wumu-dot/SoundDog/docs/hardware/RS485-回环接线图.jpg

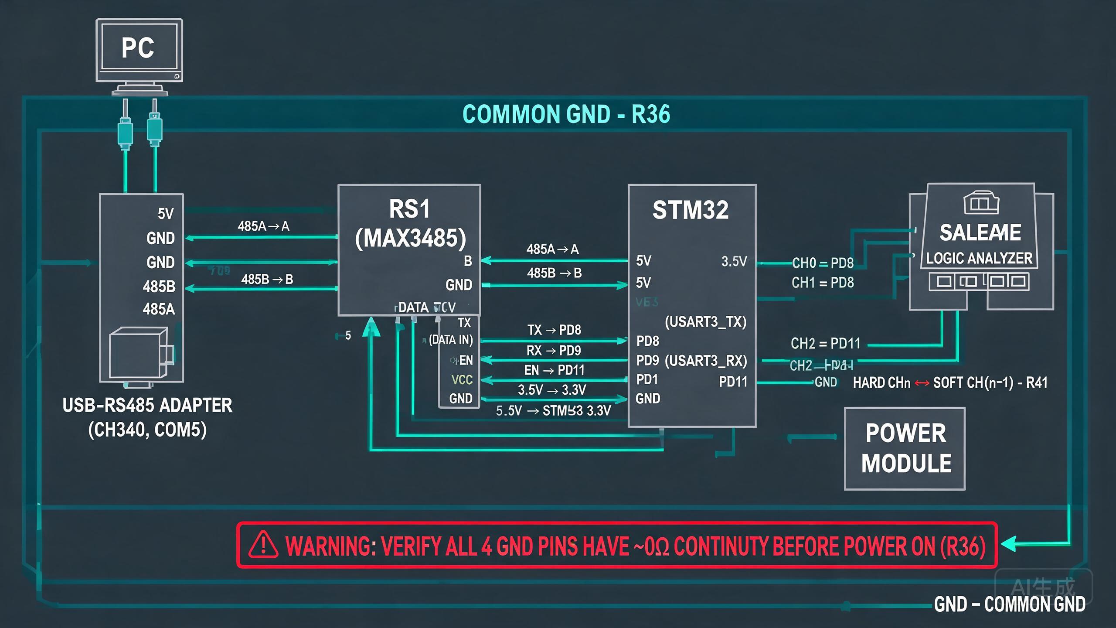
docs/hardware/RS485-回环接线图.jpg
