wumu-dot/SoundDog/SoundDog-RS485链路排查测试-2026-09-17.md

# SoundDog RS485 链路排查测试报告（2026-09-17）

> 主线任务：A5 RS485 物理链路排查（PC↔STM32 回环，Modbus RTU）
> 前置：批次1固件修复完成（R39），ESP32 主站损坏待更换，本次以 PC+USB转RS485 适配器作为主站

---

## 1. 测试目标

验证 PC（USB转RS485 适配器）→ RS1(MAX3485) → STM32(USART3/PD9) 收方向链路是否打通，定位"STM32 收不到字节"的物理断点。

## 2. 硬件接线基准（R40）

| 连接 | 说明 |
|---|---|
| 适配器 485A → RS1.A | 差分 A |
| 适配器 485B → RS1.B | 差分 B |
| 适配器 GND → RS1.GND → STM32.GND → 电源模块GND | 共地链（R36 通断验证） |
| RS1 VCC | 3.3V（STM32 板载，非5V） |
| RS1.TX → STM32 PD8(USART3_TX) | 数据入 |
| RS1.RX → STM32 PD9(USART3_RX) | 数据出（RO） |
| RS1.EN → STM32 PD11 | 高发低收 |

## 3. 测试过程与实测证据

### 3.1 软件回环测试（适配器发 0x55，STM32 应 echo 回）
- 115200 下多次发包（3/30/40/50/60 个 0x55），**适配器读回始终为空**。
- COM4(USART1 调试口) 抓取 1792 字节，**无任何 `RX[x]: 55` 探针输出**。
- 结论：**PD9 被 RO 拉死恒低，USART3 无空闲边界（IDLE 永不成立），RX 探针线程从未被唤醒**（复核更正①，2026-09-17：探针无输出与 RO 恒低是同一因果链，非"硬件层未收到字节"两层独立推断）。

### 3.2 逻辑分析仪抓取
| 抓取点 | 结果 | 判读 |
|---|---|---|
| 适配器 485A | **有波形** | 适配器在发射 ✅ |
| STM32 PD9(USART3_RX) | 无波形（触发等待、采样率降2MS/s后仍无） | 收方向断 ❌ |
| RS1.B | 仅毛刺/静态 | 可疑 ⚠️ |
| RS1.RO | 无波形 | 无输出 ❌ |

### 3.3 万用表静态/动态测量
| 测量项 | 结果 | 判读 |
|---|---|---|
| RS1 VCC | 3.3V | 供电正常 ✅ |
| 适配器裸端 A−B（110波特率，说明书方法） | **1.8~2.3V** | 适配器 TX 差分正常 ✅ |
| RS1.A−B（110波特率发包） | **0 → −6.35V → 0 大幅摆动** | 差分信号强达 RS1 ✅ |
| RS1.丝印TX（接PD8）对地 | 3.23V | STM32 PD8 空闲高，正常 ✅ |
| RS1.丝印RX（RO）对地 | **0.15V（恒低）** | RO 未输出有效高 ❌ |
| EN 端子对地 | 低 | 接收态正常 ✅ |
| PD11 对地 | 低 | STM32 方向控制正常 ✅ |
| RO↔PD9 通断 | 响（<2Ω） | 线通 ✅ |
| 芯片1脚(RO)对地 | **恒 0.15V（发包时也不动）** | 芯片 RO 输出级异常 ❌ |

## 4. 结论（基于 R25 验证条件）

**断点已收窄到 RS1 模块内部（端子→芯片→RO），尚未在 RO 输出级与模块走线之间二选一**（复核更正②，2026-09-17，R25：不得越级到"RO 输出侧"）。
- 差分测量：**−6.35V 更像未端接线路振铃/共模问题，不能作为差分健康证据**（复核更正③）；须同一参考地量 A对地/B对地/A−B 复测

**待确认的最后分叉**：芯片 6/7 脚(A/B) 差分是否到达芯片本体（未测完）：
- 若 6/7 脚有差分 → 芯片 RO 输出级坏（换芯片/查焊盘）
- 若 6/7 脚无差分 → 模块 A/B 走线断（端子有波但芯片收不到）

> ⚠️ 注意：换过一块 MAX3485 芯片仍复现，RO 输出级损坏或模块走线断的概率高；
> 也可能是新换芯片虚焊。建议整块更换 RS1 模块复测。

## 5. 已排除项清单

| 项 | 排除依据 |
|---|---|
| 适配器坏 | 裸端差分 1.8~2.3V 正常 |
| A/B 极性反 | 对调过仍无收 |
| A/B 线断 | 通断挡响（<2Ω） |
| EN/PD11 卡发送态 | EN 恒低=接收态 |
| RS1 供电 | 3.3V 正常 |
| RO→PD9 线断 | 通断挡响 |
| STM32 固件/探针层 | COM4 后台日志正常刷 BANDS/SPEC，探针在但无 RX 输入 |

## 6. 经验教训（新增）

- **万用表量差分必须用 110 波特率**（说明书方法）：115200 下位宽仅 ~8.7µs，万用表跟不上，读数恒 ≈0，会造成"适配器不发射"的误判。
- **"下降沿/上升沿无触发" ≠ "电平为低/高"**：触发等待只能证明"无跳变"，不能证明电平状态；必须用万用表量静态电压确认。
- **逻辑分析仪采样率过高会溢出**（设备跟不上），115200 抓取应设 2MS/s 并降采样率。
- **适配器 USB 会掉线/重枚举**：测试中途 COM 口会变或消失，发包前需先 `list_ports` 确认。

## 7. 下一步建议

1. **量芯片 6/7 脚(A/B) 差分**（110波特率发包）：区分"芯片没收到差分" vs "芯片RO坏"。
2. **整块更换 RS1(MAX3485) 模块**复测回环（最省事，排除模块走线/虚焊）。
3. 链路打通后：拆探针（`-DMB_PROBE_ENABLE=0`，R38）、换 ESP32 主站、A/B 全链路 Modbus 联调。

---
*测试人员：用户 + TRAE 协助 ｜ 日期：2026-09-17*
