wumu-dot/SoundDog/外部资源索引.md

# SoundDog 外部资源索引

> 外部依赖目录：`C:\Users\wumu2\OneDrive\桌面\stm32F407ZGT6\`
> 
> 本文件维护外部资料到 SoundDog 开发阶段的映射。当你需要查数据手册、参考例程、工具软件时，从这里定位。

---

## 资源全貌

```
桌面\stm32F407ZGT6\
├── INMP441全向麦克风资料\           ← 音频采集核心
├── ST7789_ref\                      ← LCD/OLED 显示参考（额外）
└── 芯片stm32F407\                    ← 主开发套件
    ├── 【1】参考例程\                ← 最重要！外设驱动参考
    │   ├── HAL库\  (10个项目)
    │   └── 标准库\ (12个项目)
    ├── 【2】工具软件\                ← 调试/辅助工具
    ├── 【3】STM32相关手册\           ← 芯片规格/参考
    ├── 【5】下载器驱动\              ← 烧录/调试驱动
    ├── 【6】烧录程序教程\            ← 烧录操作指南
    └── 1778826025286617\            ← 核心板资料（原理图+封装）
```

---

## 〇、硬件配置台账 + RS485 链路外部资源（2026-09-16）

> **[硬件配置台账（单一权威，改接线先看它）](docs/hardware/硬件配置-2026-09-16.md)** → `docs/hardware/硬件配置-2026-09-16.md`
> 含：供电共地(R40)、USART3↔RS1 接法、**MAX3485 丝印**、USB 转 RS485 适配器端子、逻辑分析仪通道映射(R41)。
>
> 🔴 **丝印语义权威已上收（2026-09-28）**：见外部依赖 `MAX3485-RS485模块资料/README.md`（厂商资料）。
> 　**结论：模块 `TXD`(=`RO`) → 主控 `UART_RX`；模块 `RXD`(=`DI`) → 主控 `UART_TX`（必须交叉）。**
> 　⚠️ 本台账 §3 原写的「`TX`=数据输入(≈DI) / `RX`=接收输出(≈RO)」是**旧拼写（无 D 后缀）+ 按主控视角命名**，**与厂商资料相反、已判错**（详见该 README §四，含 09-21 实测打假）。

| 资源 | 外部依赖地址（实测确认） | 用途 |
|---|---|---|
| **USB 转 RS485 适配器手册** ⭐ | `usb转rs485/LES26-USB-RS485-RS232-RS422-TLL V1.03.pdf` | 适配器端子/指示灯/自检（⚠️ 自检法禁用见 R36/R37） |
| CH341 驱动 | `usb转rs485/USB转换模块驱动-Window/CH341SER_Window/` | USB 转 RS485 设备驱动 |
| **逻辑分析仪软件（Saleae）** ⭐ | `逻辑分析仪/saleae逻辑分析仪软件客户资料20190718/Logic Setup 1.2.17.exe`（或 1.1.16） | 抓 RS485 TTL 侧波形（Software 版） |
| 逻辑分析仪使用说明 | `逻辑分析仪/…/usb Saleae 8逻辑分析仪使用说明书.pdf` | 通道映射即位，配合台账 §5 |
| 逻辑分析仪应用手册 | `逻辑分析仪/…/Saleae逻辑分析仪应用手册--着迷.pdf` | 高级抓取/解码参考 |
| **MAX3485 模块资料** ⭐ | `MAX3485-RS485模块资料/README.md`（原图 `商品详情页-2026-09-28.jpg`） | **丝印/接线语义的单一权威源**（`TXD`←UART_TX、`RXD`→UART_RX、`EN`=方向、板载 120 Ω、无偏置）。2026-09-28 补录 |

> 逻辑分析仪通道映射（R41）：硬CH1~CH8 + CLK + GND ↔ 软化 CH0~CH7，**硬CHn↔软CH(n-1)**，详见台账 §5。

---

## 一、STM32F407 芯片手册

| 文件 | 路径 | SoundDog 用途 |
|---|---|---|
| **参考手册-中文版** ⭐ | `【3】/stm32f407参考手册-中文版.pdf` | 所有外设寄存器/功能说明，最常用 |
| **参考手册-英文原版** | `【3】/stm32f407参考手册.pdf` | 与中文版对照，勘误排查时用 |
| **数据手册** | `【3】/stm32f407数据手册.pdf` | 电气特性、引脚定义、封装尺寸 |
| 勘误表 | `【3】/stm32f407勘误.pdf` | 芯片已知bug，遇到诡异问题再查 |
| IO复用说明 | `【3】/IO复用说明.jpg` | 引脚AF功能速查，一张图 |

### SoundDog 各章节查阅指引

| 开发阶段 | 参考手册重点章节 |
|---|---|
| I2S3 时钟配置 | §7 RCC — PLLI2S 寄存器 |
| I2S3 外设驱动 | §28 SPI/I2S — I2S 模式寄存器 |
| DMA 双缓冲 | §10 DMA — Stream 配置 |
| I2C1 (OLED+SHT30) | §27 I2C — 主机模式 |
| USART3 (RS485) | §30 USART — 异步收发 |
| TIM3 PWM (LED) | §14 TIM — OC 输出比较 |

---

## 二、HAL 库参考例程（最常用）

路径前缀：`芯片stm32F407/【1】参考例程/HAL库/`

| # | 项目 | 路径 | SoundDog 对应模块 |
|----|---|---|---|
| 0 | **CubeMX 配置参考** ⭐ | `0.CubeMX配置参考/` → `F407ZG.ioc` | 创建项目时可直接导入参考引脚/时钟 |
| 1 | LED闪烁 | `1.LED闪烁/` | A6: LED_ALARM + LED_STATUS |
| 2 | 按键测试 | `2.按键测试/` | GPIO 输入参考（如有按键需求） |
| 3 | **串口打印测试** ⭐ | `3.串口打印测试/` | USART1 调试串口 printf 重定向 |
| 4 | RTC读取时间 | `4.RTC-读取时间/` | 可选：时间戳打日志 |
| 5 | SDIO-SD卡基本读写 | `5.SDIO-SD卡基本数据读写/` | 可选：数据记录到SD卡 |
| 6 | SD卡移植FatFs | `6.SDIO-SD卡移植FatFs/` | 同上，文件系统版 |
| 7 | **USB虚拟串口** | `7.USB-虚拟串口/` | 可选：USB调试替代UART |
| 8 | LCD-0.96寸 | `彩色液晶屏驱动-基于0.96寸160x80分辨率/` | 显示参考（用ST7789驱动） |
| 9 | LCD-1.14寸 | `彩色液晶屏驱动-基于1.14寸240x135分辨率/` | 显示参考 |
| 10 | LCD-1.30寸 | `彩色液晶屏驱动-基于1.30寸240x240分辨率/` | 显示参考 |
| 11 | LCD-1.54寸 | `彩色液晶屏驱动-基于1.54寸240x240分辨率/` | 显示参考 |
| 12 | LCD-1.69寸 | `彩色液晶屏驱动-基于1.69寸240x280分辨率/` | 显示参考 |
| 13 | LCD-2.00寸 | `彩色液晶屏驱动-基于2.00寸240x320分辨率/` | 显示参考 |

> ⭐ = SoundDog 开发中直接参考

### 关于 OLED (SSD1306) 的说明

官方 HAL 例程中 **没有 SSD1306 I2C OLED 的例程**，只有 ST7789/ST7735 SPI LCD 的例程。但可以参考：
- **I2C 驱动层**：参考 `3.串口打印测试` 的 I2C HAL 初始化方式
- **OLED 驱动**：SSD1306 是开源驱动，网上资料充足
- **ST7789_ref** 目录提供了 uGUI 移植参考，如果后续想换彩屏可以看

---

## 三、标准库参考例程

路径前缀：`芯片stm32F407/【1】参考例程/标准库/`

> ⚠️ 我们项目用 HAL 库，标准库仅作逻辑/算法参考。标准库的 API 与 HAL 完全不同，不要直接复制。

| # | 项目 | SoundDog 参考价值 |
|----|---|---|
| 1 | LED闪烁 | 低 |
| 2 | 按键测试 | 低 |
| 3 | 串口打印测试 | 中（串口接收中断逻辑可参考） |
| 4 | RTC读取时间 | 低 |
| 5 | SD卡FatFS移植 | 中（保存日志参考） |
| 6 | SD卡数据读写测试 | 中 |
| 7-12 | 各种LCD驱动 | 低（我们用I2C OLED不是SPI LCD） |

---

## 四、核心板资料

路径：`芯片stm32F407/1778826025286617/`（数字ID是淘宝商品编号）

| 文件 | 用途 |
|---|---|
| **核心板原理图** ⭐ `STM32F407ZG-P1核心板原理图.pdf` | 查引脚引出、电源电路、BOOT配置 |
| 核心板机械尺寸 `LXBF407ZG-P1核心板机械尺寸.pdf` | 画外壳/底座时用 |
| 正面.jpg + 背面丝印.png | 查引脚位置，面包板接线参考 |
| 封装库.epro | 立创EDA封装，画PCB时导入 |

---

## 五、INMP441 麦克风资料

路径：`INMP441全向麦克风资料/`

| 文件 | 用途 | 状态 |
|---|---|---|
| **INMP441.pdf** ⭐ | 官方数据手册 | ✅ 已读取，关键参数已提取到 CubeMX 配置详解 |
| 测试说明.doc | 测试说明 | 未读 |
| **esp32-i2s-mems-master/** ⭐ | ESP32 开源驱动（3个示例） | ✅ 已读取，已验证参数已记录 |

### ESP32 示例对照（已全部读取分析）

| 示例 | 文件 | 关键发现 |
|---|---|---|
| InputSerialPlotter | `.ino` | 32-bit 模式 + 单采样打印 |
| NoiseLevel | `.ino` | 32-bit 模式 + 噪声电平均值 |
| VUMeterDemo | `.ino` | 32-bit 模式 + `>>14` 提取 |

---

## 六、工具软件

路径：`芯片stm32F407/【2】工具软件/`

| 工具 | 路径 | SoundDog 用途 |
|---|---|---|
| **SSCOM 串口助手** ⭐ | `SSCOM_v5.13.1/sscom5.13.1.exe` | 调试串口查看 printf/频谱数据 |
| PCtoLCD2018 | `PCtoLCD2018/PCtoLCD2018.exe` | OLED 取字模（后续显示用） |
| ATK-XISP | `ATK-XISP软件/ATK-XISP.exe` | 正点原子烧录工具（备选） |
| 取字模教程 | `取字模教程.docx` | 配合 PCtoLCD 使用 |

---

## 七、下载器驱动

路径：`芯片stm32F407/【5】下载器驱动/`

| 驱动 | 路径 | 用途 |
|---|---|---|
| **ST-LINK Utility** | `STLINK Utility/.../setup.exe` | 烧录固件、查看Flash/RAM |
| CH340 USB转串口 | `USB转串口CH340驱动/CH341SER.EXE` | 调试串口驱动（核心板串口芯片） |
| DAP 串口驱动 | `DAP串口驱动/` | DAP-Link 调试器驱动 |

---

## 八、烧录教程

路径：`芯片stm32F407/【6】烧录程序教程/`

| 文件 | 内容 |
|---|---|
| `F407ZGT6黑色沉金核心板程序下载.docx` | 核心板烧录方法图文教程 |
| `官方下载工具使用教程.txt` | ST-LINK Utility 使用说明 |

---

## 九、ST7789 显示参考（额外资源）

路径：`ST7789_ref/`

这个是社区 ST7789 LCD 驱动项目（使用 uGUI 图形库），与我们的 SSD1306 OLED 不同。但如果后续想换彩色 LCD，这是很好参考：
- DMA 加速填充（13x faster）
- 60FPS @ 32MHz SPI
- 支持多种分辨率

---

## 十、按 SoundDog 开发阶段的资源速查

### Phase A1: I2S 音频采集 ← 当前阶段

| 需要的资源 | 位置 |
|---|---|
| CubeMX 配置参考 IOC | `HAL库/0.CubeMX配置参考/F407ZG.ioc` |
| 核心板原理图（查I2S3引脚引出） | `1778826025286617/核心板原理图.pdf` |
| INMP441 数据手册 | `INMP441全向麦克风资料/INMP441.pdf` |
| INMP441 ESP32 驱动参考 | `INMP441全向麦克风资料/测试资料/esp32-i2s-mems-master/` |
| F4 参考手册 I2S 章节 | `【3】/stm32f407参考手册-中文版.pdf` §28 |
| F4 数据手册 I2S 电气特性 | `【3】/stm32f407数据手册.pdf` |
| 串口打印例程（printf重定向） | `HAL库/3.串口打印测试/` |
| SSCOM 串口助手 | `【2】工具软件/SSCOM_v5.13.1/` |

### Phase A2: FFT + 频谱

| 需要的资源 | 位置 |
|---|---|
| CMSIS-DSP 文档 | STM32CubeIDE 内置 / ARM 官网 |
| OLED 驱动（SSD1306） | 网上下载，无官方例程 |
| PCtoLCD 取字模 | `【2】工具软件/PCtoLCD2018/` |

### Phase A5: RS485 通信

| 需要的资源 | 位置 |
|---|---|
| USART 参考例程 | `HAL库/3.串口打印测试/` |
| F4 参考手册 USART 章节 | `【3】/stm32f407参考手册-中文版.pdf` §30 |

### Phase A6: 报警输出 (LED/蜂鸣器)

| 需要的资源 | 位置 |
|---|---|
| LED 闪烁例程 | `HAL库/1.LED闪烁/` |
| F4 参考手册 TIM 章节 | `【3】/stm32f407参考手册-中文版.pdf` §14 |

---

> 这份索引在你做 CubeMX 配置、写驱动、调试时随时可查。后续发现新的外部资料也可以补充进来。
