wumu-dot/SoundDog/SoundDog-目前进度-2026-09-16.md

# SoundDog 目前进度报告（2026-09-16）

> 交付给审查官的当前工程状态与结论快照。
> 报告依据本次会话（2026-09-15 ~ 09-16）实际排查与源码核对写成，关键结论均标注证据等级：🟢 实测 / 🟡 源码或规范 / 🔴 推断。

## 0. 一句话结论

**当前主线是 RS485（Modbus RTU 从站 ↔ 上位机）物理链路排查；固件代码侧已排干净，故障被锁定在物理层（接线/共地/适配器）。排查过程中发生了 ESP32 板被 5V 倒灌击穿的事故（教训已固化为 R36/R37）。**

---

## 1. 工程背景（给审查官定位）

- **项目**：SoundDog —— STM32F407 固件，语音采样（I2S3+INMP441）→MFCC 特征 → 距离比对 → 报警判决 → 参数经 **Modbus RTU over RS485** 向下/上位机开放。
- **RS485 从站**：FreeModbus（quanghona/Freemodbus-CMSIS-RTOS2-STM32 移植），从站地址 0x01，USART3，115200-8N1；MAX3485 模块（RS1）。
- **RS485 主站候选**：PC 的 USB-RS485 适配器（COM5）/ ESP32 网关（`esp32-modbus-gateway`，COM3）。
- 引脚权威定义见 `firmware/soundDog/Inc/pin_config.h`：USART3_TX=PD8、USART3_RX=PD9、RS485_DE=PD11。

---

## 2. 代码侧：已排干净，无功能性错误

### 2.1 主站/从站协议对齐（🟡 源码级核对）

| 项 | 主站（ESP32 网关） | 从站（SoundDog） | 结论 |
|---|---|---|---|
| 模式/波特率/校验 | RTU 115200 8N1 | RTU 115200 8N1 | ✓ 一致 |
| 从站地址 | 0x01 | `eMBInit(MB_RTU, 0x01, 3, 115200, MB_PAR_NONE)` | ✓ |
| 保持寄存器地址 | 0 基址（`mb_reg_start=0x0000` 原样下发） | FreeModbus 内部 `usRegAddress++`，回调用 `usAddress-1` 抵消 | ✓ 对齐（R34） |
| CRC 字节序 | CRC Low 在前 | FreeModbus 标准 | ✓ |

主站实际报错为 **`0x107 ESP_ERR_TIMEOUT`**（从站没回应答），而非 `0x106`（地址/数据越界）——按 Espressif 官方排障表，0x107 指向「从站无响应/物理连接」，**非码控问题**。

### 2.2 回环抓包：原始字节都过不去（🟢 实测，独立于协议）

在固件插入**软件回环探针**（R35 判定法）后实测：

```
[adapter] 发送=55 读回=(空)    回环=FAIL
[COM4 调试口] RX[2]: 00 00
```

即：适配器发单字节 `0x55`，STM32 根本收不到（只收到总线空闲 `00 00`），适配器也读不回自身字节。**原始字节都无法送达**，任何主/从站代码逻辑都解释不了，直接证明问题在 RS485 物理链路。

### 2.3 排除项（本轮系统排净）

- 任务优先级饥饿（mbSlave/specTask/displayTask 均 osPriorityNormal + RR 时间片）：不成立
- FreeModbus `eMBPoll` 阻塞事件标志：不成立
- 寄存器地址 0 基址错位：不成立（见 2.1）

---

## 3. 物理层排查过程（当前卡点）

第 2 节已证明「字节到不了 STM32」，剩余全部是物理变量。排查节奏：

1. **A/B 电压测量**：A≈B≈1.67V（🟢 实测）。起初被误读为「A≈B=无差分=短路」。
2. **适配器数据手册（USB转RS485，阻抗适配器自身 1.5~2V 偏置）确认**：1.67V 其实是该适配器**正常中间电平**，我上一轮「坐实短路」的判断据此（按手册 §5.1.1）**收回**。
3. **适配器自检法**（手册 §5.1.2：A接GND、B碰5V看接收灯）：RXD 灯亮 → 适配器接收侧活着。
4. **⚠️ 事故**：在「未确认全链路共地」的前提下执行 B 碰 5V 自检，5V 经总线倒灌 → **ESP32 板 3.3V 轨对 GND 仅 7.8Ω（已短路击穿）**，测得焦味/闪响。(🟢 实测确诊)

### 3.1 事故根因（已固化 R36/R37）

- 多板各自供电、只共了「一条 GND 的虚点」，在共地不良下引入 5V → 倒灌击穿 3.3V 逻辑芯片。
- **教训 1（R36）**：任何 RS485 测试前，适配器 GND↔STM32 GND↔ESP32 GND 必须通断档验证全部导通；RS1/MAX3485 VCC 只用 3.3V。
- **教训 2（R37）**：适配器「B 碰 5V」自检法**禁止在多板系统使用**，只适用于适配器孤立供电场景。

### 3.2 当前待办（主线，未完成）

**换新 ESP32 板 → 验全链路共地 → 重跑回环 → 确诊物理链路 → 拆探针。**

已明确方向：适配器与 RS1 之间 A/B 链路上「差分建立/极性/共地」是最大嫌疑；若换已知好适配器仍全空，则坐实适配器驱动或总线状态问题。

---

## 4. 审计 P0 三条：最终定性（🟡 源码核对 + 🟢 验证）

本轮审计报告见 `桌面\报告\审计报告\SoundDog-代码审计报告-2026-09-16.md`（31.7KB，含 §4.2 补齐 P0 条目 + §6 处置排期）。与用户判断一致，**本轮不动固件 P0**：

| 项 | 定性 | 处置 |
|---|---|---|
| **P0-1** 三处探针（RX回环 echo / `RX[%d]` printf / TX翻状态灯） | 调试残留，受 `MB_PROBE_ENABLE` 编译开关控制（默认 1，`-DMB_PROBE_ENABLE=0` 整体移除无需改源码） | **暂留**（链路确诊前是唯一端到端判定手段），确诊后按 R36 一次清干净 |
| **P0-2** `huart3`+`PD11` 双任务无锁并发 | **修正误判**：`RS485_Send` 全工程仅 2 处调用，main.c:253 在 `#if 0` 死代码内，唯一活调用点就是 P0-1 探针（portserial.c:237）。关掉 `MB_PROBE_ENABLE` 即回归单写者 | **无需修任何并发代码** |
| **P0-3** 全局 `lock` 不支持嵌套（portcritical.c:19，嵌套 → vTaskSuspendAll 多调一次 → 调度器永久挂起） | 潜伏，当前 5 处调用点无嵌套未触发 | **不手工改，但设红线**：在 portcritical.c 外新增任何 Modbus 临界区调用前必须先修 |

## 5. 审查缺陷修复：批次1 完成（🟢 构建验证）

审查官 §8 复核确认核验质量后，开发方已按其定稿方案**实施批次1（#1~#13）并构建验证通过**，详见 `桌面\报告\目前进度\SoundDog-审查核验与修复计划-2026-09-16.md` ⚡批次1 执行状态。

**批次1 落地清单（全部已验证）：**

| 项 | 文件 | 修复 |
|---|---|---|
| P1-1 丢帧恢复 | [freertos.c](firmware/soundDog/App/freertos.c) | 失配第二帧挂起为下窗首帧，丢帧 2→1 |
| P1-2 栈/堆钩子 | `rtos_hooks.c`（新建）+ `FreeRTOSConfig.h` | `configCHECK_FOR_STACK_OVERFLOW 2`、`configUSE_MALLOC_FAILED_HOOK 1`；钩子用轮询 SR/DR 规避 PendSV 下 tick 冻结 |
| P1-3 NVIC 分组 | `main.c` | `HAL_Init()` 后 `SetPriorityGrouping(Group_4)` |
| P2-1 USART1 单写者 | `main.c` `_write` | 整段临界区互斥（printf 唯一收口） |
| P2-2 ISR yield | `main.c` | `xQueueSendFromISR` 传 `&hpw` + `portYIELD_FROM_ISR` |
| P2-4/9/收栈 | `Makefile` | 删 `__FPU_PRESENT` 重复定义、加 `-DHSE_VALUE=8000000U`、`App/rtos_hooks.c` 入库 |
| P2-7 PVD | `stm32f4xx_hal_msp.c` | 注释 `EnableIRQ(PVD_IRQn)`、优先级→15（杜绝最高抢占 0） |
| P2-10 portevent 多flag | `portevent.c` | 按 bit 权重分发 + `osFlagsNoClear`，未处理位保留不丢 |
| P2-13 rx_buff 边界 | `portserial.c` | `put_index < sizeof` 超长帧不越界写 `.bss`（关探针仍成立） |
| 收帧栈+取证打印 | `portserial.c` + `freertos.c` | 收帧任务栈 512→1024B；开机打印 heap + 四任务栈水位 |
| P2-5 文档 | `README.md` + `CLAUDE.md` | 任务清单 4、目录结构（`App/` `BSP/` `Middlewares/FreeModbus/`）、`Src/i2s_drv.c`→`BSP/`、boot 输出示例 |

**P2-6 工作区清理（同步完成）**：`compile_commands.json` 入 `.gitignore`（已验证忽略 exit=0）、`build.bat` 去 `pause`；`build_and_flash.bat` 保留 pause（交互烧录有意设计）。

**构建验证证据（R21）**：全量 `mingw32-make -B -j8 all` **0 error / 0 warning**（30 条 `__FPU_PRESENT redefined` 警告清除）；`size`：`text 177668 / data 256 / bss 97968`。

## 5bis. 批次2 & 捆绑项（未做，需真机 / 待链路确诊）

- **批次2**：P2-11 OLED 熔断降级、T3.5 定时器延迟实测 → 需真机板。
- **捆绑项**：`MB_PROBE_ENABLE` 探针拆除（RX回环/printf/翻灯，含 P2-8 LED_STATUS 语义恢复）+ 随 R36 一次清理 → 待 RS485 链路确诊（回环自测通过 + 主站读到 CRC 正确应答）。

## 6. 已知盲区 / 剩余

- **`scripts/*.py`（14 个 / 1298 行 PC 侧脚本）至今未逐行审查**。
- **硬件主线未变**：换新 ESP32 板 → 验全链路共地（R36）→ 重跑回环 → 确诊物理链路。批次1 代码处置与该硬件线无耦合，可并行；批次1 真机验收（boot/Modbus 应答/100 帧/s/heap+栈水位读数）同样待板上线。
- 批次1 变更尚未 git 提交（8 改 + 5 未跟踪），提交与 CI 配置待用户决策。
