wumu-dot/SoundDog/docs/SoundDog-复核处置章程-2026-09-17.md

# SoundDog 复核处置章程（2026-09-17）

| 项目 | 内容 |
|---|---|
| 依据 | `SoundDog-复核报告-2026-09-17.md`（审查官，单一事实源） |
| 章程起草 | 执行方（用户 + TRAE） |
| 起草日期 | 2026-09-17 |
| 生效前提 | **本章程须经用户逐条确认后方可执行**；本章程不修改任何源码、不改动审计/复核报告文件 |

> 章程性质：把复核报告的发现转译为**可执行、带验证判据（R25）、带决策门**的处置计划。
> 纪律：任何条目开工前必须查三源（R27）；任何条目收工必须附证据（R21）。

---

## 0. 复核结论速览（审查官）

- ✅ 批次1 全部属实（`git diff` 实证：11 files / +212 / −49，size 逐字节一致）
- 🔴 **新缺陷 1 处**：P2-1 修法（`taskENTER_CRITICAL` 包阻塞式 `HAL_UART_Transmit`）引入长时中断屏蔽
- 🔴 **测试报告需更正 2 处措辞 + 2 处技术判断**（探针无输出与 RO 恒低是同一因果链；−6.35V 是振铃非健康差分）
- 🟠 结论措辞越级 1 处、证据缺口 3 条、跨文档冲突 1 条、规则号悬空 1 条
- ⚠️ 审查官撤销自身 P1-3 误报（NVIC 分组一直由 `HAL_Init()` 显式配置）

---

## 1. 处置优先级总览

| 优先级 | 条目 | 门类 | 依赖 |
|---|---|---|---|
| P0 | 章程第 2 节：P2-1 修法重做（`osMutex` / 单点发送） | 固件代码 | 无（但须用户批准改代码） |
| P0 | 章程第 3 节：RS485 链路补测（芯片 8/5/2/3/1 脚 + 6/7 脚差分 + PD9 对地） | 硬件实测 | 芯片引脚定位 |
| P1 | 章程第 4 节：测试报告两处更正（5.1.1 因果链、5.1.2 断点措辞） | 文档 | 补测结果 |
| P1 | 章程第 5 节：补 3 条证据缺口（R36 共地实测 / COM 口 / 逻辑分析仪通道） | 文档+实测 | 下一次测试时随做 |
| P2 | 章程第 6 节：裁决 1.67V 冲突并同步两份文档 | 文档 | 第 3 节的三个量 |
| P2 | 章程第 7 节：登记探针台账（freertos.c 新增 GPIOB PIN_0 临时诊断 3 处） | 文档 | 无 |
| P2 | 章程第 8 节：补 R33~R41 规则登记表（`.claude/rules.md`） | 文档 | 无 |
| P3 | 章程第 9 节：main.c:184 幂等冗余行注释改写（P1-3 更正连带） | 代码注释 | 第 2 节一并做 |

---

## 2. 【P0】P2-1 修法重做（审查报告第三节，🔴）

### 2.1 现状
`App/main.c:104-117`：`_write` 内 `taskENTER_CRITICAL()` 包住 `HAL_UART_Transmit(&huart1,...,100)`。

### 2.2 问题（量化已由审查官给出）
- 屏蔽范围：优先级数值 ≥5 的全部中断（SysTick=15、PendSV=15、USART3=5、SPI3=5、I2S DMA1_Stream2=5）
- 量级：RX 探针单行 ~778B → **67ms 屏蔽**；BANDS 单行 ~224B → **19ms 屏蔽**
- 后果 ①：tick 冻结（SysTick 被屏蔽）
- 后果 ②：I2S DMA 半缓冲 16ms < BANDS 单行 19ms → 音频溢出丢帧风险（🔴推断，需实测）
- 后果 ③：`_write` 死循环（临界区内 `HAL_GetTick` 冻结 → 100ms 超时永不成立 → 永久自旋）

### 2.3 处置方案（审查官建议，执行方选型）
**首选**：`taskENTER_CRITICAL` → `osMutex`（互斥信号量，只做任务级串行化、不屏蔽中断）
**次选**：USART1 输出队列化到 specTask 单点发送（贴合 BUG-20260829-003「单写者」本意）

### 2.4 验证判据（R25）
- [ ] 构建 0 error / 0 warning；size 与声明一致
- [ ] COM4 日志：MBSlavePollTask 启动期 printf 与 specTask 统计输出**无交错、无乱序**
- [ ] 音频链路实测（如可测）：A3-02 100 帧/s 规整网格无丢帧
- [ ] 无新探针/无新诊断残留（探针台账核对）

### 2.5 决策门
- 方案选型（osMutex vs 单点发送）**由用户裁决**
- 是否随本次一并处理第 9 节注释改写，由用户裁决

---

## 3. 【P0】RS485 链路补测（审查报告 §5.1.4 + §5.1.1 预测）

### 3.1 目的
在「换模块 / 换芯片」决策前，把断点从「RS1 模块内部」进一步收窄，并验证审查官的**可证伪预测**。

### 3.2 补测清单（一次量完，110 波特率发包）
| 序 | 测量 | 判据 | 指向 |
|---|---|---|---|
| 1 | 芯片 8 脚 VCC 对地 | ≈3.3V | 模块供电走线/焊盘断 |
| 2 | 芯片 5 脚 GND 对地 | ≈0V | 模块地走线断 |
| 3 | 芯片 2/3 脚 RE/DE 对地 | 低=接收态 | 使能走线断/EN 未到芯片 |
| 4 | 芯片 1 脚 RO 对地电阻 | 无短路 | RO 被短到地（0.15V 恒低来源） |
| 5 | 芯片 6/7 脚 A/B 差分（发包） | 摆动 | 芯片收到 vs 模块 A/B 走线断 |
| 6 | **PD9 对地电压** | 恒低≈0.1~0.2V | 验证 RXNE 持续触发/put_index 饱和预测 |

### 3.3 审查官预测（§5.1.1）——测完对照
- 预测①：PD9 恒低 → RXNE 持续触发 → `put_index` 约 22ms 饱和到 256
- 预测②：⚠️ **换好模块后必须先复位 STM32 再测**，否则首次 IDLE 会打印 `RX[256]:` + 256 个 `00` 并回灌总线 → 污染结果

### 3.4 决策门
- 补测结果出来后，**换芯片 vs 整块换模块**由用户拍板
- 换件后必须执行「先复位再测」协议

---

## 4. 【P1】测试报告两处更正（审查报告 §5.1.1 / §5.1.2）

### 4.1 更正①（5.1.1）：探针无输出与 RO 恒低是同一因果链
- 原文「STM32 的 USART3 硬件层面未收到字节」→ 改为「**PD9 被 RO 拉死恒低，USART3 无空闲边界（IDLE 永不成立），探针线程从未被唤醒**」
- 依据：IDLE 成立条件 = 收到字节且线路回空闲高；RO 恒低 → 永无 IDLE

### 4.2 更正②（5.1.2）：断点措辞降级
- 原文「断点定位：MAX3485 芯片 RO 输出侧」→ 改为「**断点已收窄到 RS1 模块内部（端子→芯片→RO），尚未在 RO 输出级与模块走线之间二选一**」（R25）

### 4.3 更正③（5.1.3）：−6.35V 不作健康差分证据
- 原文「差分信号强达 RS1 ✅」→ 改为「**−6.35V 更像未端接线路振铃/共模问题，不能作为差分健康证据**；须同一参考地量 A对地/B对地/A−B 复测」

### 4.4 验证判据
- [ ] 更正后报告不再自相矛盾、不越级（对照 R25）
- [ ] 两份受影响文档（测试报告）同步修正

---

## 5. 【P1】补 3 条证据缺口（审查报告 §5.2）

| # | 缺口 | 补法 | 时机 |
|---|---|---|---|
| 1 | R36 共地实测缺失 | 四端 GND 两两通断读数，逐段给 ≈0Ω | 下次测试前必做 |
| 2 | 适配器 COM 口未记录 | 每次测试记录实际 COM 号 | 下次测试随记 |
| 3 | 逻辑分析仪硬/软通道未记录 | 按 R41 固定错位映射（硬CHn↔软CH(n-1)），抓取时记软通道 | 下次抓取随记 |

---

## 6. 【P2】裁决 1.67V 跨文档冲突（审查报告第六节）

- 冲突：`硬件配置-2026-09-16.md:70`（漂浮电平=共地缺失）vs `目前进度-2026-09-16.md:57-58`（适配器正常中间电平）
- 裁决方法：**先验共地 → 同一参考地下量 A对地 / B对地 / A−B**（与第 3 节补测共用）
- 裁决后：两份文档同步更正，消除"同一读数两种判据"

---

## 7. 【P2】登记探针台账（审查报告第九节末行）

- 发现：`freertos.c` 新增临时诊断 `HAL_GPIO_WritePin(GPIOB, PIN_0)` 作 ALARM 亮灭判 init 成败（3 处），未登记
- 动作：登记入审计报告 §5 探针台账；链路确诊后与 `MB_PROBE_ENABLE` 一并拆除（R38）

---

## 8. 【P2】补 R33~R41 规则登记表（审查报告第七节）

- 现状：`.claude/rules.md` 最大编号 R32；R33~R40 散落多文档；**R38/R39 全仓无定义**
- 动作：在 `.claude/rules.md` 补 R33~R41 单一登记表（含规则号/标题/定义位置索引）
- 验证判据：`grep R38 rules.md` 有命中；R33~R41 均可在单一登记表找到

---

## 9. 【P3】main.c:184 幂等冗余注释改写（审查报告第四节连带）

- 事实：`HAL_Init()` 内部已设 `NVIC_PRIORITYGROUP_4`（`stm32f4xx_hal.c:173`），main.c:184 是幂等重申，无害可留
- 动作：注释从「此前全工程无一处邀请」改为「**显式重申，与 `HAL_Init()` 一致，防后续改动漂移**」
- 时机：随第 2 节 P2-1 修法一并提交

---

## 10. 执行纪律

1. **任何代码改动落盘前**：先按 R27 查三源（本项目内部行为 / Issue 区 / 坑清单）
2. **任何"完成"声称**：附构建日志 + size 证据（R21）
3. **任何验证结论**：写明验证条件与判据（R25），不越级下结论
4. **探针/临时诊断**：一律进台账，确诊后随 `MB_PROBE_ENABLE` 一起拆（R38）
5. **grep 纪律**（审查官教训）：核查"某符号全仓是否存在"时**禁止 `head`/`tail` 截断**，先 `grep -c` 再全量看
6. **换件协议**：RS1 模块更换后**先复位 STM32 再测**（§5.1.1 预测②）
7. **不在任务上下文用临界区包阻塞式发送**（P2-1 教训，纳入规则待议）

---

## 11. 待用户确认的决策门（汇总）

| # | 决策 | 选项 |
|---|---|---|
| 1 | P2-1 修法方案 | ① osMutex（首选）② 单点发送队列化 |
| 2 | 是否现在批准动代码（第 2、9 节） | 是 / 否（先做硬件补测） |
| 3 | RS1 换件策略（补测后） | 换芯片 / 整块换模块 |
| 4 | 1.67V 裁决是否并入本轮 | 是 / 否 |
| 5 | 本章程是否作为本轮执行基线 | 确认 / 修改 |

---
*本章程由复核报告转译，条目可追溯至 `SoundDog-复核报告-2026-09-17.md` 对应小节。*
*执行方 ｜ 2026-09-17*
