wumu-dot/SoundDog/docs/features/FEAT-A7-01-SHT30温湿度采集.md

# FEAT-A7-01-SHT30温湿度采集

> **AI 执行规则**：必须按阶段顺序执行，每个阶段开头声明角色。严禁跳跃、越界、自审自判。
> 阶段间停等：每完成一个阶段，停下来，输出结果，等人说"继续"。
> 阶段5通过后：回填父FEAT项目表该行 + 更新 `docs/features/INDEX.md` + `docs/features/维护地图.md`。
> 历史记录只更新状态字段，严禁删除/篡改已完成记录。
> 事实来源：`.sop-agent规格.md` §3（禁止自造数值，没有的一律写"待定（需人确认）"）。

## 0. 元数据
- **父FEAT**：FEAT-A7-辅助功能
- **优先级**：P3
- **预估总耗时**：2h
- **当前状态**：🟡代码已落地，待实测归档（`BSP/sht30.c` + `freertos.c` 的 `sht30_task` 已启用；启用后暴露堆缺口，见 BUG-20261029-001 已扩堆修复）

## 1. 总体目标与硬边界

### 1.1 核心目标（一句话）
> 让 SHT30 温湿度传感器经 **I2C1** 上报温度/湿度，串口数值合理、行为可复现（哈气湿度升、手捂温度升），为系统提供环境数据。

### 1.2 地基触碰前置自检
- [x] 否 → 继续（经 HAL I2C 标准接口调用，不触碰 `firmware/Drivers/` 底层库文件）

### 1.3 任务边界
| 类型 | 具体内容 |
|---|---|
| 范围内（可改） | 新增 App 层 `sht30_drv.c/.h`、`soundDog.ioc` 使能 I2C1、串口打印温湿度 |
| 超出范围（禁止碰） | `firmware/Drivers/` HAL 底层库文件、OLED 驱动实现 |
| 外部依赖 | SHT30 模块、杜邦线、万用表、SSCOM、非快充 5V 电源 |

### 1.4 关键参数（事实包 §3，禁止自造）
- 总线：**I2C1**（PB6=SCL / PB7=SDA，事实包 §3.2）。
- ⚠️ 共总线：OLED 同挂 I2C1（地址 0x3C/0x3D，事实包 §3.2）——SHT30 地址必须与 OLED 不同。**SHT30 I2C 地址：0x44**（`SHT30_I2C_ADDR`，pin_config.h 第 70 行已定义；注释明确 OLED(0x3C) 与 SHT30(0x44) 可共用 I2C1，不冲突）。
- SHT30 测量命令字：**待定（需人确认，查 SHT30 数据手册）**。
- I2C1 速率 / 上拉电阻：**待定（需人确认：板载是否已有上拉；速率以 CubeMX 默认配置为准）**。
- SHT30 供电：**待定（需人确认：VDD 接 3.3V 还是 5V，以模块手册为准）**。
- 数值合理判定：温度与当前室温接近、湿度在室内正常范围（**具体上下限待定需人确认**）；用"哈气→湿度升、手捂→温度升"做行为验证，数值有记录空位。
- 串口格式（沿用事实包 §3.4）：先出现 boot 三行，再出现温湿度打印行（**打印行格式待定需人确认**）。

## 2. 执行路线图（5 阶段）

### 🟢 阶段 1：准备（角色：Dev Agent）
- **读什么**：`firmware/soundDog/Inc/pin_config.h`（引脚权威）+ `HANDOFF.md` §4.2 + `firmware/soundDog/soundDog.ioc`（I2C1 是否已使能、OLED 是否已占用）。
- [ ] 步骤1：确认 I2C1 现状：是否已使能、OLED 是否已占用总线、板载上拉情况
- [ ] 步骤2：确认 SHT30 模块手册（地址 0x44 已定；**命令/供电**待定需人确认），输出影响范围
- **判定标准**：影响范围写清"I2C1 共总线 + SHT30 地址/命令待确认"两项风险
- **⏸️ 停等：人确认后进入阶段 2**

### 🔵 阶段 2：设计（角色：Dev Agent）
- **阶段目标**：产出傻瓜式操作单（§3）+ 模块划分（`sht30_drv`）
- [ ] 步骤1：参数表定稿（地址 **0x44** 已定；命令/速率/供电标"待定需人确认"）
- [ ] 步骤2：设计 `sht30_drv` 接口与串口打印格式（格式待定需人确认）
- [ ] 步骤3：编写 §3 操作单（物品清单/接线/测量/串口/行为验证/故障表）
- **判定标准**：§3 每步含期望值与记录空位，接线表含共总线红线警告
- **⏸️ 停等：人确认操作单后进入阶段 3**

### 🟠 阶段 3：实现（角色：Dev Agent）
- **阶段目标**：写代码，每改完一个文件对照 AC 自检
- [ ] 步骤1：`soundDog.ioc` 使能 I2C1（参数以阶段2定稿为准）
- [ ] 步骤2：新建 `sht30_drv.c/.h`（初始化 + 读取 + 转换，转换公式待定需人确认）
- [ ] 步骤3：串口打印温湿度（格式按阶段2），`firmware\build.bat` 编译无错误、无新增警告
- **判定标准**：编译通过（build.bat 无错误退出、无新增警告）
- **⏸️ 停等：人确认后进入阶段 4**

===== 切换至 Test Agent =====

### 🟣 阶段 4：测试（角色：Test Agent）
- **阶段目标**：独立测试——只看 §3 操作单与 §4 验收标准，不看 Dev 实现细节
- [ ] 步骤1：按 §3.3 串口观察温湿度打印，数值合理（AC-01）
- [ ] 步骤2：按 §3.4 行为验证（哈气/手捂），记录前后数值（AC-01）
- [ ] 步骤3：确认 OLED 未被破坏（共总线兼容，AC-02）；运行 `./scripts/ci_local.sh`
- [ ] 若失败 → 查 §3.5 故障表，退回阶段 3
- **判定标准**：AC-01/02 证据齐全（记录实测数值与变化）
- **⏸️ 停等：人确认后进入阶段 5**

===== 切换至 Review Agent =====

### 🔴 阶段 5：审查（角色：Review Agent）
- **阶段目标**：独立审查——安全红线、代码质量、规范合规、AC 逐条打勾
- 全部通过 → ✅ 回填「维护与调试」+ 父FEAT项目表 + INDEX + 维护地图
- 未通过 → 退回对应阶段并附意见
- **判定标准**：§4 十二条 AC 全部通过或 N/A 有说明

## 3. 傻瓜式操作单（照做即可）

### 3.0 物品清单（动手前先打勾，缺一不可）
- [ ] 核心板（已通电正常，boot 三行可见）
- [ ] SHT30 模块 ×1
- [ ] 杜邦线（母对母）×4
- [ ] 万用表（直流电压档）
- [ ] 5V 电源：电脑 USB 口 **或** 非快充 5V 适配器（⚠️ **严禁手机快充头**，沿用 A1-01 §3.2 供电红线）
- [ ] USB-TTL（CH340）+ SSCOM 串口助手（115200）

### 3.1 接线（全程断电！先拔掉所有电源线再动线）
> ⚠️ 红线：SHT30 与 OLED 共用 I2C1 总线，**地址不得冲突**（SHT30=**0x44** 已由 pin_config.h 定义，与 OLED 0x3C 不冲突）；接线前确认模块额定电压。

| 顺序 | 从（SHT30） | 到（核心板） | 核对要点 | 完成 |
|---|---|---|---|---|
| 1 | VDD | **待定**（需人确认：常见 3.3V，以模块手册为准） | ⚠️ 先查额定电压再接，别超压 | ☐ |
| 2 | GND | GND | — | ☐ |
| 3 | SCL | PB6 | ⚠️ 共总线：SHT30 地址 **0x44** 与 OLED(0x3C) 不冲突（pin_config.h 已定义） | ☐ |
| 4 | SDA | PB7 | 同上 | ☐ |

### 3.2 上电前测量（红线：**先量再插电**）
1. 万用表拨到**直流电压 20V 档**，红笔接被测脚、黑笔接 GND。
2. 量核心板 **5V** 引脚 → 期望 **4.8 ~ 5.2V**（记录数值：______）
3. 量核心板 **3.3V** 引脚 → 期望 **3.2 ~ 3.4V**（记录数值：______）
4. ⚠️ 任一不在范围 → **断电，换电源，禁止继续**（沿用 A1-01 §3.2）。

### 3.3 上电 + 串口观察（阶段 4 执行）
1. USB-TTL 接核心板：TX↔RX **交叉**、GND 共地。
2. SSCOM 打开**设备管理器里看到的 COM 口**（不一定是 COM4），波特率 **115200**。
3. 按复位键，期望依次出现三行：`SoundDog boot OK` → `I2S_DRV_Init ret=0` → `I2S DMA started`。
4. 随后期望出现温湿度打印行（**格式待定需人确认**，如 `SHT30: temp=xx.x C humi=xx.x %RH`）。
   - 记录温度：___ °C　记录湿度：___ %RH
5. 数值应稳定（抖动容差待定需人确认）；恒定不变 → 查 §3.5。

### 3.4 行为验证（阶段 4 执行）
1. 对传感器**哈气 3 秒** → 湿度应明显上升（记录：___ %RH → ___ %RH）。
2. **手捂模块 10 秒** → 温度应明显上升（记录：___ °C → ___ °C）。
3. 两项变化成立 + §3.3 数值合理 = 采集链路通过；不成立 → 查 §3.5。

### 3.5 故障速查表
| 现象 | 可能原因 | 处理 |
|---|---|---|
| 串口无温湿度行 | 接线错 / 命令错 | 查 §3.1 接线；确认 SHT30 地址 0x44（pin_config.h 已定）与测量命令（待定需人确认） |
| 打印恒 0 或乱码 | I2C 速率 / 上拉缺失 / 共总线冲突 | 确认地址与 OLED 不同；查板载上拉（待定）；速率按 CubeMX 默认（待定） |
| 温度恒定不变 | 未真正读取 / 传感器损坏 | 手捂验证；仍不变 → 换模块 |
| 湿度恒 100% 或 0 | 转换公式错误 / 接线虚 | 核对转换公式（待定需人确认）；重插线 |
| 接上 SHT30 后 OLED 显示异常 | 地址冲突 / SCL/SDA 接反 / 总线被拉死 | 断电检查 SCL↔PB6、SDA↔PB7；确认两器件地址不同 |

## 4. 验收标准（12 条）

### 功能验收
- [ ] AC-01 串口打印 SHT30 温湿度且数值合理：记录实测温度/湿度，哈气湿度上升、手捂温度上升（变化前后数值已记录）
- [ ] AC-02 向后兼容：I2C1 共总线，接入 SHT30 后 OLED 显示不异常（如有 OLED）

### 代码质量
- [ ] AC-03 编译通过（`firmware\build.bat` 无错误退出）
- [ ] AC-04 无新增编译警告
- [ ] AC-05 文档已更新（本 FEAT + 父 FEAT-A7 项目表回填）

### 安全红线
- [ ] AC-06 无硬编码密钥 → **N/A**（嵌入式固件无密钥场景，说明）
- [ ] AC-07 错误处理完善：I2C 读失败不静默（重试或打印错误码，方案待定需人确认）
- [ ] AC-08 用户输入校验 → **N/A**（无用户输入，说明）

### 测试与边界
- [ ] AC-09 新增测试自动运行 → **N/A**（人工串口验证，无自动化测试基建，说明）
- [ ] AC-10 全部回归测试通过：boot 三行 + 既有音频采集功能不回归
- [ ] AC-11 测试覆盖率 ≥ 80% → **N/A**（无单元测试基建，说明）
- [ ] AC-12 按 FEAT 模板执行（结构符合 `.sop-agent规格.md` §2）

## 5. 维护与调试（阶段5通过后回填）

### 5.1 影响文件
| 文件 | 改动类型 | 说明 |
|---|---|---|
| `firmware/soundDog/Src/sht30_drv.c` | 新增 | SHT30 初始化/读取/转换 |
| `firmware/soundDog/Inc/sht30_drv.h` | 新增 | 对外接口 |
| `firmware/soundDog/soundDog.ioc` | 修改 | 使能 I2C1（阶段3确认） |
| 串口打印所在文件 | 修改 | 温湿度打印（阶段1 定位后回填） |

> **实施结果（2026-11-01 回填）**：实际落地为 `BSP/sht30.c` + `BSP/sht30.h`（自建 **I2C3 PA8/PC9**，未复用 I2C1、未改 `.ioc`），由 `freertos.c` 的 `sht30_task` 2 s 刷新 `g_temp_x10`/`g_humi_x10`，并经 Modbus 寄存器 5/6 供主站读取。上表 `Src/sht30_drv.c` / `Inc/sht30_drv.h` 为阶段1 计划命名，未采用。启用该任务后暴露堆缺口 → BUG-20261029-001（已扩堆修复）。

### 5.2 调试要点
- 逻辑分析仪（24M/8ch，事实包 A1-04 工具）抓 PB6/PB7 看 I2C 时序与 ACK
- 无输出先查 SHT30 地址/命令（待定需人确认），再查共总线冲突

### 5.3 测试入口
- SSCOM 115200 观察温湿度行（对应 AC-01）；接线与电压测量（AC-02 前提）

## 6. 执行日志

| 时间 | 阶段 | 角色 | 摘要 | 遇阻 |
|---|---|---|---|---|
| | | | | |
