wumu-dot/SoundDog/docs/features/FEAT-A7-04-MPU6050振动监测.md

# FEAT-A7-04 MPU6050 振动监测（计划书）

- **文档状态**：📋 **计划（未实施）** —— 本文只定方案与验收，实施后转为执行记录
- **出具**：审查官 ｜ **日期**：2026-11-01
- **上游规格**：`esp32-modbus-gateway/docs/spec/SoundDog-传感器扩展规格-MPU6050-2026-10-20.md`（下称「旧规格」）
- **关联**：FEAT-A7-01（SHT30）｜Modbus 9 寄存器

> 🔄 **方案变更（2026-11-01）**：本文 v1 按「串口版模块（JY61 类）+ USART2」编写。
> 用户核对实物为 **8 脚 GY-521（纯 I2C）** ⇒ **串口方案作废**，改回 I2C。
>
> 🔄 **再变更（2026-11-01 13:50）**：用户确认 **PF0/PF1 已引到排针**，且 `GPIO_AF4_I2C2` 可用（`stm32f4xx_hal_gpio_ex.h:84`）
> ⇒ **改用 I2C2 独立总线（PF1=SCL / PF0=SDA）**，不与 OLED 共用 I2C1。
> 好处：**不需要互斥锁、不需要改 `oled_drv.c`**，总线竞争从"要测的验收项"变成"结构上不存在"。

---

## 0. 三源核对（R27）

| 源 | 具体来源 | 用途 |
|---|---|---|
| **① 厂商资料** | `桌面\stm32F407ZGT6\MPU6050模块资料\MPU6050资料V5\MPU6050资料V5\`：`Datasheet/MPU6050.PDF`、`Datasheet/MPU-6050寄存器映射.pdf`、`示例程序/核心代码/`、`上位机/` | **主证据**（I2C 直读芯片寄存器） |
| **② 项目内** | 旧规格；`modbus_app.{c,h}`、`pin_config.h`、`oled_drv.c`、`BSP/` | 现状与接口 |
| **③ 交叉验证** | 芯路城资料页 `xinlucity.com/?s=resourcedetail/index/id/222.html` 的附件名（「**串口**6轴…zip」） | ⚠️ 该资料包对应**串口版**，与本实物（GY-521）**不是同一款**，**本轮不得引用其协议** |

> ⚠️ **教训记录**：v1 把「资料包名带串口」当成了实物证据。资料包名只能证明**厂商卖过这款**，不能证明**用户手里是哪款**。实物判定必须看引脚数/丝印，不能看资料名。

---

## 1. 与旧规格的差异（逐条裁决）

| # | 旧规格写的 | 实际 | 裁决 |
|---|---|---|---|
| **D-1** | §4.3：振动放 `0x0005/0x0006`，寄存器数 5→7 | 从站**已 9 个**：5/6=SHT30 温湿度，**7/8=VIB_RMS/VIB_PEAK**（`modbus_app.c:110-111`，当前恒 0） | ✅ **按 7/8**；**协议层零改动** |
| **D-2** | §2.1 主接法：与 OLED 共用 **I2C1（PB6/PB7）** | 实物 GY-521 走 I2C 没错，但**不必共用** —— `PF0/PF1` 已引到排针 | ⚠️ **改用 I2C2 独立（PF1=SCL / PF0=SDA）**，见 §5.3 |
| **D-3** | §4.1 步 3：`0x1C=0x00`（**±2 g**） | ±2 g 量程仅约 19.6 m/s²，**敲桌面极易削顶**，削顶会直接污染 RMS/峰值 | ⚠️ **改为 ±8 g**（`0x1C=0x10`），理由见 §5.4 |
| **D-4** | §4.1 步 5：`0x1A=0x04`（DLPF 21 Hz） | 21 Hz 会把敲击的尖峰滤掉，**峰值低估** | ⚠️ **改为 `0x1A=0x03`（44 Hz）**，见 §5.4 |
| **D-5** | 未提总线竞争 | 若与 OLED 共用 I2C1，`oled_update_screen()` 每 200 ms 占约 24 ms，且 `hi2c1` 非可重入 | ✅ **改用独立 I2C2，竞争从结构上不存在**（§5.3） |
| **D-6** | §4.2 重力处理「二选一」 | — | ✅ 采用「上电静止取均值当零点」 |

---

## 2. 目标与范围

### 2.1 要做的

1. 通过 **I2C2**（PF1/PF0，独占总线）读 MPU6050（地址 `0x68`）加速度寄存器 `0x3B` 起 6 字节；
2. 计算**振动趋势量**：三轴合成去重力后的 **RMS** 与**窗口峰值**；
3. 写入 Modbus 保持寄存器 `0x0007`/`0x0008`（mg 定点，`0~5000`）；
4. 网关按既有 9 寄存器整块读上传（`vib_rms`/`vib_peak` 两个云端属性已建好，**无需改云端**）。

### 2.2 明确不做的

| 不做 | 原因 |
|---|---|
| 串口方案（USART2/PD5/PD6） | 实物无 RX/TX 引脚 |
| 陀螺仪数据 / 姿态角 | 寄存器只有 7/8 两位；振动量用不到 |
| 温度 | 已有 SHT30；芯片温度精度低 |
| 内部 FIFO / INT 中断 | 100 Hz 按需读已够；增加复杂度收益不大 |
| 频谱分析 | 奈奎斯特 50 Hz，做不出有意义的频谱（旧规格 M7） |

---

## 3. 硬件前提

### 3.1 接线（GY-521，8 脚）

| GY-521 引脚 | 接到 | 板上丝印 | 说明 |
|---|---|---|---|
| `VCC` | **`3V3`** | `3V3` | ⭐ **统一 3.3 V**：模块上拉电阻连到 VCC，接 5 V 则 SCL/SDA 被拉到 5 V，可能打坏 MCU 引脚。接 3.3 V 两种模块都不会烧（旧规格 §3.2） |
| `GND` | `GND` | `GND` | 共地 |
| `SCL` | **`PF1`** | `F1` | **I2C2_SCL**（AF4），独占总线 |
| `SDA` | **`PF0`** | `F0` | **I2C2_SDA**（AF4），独占总线 |
| **`AD0`** | **`GND`** | — | ⇒ 地址 **`0x68`**。🔴 **不可悬空**（悬空时地址不定，可能 0x69） |
| `INT` | 悬空 | — | 本设计轮询，不用中断 |
| `XDA` / `XCL` | 悬空 | — | 辅助 I2C 主口（接磁力计组九轴），不用 |

**总线地址**：I2C2 上只有 MPU6050 一个从设备 `0x68`。OLED `0x3C` 在 I2C1、SHT30 `0x44` 在 I2C3 ⇒ **三条总线、三个地址，互不相干**。

### 3.2 上拉与电气

- GY-521 板载 **4.7 kΩ** 上拉（SDA/SCL 各一）⇒ **I2C2 上是单设备总线，4.7 k 完全合规**，400 kHz 无压力；
- ⛔ **不要再外加**上拉（并联会降到 1 kΩ 以下反而更差）；
- 杜邦线 ≤ 20 cm；若偶发 `HAL_I2C_ERROR_AF`，把 I2C2 的 `ClockSpeed` 由 400 k 降到 100 k 复测（降速即愈 ⇒ 电容；仍坏 ⇒ 接线/器件）。

### 3.3 引脚占用核对（已实测）

| 外设 | 引脚 | 出处 |
|---|---|---|
| I2C1（OLED） | PB6 / PB7 | `i2c.c:44-49` |
| **I2C2（本次 MPU6050）** | **PF1 / PF0** | ✅ `gpio.c:96` 里 PF0/PF1 原为 **ANALOG**（未被占用）；FMC 业务代码未使用；`pin_config.h:61-62` 早已记明这对脚可用于 I2C2 |
| I2C3（SHT30） | PA8 / PC9 | `sht30.c:66-76` |
| I2S3 / USART3 | PA4/PB3/PB5 ｜ PD8/PD9 | `i2s_drv.c` / `pin_config.h` |
| USART1（调试打印） | PA9 / PA10 | `usart.c` |

---

## 4. 与现有系统的接口（本轮最大的简化）

| 层 | 现状 | 要改吗 |
|---|---|---|
| 从站寄存器数 | `MODBUS_REG_HOLDING_NUM = 9u`（`modbus_app.h:29`） | ❌ |
| 寄存器 7/8 写入点 | 已在（`modbus_app.c:110-111`） | ❌ 只填数据 |
| 网关读取范围 | `MASTER_PARAM_CNT = 9` | ❌ |
| 云端 `vib_rms/vib_peak` | 已建属性且已有值（0） | ❌ |

⇒ 本 FEAT 的全部工作是**让 `g_vib_rms`/`g_vib_peak` 不再是 0**。

---

## 5. 软件设计

### 5.1 新增 / 修改文件

| 文件 | 改动 |
|---|---|
| **新增** `BSP/mpu6050.c/.h` | **自建 I2C2 初始化**（照 `sht30.c:58-96` 自建 I2C3 的样板）+ 初始化序列 + 读 14 字节 + 换算 + 零点 + RMS/峰值 + `vib_task` |
| `App/modbus_app.c` | 删除本地 `g_vib_rms/g_vib_peak` 定义 → 由 `mpu6050.c` 提供、头文件给 extern；**修正 `:20-25` 里"I2C2 尚未接入"的过期注释** |
| `App/freertos.c` | 新增 `vib_task`（100 Hz），栈 **1024 B**，优先级 `BelowNormal` |
| `Inc/pin_config.h` | 增加 `MPU_I2C` / `MPU_I2C_SCL_PIN(PF1)` / `MPU_I2C_SDA_PIN(PF0)` / `MPU_I2C_ADDR(0x68)` 宏 |
| `sources.mk` | 加 `BSP/mpu6050.c` |

> ✅ **`BSP/oled_drv.c` 一行不改**，也不需要互斥锁 —— 见 §5.3。

### 5.2 初始化序列（据 MPU6050 寄存器手册）

| 步 | 寄存器 | 写值 | 含义 | 校验 |
|---|---|---|---|---|
| 1 | 读 `0x75` | — | `WHO_AM_I` | **应回 `0x68`**；否则接线/地址/供电有问题 ⇒ 报错并停 |
| 2 | `0x6B` | `0x00` | 退出睡眠（`SLEEP=0`），时钟源 = 内部 8 MHz | ⚠️ **必须先做**，睡眠时写其他寄存器无效 |
| 3 | `0x1C` | **`0x10`** | 加速度 **±8 g**（4096 LSB/g） | 见 §5.4 |
| 4 | `0x1B` | `0x00` | 陀螺 ±250 °/s（不用，保持默认） | — |
| 5 | `0x1A` | **`0x03`** | DLPF 带宽 **44 Hz** | 见 §5.4 |
| 6 | `0x19` | **`0x09`** | 采样率 = 1000/(1+9) = **100 Hz**（与轮询同频） | — |
| 7 | 循环读 `0x3B`，14 字节 | — | 取前 6 字节 AX/AY/AZ | 每帧 14 B @400 kHz ≈ 0.35 ms |

### 5.3 ⭐ 为什么用 I2C2 独立总线（而非与 OLED 共用 I2C1）

**先说清楚争用发生在哪一层**（这是最容易搞混的一点）：

| 层面 | 会不会争 | 原因 |
|---|---|---|
| **从设备之间**（OLED vs MPU） | ❌ **不会** | I2C 是主从总线，同一时刻只有一个主。从设备没有主控权，不会主动发起传输 |
| **地址冲突** | ❌ 不会 | OLED `0x3C` / MPU `0x68` / SHT30 `0x44`（且在第三条总线） |
| **两个任务抢同一个 `hi2c` 外设** | ✅ **会，这才是真正的冲突** | `HAL_I2C_Mem_Write()` 用 `hi2c->State` 做状态机，**非可重入**。任务 A 检查 `State==READY` 后被 SysTick 抢占，任务 B 也看到 READY ⇒ 两帧在总线上交错 ⇒ OLED 花屏 / MPU 数据跳变 |

**若共用 I2C1 的代价**：必须给 `hi2c1` 加互斥锁，且要改 `oled_drv.c`（触碰一个当前工作正常的模块）。

**改用 I2C2 后**：

| 项 | 结果 |
|---|---|
| 互斥锁 | ❌ **不需要**（`hi2c2` 只有一个使用者：`vib_task`） |
| 改 `oled_drv.c` | ❌ **不需要** |
| OLED 刷新对采样的影响 | ❌ **不存在**（不同外设，硬件并行） |
| 采样率上限 | 可自由提高（100 Hz 只是初值；40 kHz 时钟下 14 B 读 ≈ 0.35 ms）|
| 代码量 | 多约 50 行自建 I2C2 初始化，**有现成样板**（`sht30.c` 的 I2C3 就是同样做法） |

**可行性依据**（三条都已核）：

1. `PF0/PF1` **已引到排针**（用户确认）；
2. `gpio.c:96` 显示这两脚原为 **ANALOG**（未占用）；业务代码零引用；FMC 未使用；
3. `GPIO_AF4_I2C2` 存在（`stm32f4xx_hal_gpio_ex.h:84`），即 PF0/PF1 可复用为 I2C2。

⚠️ **唯一待实测**：PF0/PF1 到 GY-521 的物理接线（S1 会用 `WHO_AM_I` 直接验证）。

**回退预案**：若 PF0/PF1 实测不可用（接线后读不到、或波形异常），退回「I2C1 共用 + 互斥锁 + 按页加锁」方案（已论证可行：`oled_update_screen()` 每页独立传输，MPU 最坏等 3 ms 而非 24 ms）。

### 5.4 ⭐ 量程与带宽（对旧规格的两处修正）

| 参数 | 旧规格 | 本方案 | 理由 |
|---|---|---|---|
| 量程 | ±2 g（16384 LSB/g，0.061 mg/LSB） | **±8 g**（4096 LSB/g，**0.244 mg/LSB**） | ±2 g 仅 ~19.6 m/s²，**敲桌面极易超过**；削顶后 RMS/峰值全错且"看起来像测到了"。±8 g 分辨率 0.244 mg 仍远优于寄存器 1 mg 粒度 |
| DLPF | 21 Hz | **44 Hz** | 21 Hz 会把敲击瞬态削平 ⇒ **峰值低估**；44 Hz 兼顾噪声与尖峰 |

⚠️ 两者都是可调参数，S3 按实测曲线再定：噪声大回退 21 Hz，削顶则升到 ±16 g。

### 5.5 振动量算法

| 步 | 做法 |
|---|---|
| 1 | 初始化失败（`WHO_AM_I ≠ 0x68`）⇒ 不启动任务，寄存器 7/8 保持 0，**不影响既有功能** |
| 2 | **上电静止 2 s**（约 200 帧）取三轴均值 `gx,gy,gz` 作零点（静止时合成 ≈1 g，不减掉 RMS 恒 ≈1 g） |
| 3 | 每帧去零点：`dx=ax-gx`… |
| 4 | 累加 `sum += dx²+dy²+dz²`；`peak = max(peak, sqrt(dx²+dy²+dz²))` |
| 5 | **每 100 帧（1 s）**结算：`rms_mg = sqrt(sum/N)*1000`、`peak_mg = peak*1000` |
| 6 | 限幅 `0~5000` 后写 `g_vib_rms`/`g_vib_peak`；**削顶时置标志并串口告警**（便于发现量程不足） |

### 5.6 资源开销

| 项 | 值 |
|---|---|
| `vib_task` 栈 | 1024 B |
| + TCB + 块头 | 约 1,116 B |
| 加完后堆余量 | 16,808 − 1,116 ≈ **15,692 B**（目标 ≥14,000） |
| I2C2 总线占用 | MPU 100 Hz × 0.35 ms = **3.5%**（独占总线，无争用） |

---

## 6. 实施阶段（每阶段有闸门）

| 阶段 | 内容 | 闸门（实测通过才进下一阶段） |
|---|---|---|
| **S1** | 只做 I2C 读 `WHO_AM_I`(0x75)，串口打印一次 | 读到 **`0x68`**。读不到 ⇒ 查 AD0 是否接地、SCL/SDA 是否反、VCC 是否 3.3 V |
| **S2** | 初始化序列 + 读 14 字节，100 Hz 打印三轴原始值与 g 值 | 静止时合成 **≈1.00 g ± 0.05**；翻转模块三轴方向正确 |
| **S3** | 零点标定 + RMS/峰值，1 Hz 打印 | 静止 30 s：`rms < 20 mg`；轻敲桌面：起跳后 1~2 s 回落；**无削顶告警** |
| **S4** | 接入寄存器 7/8 + 云台上行 | 云端 `vib_rms` 非 0；轻敲时曲线起跳 |
| **S5** | 清理 + 与 SHT30/OLED/Modbus 联跑 | 见 §7 |

---

## 7. 验收判据（AC）

| # | 判据 | 方法 | 通过线 |
|---|---|---|---|
| **AC-1** | 器件识别 | 读 `0x75` | = `0x68` |
| **AC-2** | 量测正确性 | 翻转模块六面 | 各面 `\|a\|` 均在 1 g 附近；重力方向随姿态改变 |
| **AC-3** | **R25 功能验证（必须）** | 静止→敲桌面→静止 | `rms` 从 <20 mg 起跳，峰值后 1~2 s 回落 |
| **AC-4** | 线性度 | 三档力度轻敲 | `rms` 随力度单调递增 |
| **AC-5** | **不破坏既有功能** | 与 OLED/SHT30/Modbus 同时跑 | OLED 不卡顿无乱码；温湿度照常；Modbus 9 寄存器零错误 |
| **AC-6** | 总线健康 | 连续 10 min 统计 `err_count` | `err_count` 不增长 |
| **AC-7** | 云端可见 | ThingsCloud 属性历史 | `vib_rms`/`vib_peak` 非零且与串口日志一致 |
| **AC-8** | 堆余量 | SWD 读 `xFreeBytesRemaining` | ≥ **14,000 B** |
| **AC-9** | 无测试遗留 | 全仓扫描 | 无临时打印/调试宏；一次性脚本不入库 |

---

## 8. 风险与坑

| # | 风险 | 表现 | 对策 |
|---|---|---|---|
| **M1** | AD0 悬空 | 地址变 0x69，`WHO_AM_I` 读不到 | AD0 必须接 GND |
| **M2** | **VCC 接 5 V** | SCL/SDA 被上拉到 5 V，可能打坏 PF0/PF1 | **统一 3.3 V**（旧规格 §3.2） |
| **M3** | **PF0/PF1 复用配置错误**（AF 选错 / 时钟没使能 / 引脚没配开漏） | `WHO_AM_I` 读不到或读数恒 0xFF | 照 `sht30.c:58-76` 样板：先 `__HAL_RCC_GPIOF_CLK_ENABLE` + `__HAL_RCC_I2C2_CLK_ENABLE`，再 `GPIO_MODE_AF_OD` + `GPIO_AF4_I2C2` |
| **M4** | 量程选小 → 削顶 | 敲击时 `rms` 不再上升（饱和） | ±8 g；代码检测 `\|a\|` 接近满量程时告警 |
| **M5** | 上电未静止就标零点 | 静止时 `rms` 偏大且漂 | 标定期间检测方差，过大则重标并告警 |
| **M6** | 加任务后堆不够 | `[FATAL] FreeRTOS heap allocation FAILED` → IWDG 复位循环、OLED 反复播开机动画 | 见 `BUG-20261029-001`；加完必读 `xFreeBytesRemaining` |
| **M7** | 杜邦线过长/接触不良 | 偶发 AF、`err_count` 增长 | 线 ≤20 cm；优先降速 100 kHz 复测 |
| **M8** | 把「资料包是串口版」当实物证据 | **本轮已犯**：v1 整篇基于串口方案 | 实物判定只看引脚数/丝印；资料包只能证明厂商卖过 |

---

## 9. 回滚与清理

| 项 | 方案 |
|---|---|
| 代码回滚 | 删除 `BSP/mpu6050.*` 即可；`oled_drv.c` 的锁是增量，去掉后行为不变 |
| 行为回滚 | 初始化失败 ⇒ 任务不启动，寄存器 7/8 保持 0，**与现状一致** |
| 测试遗留 | S2 的逐帧打印属临时诊断，**S5 必须物理删除**（不是宏置 0）；日志归档到 `桌面\报告\审计报告\esp\检测记录\` |
| 固件回退 | 烧录前记录 hex 哈希并保留 bin |

---

## 10. 待实测 / 待确认

| # | 项 | 说明 |
|---|---|---|
| **T-1** | ✅ 实物为 GY-521 8 脚 | 用户已确认；**AD0 是否已引到排针需目视** |
| **T-2** | 量程/DLPF 最终取值 | ±8 g / 44 Hz 为初值，S3 按曲线定 |
| **T-3** | 1 s 窗口是否合适 | 取决于现场振动特征 |
| **T-4** | I2C2 在 400 kHz 下的稳定性 | PF0/PF1 走杜邦线到模块，若 `err_count` 增长则降到 100 kHz |
| **T-5** | 芯片温漂对零点的影响 | 长时间运行零点会漂，是否周期重标（暂定不做） |

---

## 11. 建议顺序

**先做 S1（只读 `WHO_AM_I`）**：约 30 行代码，烧一次即可确认「接线 + 地址 + 供电」三件事。S1 不过，后面全白搭；S1 过了，剩下都是纯软件。

---

*出具：审查官 ｜ 2026-11-01 ｜ 本文为计划，未实施*
