wumu-dot/SoundDog/docs/features/FEAT-A5-01-USART3-RS485模块驱动.md

# FEAT-A5-01-USART3-RS485模块驱动

> **AI 执行规则**：必须按阶段顺序执行，每个阶段开头声明角色。严禁跳跃、越界、自审自判。
> 阶段间停等：每完成一个阶段，停下来，输出结果，等人说"继续"。
> 阶段5通过后：回填父FEAT项目表该行 + 更新 `docs/features/INDEX.md` + `docs/features/维护地图.md`。
> 历史记录只更新状态字段，严禁删除/篡改已完成记录。
> 事实来源：`.sop-agent规格.md` §3 + `firmware/soundDog/Inc/pin_config.h`（禁止自造数值；未覆盖项写"待定（需人确认）"）。

## 0. 元数据
- **父FEAT**：FEAT-A5-RS485通信
- **优先级**：P1
- **预估总耗时**：2h（父FEAT 预算 8h 内拆分）
- **当前状态**：🟡阶段4 排查中（回环时序坑已修复、单 EN 自发自收不可行已确认；待独立 USB-TTL 到货做双模块对端完整验证；详见 BUG-20260902-001）

### 0.1 来源（R32：所有引用必须附可点击 URL）
- **器件 Datasheet（SP3485/MAX3485，3.3V 半双工 RS-485 收发器，DE/`RE` 方向控制）**: [MAX3483/MAX3485.../MAX3491 — True RS-485/RS-422 Transceivers (Analog Devices 官方 PDF)](https://www.analog.com/media/en/technical-documentation/data-sheets/max3483-max3491.pdf)（`/RE` 低有效：`/RE` 为高时 RO 置高阻、接收禁用；半双工 75176 引脚兼容）
- **2-wire RS-485 半双工自发自收不成立（回环须双模块对端）**: [Sealevel — loopback test with 2-wire RS-485](https://www.sealevel.com/how-do-i-perform-a-loopback-test-with-my-serial-adapter-configured-for-2-wire-rs-485/)（"When the serial port is transmitting, the receiver is disabled"... 需 support 'Echo'）
- **回环放 osKernelStart 前死锁（HAL_UART_Receive 超时失效）**: [ST Community — Peripheral use before FreeRTOS Kernel Init makes the MCU to infinite loop](https://community.st.com/t5/stm32-mcu-products/peripheral-use-before-freertos-kernel-init-makes-the-mcu-to/m-p/572825)、[FreeRTOS Troubleshooting FAQ](https://research.freertos.org/Why-FreeRTOS/FAQs/Troubleshooting/)（调度器前调内核 API 永久关中断）
- **ST HAL 驱动超时实现（`UART_WaitOnFlagUntilTimeout` 依赖 `HAL_GetTick`）**: [ST Community — FreeRTOS and HAL driver timeout issue](https://community.st.com/t5/stm32-mcu-products/freertos-and-hal-driver-timeout-issue/td-p/472338)

## 1. 总体目标与硬边界

### 1.1 核心目标（一句话）
> 打通 USART3（PD8/PD9）+ TTL-RS485 模块(3.3V/SP3485，EN 方向控制) 的硬件链路与 HAL 驱动，**回环可收发**验证通过，为 A5-02 协议帧提供可靠收发通道。

### 1.2 地基触碰前置自检
- [x] 否 → 继续（UART 走 HAL 标准库 + App 层驱动，不碰 `firmware/Drivers/`）

### 1.3 任务边界
| 类型 | 具体内容 |
|---|---|
| 范围内（可改） | `soundDog.ioc`（USART3 外设 + PD11 GPIO 输出）、`usart.c`/`usart.h`（huart3，参照 huart1 模式）、新增 rs485 驱动文件（收发 + 方向控制，文件名待定（需人确认））、`Makefile`（C_SOURCES 补源文件）、`pin_config.h`（RS485 宏已定义，如需调整只改此文件） |
| 超出范围（禁止碰） | `firmware/Drivers/` HAL 底层库；I2S3/USART1 现有链路（A1 已验证） |
| 外部依赖 | TTL-RS485 模块(3.3V/SP3485) ×1（已到货）、杜邦线、ST-Link、SSCOM（可选） |

### 1.4 关键参数与接口（事实包 §3 + pin_config.h，禁止自造）
- **USART3 引脚**：TX=**PD8**、RX=**PD9**（`RS485_TX_PIN` / `RS485_RX_PIN`）；波特率 **115200**（`RS485_UART_BAUD`）。
- **EN 方向控制脚**：**PD11**（`RS485_DE_PIN`，pin_config.h 注释"DE/RE 方向控制"）。
- **模块引脚（用户已确认丝印）**：**EN / VCC / A / B / GND×2 / RXD / TXD**（SP3485，3.3V，半双工）。
  - 模块 **RXD** ← MCU **PD8（USART3_TX）**（TTL 交叉：MCU 发 → 模块收）
  - 模块 **TXD** → MCU **PD9（USART3_RX）**（模块发 → MCU 收）
  - 模块 **EN** ← MCU **PD11**：**高=发送 / 低=接收**（方向控制）
  - 模块 **A / B** ← RS485 差分总线（本 FEAT 回环测试可 A-B 对接；A5-03 两模块对接）
- **回环验收**：**回环可收发**（事实包 A5-01）。
- **现状事实**：pin_config.h 标注 USART3 "预留，待 CubeMX 配置"；`soundDog.ioc` 当前外设列表（DMA/FREERTOS/I2S3/NVIC/RCC/SYS/USART1）**不含 USART3** → 阶段 1 必须核实。
- **待定（需人确认）**：rs485 驱动文件名；回环验证方式若与 §3 不符按现场记录差异。

## 2. 执行路线图（5 阶段）

### 🟢 阶段 1：准备（角色：Dev Agent）
- **读什么**：`pin_config.h`（引脚权威）、`soundDog.ioc`、`usart.c`/`usart.h`（huart1 模式参照）、`CLAUDE.md`（硬边界）、`HANDOFF.md` §4.2（接线规范，若涉及）
- [ ] 步骤1：核对模块丝印引脚（EN/VCC/A/B/GND×2/RXD/TXD）与 §1.4 一致，记录到 §3.2
- [ ] 步骤2：核实 `soundDog.ioc` 是否已配置 USART3（当前预期：**未配置**）
- [ ] 步骤3：输出影响范围（ioc / usart.c/h / 新增驱动 / Makefile / 接线）
- **判定标准**：模块引脚已核对、USART3 配置现状已核实、影响范围清单已输出
- **⏸️ 停等：人确认后进入阶段 2**

### 🔵 阶段 2：设计（角色：Dev Agent）
- **阶段目标**：确定初始化方式与 EN 方向控制时序，产出傻瓜式操作单（§3）
- [ ] 步骤1：确定 USART3 初始化方式：① CubeMX 图形化添加（参照 `docs/CubeMX实操步骤.md`）② 手写 HAL（参照 `usart.c` 中 `MX_USART1_UART_Init` 模式）——**选择需人确认**
- [ ] 步骤2：设计 EN 方向控制时序（半双工：发送前 EN=1，发送完成 TC 标志后 EN=0；空闲恒 0）
- [ ] 步骤3：设计 rs485 驱动接口（Init / Send / Receive / 方向切换，签名待定（需人确认））
- **判定标准**：初始化方式已确认、方向控制时序已产出、接口签名已产出
- **⏸️ 停等：人确认后进入阶段 3**

### 🟠 阶段 3：实现（角色：Dev Agent）
- **阶段目标**：写代码 + 接线，每改完一个文件对照 §4 自检
- [ ] 步骤1：按 §3.1 **断电**接线并逐根打勾
- [ ] 步骤2：配置 USART3 + PD11（CubeMX 或手写），生成/补充代码
- [ ] 步骤3：实现 rs485 驱动收发 + EN 方向控制；**`Makefile` C_SOURCES 补源文件**（BUG-002 教训：漏加导致链接失败）
- [ ] 步骤4：`firmware\build.bat` 编译，期望无错误退出、无新增警告
- **判定标准**：编译通过（build.bat 无错误退出）
- **⏸️ 停等：人确认后进入阶段 4**

===== 切换至 Test Agent =====

### 🟣 阶段 4：测试（角色：Test Agent）
- **阶段目标**：独立验证——只按 §3 操作单与 §4 验收标准复核，不看 Dev 的实现细节
- [ ] 步骤1：烧录（`firmware\build_and_flash.bat`，期望 `wrote ...` / `Verified OK`）
- [ ] 步骤2：按 §3.2 回环测试，记录收发字节与错误计数（AC-01）
- [ ] 步骤3：按 §3.3 半双工方向验证（EN 型：确认发送窗口方向切换）
- [ ] 若失败 → 查 §3.4 故障速查表，退回阶段 3
- **⏸️ 停等：人确认后进入阶段 5**

===== 切换至 Review Agent =====

### 🔴 阶段 5：审查（角色：Review Agent）
- **阶段目标**：独立审查——安全红线、代码质量、AC 逐条打勾
- [ ] 步骤1：核对 §4 全部 AC 勾选与记录值（回环 100 次、错误计数）
- [ ] 步骤2：核对 EN 方向控制时序（高=发送/低=接收）与半双工红线合规
- **判定标准**：AC 全部通过且记录值完整
- 全部通过 → ✅ 回填「维护与调试」+ 父FEAT项目表 + INDEX + 维护地图
- 未通过 → 退回对应阶段并附意见
- **⏸️ 停等：人确认 Review 通过后归档**

## 3. 傻瓜式操作单（照做即可）

### 3.0 物品清单（动手前先打勾，缺一不可）
- [ ] TTL-RS485 模块(3.3V/SP3485) ×1（已到货）
- [ ] 核心板（STM32F407ZGT6，A1 链路已验证）
- [ ] 杜邦线（母对母）×7（VCC/GND×2/RXD/TXD/EN + 备用）
- [ ] ST-Link（SWD：SWDIO/SWCLK/GND/3.3V 四线）
- [ ] 5V 电源（非快充）
- [ ] 万用表（直流电压档，上电前检查）
- [ ] SSCOM（可选：USART1 调试口观察）

### 3.1 接线（全程断电！先拔掉所有电源线再动线）
**红线**：模块 VCC **只准接 3.3V**（SP3485 为 3.3V 器件，接 5V 可能烧模块）；A/B 差分端子不得与电源/GND 短路；EN 空闲必须为 0（接收态）。按顺序接线，**每接完一根在 ☐ 打勾**：

| 顺序 | 从（RS485 模块） | 到（核心板） | 核对要点 | 完成 |
|---|---|---|---|---|
| 1 | VCC | 3.3V | ⚠️ 严禁 5V！ | ☐ |
| 2 | GND（任一个） | GND | 必须共地 | ☐ |
| 3 | RXD | PD8（USART3_TX） | ⚠️ 交叉：MCU 发 → 模块收 | ☐ |
| 4 | TXD | PD9（USART3_RX） | ⚠️ 交叉：模块发 → MCU 收 | ☐ |
| 5 | EN | PD11 | GPIO 方向控制：高=发送 / 低=接收 | ☐ |
| 6 | A | A（对接第二块 MAX3485 的 A） | 单 EN 模块自发自收不可行，须双模块对端（见 §3.2） | ☐ |
| 7 | B | B（对接第二块 MAX3485 的 B） | 两端 GND 共地 | ☐ |

> ⚠️ 回环方式更正（BUG-20260902-001）：**单 EN 模块（DE+`/RE` 同控一根）无法 A-B 短接自发自收**——发送时 DE=1 同时 `/RE=1`（禁收），RO 无输出；发完切接收态时数据已结束。故回环必须用**双模块对端**（板上模块 A/B ↔ 对端模块 A/B），详见 §3.2。

### 3.2 回环验证（阶段 4 执行；**双模块对端**，非自发自收）
> 单 EN 模块无法自发自收（BUG-20260902-001），回环改用**双模块对端**。
1. 核对模块丝印：**EN / VCC / A / B / GND×2 / RXD / TXD**（记录：一致 / 差异说明：___）
2. 接线（板上模块 → 对端模块，A-A/B-B/GND-GND 对接；对端模块 TTL 侧接独立 USB-TTL→PC）：
   - 板上模块：RXD←PD8、TXD→PD9、EN←PD11、VCC→3.3V、GND→GND
   - 对端模块：RXD←USB-TTL.TX、TXD→USB-TTL.RX、EN→对端控制（或恒收态 GND）、VCC→3.3V、GND→共地
   - 两端 A↔A、B↔B、GND↔GND 对接
3. 烧录固件：运行 `firmware\build_and_flash.bat` → 期望 `wrote ... bytes` / `Verified OK`。
4. 触发板端发送测试串（如 ASCII "RS485_LOOP"）：期望 USB-TTL 对端串口收到**相同内容**。
   记录：发送内容：______；对端收到内容：______
5. 对端（USB-TTL）向板端发送：期望板上 USART3 收到，经 `RS485LoopTask` 回环打印识别。
6. EN 型：发送前 EN(PD11)=1，发送完成（TC 标志）后 EN=0，期望方向切换正常。
   记录：方向切换是否正常：是 / 否
7. ⚠️ 半双工红线：同一时刻只允许一端发送；EN 只在发送窗口拉高，空闲/接收恒为 0。

> 时序坑提示：回环若放在 `main.c` `osKernelStart()` 前会死锁（BUG-20260902-001 根因①）。当前回环已移入 RTOS 任务 `RS485LoopTask`（一次性、跑完自删、结果由 SpecTask 打印），可复用。

### 3.3 半双工方向验证（EN 型补充）
1. 空闲态量 PD11 电压：期望 ≈0V（接收态）。记录数值：______
2. 发送瞬间量 PD11：期望 ≈3.3V（发送态）。记录数值：______

### 3.4 故障速查表（出问题先查这里）
| 现象 | 可能原因 | 处理 |
|---|---|---|
| 完全无回环数据 | RXD/TXD 接反 / EN 未接或接反 / 波特率不对 | 核对 §3.1 表；波特率 115200；确认 PD11 已接 EN |
| 收到乱码 | 波特率不符 / 杜邦线接触不良 / 未共地 | 改 115200；重插线；确认 GND 共地 |
| 回环无数据且 A/B 悬空 | 差分侧无回环路径 | 改用双模块对端（A-A/B-B/GND-GND 对接，非 A-B 短接） |
| 单模块 A-B 短接自发自收 st=3 | 单 EN 模块发送态禁收（BUG-20260902-001） | 物理不可行，勿再试；改用双模块对端 |
| 发送后收不到回环 | 发送完成未切回接收态（EN 恒高） | 确认 TC 标志后 EN=0 |
| 编译失败/链接失败 | Makefile 漏加源文件（BUG-002 教训） | `Makefile` C_SOURCES 补 rs485 源文件后重编 |
| 烧录连不上 | ST-Link 四线/驱动 | 查 A1-02 §3.1 兜底：`firmware\flash_isp.bat`（BOOT0+USART1） |
| 回环方式与上述不符 | 模块手册有特定回环接法 | 以模块手册为准，记录差异到执行日志（待定项） |

## 4. 验收标准（12 条）

### 功能验收
- [ ] AC-01 回环可收发：发送 100 次全部收到相同字节（§3.2 记录发送/接收内容，错误计数=0）
- [ ] AC-02 向后兼容：A1 音频链路不受影响（USART1 boot 三行 + `max` 随声音变化仍正常）

### 代码质量
- [ ] AC-03 编译通过：`firmware\build.bat` 无错误退出
- [ ] AC-04 无新增警告
- [ ] AC-05 文档已更新：本 FEAT 维护章节 + 父FEAT项目表文件列回填

### 安全红线
- [ ] AC-06 N/A：无密钥；帧常量属协议数据（A5-02 范畴）
- [ ] AC-07 错误处理：回环超时/收发错误有明确上报（记录到执行日志）
- [ ] AC-08 N/A：驱动层，帧内容校验在 A5-02

### 测试与边界
- [ ] AC-09 N/A：无自动测试框架；回环为手动验证（自动化脚本待定（需人确认））
- [ ] AC-10 回归：`./scripts/ci_local.sh` 通过（若适用）
- [ ] AC-11 N/A：嵌入式手动验证，覆盖率不适用
- [ ] AC-12 按 FEAT 模板执行（本文件即模板产物）

## 5. 维护与调试（阶段5通过后回填）

### 5.1 影响文件
| 文件 | 改动类型 | 说明 |
|---|---|---|
| `firmware/soundDog/soundDog.ioc` | 修改 | 添加 USART3 + PD11 GPIO（如选 CubeMX 方式） |
| `firmware/soundDog/Src/usart.c` / `Inc/usart.h` | 修改 | huart3 初始化（参照 huart1 模式） |
| `firmware/soundDog/Src/rs485_drv.c` / `Inc/rs485_drv.h` | 新增 | 收发 + EN 方向控制（文件名待定（需人确认）） |
| `firmware/soundDog/Inc/pin_config.h` | 修改（如需） | RS485 宏已定义，改引脚只改此文件 |
| `firmware/soundDog/Makefile` | 修改 | C_SOURCES 补 rs485 源文件（BUG-002 教训） |

### 5.2 调试要点
- 调试打印走 USART1（115200）；RS485 数据走 USART3（115200），两路不混
- EN 方向波形可用逻辑分析仪/示波器观测（可选）

### 5.3 测试入口
- §3.2 回环测试（对应 AC-01）

## 6. 执行日志

| 时间 | 阶段 | 角色 | 摘要 | 遇阻 |
|---|---|---|---|---|
| 2026-08-16 | 阶段1 准备 | Dev Agent | 模块丝印已核对（EN/VCC/A/B/GND×2/RXD/TXD）；`soundDog.ioc` 确认无 USART3（外设=DMA/FREERTOS/I2S3/NVIC/RCC/SYS/USART1）；影响范围：ioc/usart.c/h/新增rs485_drv/Makefile/接线，EN(PD11) 初始必须为低 | 无（RS485 模块已到货，可进阶段2设计；接线测试待模块到手） |
| 2026-08-16 | 阶段2 设计 | Dev Agent | 定案手写 HAL（不动 ioc）：huart3 照 huart1 模式，PD8/PD9=AF7、`__HAL_RCC_USART3/GPIO_D` 时钟；EN(PD11) 推挽初始低；时序=发送前 EN=1→等TC→EN=0，空闲恒0；接口 RS485_Init/SetDirTx/SetDirRx/Send/Receive | 无 |
| 2026-08-16 | 阶段3 实现 | Dev Agent | 已写：usart.c（huart3+MX_USART3_UART_Init+MspInit/MspDeInit USART3 分支）、usart.h、rs485_drv.c/.h、Makefile C_SOURCES、main.c（MX_USART3_UART_Init+RS485_Init+回环自测打印）；`build.bat` 通过（[ OK ] Build OK，零警告） | 无（首次编译漏 include usart.h，已修复） |
| 2026-09-02 | 阶段4 排查 | Dev Agent | 回环实测：RS485_Send st=0 / RS485_Receive st=3（HAL_TIMEOUT）。定位双根因（BUG-20260902-001）：①回环放 osKernelStart 前，BASEPRI=0x50 屏蔽 SysTick → HAL_UART_Receive 超时永不触发 → 死锁（与 BUG-006 同根）；已把回环移入 RTOS 任务 RS485LoopTask 修复。②单 EN 模块（DE+/RE 同控）无法 A-B 短接自发自收，物理不可行；st=3 属预期。回环方案改为双模块对端（§3.2 更新）。 | 根因②需独立 USB-TTL（CH340G 在途）做双模块对端完整验证 |
