wumu-dot/SoundDog/docs/features/FEAT-A1-02-音频链路验证.md

# FEAT-A1-02-音频链路验证

> **AI 执行规则**：必须按阶段顺序执行，每个阶段开头声明角色。严禁跳跃、越界、自审自判。
> 阶段间停等：每完成一个阶段，停下来，输出结果，等人说"继续"。
> 阶段5通过后：回填父FEAT项目表该行 + 更新 `docs/features/INDEX.md` + `docs/features/维护地图.md`。
> 历史记录只更新状态字段，严禁删除/篡改已完成记录。

## 0. 元数据
- **父FEAT**：FEAT-A1-音频采集链路
- **优先级**：P0
- **预估总耗时**：1h
- **当前状态**：🟢已完成（2026-08-28 阶段5审查通过，AC-01/02 ✅、AC-03~12 N/A）

## 1. 总体目标与硬边界

### 1.1 核心目标（一句话）
> 烧录固件 → 串口看到 boot 三行 + `[n] max=xxxx` 随声音变化 = **A1 音频链路打通**。

### 1.2 地基触碰前置自检
- [x] 否 → 继续（验证已有固件，不改代码/底层库）

### 1.3 任务边界
| 类型 | 具体内容 |
|---|---|
| 范围内（可改） | 烧录操作、串口观察 |
| 超出范围（禁止碰） | `firmware/Drivers/` HAL 底层库、改代码 |
| 外部依赖 | 核心板（已按 A1-01 接好）、ST-Link（SWD）或 USB-TTL、SSCOM |

### 1.4 前置条件
- **A1-01 必须已通过**（供电 5V/3.3V 正常、INMP441 接线正确）——硬件不安全则本步骤无意义。
- 固件已就绪（提交 `309dc06`，I2S3+DMA 采集），无需改代码。

## 2. 执行路线图（5 阶段）

### 🟢 阶段 1：准备（角色：Dev Agent）
- **阶段目标**：确认烧录/串口工具与预期输出
- [ ] 步骤1：确认 `firmware\build_and_flash.bat`（SWD 烧录）与 `firmware\flash_isp.bat`（BOOT0+USART1 兜底，见 HANDOFF §4.3）存在
- [ ] 步骤2：确认 ST-Link 四线（SWDIO/SWCLK/GND/3.3V）已接好
- [ ] 步骤3：确认 SSCOM 可用、预期输出格式（README「快速开始」）
- **⏸️ 停等：人确认后进入阶段 2**

### 🔵 阶段 2：设计（角色：Dev Agent）
- **阶段目标**：产出傻瓜式烧录/验证操作单（§3）
- [ ] 步骤1：烧录步骤与失败兜底（§3.1）
- [ ] 步骤2：串口观察步骤与期望输出（§3.2）
- [ ] 步骤3：故障速查表（§3.3）
- **⏸️ 停等：人确认后进入阶段 3**

### 🟠 阶段 3：实现（角色：Dev Agent）
- **阶段目标**：执行 §3.1 烧录，记录输出
- [ ] 步骤1：运行 `build_and_flash.bat`，等待编译 + OpenOCD 烧录
- [ ] 步骤2：失败 → 按 §3.1 步骤2 兜底流程
- **⏸️ 停等：人确认后进入阶段 4**

### 🟣 阶段 4：测试（角色：Test Agent）
- **阶段目标**：独立验证——按 §3.2 操作单观察串口，逐条核对 §4 验收标准
- [ ] 步骤1：SSCOM 观察 boot 三行（AC-01）
- [ ] 步骤2：吹气/敲击验证 max 变化（AC-01）
- [ ] 若失败 → 查 §3.3 故障表，退回阶段 3
- **⏸️ 停等：人确认后进入阶段 5**

### 🔴 阶段 5：审查（角色：Review Agent）
- **阶段目标**：独立审查——AC 逐条打勾
- 全部通过 → ✅ 回填「维护与调试」+ 父FEAT项目表 + INDEX + 维护地图
- 未通过 → 退回对应阶段并附意见

## 3. 傻瓜式操作单（照做即可）

### 3.0 物品/工具清单
- [ ] 核心板（已按 A1-01 接好 INMP441）
- [ ] ST-Link（SWD：SWDIO/SWCLK/GND/3.3V 四线）
- [ ] USB-TTL（CH340）+ SSCOM（115200）
- [ ] 5V 电源（非快充）

### 3.1 烧录（阶段 3 执行）
1. 打开 `firmware` 目录，**双击 `build_and_flash.bat`**。
2. 等待：先编译（gcc 输出），再 OpenOCD 烧录，最后应看到烧录成功提示（`wrote ... bytes` / `Verified OK`）。
3. **失败兜底**：
   - OpenOCD 报连不上 → 检查 ST-Link 四线（SWDIO/SWCLK/GND/3.3V）是否接对、驱动是否装好，重试。
   - 仍不行 → 用 **`firmware\flash_isp.bat`**（BOOT0 拉高 + USART1 串口烧录，操作见 HANDOFF §4.3）。
4. 烧录成功 → 拔掉 BOOT0（若用过 ISP），断电重上电。

### 3.2 串口观察（阶段 4 执行）
1. USB-TTL 接核心板：TX↔RX **交叉**、GND 共地。
2. SSCOM 打开**设备管理器里看到的 COM 口**（不一定是 COM4），波特率 **115200**。
3. 按复位键，期望**依次**出现三行（2026-08-28 固件：BUG-002 v10 修复 + 诊断代码已清理；RS485 回环已 `#if 0` 关闭，无 RS485 打印）：
   ```
   SoundDog boot OK, SYSCLK=168000000
   I2S_DRV_Init ret=0 (0=HAL_OK)
   I2S DMA started! waiting data...
   ```
4. 对麦克风**吹气/轻敲**：`[n] max=xxxx` 数值应**明显变化**，节奏跟随声音。
   **v10 基准**（2026-08-28 17:58 复测实测，BUG-002 详解文档有完整数据）：
   - 安静：max ≈ **98 ~ 2352**（底噪 + 环境声）
   - 吹气：max ≈ **4577 ~ 32767**（多次打满 int16 满量程）
   - 判据：安静/吹气对比 ≥ 5 倍，且响应跟随动作节奏

### 3.3 故障速查表
| 现象 | 可能原因 | 处理 |
|---|---|---|
| 编译报错 | 工具链/路径问题 | 截图报错，查 `firmware\build.sh` 或 CI |
| OpenOCD 连不上 | ST-Link 接线/驱动 | 查 SWDIO/SWCLK/GND/3.3V；换 `flash_isp.bat` |
| 串口完全无输出 | TX/RX 没交叉 / COM 口错 / GND 未共地 | 交叉接、看设备管理器、共地 |
| 只有 boot 前几行就停 | 供电不稳 | 量 5V/3.3V（A1-01 §3.2），换电源 |
| 输出全 0xFF/0x00 | L/R 悬空 / 模块 SD 无输出 | 确认 L/R→GND（A1-01 §3.1）；查 BUG-002 详解文档 §3 的 4 字周期模式比对 |
| `max` 恒为小值（~几十）且吹气不变 | 麦克风 SD 无输出 | 轻敲/吹气确认；无反应 → 换模块（A1-01 §3.5） |
| `max` 恒 ~32000 且吹气不变 | v9 伪迹特征（提取了悬空字） | 确认固件是 v10 之后版本（i2s_drv.c 顶部注释标 v10） |
| 数值恒定不变 | 麦克风损坏 | 轻敲/吹气；无反应 → 换模块（A1-01 §3.5） |

## 4. 验收标准（12 条）

### 功能验收
- [x] AC-01 串口依次出现 `SoundDog boot OK`、`I2S_DRV_Init ret=0`、`I2S DMA started`，且 `max` 数值随吹气/敲击明显变化
  **✅ 通过（2026-08-28 18:40，清理版固件 text=23392）**：boot 三行完整无杂项；安静段 [30]~[495] max=160~1606（v10 基准 98~2352 内）；吹气段 [526]~[1022] max=2307~32767 多次打满（基准 4577~32767 内）；对比 ~47 倍 ≥ 5 倍判据；帧序号连续无丢帧
- [x] AC-02 向后兼容：无代码改动，无接口变化
  **✅ 通过**：本 FEAT 仅烧录 + 观察；固件变更（BUG-002 v10 修复 + 诊断清理）已在 BUG-002 文档独立闭环，`audio_frame_t` 接口含 `samples` 字段为超集变更，回调签名未变

### 代码质量 / 安全红线 / 测试边界
- [x] AC-03 ~ AC-12：验证步骤，不适用项标注 **N/A**
  **N/A**（无代码改动 → 无编译/警告/新增测试；烧录前供电红线沿用 A1-01 §3.2，当日实测通过）

## 5. 维护与调试（阶段5通过后回填）

### 5.1 影响文件
| 文件 | 改动类型 | 说明 |
|---|---|---|
| （无代码改动） | — | 烧录 + 串口验证（固件为 BUG-002 v10 修复 + 诊断清理版，text=23392） |

### 5.2 调试要点
- 无输出 → 查 `docs/troubleshooting/bug_shturl`（SWD 锁死/接线/供电）
- 全 0xFF/0x00 → L/R 悬空、模块 SD 无输出（BUG-002 已修复，详见 `docs/summary/BUG-002-I2S数据提取问题详解.md`）
- `max=-32768` 负峰打印：int16 绝对值溢出（吹气超满量程时 `abs(INT16_MIN)` 溢出），非链路故障；A2 前建议统计改 int32 累加（备忘）

### 5.3 测试入口
- `firmware\build_and_flash.bat` + SSCOM 115200（对应 AC-01）

## 6. 执行日志

| 时间 | 阶段 | 角色 | 摘要 | 遇阻 |
|---|---|---|---|---|
| 2026-08-28 | 阶段1 准备 | Dev Agent | 工具核对：build_and_flash.bat / flash_isp.bat 均存在；SSCOM 当日已用于 BUG-002 复测；ST-Link 需人工确认四线 | 无 |
| 2026-08-28 | 阶段2 设计 | Dev Agent | 操作单更新至当前固件：§3.2 期望输出改为 boot 三行（无 RS485/RAW 打印）+ v10 实测基准（安静 98~2352 / 吹气 4577~32767，判据≥5倍）；§3.3 故障表更新（BUG-002 已修复，新增 v9 伪迹特征行） | 无 |
| 2026-08-28 | 阶段3 实现 | Dev Agent | 烧录清理版固件（build_and_flash.bat，text=23392）成功 | 无 |
| 2026-08-28 | 阶段4 测试 | Test Agent | 18:40 串口日志：boot 三行✓；安静段 [30]~[495] max=160~1606；吹气段 [526]~[1022] max=2307~32767 多次打满；对比~47倍；帧号连续无丢帧。附注：[867] max=-32768 为 int16 负峰溢出打印瑕疵，非链路故障 | 无 |
| 2026-08-28 | 阶段5 审查 | Review Agent | AC-01 ✅（附基准对照证据）、AC-02 ✅、AC-03~12 N/A。通过；备忘 1 条：A2 前将 max 统计改 int32 累加（负峰溢出） | 无 |
