wumu-dot/SoundDog/docs/features/FEAT-A1-03-LR通道确认.md

# FEAT-A1-03-LR通道确认

> **AI 执行规则**：必须按阶段顺序执行，每个阶段开头声明角色。严禁跳跃、越界、自审自判。
> 阶段间停等：每完成一个阶段，停下来，输出结果，等人说"继续"。
> 阶段5通过后：回填父FEAT项目表该行 + 更新 `docs/features/INDEX.md` + `docs/features/维护地图.md`。
> 历史记录只更新状态字段，严禁删除/篡改已完成记录。
> 事实来源：`.sop-agent规格.md` §3（禁止自造数值）。

## 0. 元数据
- **父FEAT**：FEAT-A1-音频采集链路
- **优先级**：P1
- **预估总耗时**：0.5h
- **当前状态**：🟢已完成（2026-08-28 阶段5审查通过：左声道有效，三组实验互证，无代码改动）

## 1. 总体目标与硬边界

### 1.1 核心目标（一句话）
> 确认有效 PCM 数据落在左声道还是右声道，固化取数掩码，为 A2 FFT 提供干净数据源。

### 1.2 地基触碰前置自检
- [x] 否 → 继续（不改底层库，仅确认取数逻辑）

### 1.3 任务边界
| 类型 | 具体内容 |
|---|---|
| 范围内（可改） | `i2s_drv.c` 取数逻辑/打印（如需改声道索引） |
| 超出范围（禁止碰） | `firmware/Drivers/` HAL 底层库 |
| 外部依赖 | 已跑通的音频链路（A1-02）、SSCOM |

### 1.4 关键参数（事实包 §3，2026-08-28 更新至 v10 语义）
- L/R→GND = **左声道**（INMP441 手册约定）；L/R→3.3V = 右声道。
- v10 数据结构（BUG-002 RAW dump 确诊）：4 字周期 `[音频字][xx7F][FFFF][FFFF]`，INMP441 **只在自己的槽内驱动 SD**，其余时段高阻（被上拉成 0xFFFF）。
- 当前固件 `extract_frame` 步进 4 取 `word[4k]` 低 16 位（左声道模式实测标定）。
- **推论（本 FEAT 要验证的核心）**：L/R 切到 3.3V 后 INMP441 改在右槽驱动 → 音频字移位 → step-4 窗口取到悬空字 → max 掉回底噪。档位 B "无响应" 本身就是"左声道有效"的证据。
- 串口打印 `[n] max=xxxx`，max 随吹气变化 = 该声道有数据。

## 2. 执行路线图（5 阶段）

### 🟢 阶段 1：准备（角色：Dev Agent）
- **阶段目标**：确认 A1-02 已通过，记录当前取数实现
- [ ] 步骤1：确认 A1-02 已通过（串口 boot 三行 + max 随声音变化）
- [ ] 步骤2：读 `i2s_drv.c` / `i2s_drv.h` 当前取数实现（掩码现状）
- **⏸️ 停等：人确认后进入阶段 2**

### 🔵 阶段 2：设计（角色：Dev Agent）
- **阶段目标**：确定声道判定实验步骤（§3 操作单）
- [ ] 步骤1：设计 L/R→GND 与 L/R→3.3V 两档对比实验
- [ ] 步骤2：确定结论记录格式（声道 + 掩码 + 是否需要改代码）
- **⏸️ 停等：人确认后进入阶段 3**

### 🟠 阶段 3：实现（角色：Dev Agent）
- **阶段目标**：按 §3 执行两档实验，记录数据
- [ ] 步骤1：档位A（L/R→GND，当前接线）：SSCOM 观察吹气 max 变化
- [ ] 步骤2：档位B（断电改 L/R→3.3V）：上电再观察
- [ ] 步骤3：如需改取数逻辑 → 改 `i2s_drv.c` 后 `build_and_flash.bat` 重烧
- **⏸️ 停等：人确认后进入阶段 4**

### 🟣 阶段 4：测试（角色：Test Agent）
- **阶段目标**：独立验证——按 §3 复跑，核对 §4 验收标准
- [ ] 步骤1：复跑有效档位，max 稳定非全 0（AC-01）
- [ ] 步骤2：结论写入本 FEAT 维护章节（AC-01 记录）
- [ ] 若失败 → 退回阶段 3
- **⏸️ 停等：人确认后进入阶段 5**

### 🔴 阶段 5：审查（角色：Review Agent）
- **阶段目标**：独立审查——AC 逐条打勾
- 全部通过 → ✅ 回填「维护与调试」+ 父FEAT项目表 + INDEX + 维护地图
- 未通过 → 退回对应阶段并附意见

## 3. 傻瓜式操作单（照做即可）

### 3.0 物品/工具清单
- [ ] 核心板（已按 A1-01 接线、A1-02 验证通过）
- [ ] SSCOM（115200，COM 以设备管理器为准）
- [ ] 杜邦线 ×1（临时改 L/R 接线用）

### 3.1 档位A：L/R→GND（左声道，当前接线）
1. 上电，SSCOM 打开，确认串口出现 boot 三行 + `[n] max=xxxx`。
2. 对麦克风吹气 3 秒，观察 max：**记录数值范围：___ ~ ___**
3. 若 max 随吹气明显变化 → 左声道有数据；若恒 0 或恒定 → 查 §3.4。
4. **基准参照（A1-02 18:40 实测）**：安静 160~1606，吹气 2307~32767 多次打满。

### 3.2 档位B：L/R→3.3V（右声道）
1. **断电**，把 L/R 从 GND 改接到 3.3V（杜邦线）。
2. 上电，SSCOM 观察，吹气 3 秒：**记录数值范围：___ ~ ___**
3. **v10 判读标准**：
   - 预期 max 掉到底噪水平（几十~几百）且吹气**无响应** → 音频字已移位出 step-4 窗口 → **左声道唯一有效，结论固化，档位 A 恢复接线**
   - 若 max 仍随吹气大变化 → 按 §3.4 行 2 排查（接线未真正切换）
4. 对比两档：哪档 max 随声音变化 = 有效声道。

### 3.3 结论固化（记录到本 FEAT 维护章节）
- 有效声道：**左**（预期，待实验证实）/ 右
- 取数：v10 语义 = `extract_frame` 步进 4 取 `word[4k]` + `(int16_t)(raw & 0xFFFF)`（左声道模式实测标定，BUG-002 v10）
- 是否需要改代码：**否**（预期；两档都无数据或都有效 → 按 §3.4 排查后回阶段 3）

### 3.4 故障速查表
| 现象 | 可能原因 | 处理 |
|---|---|---|
| 两档 max 都恒 0 | 取数掩码错误 / SD 无输出 | 查 BUG-002；确认 SD 上拉；确认 A1-02 实际通过 |
| 两档 max 都随声音变 | 未真正切换 L/R（接线没换成功） | 断电重接，确认杜邦线接触 |
| 档位B 完全无数据 | 右声道本来无有效信号（正常现象） | 以档位A 为准，结论=左声道 |
| 吹气无反应 | 麦克风损坏 | 换模块（A1-01 §3.5） |

## 4. 验收标准（12 条）

### 功能验收
- [x] AC-01 明确记录有效声道 + 取数掩码，串口打印该声道数据稳定且非全 0
  **✅ 通过（2026-08-28 18:47~18:56 三组实验）**：
  - 档位 A（L/R→GND）：安静 max=292~2611，吹气 3441~32767 多次打满 → **左声道有效**
  - 档位 B（L/R→3.3V）：**max 恒 1**——与悬空字签名一致（0xFFFF→(int16_t)-1→abs=1），音频字移位出 step-4 窗口，佐证提取窗口为左声道标定
  - 悬空对照（L/R 拔线）：固件正常（max=72~1460），排除固件/串口/供电嫌疑
  - 收尾：L/R 已恢复 GND，吹气响应正常
- [x] AC-02 向后兼容（不破坏 A1-02 已通过链路）
  **✅ 通过**：全程无代码改动；恢复接线后链路复验正常

### 代码质量 / 安全红线 / 测试边界
- [x] AC-03 若改代码：编译通过（`build.bat` 无错误）→ **N/A（未改代码）**
- [x] AC-04 若改代码：无新增警告 → **N/A（未改代码）**
- [x] AC-05 结论已写入本 FEAT「维护与调试」章节 → **✅ 已写入 §5**
- [x] AC-06 ~ AC-12：不适用项标 **N/A**（纯验证步骤：无密钥/输入/新测试/覆盖率）

## 5. 维护与调试（阶段5通过后回填）

### 5.1 影响文件
| 文件 | 改动类型 | 说明 |
|---|---|---|
| （无代码改动） | — | 纯接线实验；取数逻辑维持 v10（步进 4 取 word[4k]） |

### 5.2 结论固化（生产配置）
- **有效声道：左（L/R→GND）**——档位 A/B/悬空三组实验互证
- **取数：`extract_frame` 步进 4 取 word[4k] + `(int16_t)(raw & 0xFFFF)`**（v10，为左声道标定，勿改）
- **档位 B 特征（备忘）**：L/R→3.3V 时 max 恒 1（悬空字签名），**非故障**，是右槽驱动的正常表现；若未来要用右声道，需重标提取窗口
- 接线务必插实：本次档位 B 首测零输出为杜邦线未插实，复插后正常（3.3V 排针无恙）

### 5.3 测试入口
- SSCOM 观察两档 max 对比（对应 AC-01）；判据：GND 档随声变 / 3.3V 档恒 1

## 6. 执行日志

| 时间 | 阶段 | 角色 | 摘要 | 遇阻 |
|---|---|---|---|---|
| 2026-08-28 | 阶段1 准备 | Dev Agent | A1-02 已通过（18:40）；当前实现 v10：extract_frame 步进 4 取 word[4k] 低 16 位，L/R→GND 左声道模式 | 无 |
| 2026-08-28 | 阶段2 设计 | Dev Agent | 操作单升级至 v10 语义：§1.4 事实包（4 字周期 + 档位 B 移位推论）；§3.2 判读标准（档位 B 无响应 = 左声道有效的证据）；§3.3 预期结论（左声道，不改代码） | 无 |
| 2026-08-28 | 阶段3 实现 | Dev Agent | 三组实验：档位 A（GND）安静 292~2611/吹气 3441~32767；档位 B（3.3V）首测零输出→复插后 max 恒 1；悬空对照固件正常 72~1460 | 杜邦线未插实致档位 B 首测零输出，复插解决 |
| 2026-08-28 | 阶段4 测试 | Test Agent | max 恒 1 = 悬空字签名（0xFFFF→-1→abs=1），音频移出 step-4 窗口，与 v10 预测一致；L/R 恢复 GND 复验正常 | 无 |
| 2026-08-28 | 阶段5 审查 | Review Agent | AC-01/02/05 ✅、AC-03/04/06~12 N/A。结论：左声道（L/R→GND）唯一有效，取数维持 v10 勿改，无代码改动 | 无 |
