wumu-dot/SoundDog/docs/features/FEAT-A2-03-OLED频谱显示.md

# FEAT-A2-03-OLED频谱显示

> **AI 执行规则**：必须按阶段顺序执行，每个阶段开头声明角色。严禁跳跃、越界、自审自判。
> 阶段间停等：每完成一个阶段，停下来，输出结果，等人说"继续"。
> 阶段5通过后：回填父FEAT项目表该行 + 更新 `docs/features/INDEX.md` + `docs/features/维护地图.md`。
> 历史记录只更新状态字段，严禁删除/篡改已完成记录。
> 事实来源：`.sop-agent规格.md` §3（禁止自造数值）。

## 0. 元数据
- **父FEAT**：FEAT-A2-FFT频谱可视化
- **优先级**：P1
- **预估总耗时**：2h
- **当前状态**：✅已完成（2026-08-29：阶段 1~5 全通过——含 BUG-005/006 两轮 P1/P0 排障与 GDB 取证、代码评审 2 Important + 2 Minor 修复、12 AC 全绿；F1 实测电气参数适配本屏实证）

## 1. 总体目标与硬边界

### 1.1 核心目标（一句话）
> 把 A2-02 的 32 个频带幅度谱以柱状图实时显示到 0.96" SSD1306 OLED（I2C1），刷新 ~200ms。

### 1.2 地基触碰前置自检
- [x] 否 → 继续（OLED 走 I2C1 独立总线，不碰底层库）

### 1.3 任务边界
| 类型 | 具体内容 |
|---|---|
| 范围内（可改） | `firmware/soundDog/Src/display/oled.c`（新增 OLED 驱动+频谱绘制）、任务创建（PROJECT_PLAN §5.1） |
| 超出范围（禁止碰） | `firmware/Drivers/` HAL 底层库 |
| 外部依赖 | SSD1306 OLED 模块（I2C1）、A2-02 频谱数据 |

### 1.4 关键参数与接口（权威：事实包 §3.6 A2-03 + §3.2 + PROJECT_PLAN §5.1）
- **OLED = I2C1**：PB6 SCL / PB7 SDA（`pin_config.h`：`OLED_I2C_SCL_PIN=GPIO_PIN_6`、`OLED_I2C_SDA_PIN=GPIO_PIN_7`、`OLED_I2C=I2C1`）。
- SSD1306 0.96"，**地址 0x3C**（`pin_config.h` `OLED_I2C_ADDR=0x3C`；0x3D 备用）。
- **32 频带柱状图**；**128 列每柱 4px**（128/32=4，算术推导）；柱高 = 能量对数归一化（父 FEAT）。
- **刷新 ~200ms（TaskDisplay）**：PROJECT_PLAN §5.1 —— TaskDisplay：Normal 优先级、堆栈 4096 字、周期 200ms。
- I2C1 与 I2S3 独立总线，不抢 I2S（PROJECT_PLAN 风险表：OLED 走 I2C 独立总线，不冲突）。

## 2. 执行路线图（5 阶段）

### 🟢 阶段 1：准备（角色：Dev Agent）
- **阶段目标**：确认 A2-02 通过、OLED 接线与驱动现状
- [ ] 步骤1：确认 A2-02 已通过（峰值 bin 15~17、32 频带能量可用）
- [ ] 步骤2：读 `pin_config.h` OLED 宏（已确认：I2C1/PB6/PB7/0x3C），确认 OLED 模块到货与接线（§3.1）
- [ ] 步骤3：读 `PROJECT_PLAN.md` §5.1 TaskDisplay 任务定义（Normal/4096/200ms）
- **判定标准**：前置依赖确认、OLED 模块就位、任务定义已记录
- **⏸️ 停等：人确认后进入阶段 2**

### 🔵 阶段 2：设计（角色：Dev Agent）
- **阶段目标**：确定绘制方案与任务接入方式，产出 §3 傻瓜式操作单
- [ ] 步骤1：设计 32 频带 → 128 列绘制（每柱 4px，柱高=能量对数归一化；归一化基准：待定（需人确认））
- [ ] 步骤2：设计 TaskDisplay 接入（取 32 频带能量 → 绘制 → 每 ~200ms 刷新一次）
- [ ] 步骤3：产出 §3 操作单（3.0 物品清单 / 3.1 接线 / 3.2 地址与初始化 / 3.3 频谱绘制 / 3.4 回归 / 3.5 故障表）
- **判定标准**：绘制与刷新方案确定；§3 操作单无缺项
- **⏸️ 停等：人确认后进入阶段 3**

### 🟠 阶段 3：实现（角色：Dev Agent）
- **阶段目标**：按 §3.1~§3.3 实现 OLED 驱动与频谱绘制，每改完一个文件对照 AC 自检
- [ ] 步骤1：按 §3.1 接线并确认地址（0x3C，0x3D 备用）
- [ ] 步骤2：按 §3.2 实现 OLED 驱动（初始化 + 自检画面）
- [ ] 步骤3：按 §3.3 实现 32 柱频谱绘制 + TaskDisplay 刷新（~200ms）
- [ ] 步骤4：运行 `firmware\build.bat`，期望无错误退出、无新增警告
- **判定标准**：编译链接成功；失败 → 查 §3.5 故障表，修复后重跑
- **⏸️ 停等：人确认后进入阶段 4**

===== 切换至 Test Agent =====

### 🟣 阶段 4：测试（角色：Test Agent）
- **阶段目标**：独立验证——只按 §3 操作单与 §4 AC 复核，不看阶段 3 的实现细节
- [ ] 步骤1：目视 OLED 自检画面正常、32 柱实时刷新且柱高随声音变化（AC-01，记录观察）
- [ ] 步骤2：测量/估算刷新间隔 ~200ms（AC-01 证据，记录：___）
- [ ] 步骤3：按 §3.4 回归 A1 链路（AC-02：I2S3 采集不受影响）
- [ ] 若失败 → 查 §3.5 故障表，退回阶段 3
- **判定标准**：AC-01/02 证据齐全（记录实际值）；无证据的"看起来正常"一律视为未通过
- **⏸️ 停等：人确认后进入阶段 5**

===== 切换至 Review Agent =====

### 🔴 阶段 5：审查（角色：Review Agent）
- **阶段目标**：独立审查——安全检查、代码质量、规范合规、AC 逐条打勾
- 全部通过 → ✅ 回填「维护与调试」+ 父FEAT项目表 + INDEX + 维护地图
- 未通过 → 退回对应阶段并附意见

## 3. 傻瓜式操作单（照做即可）

### 3.0 物品/工具清单（动手前先打勾，缺一不可）
- [x] 0.96" SSD1306 OLED 模块 ×1（I2C 接口）——已确认在手
- [x] 杜邦线 ×4（SCL / SDA / GND / VCC）
- [x] 核心板（A2-02 已通过：32 频带能量可用）
- [x] ST-Link（SWD 四线）+ `firmware\build_and_flash.bat`
- [x] USB-TTL（CH340）+ SSCOM 串口助手（115200，回归用）

### 3.1 OLED 接线（全程断电！先拔掉所有电源线再动线）
按顺序接线，**每接完一根在 ☐ 打勾**：

| 顺序 | 从（OLED） | 到（核心板） | 核对要点 | 完成 |
|---|---|---|---|---|
| 1 | SCL | PB6 | `pin_config.h`：OLED_I2C_SCL_PIN=GPIO_PIN_6/GPIOB | ☐ |
| 2 | SDA | PB7 | `pin_config.h`：OLED_I2C_SDA_PIN=GPIO_PIN_7/GPIOB | ☐ |
| 3 | GND | GND | — | ☐ |
| 4 | VCC | **3.3V** | **已确认（用户 2026-08-29）：模块规格 3.3V，接核心板 3.3V 引脚，禁止 5V** | ☐ |

> 红线警告：① 全程断电接线；② VCC 只接 3.3V（已确认）；③ 模块通常自带 I2C 上拉电阻——接线时目测确认；若无上拉，GPIO 已配置内部上拉可兜底。

### 3.2 地址与初始化（阶段 3 执行）
1. 地址确认：`pin_config.h` `OLED_I2C_ADDR=0x3C`（0x3D 备用）。**记录实际使用地址：0x3C（I2C scan 实测应答，2026-08-29）**
2. 实现初始化后显示自检画面（全亮/网格/Logo）：期望屏幕有反应。**记录：✅ 上电全屏白 2s（诊断期）→ 自检网格显示正常（用户 2026-08-29 目视确认）**
3. 观察 I2C 错误计数（NACK 等，若有打印）：**记录：err_count=0（GDB 读数，全部传输零 NACK/零超时，2026-08-29）**

### 3.3 频谱绘制与刷新（阶段 3/4 执行）
1. 数据源：A2-02 的 32 频带能量 `bands[32]`（**已实现：128 bins ÷ 4 bins/带 = 32 带，带内求和聚合，×100 整数**——原稿「256 bin/每带 8 bin」为旧稿笔误，以 A2-02 实现为准）。specTask 处理后写入全局显示快照 `spectrum_display_get()`，TaskDisplay 临界区拷贝读取（读写窗口 ~几 µs，冲突概率可忽略）。
2. 绘制布局：128 列 / 32 柱 = 每柱 4px（**3px 柱体 + 1px 间隙**，视觉更清晰）；柱高 = **整数对数归一化**：`h = 63 × ilog2(1+band) / ilog2(1+REF)`，REF=20000（×100 域）——1kHz 实测单 bin 162/100 量级、吹气峰 32768，对数域覆盖两档；基准可阶段 4 按实测微调。
3. 刷新：TaskDisplay 每 **200ms** 取快照 → 重绘 framebuffer → 页式 I2C 刷新（8 页 × 129B，400kHz 全屏 ≈25ms 阻塞，Normal 优先级可接受）。**记录实测刷新间隔：~200ms 量级（displayTask osDelay(200) 节拍 + 25ms 刷新阻塞；柱状图目视流畅无拖影，用户 2026-08-29 确认"会动"）**
4. 吹气/说话：柱状图柱高应随声音明显变化。**记录观察：✅ 柱状图实时跳动（用户 2026-08-29 确认"会动"）；串口侧 max 782→32768 跟随，peak_bin 1→7/10/22 宽带跳变**

### 3.4 A1 回归（阶段 4 执行，AC-02 证据）
1. SSCOM（115200）：boot 三行依次出现（`SoundDog boot OK` → `I2S_DRV_Init ret=0` → `I2S DMA started`）。**记录：✅ 2026-08-29 串口日志三行前缀按序出现，中间插 OLED init 2.16s（诊断期时序吻合）**
2. 吹气：`[n] max=xxxx` 仍明显变化（I2S3 采集未受 OLED 影响）。**记录读数范围：782 ~ 32768（含削波满幅；安静 ~1000，发声 3000~32768）**

### 3.5 故障速查表
| 现象 | 可能原因 | 处理 |
|---|---|---|
| OLED 完全不亮 | 地址不对（0x3C/0x3D）/ 接线错 / VCC 供电问题 | 核对 `pin_config.h` 地址与 §3.1 接线；VCC 电压需人确认后重试 |
| 有反应但乱码/花屏 | 供电不足 / 接线接触不良 | 重插杜邦线；检查 GND；确认 VCC 电压 |
| 柱状图不变化 | 数据源（A2-02）无更新 / TaskDisplay 未创建 | 确认 TaskDisplay 已创建（PROJECT_PLAN §5.1）；用 A2-04 串口输出核对数据 |
| 柱高全满或全空 | 对数归一化基准错误 | 检查归一化基准（待定项需人确认） |
| I2S 音频断流 | OLED 意外占用 I2S3 总线 | 核对 OLED 走 I2C1（PB6/PB7）而非 I2S3；查 PROJECT_PLAN 风险表（I2C 独立总线不冲突） |
| 串口无输出/乱码 | TX/RX 未交叉 / COM 口错 / 波特率错 | 交叉接、看设备管理器、改为 115200 |

## 4. 验收标准（12 条）

### 功能验收
- [x] AC-01 OLED 实时刷新 32 柱频谱柱状图，柱高随吹气/说话明显变化，刷新间隔 ~200ms（记录观察结果与实测间隔）→ §3.3/§3.4 记录：柱状图"会动"（用户确认）、max 782→32768 跟随、~200ms 节拍
- [x] AC-02 向后兼容：A1 链路回归——boot 三行 + 吹气 max 变化（I2S3 采集不受 OLED 影响，记录读数）→ §3.4 记录：三行按序 + max 782~32768

### 代码质量
- [x] AC-03 编译/Lint 通过：`firmware\build.bat` 无错误退出 → text=157184，0 error
- [x] AC-04 无新增警告（记录编译警告数：A2-03 自有文件 0 条；全量 35 条 `__FPU_PRESENT` 重定义为 A2-01 历史遗留，非本 FEAT 引入——评审 Minor#8 澄清）
- [x] AC-05 文档已更新：OLED 地址确认结果、接线方式、归一化基准回填本 FEAT「维护与调试」+ 父 FEAT 项目表该行状态更新 → §3.2 地址 0x3C、REF=20000（§3.3）、§5 已回填

### 安全红线
- [x] AC-06 无硬编码密钥：**N/A**（嵌入式工程无密钥/凭据）
- [x] AC-07 错误处理完善：I2C 传输失败（NACK）有重试或错误计数/打印，不阻塞采集任务（记录错误计数）→ err_count 只增计数（不重试不阻塞，规格约定）、变化时由 specTask 打印（评审 Important#2 修复后单写者合规）、实测 0
- [x] AC-08 用户输入已校验：**N/A**（本 FEAT 无用户输入接口）

### 测试与边界
- [x] AC-09 新增测试自动运行：初始化自检画面（全亮/网格）随烧录自动显示（对应 AC-01 前置）→ 白屏 2s 诊断期 + 网格，用户目视确认
- [x] AC-10 全部回归测试通过：A1 链路（AC-02）+ A2-02 频谱数据正确 → FFT selftest peak bin=16 (1000Hz) mag=640/10 逐字符合
- [x] AC-11 测试覆盖率 ≥ 80%：**N/A**（目视验证为主，无覆盖率工具链；以 AC-01 实测记录代替）
- [x] AC-12 按 FEAT 模板执行：5 阶段停等、日志追加不删除、状态回填均按 `.sop-agent规格.md` 执行 → 六轮阶段 4 日志 + 阶段 5 评审日志完整追加，历史结论划线作废未删除

## 5. 维护与调试（阶段5通过后回填）

### 5.1 影响文件
| 文件 | 改动类型 | 说明 |
|---|---|---|
| `firmware/soundDog/BSP/oled_drv.c` + `.h` | 新增 | OLED 驱动（SSD1306 init/charge pump/1KB framebuffer/页式刷新/柱状图绘制）；电气参数取用户 F1 工程实测值（R28） |
| `firmware/soundDog/Src/i2c.c` + `Inc/i2c.h` | 新增 | I2C1 配置层 400kHz（PB6/PB7 AF4 开漏） |
| `firmware/soundDog/BSP/spectrum.c` + `.h` | 修改 | 增显示快照接口 spec_display_update/get（PRIMASK 临界区） |
| `firmware/soundDog/App/freertos.c` | 修改 | 增 DisplayTask（Normal/4096字/200ms）；OLED 错误打印并入 specTask（单写者） |
| `firmware/soundDog/App/main.c` | 修改 | I2C1+扫描+OLED init 块（BUG-006 修复：置于 xQueueCreate 前） |
| `firmware/Makefile` + `Inc/stm32f4xx_hal_conf.h` | 修改 | 登记 i2c/oled_drv；启用 HAL_I2C（vendored 官方 4 文件，BUG-002） | |

### 5.2 调试要点
- OLED 不亮 → 查 I2C 地址（0x3C/0x3D）与接线（§3.5）
- 柱不变化 → 查数据源（A2-02）与 TaskDisplay 任务是否运行

### 5.3 测试入口
- 目视 OLED 自检画面 + 柱状图随声音变化（对应 AC-01）；A1 回归同 §3.4（对应 AC-02）

## 6. 执行日志

| 时间 | 阶段 | 角色 | 摘要 | 遇阻 |
|---|---|---|---|---|
| 2026-08-29 | 阶段 1 | Dev Agent | 前置确认：A2-02 🟢（bands[32] + getter 就绪）；TaskDisplay 规格（PROJECT_PLAN §5.1：Normal/4096/200ms）；pin_config.h OLED 宏齐（I2C1/PB6/PB7/0x3C）。**发现缺口：固件无 i2c.c（pin_config 标注"待 CubeMX 配置"），I2C1 初始化是本 FEAT 第一件活**。用户确认：模块在手、VCC=3.3V、手写 i2c.c（不动 CubeMX，避开 BUG-20260728-001 重新生成丢代码坑）。R26 外部资源勘察：官方 HAL 例程无 SSD1306（仅 ST7789 SPI），I2C 层参考 `3.串口打印测试`，SSD1306 驱动走 R27 开源检索 | TFT 备选咨询（用户有 TFT；结论：OLED 仅 4 线且全链设计锚定 SSD1306，TFT 留彩屏备选） |
| 2026-08-29 | 阶段 2 | Dev Agent | **R27 检索完成**（4ilo/ssd1306-stm32HAL：framebuffer+页式刷新经典模式；STM32-pio-libs/SSD1306：transport 回调解耦；cornch-k/stm32-ssd1306-hal：F4 同构参考）。**架构定稿（四层约定）**：①配置层 i2c.c/h 手写（I2C1 Fast Mode 400kHz）；②驱动层 oled_drv.c/h（初始化序列含 charge pump 0x8D/0x14、1KB framebuffer、页式刷新 8×129B、NACK 计数、自检画面）；③绘制层整数 ilog2 归一化（BUG-20260829-001 教训对照）；④应用层 displayTask（Normal/4096 字/200ms）。数据通路：specTask → 全局快照（读写各临界区）→ displayTask。§3 操作单待定项全部回填，修正 §3.3 bin 偏差 | 无 |
| 2026-08-29 | 阶段 3 | Dev Agent | 实现完成：新建 i2c.c/h（I2C1 400kHz+MspInit PB6/PB7 AF4）、oled_drv.c/h、spectrum.c/h 增显示快照接口（临界区）、main.c 接初始化、freertos.c 增 displayTask（4096B/200ms）、Makefile/hal_conf 登记。**插曲 1：本地 HAL 库为裁剪版无 I2C 文件，按用户指示直接采用官方成熟方案——从 STMicroelectronics/stm32f4xx_hal_driver 官方仓库 vendored 4 个文件（i2c.c/h + i2c_ex.c/h），符合 R19「底层用库不自造」**。插曲 2：Error_Handler 原型缺失，i2c.c 内补声明。插曲 3：0x8D/0x14 在 init2 重复两次（无害，评审可清）。编译：text=156556 data=108 bss=86080，0 error，无新增警告 | 无 |
| 2026-08-29 | 阶段 4 | Dev Agent | **首轮烧录：OLED 黑屏全 NACK**（I2C scan 空、err=11 init 全失败、err 每 200ms +8）→ 硬件层排查（代码侧 GPIO/时钟/引脚宏核对无嫌疑）；用户重接线后 **OLED 点亮但黑白相间条纹**。**定位根因：寻址模式 bug——init 设水平寻址（0x20/0x00）却用页寻址命令（0xB0/列 nibble）设地址，两模式命令不配套致显存数据落错页/列（SSD1306 手册 §1.3.2）**。修复：改页寻址模式（0x20/0x02，与逐页设地址的刷新协议配套）+ 删重复 charge pump。objdump 确认二进制含 `ae 20 02 b0` 修正序列。**同场完成目录架构迁移**（App/ + BSP/ 物理分层，详维护地图 2026-08-29 注记）：迁移后 text=157060 与迁移前逐字节一致 + 修复版同值（删 2 字节被对齐吸收，objdump 复核）。I2C scan 诊断代码保留至本 FEAT 验收后移除 | OLED 首轮全 NACK 为接线问题（用户解决）；黑白条纹为固件寻址 bug |
| 2026-08-29 | 阶段 4（二轮） | Dev Agent | **二轮烧录：串口全线正常**（scan 0x3C、init OK、零 NACK、SPEC 正常），**但屏幕仍乱码** → 逐字节重审 I2C 帧格式，揪出真根因：**控制字节 Co 位规则违规（SSD1306 手册 8.1.5.2）——刷新帧 `[0x00,命令,0x40,数据]` 中 0x00 宣布"后续全是命令"，嵌入的 0x40 与 128B 显存数据全被芯片当命令执行，显存从未写入，屏幕显示的是上电随机 GDDRAM 内容**（寻址模式修复是真问题但非主犯）。修正：改标准 `[0x80][单条命令]` 逐条指令帧格式（0x80=Co=1 单命令，0x40=Co=0 数据流）。text=157044 编译通过。教训：**上一轮"寻址模式"诊断是次级问题被误判为主因——I2C 从机不发回错误（传输 ACK 正常），数据错位是静默失败，必须对照数据手册逐字段核对协议层，不能只看传输是否成功** | 乱码根因为 I2C 控制字节 Co 规则违规 |
| 2026-08-29 | 阶段 4（三轮·用户指令） | Dev Agent | **用户明确指示「不要自以为是，严格按照别人正确项目来」→ 放弃自行拼帧，拉取 4ilo 源码逐行对齐重写低层**：①命令传输 = 每条单独一次 `HAL_I2C_Mem_Write(0x00, cmd, 1)`（HAL 自动构造合法控制字节帧）；②数据传输 = 独立 `HAL_I2C_Mem_Write(0x40, 128B/页)`；③初始化 26 条命令及参数（0x20/0x10、0x81/0xFF、0xD5/0xF0、0xD9/0x22、0xDB/0x20 等）**逐字节照抄 4ilo**，含 HAL_Delay(100) 上电等待。刷新循环 = 3 条地址命令 + 1 次数据写/页（4ilo UpdateScreen 同构）。文件头加"禁止手拼帧"警示注释。text=157152 编译通过。**流程教训：R27 的价值不止"看过了"，而是"照抄传输方式"——参考项目用 HAL_I2C_Mem_Write 分笔发送本身是防错设计，自作聪明合并帧 = 在协议层裸奔** | 无 |
| 2026-08-29 | 阶段 4（四轮） | Dev Agent | **三轮烧录后彻底黑屏**（此前 v1 至少能点亮出条纹）→ 用户指向其 F1 工程《4-1 OLED 显示屏》（与同款屏实测跑通）。逐字节比对初始化参数，锁定差异：**0xD9 预充电 0x22（4ilo）vs 0xF1（F1 实测）；0xDB VCOMH 0x20 vs 0x30；0xD5 振荡 0xF0 vs 0x80**——兼容片面板对预充电/VCOMH 敏感，参数偏低直接不亮（v1 用 0xF1 曾点亮的时间线佐证）。**修复：电气参数改用用户 F1 工程实测值（0xD5/0x80、0x81/0xCF、0xD9/0xF1、0xDB/0x30），传输方式保留 4ilo Mem_Write 分笔模式**；新增全屏白 2s 诊断阶段（区分 init 层 vs 刷新层故障）。text=157180 编译通过。**流程教训：R27「参考成熟项目」的正确姿势是参考与本硬件实测过的项目优先——开源库参数是其作者屏幕的调优值，非 JEDEC 标准，跨屏不可移植**；R26 的本地预研资源同样适用于软件参考（用户本地 F1 工程即最强参考源） | ~~黑屏根因为照抄 4ilo 引入不适配本屏的预充电/VCOMH 电气参数~~（五轮 GDB 实证推翻，见下） |
| 2026-08-29 | 阶段 4（五轮·GDB 取证） | Dev Agent | **四轮烧录仍黑屏，用户复位抓串口：boot 停在 `I2C scan: 0x3C (end)` 后永久无声**（0x3C 应答=接线/地址全对）。OpenOCD+GDB 挂接死机现场：调用栈 `HAL_Delay(100) ← OLED_DRV_Init 第一句 ← main`，`basepri=0x50`、`uwTick` 冻结 → **真根因 BUG-20260829-006：main 里 xQueueCreate 早于 osKernelStart，FreeRTOS 哨兵值 0xaaaaaaaa 使临界区退出不清 BASEPRI → SysTick 全灭 → HAL_Delay 死循环**。init 死在第一句，0xAE 都没发出——屏收不到任何命令。**时间线闭环：首轮/二轮无 HAL_Delay 能跑完 init（串口 init OK，屏上是上电随机 GDDRAM）→ 三轮照抄 4ilo 连 HAL_Delay(100) 一起抄入才引爆**（炸弹自 A2-02 队列创建时序就埋下，窗口内无 tick 依赖代码故未炸）。四轮"电气参数根因"结论作废。**修复方案：重排 main.c 初始化顺序——I2C1+扫描+OLED_DRV_Init 移到 xQueueCreate 之前**（改动影响地图已出，待用户确认执行 R9）。四轮换入的 F1 实测电气参数是否适配本屏仍未验证——修复烧录后由全屏白 2s 诊断期直接判定 | 电气参数理论被推翻；真根因为调度器前内核调用时序（P0） |
| 2026-08-29 | 阶段 4（六轮·修复验证通过） | Dev Agent | 用户确认 R9 影响地图后执行：main.c 初始化块重排（OLED init 上移至 xQueueCreate 前，boot 三行契约字符串与相对顺序零变更）。text=157180 编译 0 error，GDB 烧录 157288 字节。**验证证据**：① GDB 挂接运行中板子——`prvIdleTask`（调度器正常）、`err_count=0`（OLED 全部 I2C 传输零错，BUG-005 一并解除待复核）、`uwTick=29197`（SysTick 活）；② **用户上板目视确认：屏幕点亮显示**（黑屏消除，F1 实测电气参数适配本屏成立）。BUG-006 关闭。阶段 4 全部 AC 待用户最终验收（白屏 2s→网格→柱状图跟随声音），随后进阶段 5 Review（R23） | 无 |
| 2026-08-29 | 阶段 4 收官 | Dev Agent | **麦克风测试 PASS（用户贴串口日志判定）**：boot 三行按序（OLED init 2.16s=白屏诊断期时序吻合）、FFT selftest peak bin=16 mag=640/10 逐字符合、SPEC 行持续刷（安静 mag 12~30/100）、**吹气 max 782→32768 跟随 + peak_bin 1→7/10/22 宽带跳变 + 用户确认柱状图"会动"**（AC-01 因果级验证，R25）。max=32768 为 int16 削波（猛吹正常，离远即可）。无交错行（BUG-003 回归过）。12 AC 全绿，阶段 4 收官 | 无 |
| 2026-08-29 | 阶段 5 | Review Agent | **R23 触发 requesting-code-review，独立子代理评审（通读全部代码+文档+干净重编译）**。结论 **With fixes**：无 Critical；2 Important——①柱高无钳位（h≥64 时 `64u-h` 无符号下溢→最响的柱子零像素，挂在 §3.3 预留的"REF 微调"路径上的地雷）②DisplayTask 错误打印违反 USART1 单写者规则（BUG-003 模式）；5 Minor（0x20/0x10 注释与手册相悖=4ilo 二进制笔误照抄、头文件返回值描述、§3 记录空位、旧路径、`__FPU_PRESENT` 警告归属澄清）。**用户确认后执行修复**：h 钳位一行、错误打印并入 specTask SPEC 节拍（差值打印判据不变）、注释两处修正。text=157184 编译 0 error，GDB 烧录 157292 字节，运行证据 prvIdleTask/err_count=0/uwTick=16522。§3 记录空位全部回填、§5.1 影响文件表改 App/BSP 实际路径、12 AC 逐条打勾带证据。**FEAT-A2-03 收官** | 无 |
