wumu-dot/SoundDog/docs/features/FEAT-A5-03-PC端收发验证.md

# FEAT-A5-03-PC端收发验证

> **AI 执行规则**：必须按阶段顺序执行，每个阶段开头声明角色。严禁跳跃、越界、自审自判。
> 阶段间停等：每完成一个阶段，停下来，输出结果，等人说"继续"。
> 阶段5通过后：回填父FEAT项目表该行 + 更新 `docs/features/INDEX.md` + `docs/features/维护地图.md`。
> 历史记录只更新状态字段，严禁删除/篡改已完成记录。
> 事实来源：`.sop-agent规格.md` §3（禁止自造数值；未覆盖项写"待定（需人确认）"）。

## 0. 元数据
- **父FEAT**：FEAT-A5-RS485通信
- **优先级**：P1
- **预估总耗时**：2h（父FEAT 预算 8h 内拆分）
- **当前状态**：🔴未开始（傻瓜式操作单已备好，依赖 A5-02 通过后开跑）

## 1. 总体目标与硬边界

### 1.1 核心目标（一句话）
> 用第二块 TTL-RS485 模块(3.3V/SP3485) 接 PC 端 USB-TTL(CH340)，与板端模块 **A↔A、B↔B 对接**，实现 PC ↔ 板**双向收发无误码**，验证 A5-02 协议帧在真实 RS485 总线上的可用性。

### 1.2 地基触碰前置自检
- [x] 否 → 继续（验证链路 + 可能的板端小改动，不碰 `firmware/Drivers/`）

### 1.3 任务边界
| 类型 | 具体内容 |
|---|---|
| 范围内（可改） | 板端验证代码/打印（如需）、PC 端串口工具操作 |
| 超出范围（禁止碰） | `firmware/Drivers/` HAL 底层库；模块内部电路 |
| 外部依赖 | 第二块 TTL-RS485 模块(3.3V/SP3485)、USB-TTL(CH340)、SSCOM/串口助手、PC |

### 1.4 关键参数与接口（事实包 §3，禁止自造）
- **硬件拓扑**（用户确认）：两块 TTL-RS485 模块(3.3V/SP3485，引脚 **EN/VCC/A/B/GND×2/RXD/TXD**)——板端模块接板子 **USART3**（PD8/PD9，A5-01 已接）；PC 端模块接 **USB-TTL(CH340)**；两模块之间 **A↔A、B↔B** 对接。
- **模块接线**：PC 端模块 **RXD ← USB-TTL TX**、**TXD → USB-TTL RX**、**EN ← 方向控制**（高=发送/低=接收，方式待定（需人确认））；VCC 只准 3.3V。
- **半双工**：双向收发，**同一时刻只允许一端发送**（事实包 A5-01）。
- **波特率**：RS485 总线 **115200**（`RS485_UART_BAUD`）；板端调试口 USART1 也是 115200，注意区分两个 COM。
- **验收**：**双向收发无误码**（事实包 A5-03）。
- **待定（需人确认）**：
  - PC 端模块供电方案：模块 VCC 需 3.3V（SP3485 为 3.3V 器件）；若 USB-TTL 无 3.3V 输出或输出能力不足 → 供电方案待定（需人确认）。
  - PC 端 EN 控制方式：USB-TTL 的 RTS/DTR 接 EN，或软件控制，或手动跳线（EN 恒高=发送）——方式待定（需人确认）。
  - 若 USB-TTL 输出为 5V TTL 电平 → 是否需电平适配（待定，需人确认）。
  - 自动测试脚本路径（待定（需人确认））。

## 2. 执行路线图（5 阶段）

### 🟢 阶段 1：准备（角色：Dev Agent）
- **读什么**：A5-01 文档（板端接线/驱动）、`pin_config.h`（RS485 宏）、`CLAUDE.md`（硬边界）、`HANDOFF.md` §4.2（接线规范）
- [ ] 步骤1：确认 A5-02 已通过（协议帧可用）
- [ ] 步骤2：看 PC 端模块丝印（EN/VCC/A/B/GND×2/RXD/TXD）并记录；确认 USB-TTL 输出电平与 3.3V 能力
- [ ] 步骤3：输出影响范围（接线 / 板端验证代码 / PC 端工具）
- **判定标准**：A5-02 状态已核实、PC 端模块类型与供电方案已明确（未明确项列入待定）
- **⏸️ 停等：人确认后进入阶段 2**

### 🔵 阶段 2：设计（角色：Dev Agent）
- **阶段目标**：产出接线与双向收发验证操作单（§3）
- [ ] 步骤1：设计 PC 端模块接线（含 EN 控制方案，待定项需人确认）
- [ ] 步骤2：设计双向收发与误码统计步骤（PC→板 / 板→PC 各 1000 字节）
- [ ] 步骤3：设计半双工错开发送规则
- **判定标准**：接线表已产出、验证步骤已产出、待定项已列全
- **⏸️ 停等：人确认后进入阶段 3**

### 🟠 阶段 3：实现（角色：Dev Agent）
- **阶段目标**：按 §3.1 接线 + 准备板端验证代码（如需）
- [ ] 步骤1：按 §3.1 **断电**接线并逐根打勾
- [ ] 步骤2：板端如需收发/统计代码 → 实现后 `firmware\build.bat` 编译通过、`build_and_flash.bat` 烧录
- **判定标准**：接线完成、编译烧录通过
- **⏸️ 停等：人确认后进入阶段 4**

===== 切换至 Test Agent =====

### 🟣 阶段 4：测试（角色：Test Agent）
- **阶段目标**：独立验证——按 §3 操作单跑双向收发，核对 §4 验收标准
- [ ] 步骤1：按 §3.2 PC→板 1000 字节误码统计（AC-01）
- [ ] 步骤2：按 §3.3 板→PC 1000 字节误码统计（AC-01）
- [ ] 步骤3：核对两个 COM 不串台（CH340 RS485 口 vs USART1 调试口）
- [ ] 若失败 → 查 §3.4 故障速查表，退回阶段 3
- **⏸️ 停等：人确认后进入阶段 5**

===== 切换至 Review Agent =====

### 🔴 阶段 5：审查（角色：Review Agent）
- **阶段目标**：独立审查——AC 逐条打勾、双向拓扑与 A5-01/02 一致
- [ ] 步骤1：核对 §4 全部 AC 勾选与记录值（双向 1000 字节误码）
- [ ] 步骤2：核对 A↔A/B↔B 对接、EN 方向控制（高=发送/低=接收）与半双工规则合规
- **判定标准**：AC 全部通过且记录值完整
- 全部通过 → ✅ 回填「维护与调试」+ 父FEAT项目表 + INDEX + 维护地图
- 未通过 → 退回对应阶段并附意见
- **⏸️ 停等：人确认 Review 通过后归档**

## 3. 傻瓜式操作单（照做即可）

### 3.0 物品/工具清单
- [ ] 核心板（A5-01 已接好板端 RS485 模块；A5-02 已通过）
- [ ] 第二块 TTL-RS485 模块(3.3V/SP3485) ×1（PC 端）
- [ ] USB-TTL（CH340）×1
- [ ] 杜邦线 ×8 以上
- [ ] SSCOM 或任意串口助手（操作 CH340 的 COM 口，115200）
- [ ] 5V 电源（非快充）

### 3.1 接线（全程断电！先拔掉所有电源线再动线）
**红线**：模块 VCC **只准 3.3V**（SP3485 为 3.3V 器件）；两模块 A/B 对接 **A↔A、B↔B**，接反则收发失败；若 A5-01 回环测试时曾短接 A/B，先拆除短接线。

**第 1 步：PC 端模块 ← USB-TTL(CH340)**

| 顺序 | 从（PC 端 RS485 模块） | 到（USB-TTL） | 核对要点 | 完成 |
|---|---|---|---|---|
| 1 | VCC | 3.3V（USB-TTL 的 3.3V 输出；若无或不足 → 供电方案待定（需人确认）） | ⚠️ 严禁 5V！ | ☐ |
| 2 | GND | GND | 必须共地 | ☐ |
| 3 | RXD | TX | ⚠️ 交叉：PC 发 → 模块收 | ☐ |
| 4 | TXD | RX | ⚠️ 交叉：模块发 → PC 收 | ☐ |
| 5 | EN | 方向控制（方式待定（需人确认）：RTS/DTR 或软件控制或手动跳线） | 高=发送 / 低=接收 | ☐ |

**第 2 步：两块模块对接**

| 顺序 | 从 | 到 | 核对要点 | 完成 |
|---|----|----|---|---|
| 1 | 板端模块 A | PC 端模块 A | ⚠️ A↔A，勿接反 | ☐ |
| 2 | 板端模块 B | PC 端模块 B | ⚠️ B↔B，勿接反 | ☐ |

**第 3 步：COM 口确认**
- 设备管理器确认 PC 上出现 **两个** 与板相关的 COM：CH340（RS485 数据口）与 USART1 调试口。**本 FEAT 所有收发操作都在 CH340 的 COM 上**，调试观察在 USART1 的 COM 上。记录：CH340 COM 口：COM__；调试口 COM：COM__

### 3.2 验证 PC → 板（阶段 4 执行；半双工，一次只一端发）
1. SSCOM 打开 **CH340 的 COM**，波特率 **115200**。
2. 发送测试串（如 ASCII "PC2BOARD-1234567890"）→ 期望板端 USART1 调试口打印收到**相同内容**。
   记录：发送：______；板端收到：______
3. 误码统计：连续发送 100 字节 × 10 轮（共 1000 字节）→ 期望板端收到的 1000 字节与发送**逐字节一致，0 误码**。
   记录：PC→板 误码：___/1000
4. ⚠️ 每轮发送之间等板端确认收到后再发下一轮（半双工错开），避免总线冲突。

### 3.3 验证 板 → PC（阶段 4 执行）
1. 板端触发发送测试串（如 ASCII "BOARD2PC-1234567890"）→ 期望 SSCOM(CH340) 收到**相同内容**。
   记录：板端发送：______；PC 收到：______
2. 误码统计：板端连续发送 100 字节 × 10 轮（共 1000 字节）→ 期望 PC 收到 1000 字节**逐字节一致，0 误码**。
   记录：板→PC 误码：___/1000
3. ⚠️ 板端每轮发送后等 PC 确认再发下一轮。

### 3.4 故障速查表
| 现象 | 可能原因 | 处理 |
|---|---|---|
| 完全收不到 | A/B 接反 / RXD/TXD 接反 / COM 选错（用了调试口而非 CH340）/ 未共地 | 查 §3.1 三张表；确认操作 CH340 的 COM |
| 收到乱码 | 波特率不是 115200 / 接触不良 | 两端都改 115200；重插杜邦线 |
| 半双工冲突乱码 | 两端同时发送 | 改为一次只一端发，错开发送（§3.2 步骤4 / §3.3 步骤3） |
| 板端发不出 | 板端 DE/RE 未切换（A5-01 问题残留） | 查 A5-01 §3.4 |
| PC 端 EN 型发不出 | PC 端方向控制未实现 | 回报人确认方案（RTS/DTR 或软件控制或手动跳线），实现后重测 |
| 自动收发型模块偶尔丢字节 | 供电不足 / 总线无终端电阻 | 确认 VCC 3.3V 稳定；终端电阻需求待定（需人确认） |

## 4. 验收标准（12 条）

### 功能验收
- [ ] AC-01 双向收发无误码：PC→板 与 板→PC 各 1000 字节，误码均为 0（§3.2/§3.3 记录）
- [ ] AC-02 向后兼容：A5-02 协议帧在真实总线上可用，A5-01 回环不受影响

### 代码质量
- [ ] AC-03 若改板端代码：`firmware\build.bat` 编译通过
- [ ] AC-04 若改板端代码：无新增警告
- [ ] AC-05 文档已更新：接线拓扑与 COM 区分要点写入本 FEAT 维护章节

### 安全红线
- [ ] AC-06 N/A：无密钥
- [ ] AC-07 错误处理：误码/超时有统计记录（§3.2/§3.3 记录值）
- [ ] AC-08 N/A：验证链路，无用户输入处理（协议校验见 A5-02）

### 测试与边界
- [ ] AC-09 N/A：无自动测试框架；双向收发为手动验证（自动化脚本待定（需人确认））
- [ ] AC-10 回归：`./scripts/ci_local.sh` 通过（若适用）
- [ ] AC-11 N/A：嵌入式手动验证，覆盖率不适用
- [ ] AC-12 按 FEAT 模板执行（本文件即模板产物）

## 5. 维护与调试（阶段5通过后回填）

### 5.1 影响文件
| 文件 | 改动类型 | 说明 |
|---|---|---|
| 板端收发/统计代码（A5-01/A5-02 产物内） | 修改（如需） | 触发发送 + 接收回显 + 误码统计 |
| 接线（物理） | 修改 | 板端模块 A/B ↔ PC 端模块 A/B 对接（A↔A、B↔B） |

### 5.2 调试要点
- 记住两个 COM：CH340 = RS485 数据口，USART1 = 调试口，操作时选对
- 半双工：一次只一端发，发完等确认再发下一轮
- PC 端模块 EN（高=发送/低=接收）控制方式以人确认为准

### 5.3 测试入口
- §3.2 / §3.3 双向误码统计（对应 AC-01）

## 6. 执行日志

| 时间 | 阶段 | 角色 | 摘要 | 遇阻 |
|---|---|---|---|---|
| | | | | |
