wumu-dot/SoundDog/docs/features/FEAT-A6-02-绿灯状态.md

# FEAT-A6-02-绿灯状态

> **AI 执行规则**：必须按阶段顺序执行，每个阶段开头声明角色。严禁跳跃、越界、自审自判。
> 阶段间停等：每完成一个阶段，停下来，输出结果，等人说"继续"。
> 阶段5通过后：回填父FEAT项目表该行 + 更新 `docs/features/INDEX.md` + `docs/features/维护地图.md`。
> 历史记录只更新状态字段，严禁删除/篡改已完成记录。
> 事实来源：`.sop-agent规格.md` §3 + `firmware/soundDog/Inc/pin_config.h`（禁止自造数值；缺失一律写"待定（需人确认）"）。

## 0. 元数据
- **父FEAT**：FEAT-A6-报警输出
- **优先级**：P2
- **预估总耗时**：0.5h
- **当前状态**：🔴未开始（傻瓜式操作单已备好；依赖 A6-01 通过后开跑）

## 1. 总体目标与硬边界

### 1.1 核心目标（一句话）
> 用 TIM3_CH4（PB1）驱动绿灯：系统正常运行时**常亮**、故障时**灭**，与红灯报警（A6-01）互补，直观区分"工作中/出故障"。

### 1.2 地基触碰前置自检
- [x] 否 → 继续（TIM3/GPIO 配置与 App 层实现，不碰 `firmware/Drivers/` 底层库）

### 1.3 任务边界
| 类型 | 具体内容 |
|---|---|
| 范围内（可改） | TIM3_CH4 配置（CubeMX `soundDog.ioc` 或 USER CODE）、常亮/灭逻辑、`pin_config.h` 已有宏的使用 |
| 超出范围（禁止碰） | `firmware/Drivers/` HAL 底层库；引脚定义（改引脚只改 `pin_config.h`，本 FEAT 无需改） |
| 外部依赖 | A6-01 已通过（父FEAT 项目表：依赖 01）；系统故障标志（接口待定（需人确认））；绿灯 + 220Ω 限流电阻接线 |

### 1.4 关键参数与接口（事实包 §3 + pin_config.h，禁止自造）
- 引脚：**PB1 = TIM3_CH4**（宏 `LED_STATUS_PIN`/`LED_STATUS_PORT`=GPIOB、`LED_STATUS_CHANNEL`=TIM_CHANNEL_4，来源 pin_config.h）；**必须串 220Ω 限流电阻**（事实包 §3.2）。
- 两种状态：**正常常亮 / 故障灭**（事实包 §3.6 A6-02）。
- 实现方式（GPIO 高低电平 / PWM 占空 100%/0%）：**待定（需人确认）**（pin_config.h 注释：LED 当前按 GPIO 输出预留，TIM3 PWM 预留待 CubeMX 配置）。
- PWM 基频（若走 PWM）：`LED_PWM_FREQ=1000`（1kHz，pin_config.h）。
- 驱动源：系统状态/故障标志；接口形式：**待定（需人确认）**。
- 烧录期望：`firmware\build_and_flash.bat` 输出 `wrote ...` / `Verified OK`（事实包 §3.3）。

## 2. 执行路线图（5 阶段）

### 🟢 阶段 1：准备（角色：Dev Agent）
- **阶段目标**：确认前置条件与引脚/接口现状，输出影响范围
- [ ] 步骤1：确认 **A6-01 已通过**（红灯三模式验证记录在案，父FEAT 项目表状态 🟢）
- [ ] 步骤2：读 `CLAUDE.md`（硬边界）+ `firmware/soundDog/Inc/pin_config.h` + 本 FEAT §1.4
- [ ] 步骤3：确认故障标志来源（与 A6-01 共用 A4 判决信号？接口形式待定（需人确认））
- [ ] 步骤4：输出影响范围（新增/修改文件、接口变化、风险）
- **判定标准**：A6-01 已通过（否则本 FEAT 暂停）；影响范围清单已输出
- **⏸️ 停等：人确认后进入阶段 2**

### 🔵 阶段 2：设计（角色：Dev Agent）
- **阶段目标**：确定 正常→常亮 / 故障→灭 的映射与实现方式，产出 §3 操作单
- [ ] 步骤1：确定状态映射（系统正常=常亮、故障标志=灭；"故障"定义以 A4/系统状态为准：待定（需人确认））
- [ ] 步骤2：确定实现方式（GPIO 高低 / PWM 100%/0%）：待定（需人确认）
- [ ] 步骤3：产出 §3 傻瓜式操作单
- **判定标准**：映射表 + 实现方式确定；未定项显式标注"待定（需人确认）"
- **⏸️ 停等：人确认后进入阶段 3**

### 🟠 阶段 3：实现（角色：Dev Agent）
- **阶段目标**：接线（§3.1 上电前检查）→ 配置/编码 → 编译通过
- [ ] 步骤1：按 §3.1 完成绿灯接线与上电前检查（220Ω 串联、极性、无短路），逐行打勾
- [ ] 步骤2：配置 TIM3_CH4 或 GPIO 输出，编码 常亮/灭 逻辑
- [ ] 步骤3：运行 `firmware\build.bat`，无错误退出、无新增警告
- **判定标准**：build.bat 退出码 0 且无新增警告（事实包 §3.3）
- **⏸️ 停等：人确认后进入阶段 4**

### 🟣 阶段 4：测试（角色：Test Agent）
- **阶段目标**：独立验证——只看 §3 操作单与 §4 验收标准
- [ ] 步骤1：烧录 `firmware\build_and_flash.bat`，期望 `wrote ...` / `Verified OK`（事实包 §3.3）
- [ ] 步骤2：按 §3.2 上电观察绿灯（正常态常亮）
- [ ] 步骤3：按 §3.3 触发故障标志，观察绿灯灭
- [ ] 步骤4：逐条核对 §4 验收标准；若失败 → 查 §3.4 故障速查表，退回阶段 3
- **判定标准**：常亮/灭两态实测符合预期且有记录（记录实际观察，禁止"看起来正常"代替证据）
- **⏸️ 停等：人确认后进入阶段 5**

### 🔴 阶段 5：审查（角色：Review Agent）
- **阶段目标**：独立审查——安全红线（220Ω 限流/供电）、AC 逐条打勾
- [ ] 步骤1：核对 §4 全部 AC 勾选与记录值
- [ ] 步骤2：核对绿灯状态与 A4 异常标志接口一致（常亮/灭 语义映射）
- **判定标准**：AC 全部通过且记录值完整
- 全部通过 → ✅ 回填「维护与调试」+ 父FEAT项目表 + INDEX + 维护地图
- 未通过 → 退回对应阶段并附意见
- **⏸️ 停等：人确认 Review 通过后归档**

## 3. 傻瓜式操作单（照做即可）

### 3.0 物品/工具清单（动手前先打勾，缺一不可）
- [ ] 核心板（A6-01 已通过）
- [ ] 绿灯 LED ×1 + **220Ω 限流电阻 ×1**
- [ ] 杜邦线 ×2、万用表（直流电压/电阻档）
- [ ] 5V 电源：电脑 USB 口 **或** 非快充 5V 适配器（**严禁手机快充头**）
- [ ] ST-Link（SWD 四线：SWDIO/SWCLK/GND/3.3V）+ `firmware\build_and_flash.bat`
- [ ] USB-TTL（CH340）+ SSCOM（115200，如需串口确认）

### 3.1 上电前检查（红线：全程断电，先拔电源再动线）
1. 绿灯接线：**PB1 → 220Ω 电阻 → LED 阳极（长脚）**；LED 阴极（短脚）→ GND。**禁止 LED 直接接 PB1 不串电阻**。
2. 万用表**电阻档**量 220Ω 电阻两端 → 期望 **≈220Ω**（记录数值：___ Ω）。
3. 断电状态下量 PB1 对 GND 电阻 → 应 **>100Ω**；接近 0Ω = 短路，回查接线。
4. 供电红线：只准电脑 USB / 非快充 5V 适配器；**严禁手机快充头**（烧板事故根因，见 A1-01）。
5. 万用表直流电压档：量 5V 引脚 → 期望 **4.8 ~ 5.2V**；量 3.3V 引脚 → 期望 **3.2 ~ 3.4V**（记录数值：___V / ___V）；不在范围 → 断电换电源，禁止继续。

### 3.2 上电基线观察（正常态）
1. 插电，观察绿灯：**正常应"常亮"**。
2. 若上电后绿灯灭 → 查 §3.4（故障标志误触发 / 实现方式/极性错）。

### 3.3 故障态验证（阶段 4 执行）
1. 记录故障标志触发方式：___（接口待定（需人确认），按阶段 1 确认结果填写）。
2. 触发**故障标志** → 绿灯**灭**（记录：灭 是/否）。
3. 恢复正常（清除标志）→ 绿灯重新**常亮**（记录：常亮 是/否）。
4. 结论记录：两态实测是否符合预期（是/否），未通过项写进执行日志。

### 3.4 故障速查表
| 现象 | 可能原因 | 处理 |
|---|---|---|
| 绿灯完全不亮 | 220Ω 断路 / LED 极性反 / 输出未使能 | 断电查电阻与极性；查 TIM3_CH4/GPIO 配置 |
| 绿灯常亮不灭 | 故障标志未触发 / 灭逻辑未生效 | 查标志接口与映射；确认标志确实在变 |
| 上电即灭 | 故障标志误触发 / 默认态写错 | 查标志电平；确认默认=常亮 |
| 绿灯微亮 | 占空比过高 / 未串 220Ω | 确认串 220Ω；查占空比（参数待定（需人确认）） |
| 烧录失败 | ST-Link 四线/驱动 | 查 SWDIO/SWCLK/GND/3.3V；兜底 `firmware\flash_isp.bat`（HANDOFF §4.3） |
| 编译报错 | 工具链/路径问题 | 截图报错，查 `firmware\build.sh` 或 CI |

## 4. 验收标准（12 条）

### 功能验收
- [ ] AC-01 绿灯两态实测符合预期：正常常亮、故障灭、恢复正常后重新常亮（记录标志状态与观察结果）
- [ ] AC-02 向后兼容：不破坏 A6-01 红灯报警与 A1 音频采集链路（A1-02 复测通过）

### 代码质量
- [ ] AC-03 编译通过：`firmware\build.bat` 无错误退出
- [ ] AC-04 无新增警告
- [ ] AC-05 文档已更新：本 FEAT「维护与调试」回填 + 父FEAT 项目表回填

### 安全红线
- [ ] AC-06 无硬编码密钥 → **N/A**（嵌入式状态输出，无密钥概念）
- [ ] AC-07 错误处理完善：初始化失败/故障标志异常时绿灯默认行为明确（默认策略：待定（需人确认））
- [ ] AC-08 用户输入已校验 → **N/A**（本 FEAT 无外部用户输入；若参数经 RS485 下发，属 A4-04 范围）

### 测试与边界
- [ ] AC-09 新增测试自动运行 → **N/A**（嵌入式硬件验证，测试 = 阶段 4 人工按 §3.2/§3.3 操作单执行并记录）
- [ ] AC-10 回归测试通过：`./scripts/ci_local.sh` 运行无失败
- [ ] AC-11 测试覆盖率 ≥80% → **N/A**（硬件目视/万用表验证，无覆盖率统计）
- [ ] AC-12 按 FEAT 模板执行：本 FEAT 遵循 `.sop-agent规格.md` §2 结构 + `.template-child.md` 5 阶段

## 5. 维护与调试（阶段5通过后回填）

### 5.1 影响文件
| 文件 | 改动类型 | 说明 |
|---|---|---|
| `firmware/soundDog/soundDog.ioc` | 修改（如需） | TIM3_CH4 或 GPIO 配置（CubeMX） |
| `firmware/soundDog/Inc/pin_config.h` | 只读引用 | 宏 `LED_STATUS_*`、`LED_PWM_TIM`、`LED_PWM_FREQ`（本 FEAT 不改引脚） |
| 状态驱动源文件 | 新增（路径待定（需人确认）） | 常亮/灭实现 |

### 5.2 调试要点
- 观察绿灯两态（§3.2/§3.3）；万用表量 220Ω 与 5V/3.3V（§3.1 记录值）
- 状态不切换 → 查故障标志接口与映射

### 5.3 测试入口
- 人工目视 + 万用表 + `firmware\build_and_flash.bat` 烧录（对应 AC-01/03/04）

## 6. 执行日志

| 时间 | 阶段 | 角色 | 摘要 | 遇阻 |
|---|---|---|---|---|
| | | | | |
