wumu-dot/SoundDog/docs/features/FEAT-A6-03-蜂鸣器报警.md

# FEAT-A6-03-蜂鸣器报警

> **AI 执行规则**：必须按阶段顺序执行，每个阶段开头声明角色。严禁跳跃、越界、自审自判。
> 阶段间停等：每完成一个阶段，停下来，输出结果，等人说"继续"。
> 阶段5通过后：回填父FEAT项目表该行 + 更新 `docs/features/INDEX.md` + `docs/features/维护地图.md`。
> 历史记录只更新状态字段，严禁删除/篡改已完成记录。
> 事实来源：`.sop-agent规格.md` §3 + `firmware/soundDog/Inc/pin_config.h`（禁止自造数值；缺失一律写"待定（需人确认）"）。

## 0. 元数据
- **父FEAT**：FEAT-A6-报警输出
- **优先级**：P2
- **预估总耗时**：0.5h
- **当前状态**：🔴未开始（傻瓜式操作单已备好；依赖 A6-01 通过后开跑）

## 1. 总体目标与硬边界

### 1.1 核心目标（一句话）
> 用 PE6 经**三极管**驱动蜂鸣器，异常时输出**断续报警**（声音提示），与红灯报警（A6-01）联动，让异常在视觉+听觉双通道可感知。

### 1.2 地基触碰前置自检
- [x] 否 → 继续（GPIO/PWM 驱动与 App 层实现，不碰 `firmware/Drivers/` 底层库）

### 1.3 任务边界
| 类型 | 具体内容 |
|---|---|
| 范围内（可改） | PE6 驱动配置（CubeMX `soundDog.ioc` 或 USER CODE）、断续报警逻辑、`pin_config.h` 已有宏的使用 |
| 超出范围（禁止碰） | `firmware/Drivers/` HAL 底层库；引脚定义（改引脚只改 `pin_config.h`，本 FEAT 无需改） |
| 外部依赖 | A6-01 已通过（父FEAT 项目表：依赖 01）；A4 异常标志（接口待定（需人确认））；蜂鸣器 + 三极管驱动电路（极性待确认） |

### 1.4 关键参数与接口（事实包 §3 + pin_config.h，禁止自造）
- 引脚：**PE6**（宏 `BUZZER_PIN`/`BUZZER_PORT`=GPIOE，来源 pin_config.h）；**三极管驱动**（事实包 §3.2/§3.6）。
- 报警方式：**异常断续报警**（事实包 §3.6 A6-03）。
- 三极管型号/极性（NPN/PNP）、驱动有效电平（高/低）、蜂鸣器类型（有源/无源）：**待定（需人确认）**。
- 断续节奏（响/停时长）：**待定（需人确认）**。
- 驱动源：A4 异常标志（与 A6-01 共用）；接口形式：**待定（需人确认）**。
- 烧录期望：`firmware\build_and_flash.bat` 输出 `wrote ...` / `Verified OK`（事实包 §3.3）。

## 2. 执行路线图（5 阶段）

### 🟢 阶段 1：准备（角色：Dev Agent）
- **阶段目标**：确认前置条件与驱动电路现状，输出影响范围
- [ ] 步骤1：确认 **A6-01 已通过**（红灯三模式验证记录在案，父FEAT 项目表状态 🟢）
- [ ] 步骤2：读 `CLAUDE.md`（硬边界）+ `firmware/soundDog/Inc/pin_config.h` + 本 FEAT §1.4
- [ ] 步骤3：确认蜂鸣器驱动电路：三极管型号/极性、有源/无源蜂鸣器、有效电平（全部待定（需人确认），查原理图/实物丝印）
- [ ] 步骤4：确认 A4 异常标志接口（与 A6-01 相同）
- [ ] 步骤5：输出影响范围（新增/修改文件、接口变化、风险）
- **判定标准**：A6-01 已通过（否则本 FEAT 暂停）；驱动电路信息已确认或显式标注"待定（需人确认）"；影响范围清单已输出
- **⏸️ 停等：人确认后进入阶段 2**

### 🔵 阶段 2：设计（角色：Dev Agent）
- **阶段目标**：确定 异常 → 断续报警 的逻辑与节奏，产出 §3 操作单
- [ ] 步骤1：确定报警映射（异常标志 → 断续报警；正常 → 静音）
- [ ] 步骤2：确定断续节奏（响/停时长）：待定（需人确认）；驱动方式（GPIO 翻转 / PWM，取决于有源/无源）：待定（需人确认）
- [ ] 步骤3：产出 §3 傻瓜式操作单
- **判定标准**：映射 + 节奏参数清单完成；未定项显式标注"待定（需人确认）"
- **⏸️ 停等：人确认后进入阶段 3**

### 🟠 阶段 3：实现（角色：Dev Agent）
- **阶段目标**：接线（§3.1 上电前检查，重点三极管极性）→ 配置/编码 → 编译通过
- [ ] 步骤1：按 §3.1 完成蜂鸣器驱动电路检查（三极管极性、无短路），逐行打勾
- [ ] 步骤2：配置 PE6 输出（GPIO/PWM，按阶段 1/2 确认结果），编码断续报警逻辑
- [ ] 步骤3：运行 `firmware\build.bat`，无错误退出、无新增警告
- **判定标准**：build.bat 退出码 0 且无新增警告（事实包 §3.3）
- **⏸️ 停等：人确认后进入阶段 4**

### 🟣 阶段 4：测试（角色：Test Agent）
- **阶段目标**：独立验证——只看 §3 操作单与 §4 验收标准
- [ ] 步骤1：烧录 `firmware\build_and_flash.bat`，期望 `wrote ...` / `Verified OK`（事实包 §3.3）
- [ ] 步骤2：按 §3.2 上电观察（正常态静音）
- [ ] 步骤3：按 §3.3 触发异常标志，观察断续报警并记录节奏
- [ ] 步骤4：逐条核对 §4 验收标准；若失败 → 查 §3.4 故障速查表，退回阶段 3
- **判定标准**：静音/断续报警实测符合预期且有记录（记录响/停时长，禁止"听起来正常"代替证据）
- **⏸️ 停等：人确认后进入阶段 5**

### 🔴 阶段 5：审查（角色：Review Agent）
- **阶段目标**：独立审查——安全红线（三极管极性/供电）、AC 逐条打勾
- 全部通过 → ✅ 回填「维护与调试」+ 父FEAT项目表 + INDEX + 维护地图
- 未通过 → 退回对应阶段并附意见

## 3. 傻瓜式操作单（照做即可）

### 3.0 物品/工具清单（动手前先打勾，缺一不可）
- [ ] 核心板（A6-01 已通过）
- [ ] 蜂鸣器 ×1（有源/无源：待定（需人确认），以阶段 1 确认为准）
- [ ] 三极管驱动电路（型号/极性：待定（需人确认）；基极限流电阻按电路设计）
- [ ] 杜邦线、万用表（直流电压/电阻档）
- [ ] 5V 电源：电脑 USB 口 **或** 非快充 5V 适配器（**严禁手机快充头**）
- [ ] ST-Link（SWD 四线：SWDIO/SWCLK/GND/3.3V）+ `firmware\build_and_flash.bat`
- [ ] USB-TTL（CH340）+ SSCOM（115200，如需串口确认）

### 3.1 上电前检查（红线：全程断电，先拔电源再动线；重点核对三极管极性）
1. **三极管极性核对（接线前必做）**：确认三极管型号与引脚排布（丝印/数据手册），NPN 与 PNP 接法相反，**接反不响且可能损坏驱动管**。具体接法按电路设计（待定（需人确认）），务必与原理图逐脚核对：基极 B（经限流电阻）→ PE6、发射极 E / 集电极 C 与蜂鸣器供电方向一致。
2. 蜂鸣器接线：供电端与地按三极管开关电路接好；**先不插电**。
3. 万用表**电阻档**量 PE6 对 GND → 应 **>100Ω**；接近 0Ω = 短路，回查接线。
4. 供电红线：只准电脑 USB / 非快充 5V 适配器；**严禁手机快充头**（烧板事故根因，见 A1-01）。
5. 万用表直流电压档：量 5V 引脚 → 期望 **4.8 ~ 5.2V**；量 3.3V 引脚 → 期望 **3.2 ~ 3.4V**（记录数值：___V / ___V）；不在范围 → 断电换电源，禁止继续。

### 3.2 上电基线观察（正常态）
1. 插电，正常态（无异常标志）：蜂鸣器应**静音**。
2. 若一上电就响 → 查 §3.4（有效电平反 / 标志误触发 / 三极管常通）。

### 3.3 异常断续报警验证（阶段 4 执行）
1. 记录异常标志触发方式：___（接口待定（需人确认），按阶段 1 确认结果填写）。
2. 触发**异常标志** → 蜂鸣器**断续报警**：记录"响 ___ 秒 / 停 ___ 秒"（期望节奏：待定（需人确认））。
3. 恢复正常（清除标志）→ 蜂鸣器**静音**（记录：静音 是/否）。
4. 结论记录：静音/断续报警实测是否符合预期（是/否），未通过项写进执行日志。

### 3.4 故障速查表
| 现象 | 可能原因 | 处理 |
|---|---|---|
| 蜂鸣器完全不响 | 三极管极性接反 / 有效电平错 / 未触发标志 | 断电核对三极管极性（§3.1）；查驱动电平；确认标志在触发 |
| 一上电就响 | 有效电平反 / 标志误触发 / 三极管常通 | 查默认电平与标志；查三极管是否击穿/接错 |
| 一直响不停 | 断续逻辑未生效 / 标志未清除 | 查断续计时逻辑；确认标志被清除 |
| 断续节奏不对 | 响/停参数未按设计 | 按阶段 2 确认的节奏重配（参数待定（需人确认）） |
| 声音很小/发闷 | 有源/无源判断错 / 供电不足 | 确认蜂鸣器类型与驱动方式（待定（需人确认）） |
| 烧录失败 | ST-Link 四线/驱动 | 查 SWDIO/SWCLK/GND/3.3V；兜底 `firmware\flash_isp.bat`（HANDOFF §4.3） |
| 编译报错 | 工具链/路径问题 | 截图报错，查 `firmware\build.sh` 或 CI |

## 4. 验收标准（12 条）

### 功能验收
- [ ] AC-01 蜂鸣器实测符合预期：正常态静音、异常时断续报警（记录响/停时长与标志状态）、恢复正常后静音
- [ ] AC-02 向后兼容：不破坏 A6-01 红灯报警与 A1 音频采集链路（A1-02 复测通过）

### 代码质量
- [ ] AC-03 编译通过：`firmware\build.bat` 无错误退出
- [ ] AC-04 无新增警告
- [ ] AC-05 文档已更新：本 FEAT「维护与调试」回填 + 父FEAT 项目表回填

### 安全红线
- [ ] AC-06 无硬编码密钥 → **N/A**（嵌入式蜂鸣器驱动，无密钥概念）
- [ ] AC-07 错误处理完善：初始化失败/标志异常时蜂鸣器默认行为明确（默认策略：待定（需人确认））
- [ ] AC-08 用户输入已校验 → **N/A**（本 FEAT 无外部用户输入；若参数经 RS485 下发，属 A4-04 范围）

### 测试与边界
- [ ] AC-09 新增测试自动运行 → **N/A**（嵌入式硬件验证，测试 = 阶段 4 人工按 §3.2/§3.3 操作单执行并记录）
- [ ] AC-10 回归测试通过：`./scripts/ci_local.sh` 运行无失败
- [ ] AC-11 测试覆盖率 ≥80% → **N/A**（硬件听感/万用表验证，无覆盖率统计）
- [ ] AC-12 按 FEAT 模板执行：本 FEAT 遵循 `.sop-agent规格.md` §2 结构 + `.template-child.md` 5 阶段

## 5. 维护与调试（阶段5通过后回填）

### 5.1 影响文件
| 文件 | 改动类型 | 说明 |
|---|---|---|
| `firmware/soundDog/soundDog.ioc` | 修改（如需） | PE6 输出配置（CubeMX） |
| `firmware/soundDog/Inc/pin_config.h` | 只读引用 | 宏 `BUZZER_PIN`/`BUZZER_PORT`（本 FEAT 不改引脚） |
| 蜂鸣器驱动源文件 | 新增（路径待定（需人确认）） | 断续报警实现 |

### 5.2 调试要点
- 听/量蜂鸣器两态（§3.2/§3.3）；万用表量 PE6 对 GND 与 5V/3.3V（§3.1 记录值）
- 不响/长响 → 优先核对三极管极性与有效电平（§3.4 前两行）

### 5.3 测试入口
- 人工听感 + 万用表 + `firmware\build_and_flash.bat` 烧录（对应 AC-01/03/04）

## 6. 执行日志

| 时间 | 阶段 | 角色 | 摘要 | 遇阻 |
|---|---|---|---|---|
| | | | | |
