wumu-dot/SoundDog/docs/features/FEAT-A6-报警输出.md

# FEAT-A6-报警输出（父FEAT · 统筹规划）

> **AI 执行规则**：父FEAT 只做统筹规划，禁止编写实现代码；实现一律拆成子FEAT。
> 创建/修改项目表后必须停等，输出结果等人类确认方向后才允许创建子FEAT。
> 禁止自审自判完成：父FEAT 置 🟢 仅当项目表全部子FEAT 🟢 且每个都经过 Review。
> 历史记录只更新状态字段，严禁删除/篡改已完成记录。

## 0. 元数据
- **角色**：Planner（统筹规划）
- **优先级**：P2
- **预估总耗时**：2h
- **当前状态**：🔴规划中

## 1. 总体目标与方向

### 1.1 核心目标（一句话）
> 用 LED 与蜂鸣器输出报警/状态信号，异常时红灯闪 + 蜂鸣器响。

### 1.2 大方向策略
> 先 LED PWM 报警模式，再绿灯状态，最后蜂鸣器断续报警。

### 1.3 硬边界（继承 CLAUDE.md）
- [x] 是否涉及底层库 / 第三方库？→ 否
- [x] 否 → 继续

## 2. 项目表（子FEAT清单）

> 每个子FEAT 按子模板（`.template-child.md`）创建。子FEAT 傻瓜式操作单已细化建档（见文件列），等待 A4 异常标志就绪后开跑。

| 子FEAT编号 | 功能 | 验收要点 | 优先级 | 依赖 | 状态 | 文件 |
|---|---|---|---|---|---|---|
| FEAT-A6-01 | 红灯 PWM 报警 | 异常快闪/警告慢闪/正常灭（TIM3 CH3） | P2 | A4 异常标志（阻塞项） | 🔴未开始 | `FEAT-A6-01-红灯PWM报警.md` |
| FEAT-A6-02 | 绿灯状态 | 正常常亮/故障灭（TIM3 CH4） | P2 | 依赖 01 | 🔴未开始 | `FEAT-A6-02-绿灯状态.md` |
| FEAT-A6-03 | 蜂鸣器 | 异常断续报警（PE6） | P2 | 依赖 01 | 🔴未开始 | `FEAT-A6-03-蜂鸣器报警.md` |

> 子FEAT 完成后回填本行状态与文件链接。

## 3. 依赖与执行顺序

1. 01 红灯 → 02 绿灯 / 03 蜂鸣器（可并行）

## 4. 阻塞与下一步

- **阻塞**：依赖 A4 判决信号（异常标志）
- **下一步**：A4 有异常标志后开 A6-01

## 5. 完成定义（DoD）

- [ ] 项目表全部子FEAT 🟢 且每个经 Review
- [ ] 本表状态与 `docs/features/INDEX.md` 一致
- [ ] 经验教训已提炼（如有）

## 6. 执行日志

| 时间 | 动作 | 角色 | 摘要 | 遇阻 |
|---|---|---|---|---|
| 2026-08-16 | 建档 | Planner | 创建 A6-01~03 子FEAT 傻瓜式操作单（含上电前检查：LED 串 220Ω / 蜂鸣器三极管极性）并回填项目表文件列 | 阻塞不变：A4 判决信号（异常标志）未就绪 |
