wumu-dot/SoundDog/SoundDog-审查核验与修复计划-2026-09-16.md

# SoundDog 审查缺陷核验与修复计划（2026-09-16·按审查官 §8 复核修正稿）

> 我是开发方（写项目）。本份是对审查官《代码审计报告·2026-09-16》§8 复核意见的定稿后版本。
> 修订说明：审查官 §8 已确认开发方核验质量（13 条一致、12/13 行号精确、P0-2 更正正确）。本版已按 §8.3 四点定稿 + §8.4 十条覆盖缺口补齐。

> ## ⚡ 批次1 执行状态（2026-09-16 更新）
> **✅ 批次1（#1~#13）已全部实施 + 构建验证通过（0 error / 0 warning，`size`：text 177668 / data 256 / bss 97968）。**
> - 覆盖项：#1 P1-3 NVIC 分组、#2～#4 Makefile、#5 P2-10 portevent 多flag、#6 P2-7 PVD、#7 P2-2 ISR yield、#8 P1-2 钩子（rtos_hooks.c 新建 + FreeRTOSConfig.h 两宏）、#9 P2-13 rx_buff 边界、#10 收帧栈 512→1024 + 开机取证打印、#11 P1-1 丢帧恢复、#12 P2-1 USART1 单写者、#13 P2-5 文档（README + CLAUDE.md）。
> - P2-6 工作区清理**也已完成**（`compile_commands.json` 入 .gitignore、`build.bat` 去 pause）。
> - **未做**：批次2（P2-11 OLED 熔断、T3.5 定时器实测，需真机）与捆绑项（`MB_PROBE_ENABLE` 探针拆除，待 RS485 链路确诊）。
> - 构建证据与逐项清单见桌面「目前进度」报告 §批次1；真机验收（boot/Modbus/100帧s/heap+栈水位读数）仍待硬件线。

## 一、核验结论总表（已全部对照源码核实，修订两处）

| 项 | 核验结论 | 处置 |
|---|---|---|
| P1-1 丢帧恢复实丢2帧 | 🟡 **成立**（`freertos.c:415`，行号比审查官 §1 的 410-416 更精确） | 修（取舍已定稿，见 §8.3-B） |
| P1-2 栈/堆钩子未使能 | 🟡 **成立**（两宏在 `FreeRTOSConfig.h` 根本不存在，由 `FreeRTOS.h:397-398/:737-738` 兜底为 0） | 修 |
| P1-3 NVIC 优先级分组未配置 | 🟡 **成立**（全应用零命中 `SetPriorityGrouping`） | 修 |
| P2-收帧任务栈 512B | 🟡 **成立**（`portserial.c:87` `attr=NULL` → `cmsis_os2.c:454` 取 `128` 字=512B，任务内跑 printf） | 修（含堆预算，见 §8.3-D） |
| P2-Makefile mkdir 缺-p | 🟢 **成立**（`Makefile:278`，全量重编常态性失败，已实测复现） | 修 |
| P2-system_stm32f4xx.c 25MHz vs 8MHz | 🟡 **结论成立，严重度被高估**（见 §8.3-A：不改变运行时行为，属拆潜伏地雷） | 修 → **归批次1** |
| P2-portevent 多flag静默丢弃 | 🟡 **成立**（`portevent.c:59-81`，`osFlagsWaitAny` 未置 `osFlagsNoClear`，多 bit → default 被弃） | 修 |
| P2-PVD 优先级0未配置 | 🟡 **成立**（`stm32f4xx_hal_msp.c:87-88`，全工程无 `ConfigPVD`，纯死中断） | 修 |
| P2-OLED 掉线卡死 | 🟡 **成立**（无熔断，8 页 I2C 超时≈1s vs 200ms 周期；`oled_drv.c:111` 还有 `HAL_Delay(2000)`） | 修（需真机验证） |
| P2-README 过期 | 🟢 **成立**（另漏 `CLAUDE.md` `DOC-STATE TASKS=3`，实际 4 个任务） | 修（文档） |
| T3.5 定时器低优先级 | ⏳ **需实测**（`configTIMER_TASK_PRIORITY=2` < 业务任务 24，延迟可达十几 ms；**不影响收字节**，只延迟帧判定/应答） | **先实测，不盲改** |
| P0-1 探针（RX回环/printf/翻灯） | 🟡 成立，已受 `MB_PROBE_ENABLE` 开关控制（`portserial.c:12-17`） | 与拆探针捆绑（链路确诊后 R36） |
| （核为误判）P0-2 huart3 双任务并发 | 🔴 **误判**（`RS485_Send` 唯一活调用点=探针 `portserial.c:237`，`main.c:253` 在 `#if 0` 内；关 `MB_PROBE_ENABLE` 即消解） | **不修** |

图例：🟢 实测 / 🟡 源码或规范 / ⏳ 需实测 / 🔴 误判排除

## 二、修复方案（已按审查官 §8.3 定稿）

### 批次1：纯正确化 + 无真机依赖（可一次提交、一次编译验证）

**1. P1-3 NVIC 分组** — `App/main.c` 在 `HAL_Init();` 后加 `HAL_NVIC_SetPriorityGrouping(NVIC_PRIORITYGROUP_4);`
（放 main 手写权威区，不上 HAL_MspInit，避免被 CubeMX 重生成覆盖。）

**2. P2-Makefile mkdir** — `Makefile:278` `mkdir $@` → `mkdir -p $@`（同解 Windows/Linux 差异）。

**3. P2-4 删 `-D__FPU_PRESENT=1`** — `Makefile:182` 删除（设备头 `stm32f407xx.h:51` 已定义；清除每次全编刷 30 条 redefined 警告，暴露真实警告）。

**4. P2-9 HSE=8000000** — `Makefile` C_DEFS 加 `-DHSE_VALUE=8000000U`。
> 【§8.3-A 定稿】此项**不改变任何运行时行为**，是「拆掉一颗潜伏地雷」，**不是**修正时基/波特率（现状 168MHz 正确）：
> - `SystemCoreClockUpdate()` 全工程**零调用**；
> - `SystemCoreClock` 启动后由 `HAL_RCC_ClockConfig()` 重写（`hal_rcc.c:718-719`），用 hal_conf 的 8MHz → 正确；
> - `-DHSE_VALUE` 只落在 `system_stm32f4xx.c` 一个 TU。
> **归批次1**，不做真机确认（本就不改变行为）。

**5. P2-10 portevent 多flag** — `portevent.c:59-81` 单 bit switch 改按位权重分发，未处理的剩余 bit 重新 `osEventFlagsSet`。

**6. P2-7 PVD** — `stm32f4xx_hal_msp.c:87-88` 注释掉 `HAL_NVIC_EnableIRQ(PVD_IRQn);`（无 ConfigPVD 纯死中断，杜绝"最高抢占 0"隐患）；`SetPriority` 一并改为 15。

**7. P2-2 ISR yield** — `main.c:78` `xQueueSendFromISR(audio_q,&msg,NULL)` → 加 `BaseType_t hpw=pdFALSE;` 并传 `&hpw` + `portYIELD_FROM_ISR(hpw);`（减少最坏唤醒延迟）。

**8. P1-2 钩子 + 新建 rtos_hooks.c** —
- `FreeRTOSConfig.h`：`configCHECK_FOR_STACK_OVERFLOW 2`、`configUSE_MALLOC_FAILED_HOOK 1`
- 新建 `App/rtos_hooks.c`：`vApplicationStackOverflowHook` / `vApplicationMallocFailedHook`，`__disable_irq()` 后 `HAL_UART_Transmit(&huart1,...)` 阻塞打印 + `for(;;)`（cmsis_os2 有 `__WEAK` 空实现，强符号覆盖可行）
- `Makefile` C_SOURCES 追加 `App/rtos_hooks.c`
> 【§8.3-C 备注】钩子运行于 PendSV 上下文；PendSV 与 SysTick 同优先级 15（`FreeRTOSConfig.h:139/149`、`port.c:68-69/:362-363`），SysTick **不推进** → `HAL_UART_Transmit` 的 Timeout **失效**。正常情形 TXE/TC 轮询不依赖 tick 仍能发；USART 未就绪时会永久停在 HAL（而非落到 `for(;;)`）。两种结局均卡死，安全目标达成，**不阻断**。

**9. P2-13 rx_buff 边界检查** — `portserial.c:186` `rx_buff[put_index++] = data;` 加范围判断：`if (put_index < (uint8_t)sizeof(rx_buff)) rx_buff[put_index++] = data;`
> 【不随探针，生产路径】MODBUS ADU 上限恰为 256 字节、零余量；任何超长字节流（噪声/误接线/异常长帧）都会越界写相邻 `.bss`。**关探针后仍成立**，必须修。

**10. P2-收帧栈 512→1024 + 开机取证打印** —
- `portserial.c:87` `handleReceivedDataTask` 显式 `osThreadAttr_t`，`.stack_size = 256*4`（1024B，单位字节；`stack_size` 单位=字节，见 `cmsis_os2.c:475`）
- 启动稳定后打印一次 `xPortGetFreeHeapSize()` 与四任务 `uxTaskGetStackHighWaterMark()`（把余量变**可观测值**，目前全仓零调用）
> 【§8.3-D 堆预算】FreeRTOS 堆 `ucHeap`=15360B，§4.5 实测已用 13084B、余 **2276B**；+512B 后余约 **1764B**（未计 heap_4 每块约 8B 头）。钩子本身不占堆 ✓。低于约 1KB 时须将某大栈任务改静态分配。

**11. P1-1 丢帧恢复**（取舍已定稿，真机回归重点）—
- **取舍定稿（§8.3-B）**：采用「本窗废弃，失配第二帧挂起作下一窗首帧」。**停摆 1 窗**（被废弃窗不走 `spec_process`/`mfcc_feed`），但**丢帧数 2→1**。`freertos.c:413-414` 原注释要避免的**相位跳变**（硬拼）不予采用——二者不可兼得，选"保相位、降丢帧"。
- `frame_max_stat` 两半帧照常统计。
- **验收判据（可测）**：连续丢帧工况下 MFCC **平均帧率仍为 100 帧/s**（允许单窗缺口），且 `n_frames` 统计不跳号。

**12. P2-1 USART1 单写者** — `App/freertos.c` `MBSlavePollTask` 的 3 处 `printf`（:322/:327/:332）违反"运行期只允许 specTask 写 USART1"铁律。实施时取其中一种：
- 移交 specTask 经事件标志统一打印；或
- 加 USART1 写互斥（`_write` 内包一层）。
实施时以**改动最小且不触碰 Middlewares** 为准。

**13. P2-5 文档** — `README.md`「当前状态」表 + 任务清单（4 个）+ 目录结构（含 `App/` `BSP/` `Middlewares/FreeModbus/`、USART3/RS485/*.py）；`CLAUDE.md` `DOC-STATE TASKS=3` → `4`；`i2s_drv.c` 路径 `Src/` → `BSP/`。

### 批次2：需真机安全确认（单条单独验证）

**14. P2-11 OLED 熔断降级** — `BSP/oled_drv.c`：连续失败 ≥ `OLED_FUSE_THRESHOLD=4` 置 `oled_fused=true` 跳过刷新；`DisplayTask` 每 200ms `HAL_I2C_IsDeviceReady` 轻量探测，恢复自动清除。真机验证：拔线不卡死、重插恢复。

**15. T3.5 定时器** — **不盲改优先级**。真机量"收到末字节→应答"延迟，确认是否逼近主站超时；确认被压制才考虑调高 `configTIMER_TASK_PRIORITY`。

### 捆绑项（拆分，不在本轮）

`MB_PROBE_ENABLE` 探针拆除（RX回环/printf/翻灯，含 P2-8 LED_STATUS 语义恢复）+ 随后按 R36 一次清理 → 待 RS485 链路确诊后（§5.4 触发条件：回环自测通过 + 主站读到 CRC 正确应答，或准备提交/发布）。

## 三、覆盖缺口去留清单（审查官 §8.4 十项，显式标注）

| 条目 | 去留 | 说明 / 触发条件 |
|---|---|---|
| **P0-3** `osKernelLock` 嵌套→调度器永久挂起 | **延后（设红线）** | `portcritical.c:19` 单全局 `lock`，当前 5 处调用点无嵌套未触发。**红线：在 `portcritical.c` 之外新增任何 Modbus 临界区调用之前必须先修**（改调用方局部栈变量或 `taskENTER_CRITICAL`） |
| **P2-1** USART1 单写者 | **本轮修** | 批次1 #12；`portserial.c` 侧随探针拆除缓解，`freertos.c:332` 启动 printf 仍存在需处理 |
| **P2-2** FromISR 未处理 hpw | **本轮修** | 批次1 #7 |
| **P2-4** `-D__FPU_PRESENT` 重复定义 | **本轮修** | 批次1 #3，就在要改的 `C_DEFS` 段顺手清 |
| **P2-5** 文档漂移 | **本轮修** | 批次1 #13，含 `CLAUDE.md` `TASKS=4` |
| **P2-6** 工作区未清理 / 无 CI | **已处理结构部分**（2026-09-16 完成） | `compile_commands.json` 加 `.gitignore`（已忽略验证 exit=0）、`build.bat` 去 `pause`；`build_and_flash.bat` 保留 pause（交互烧录有意设计）。Git 提交与 CI 配置仍待用户决策 |
| **P2-8** 探针翻灯 = LED_STATUS | **延后（随探针捆绑）** | 隐含随 P0-1 拆除（R36）解决 |
| **P2-12** 引脚双真值源无 `_Static_assert` | **延后（低优先）** | 当前两源取值一致无实际冲突；TIM3/PB0-PB1 推挽 vs PWM 为将来项。开 PWM 或改 pin 时再加 `_Static_assert` |
| **P2-13** `rx_buff[256]` 零余量 | **本轮修** | 批次1 #9，**非探针派生，关探针仍存在** |
| **P2-14** `xMBPortSerialPutByte` 栈地址做 IT | **延后（潜伏）** | `SLAVE_SEND_ALL_BYTES_IN_ONE_CALL=1` 走整帧 `PutBytes`，逐字节路径未编译；**触发条件=该宏改 0 或改走逐字节发送** |

## 四、关键文件

`App/main.c`、`App/freertos.c`、`App/rtos_hooks.c`（新增）、`Inc/FreeRTOSConfig.h`、`Makefile`、`Middlewares/.../portserial.c`、`Middlewares/.../portevent.c`、`Src/stm32f4xx_hal_msp.c`、`BSP/oled_drv.c`、`README.md`、`CLAUDE.md`

## 五、验证

- 构建：`mingw32-make -B -j8 all` 全量 **0 error、0 自有代码警告**；`size` 查 text/data/bss 与 RAM/堆余量
- 静态复验：改后重核缺陷点是否消除、无非预期改动
- 真机（批次1）：boot 正常、Modbus 应答、100 帧/s 节奏、`xPortGetFreeHeapSize()`/栈水位打印读数
- 真机（批次2）：拔插 OLED 熔断恢复、T3.5 应答延迟分布

## 六、已明确排除 / 待实测

- **T3.5**：本轮不盲改，等真机延迟实测
- **MB 探针 / P0-1**：不在此轮动，与拆探针捆绑（链路确诊后 R36）
- **P0-2 并发**：核为误判，不修（关 `MB_PROBE_ENABLE` 即消解）
- **主线仍是硬件线**：换 ESP32 新板 → 验共地 → 重跑回环 → 链路确诊；代码处置在批次内与该线无耦合，可并行
