wumu-dot/SoundDog/SoundDog-批次1交付汇总-2026-09-16.md

# SoundDog 审查缺陷修复 · 批次1 交付汇总（2026-09-16）

> 开发方交付给审查官的速览稿。完整背景见：
> - `SoundDog-审查核验与修复计划-2026-09-16.md`（⚡批次1 执行状态 + 定稿方案）
> - `SoundDog-目前进度-2026-09-16.md`（工程全貌快照）

## 一句话结论

**审查官 §8 定稿的批次1（#1~#13）已全部实施，全量构建 0 error / 0 warning，`size` = text 177668 / data 256 / bss 97968。批次1 与硬件主线（换 ESP32→验共地→回环）无耦合，可并行；批次2 与探针拆除待真机/链路确诊。**

## 批次1 交付清单（全部已验证）

| 项 | 文件 | 修复 | 验证 |
|---|---|---|---|
| P1-1 丢帧恢复 2→1 | `App/freertos.c` | 失配第二帧挂起为下窗首帧，本窗废弃 | 编译 ✓（真机回归需板上线） |
| P1-2 栈/堆钩子 | `App/rtos_hooks.c`（新建）+ `Inc/FreeRTOSConfig.h` | `configCHECK_FOR_STACK_OVERFLOW 2`、`configUSE_MALLOC_FAILED_HOOK 1`；钩子轮询 SR/DR，规避 PendSV 下 tick 冻结 | 编译 ✓ |
| P1-3 NVIC 分组 | `App/main.c` | `HAL_Init()` 后 `SetPriorityGrouping(Group_4)` | 编译 ✓ |
| P2-1 USART1 单写者 | `App/main.c` `_write` | 整段临界区互斥（printf 唯一收口） | 编译 ✓ |
| P2-2 ISR yield | `App/main.c` | `xQueueSendFromISR` 传 `&hpw` + `portYIELD_FROM_ISR` | 编译 ✓ |
| P2-4/9/收栈入库 | `Makefile` | 删 `__FPU_PRESENT` 重复定义；加 `-DHSE_VALUE`；rtos_hooks.c 入库 | 编译 ✓ |
| P2-7 PVD | `Src/stm32f4xx_hal_msp.c` | 注释 `EnableIRQ(PVD)`、优先级→15（杜绝最高抢占 0） | 编译 ✓ |
| P2-10 portevent 多flag | `Middlewares/.../portevent.c` | `osFlagsNoClear` + 按 bit 权重逐个分发，未处理位保留 | 编译 ✓ |
| P2-13 rx_buff 边界 | `Middlewares/.../portserial.c` | `put_index < sizeof`；超长帧不越界写 `.bss`（关探针仍成立） | 编译 ✓ |
| 收帧栈 + 取证打印 | `portserial.c` + `freertos.c` | 收帧任务栈 512→1024B；开机打印 heap + 四任务栈水位 | 编译 ✓ |
| P2-5 文档 | `README.md` + `CLAUDE.md` | 任务清单 4、目录结构、boot 输出示例、`TASKS=4` | 已核对 ✓ |

**P2-6 工作区清理（同步完成）**：`compile_commands.json` 入 `.gitignore`（`git check-ignore` exit=0 验证）；`build.bat` 去 `pause`；`build_and_flash.bat` 保留 pause（交互烧录有意设计）。

## 构建验证证据（R21）

```
mingw32-make -B -j8 all  →  0 error / 0 warning（30 条 __FPU_PRESENT redefined 警告已清除）
size:
  text   177668
  data      256
  bss     97968
```

## 未做（明确边界）

| 项 | 原因 | 触发条件 |
|---|---|---|
| 批次2：P2-11 OLED 熔断降级 | 需真机验证拔线不卡死/重插恢复 | 新板到位后单条验证 |
| 批次2：T3.5 定时器 | 需实测「收末字节→应答」延迟，不盲改优先级 | 真机延迟分布 |
| 捆绑项：`MB_PROBE_ENABLE` 探针拆除（含 P2-8 翻灯语义恢复） | 链路确诊前的唯一端到端判定手段 | RS485 回环自测通过 + 主站读到 CRC 正确应答 |
| P0-2 并发 | 核为**误判**，关探针即消解 | 不修 |
| P0-3 全局 lock 嵌套 | 潜伏未触发，设红线 | portcritical.c 外新增 Modbus 临界区调用前必须先修 |

## 待决策（给用户）

1. 批次1 变更（8 改 + 5 未跟踪 + 2 新报告）是否 **git 提交**？
2. 是否配置 CI / 门禁？
3. 下一动作：进入批次2（需真机）还是收敛本轮？
