wumu-dot/SoundDog/docs/INDEX.md

# 项目文档索引

> 单次会话只读1次。做X前先查对应的Y。

## 场景检索地图

| 你要做什么 | 先读 |
|---|---|
| 改引脚/外设配置 | `firmware/soundDog/Inc/pin_config.h` + `CubeMX实操步骤.md` |
| 查外部资料（原理图/手册/例程） | `外部资源索引.md` |
| 音频采集/DSP调试 | `准备工作.md` |
| I2S/INMP441配置问题 | `CubeMX_I2S3配置详解.md` |
| 加/改FreeRTOS任务 | `PROJECT_PLAN.md` §5.1 |
| 调试HardFault死机 | `docs/tools/gdb_debug.md` |
| 编译构建报错 | `docs/troubleshooting/bug_shturl` + `docs/bugs/` |
| 规划功能方向（父FEAT） | `docs/features/.template-parent.md` |
| 实现具体功能（子FEAT，5阶段） | `docs/features/.template-child.md` |
| 出问题快速定位 | `docs/features/维护地图.md`（文件→FEAT反查） |
| Bug登记 | `docs/bugs/.template.md` |
| 历史故障查询 | `docs/troubleshooting/bug_shturl` |
| 经验教训提炼 | `docs/summary/lessons_summary.md` |
| 搭建开发环境 | `docs/tools/dev-setup.md`（CodeGraph + Ponytail + OpenCLI） |

## 文档清单

| 文件 | 摘要 |
|---|---|
| `PROJECT_PLAN.md` | SoundDog 项目总体规划、硬件清单、软件架构 |
| `准备工作.md` | 开发环境搭建、分步调试方法论、开发节奏 |
| `CubeMX实操步骤.md` | STM32CubeMX 外设配置完整手顺（14步） |
| `CubeMX_I2S3配置详解.md` | I2S3 + INMP441 时钟推导与配置详解 |
| `外部资源索引.md` | 芯片手册、HAL例程、工具软件等外部资源速查 |
| `tools/gdb_debug.md` | CodeGraph → OpenOCD → GDB 硬件调试教程 |
| `tools/dev-setup.md` | 开发环境搭建指南（CodeGraph + Ponytail + OpenCLI） |
| `tools/skills.md` | `/flash` `/debug` `/check` `/style` 技能速查 |
| `features/.template-parent.md` | 父FEAT统筹模板（方向+项目表+依赖+DoD） |
| `features/.template-child.md` | 子FEAT实现模板（5阶段+12AC+回填+维护） |
| `features/INDEX.md` | 两级FEAT索引进度（A1~A7） |
| `features/维护地图.md` | 文件→FEAT 反查定位（维护与调试入口） |
| `features/FEAT-A1~A7-*.md` | SoundDog 各阶段父FEAT + 子FEAT 文档 |
| `bugs/.template.md` | Bug 登记模板 |
| `summary/lessons_summary.md` | 从故障记录提炼的通用规范 |
| `troubleshooting/bug_shturl` | 历史故障复现、根因与修复记录（10条） |
| `bugs/BUG-20260728-001-*.md` | CubeMX 重新生成后手动 include 丢失 |
| `bugs/BUG-20260728-002-*.md` | Makefile C_SOURCES 缺少手动添加的源文件 |
| `bugs/BUG-20260728-003-*.md` | CubeMX 时钟树 PLLI2S_N/R 灰色不可编辑 |
| `bugs/BUG-20260728-004-*.md` | DOC-STATE 构建系统切换后漂移 |
| `bugs/BUG-20260815-001-*.md` | CubeMX 未配 Serial Wire 导致 SWD 锁死（P0 假砖） |
| `bugs/BUG-20260816-001-*.md` | I2S DMA Size 翻倍导致缓冲区溢出踩坏 RTOS（P0） |
| `bugs/BUG-20260816-002-*.md` | I2S 数据与 WS 槽 16SCK 偏移，取数须用高 16 位（P1） |
| `bugs/BUG-20260829-001-*.md` | 频谱假峰：宏 256u 与负均值混算，负值隐式转 unsigned（P1） |
| `bugs/BUG-20260829-002-*.md` | 裁剪版 HAL 无 I2C 文件，官方仓库 vendored 补齐（P2） |
| `bugs/BUG-20260829-003-*.md` | ISR 与任务并发 printf：输出交错 + HAL_UART 不可重入（P2） |
| `bugs/BUG-20260829-004-*.md` | 改掉 boot 契约字符串 I2S DMA started 前缀（P1） |
| `bugs/BUG-20260829-005-*.md` | OLED 手拼 I2C 控制字节帧违反手册，静默乱码（P1） |
| `bugs/BUG-20260829-006-*.md` | 调度器前 xQueueCreate 残留 BASEPRI→SysTick 灭→HAL_Delay 死循环（P0，OLED 黑屏真根因） |
| `bugs/BUG-20260830-001-*.md` | gdb detach 遗留停机态被误诊为固件挂死（P0 流程事故；沉淀 oocd_probe.ps1 非侵入探针） |
| `bugs/BUG-20260901-001-*.md` | CRC16 校验向量自造错误（0xF4D7/低字节先发 → 实为 0x1327/大端） |
| `bugs/BUG-20260902-001-*.md` | RS485 自发自收回环 HAL_TIMEOUT：预调度器期 SysTick 屏蔽 + 单 EN 半双工不可自发自收 |
| `bugs/BUG-20260914-001-*.md` | FreeModbus 保持寄存器帧地址 off-by-one → 假"越界 0x02/链路断" |
| `bugs/BUG-20260927-001-*.md` | OLED 偶发上电黑屏/灰屏但 I2C init 始终 OK，指向模块供电/电荷泵物理层 |
| `bugs/BUG-20261029-001-*.md` | 启用 sht30 后启动即复位循环：FreeRTOS 堆池耗尽，缺口仅 600 B（P0；含"钩子关中断+IWDG"与"改 .ld 不重链"两条通用教训） |
| `../firmware/flash_isp.bat` | ISP 串口救砖烧录（BOOT0 + USART1） |
| `../firmware/check_doc.bat` | DOC-STATE 漂移检测（双击运行） |
| `../firmware/check_doc_fix.bat` | DOC-STATE 漂移自动修复（双击运行） |
| `../firmware/build_and_flash.bat` | 一键编译 + 烧录（双击运行） |
| `../firmware/build.sh` | Git Bash 编译脚本 |
| `../firmware/flash.sh` | Git Bash 编译 + 烧录脚本 |

## 维护规则

新增文档才补充条目。空目录、占位文件不录入。修改文档同步更新对应条目。
