wumu-dot/SoundDog/docs/SoundDog-审核覆盖台账处置章程-2026-09-19.md

# SoundDog 审核覆盖台账处置章程（2026-09-19）

| 项目 | 内容 |
|---|---|
| 依据 | `SoundDog-审核覆盖台账与脚本审计-2026-09-19.md`（审查官，单一事实源） |
| 章程起草 | 执行方（用户 + TRAE） |
| 起草日期 | 2026-09-19 |
| 生效前提 | **本章程须经用户逐条确认后方可执行**；本章程不修改任何源码、不改动审计/复核报告文件 |

> 章程性质：把审核报告的发现（S1~S9 + D-1~D-11 + 批次3）转译为**可执行、带验证判据（R25）、带决策门**的处置计划。
> 纪律：任何条目开工前必须查三源（R27）；任何条目收工必须附证据（R21）；行号类回填一律回源码实证后再改。

---

## 0. 审核结论速览（审查官）

- ✅ **scripts 14 个 / 1298 行 全量已审**：复跑实证全通过（Mel 473/473、DCT 416/416、模型逐字节、防抖 6/6、CRC 0x0A84）；关闭审计报告 §4.6「Mel/DCT 同源」待办
- 🟠 **scripts 3 项逻辑/门禁缺陷**：S1 分支路径错位（非死代码，见 §2 复核更正）、S2 门禁从未被 CI 调用、S3 门禁盲区（Middlewares 被跳过）
- ⚠️ **probe 前置更正 1 处（复核 §3 补入）**：`portserial.c:230` RX 探针注释基准错误（`C4 0B` → 应 `84 0A`），重跑回环前 R25 前置，随拆探针一次做
- 🟡 **scripts 5 项小缺陷**：S4 import 副作用、S5 口径漂移风险、S6 串口参数缺失、S7 静默复位、S9 版本未锁
- 🔴 **docs 4 项误导项**：D-1 任务数过时、D-2 A4-04 状态互抵、D-3/D-4 0xA5 私有帧未回填 A5 系列
- 🟠 **docs 引用/数值失效 6 项**（D-5~D-11）+ 目录分层路径系统失效（4.3）+ 措辞未回填（4.4）
- ⚠️ **章程 §3~§9 回填核对**：§6（1.67V 裁决）❌ 仍未办，§3/§5 ⏳ 待硬件，其余 ✅
- 📋 **批次3（可选）**：FreeModbus port 层整文件审 + modbus/mb*.c 栈本体 + 门禁实跑（需 `make clean`，破坏性）

---

## 1. 处置优先级总览

| 优先级 | 条目 | 门类 | 依赖 |
|---|---|---|---|
| P1 | 章程第 2 节：S1 `ci_local.sh` 分支路径错位 | scripts | 用户批准改脚本 |
| P1 | 章程第 3 节：S2 门禁从未被 CI 调用 | scripts+CI | 用户批准改脚本 |
| P1 | 章程第 4 节：S3 门禁盲区（Middlewares/Drivers 跳过） | 门禁 | 用户批准改脚本 |
| P1 | 章程第 5 节：S4~S9 脚本小缺陷 | scripts | S9 需用户裁决建 requirements |
| P1 | 章程第 6 节：D-1~D-4 🔴 文档误导项 | docs | D-3/D-4 需 0xA5 去留决策 |
| P1 | 章程第 10 节：`portserial.c:230` 判读基准更正 | firmware 注释 | 随拆探针一次做 |
| P2 | 章程第 7 节：D-5~D-11 引用/行号失效 | docs | 无 |
| P2 | 章程第 8 节：目录路径失效（4.3）+ 措辞未回填（4.4） | docs | 无 |
| P2 | 章程第 9 节：§6 1.67V 裁决（延续 09-17 章程） | 文档+实测 | 硬件（新 ESP32） |
| P3 | 章程第 11 节：批次3（port 层整文件 + 门禁实跑） | 审 | 用户同意 `make clean` |

> ⚠️ **定级口径（复核观察①）**：本章程 P1 = 本轮脚本/门禁/文档类最高；区别于 09-16 报告"生产路径受影响"的固件级 P0（如探针残留、DMA 溢出）。本地 CI 脚本缺陷不改变固件行为。

---

## 2. 【P1】S1 `ci_local.sh` 分支路径错位（审核报告 §2.2-S1 + 复核 §2 更正）

### 2.1 现状
`scripts/ci_local.sh:4,13,26-33`：脚本头部 `set -eu`；`:13` 为 `cd "$SRC_DIR" && make clean && make -j6 all`。

**复核实测更正（原章程/台账"永不执行/死代码"被推翻）**：`set -e` 只对 `&&` 列表的**末命令**生效，中间命令失败豁免——

| 失败位 | 是否 `-e` 立即退出 | `:26-33` 分支 | `BUILD_OK` |
|---|---|---|---|
| `make -j6 all`（**末命令**） | ✅ 退出 | ❌ 不可达 | 未赋值 |
| `make clean`（中段，短路） | ❌ **不退出** | ✅ 可达 | `=1` |
| `cd "$SRC_DIR"`（首命令） | ❌ **不退出** | ✅ 可达 | `=1` |

**准确定性**：**分支路径错位**（非死代码）——编译**真正失败**（`make all` 非零）时脚本在 `:13` 退出，故障库检索分支被跳过；**仅当 `cd`/`make clean` 失败时该分支才触发**，与设计意图相反。**最常见"编译失败"路径恰恰丢了故障库提示** → 结论不变、仍须修。

### 2.2 处置（审查官建议）
把 `:13` 改为 `if ! ( cd … && make … ); then BUILD_OK=1; fi` 形式（保持 `set -e` 全局生效，仅该命令组豁免）。

### 2.3 验证判据（R25）
- [ ] 人为构造编译失败（临时加错误宏）→ 脚本**走到「检索故障库」分支**并给出提示，不静默退出
- [ ] 正常编译路径输出与改动前一致（回归）

### 2.4 决策门
- 改法（if 包裹 vs 临时 `set +e`）由执行方按审查官建议选 `if` 形式，用户可否决

---

## 3. 【P1】S2 门禁从未被 CI 调用（审核报告 §2.2-S2）

### 3.1 现状
`check_r19_zone.ps1`（R19 库修改豁免）、`check_r27_research.ps1`（R27 三源预研）**从未被任何 CI 脚本调用**（`ci_local.sh` 全文无 `ps1`/`powershell`）→ 两条红线门禁空转。

### 3.2 处置
在 `ci_local.sh`「规范检查」段后**追加调用**两条门禁（或显式声明"不接 CI"的原因并登记于文档）。

### 3.3 验证判据（R25）
- [ ] `ci_local.sh` 运行日志出现两条门禁的检查结果（R19 豁免清单 / R27 预研标记）
- [ ] 构造违反 R19 的改动（改 `portevent.c`）→ 门禁拦截，报错可读

### 3.4 决策门
- 接入方式（追加调用 vs 声明不接）**由用户裁决**

---

## 4. 【P1】S3 门禁盲区（审核报告 §2.2-S3 + §2.3）

### 4.1 现状
`check-doc-drift.sh:16` `SKIP_DIRS="lvgl\|Drivers\|Middlewares\|components\|node_modules"`：
- **`Middlewares` 整体跳过** → FreeModbus port 层（`portserial.c`/`portevent.c`，P2-10/13/14 所在）不在门禁视野（R19 恰对库修改提要求，却被门禁放过）
- **影响面比"仅 port 层"更广（复核观察③）**：`SKIP_DIRS` 在 `check-doc-drift.sh` 内被 **9 处**复用（`:47/54/60/63/66/74/82-84/107-108`），其中 `:107-108` 是 **`xTaskCreate`/`osThreadNew` 计数**（DOC-STATE `TASKS` 校验的输入）→ 跳过 `Middlewares` 意味着 port 层若新增线程**不会被计入 TASKS**（本项目 `mbRxRecv` 正好在 port 层，当前 4 是"恰巧对"）
- **`Drivers` 跳过** → `Src/system_stm32f4xx.c`（P2-9 晶振兜底）不在视野；而 `ci_local.sh` 单独查 `HSE_VALUE`，**两处口径不同**（门禁查 `hal_conf.h`，缺陷在 `system_stm32f4xx.c`）

### 4.2 处置
- 从 `SKIP_DIRS` 排除 `port/cmsis_rtos2`（最小改，把 FreeModbus port 层纳入门禁；因 `SKIP_DIRS` 被 9 处复用，**排除粒度直接决定 port 层线程是否计入 DOC-STATE `TASKS`**，须连同 §4.4 决策门一起审视）
- 统一 HSE_VALUE 检查口径：两处（门禁 vs `ci_local.sh`）改为同一检查点

### 4.3 验证判据（R25）
- [ ] 门禁能扫到 `Middlewares/.../port/cmsis_rtos2/portserial.c` 的变更（构造改动验证）
- [ ] HSE_VALUE 检查收敛到单一事实源（文档登记结论 + `grep` 实证）

### 4.4 决策门
- 排除粒度（仅 `port/cmsis_rtos2` vs 整 Middlewares 白名单）**由用户裁决**

---

## 5. 【P1】S4~S9 脚本小缺陷（审核报告 §2.2）

| # | 处置动作 | 验证判据（R25） |
|---|---|---|
| S4 | `gen_param_frames.py:99-125` 自检块移入 `main()` 或加 `if __name__ == "__main__":` 守卫 | `python -c "import gen_param_frames"` 输出 0 行（改前 12 行）；CRC 锁 0x0A84 仍 PASS |
| S5 | `simulate_debounce.py:14-17` 头部加声明「**仅当参数未被 RS485 改写（=默认值）时结论有效**」 | 脚本 docstring/头部有该声明；6/6 PASS 不回归 |
| S6 | `rs485_flood.py:12` 与另两脚本对齐：`dtr=False; rts=False` + try/except 可读报错 | 串口被占用时给出可读报错而非裸异常 |
| S7 | `serial_capture.py:17-22` 加失败提示（openocd 不在 PATH 时明确报"未复位"）；docstring 显著位置标注「会 `taskkill openocd` + 复位板子」 | openocd 缺失时不再静默误判；docstring 有警示 |
| S8 | `bug_shturl` 命名澄清（审核报告 §4.6）：确认是否 `bug_shorthand` 缩写；**若改名补 `.md` 须同步** `ci_local.sh:30`、`docs/INDEX.md:15,20,43`、`README.md:96` | 改名后全仓引用同步（grep 实证无悬空）；不改名则登记"保持现状" |
| S9 | 建 `requirements.txt` 锁 `sklearn==1.9.0` / `numpy==2.5.1`（AC-04 可复现性前提） | `pip install -r requirements.txt` 可复现；`--check` 逐字节比对仍 PASS |

### 5.1 决策门
- **S8**：改名补 `.md` vs 保持现状 —— 由用户裁决
- **S9**：现在建 `requirements.txt` vs 暂缓 —— 由用户裁决

---

## 6. 【P1】D-1~D-4 🔴 文档误导项（审核报告 §4.1）

| # | 位置 | 文档说 | 处置动作（以源码实证为准） |
|---|---|---|---|
| D-1 | `HANDOFF.md:100` | "1 个占位任务 defaultTask" | 改为 **4 个 `osThreadNew`**（default/Spec/Display/MBSlavePoll，`freertos.c:152/157/159/163`）+ port 层 `mbRxRecv`（`portserial.c:40`）；与 README:41、CLAUDE.md `TASKS=4` 对齐 |
| D-2 | `docs/features/INDEX.md:46` | FEAT-A4-04 = 🔴 未开始 | 标 🟢 已实装验收（`App/modbus_app.c` + `gen_param_frames.py` + `BUG-20260914-001`）；与 `维护地图.md:37` 对齐 |
| D-3 | `PROJECT_PLAN.md:310-339` §5.4 | 0xA5/0x5A 私有帧当 RS485 协议帧 | 标注**已废弃**改 FreeModbus RTU（依据 `FEAT-A4-04:27` + `BUG-20260901-001:47-50`）；去留细节见 6.1 决策门 |
| D-4 | `FEAT-A5-02/03/04`（3 篇） | 设计基线 = 帧头 0xA5/0x5A/CRC16 | 注记「协议换栈：0xA5 帧已被 A4-04 取代，**去留待决策**」（`BUG-20260901-001:50` 已明示） |

### 6.1 决策门（D-3/D-4 同一根因）
**0xA5 私有帧去留**——决策后二选一：
- ① 改文档：A5 系列标注废弃、规划 §5.4 回填 FreeModbus —— 纯文档
- ② 补 A5 设计：若 0xA5 后续要沿用，则补设计基线到 A4-04 之上 —— 需新设计
**由用户裁决**；裁决前不擅自改 D-3/D-4 正文。

---

## 7. 【P2】D-5~D-11 引用/数值失效（审核报告 §4.2）

统一动作：**以源码为准回填**（实证行号已在审核报告给出，改动前须回源码核对再落笔）：

| # | 位置 | 动作 |
|---|---|---|
| D-5 | `HANDOFF.md:165` | bug 记录数 5→**17**（`ls docs/bugs/BUG-*.md`）；bug_shturl 8→**10**；与 `docs/INDEX.md:43` 对齐 |
| D-6 | `HANDOFF.md:79/90` | A4-03/A4-04 由"在建/待挂"改**已收官**（`README.md:18`、`维护地图.md:33/37`） |
| D-7 | `docs/summary/lessons_summary.md:8,24` | 移除"暂无/<5 条"占位，改为已收录 **7 条**案例、bug_shturl **10 条** |
| D-8 | `README.md:111` | "RS485 回环 `#if 0` 封存"改**活代码**（`BSP/rs485_drv.c` 无 `#if 0`） |
| D-9 | `HANDOFF.md:45` | USART3 行号 `main.c:242` 回填为实际初始化位置 |
| D-10 | `docs/SoundDog-复核处置章程-2026-09-17.md:36,43,144` | 行号漂（NVIC 注释实为 190-196、`_write` 实为 114-127）——加声明「**行号以源码为准**」，不逐行改正文 |
| D-11 | `FEAT-A2-02:140` | 失效行号回填或改引用方式（`freertos.c`/`main.c` 部分）；BSP 层（`spectrum.c:18`、`fft.c:56`）仍准确不动 |

**验证判据**：每项改完 `grep` 对应关键词，确认新值与源码一致、无自相矛盾（对照 R25）。

---

## 8. 【P2】目录分层路径失效（§4.3）+ 措辞未回填（§4.4）

### 8.1 路径失效回填（迁移后 `App/`+`BSP/`）
确认为失效（FEAT"活引用"/影响文件表 + 2 篇根文档 + 2 篇 CubeMX 详解），统一 `Src/dsp/`→`BSP/`、`Inc/dsp/`→`BSP/`、`Src/main.c`→`App/main.c`、`Src/freertos.c`→`App/freertos.c` 等：
- `FEAT-A2-01`（6 处）、`FEAT-A2-02`（**12 处**，复核观察④ 更正，原记 11）、`FEAT-A2-04`（3 处）、`FEAT-A3-01`（1 处）、`FEAT-A3-02`（1 处）、`FEAT-A7-02`（1 处）、`FEAT-A7-03`（1 处）、`BUG-20260829-001`（1 处）、`HANDOFF.md:120,121`、`SoundDog-目前进度-2026-09-16.md:104`、`CubeMX_I2S3配置详解.md:579,735`
- **保留不动**（历史快照，当时确在 Src/）：`bug_shturl:7`、`BUG-20260728-001/002`、`BUG-20260816-001/002`
- **正确不动**（CubeMX 生成层）：`Src/i2c.c`、`Inc/pin_config.h`、`Src/stm32f4xx_*.c`

**验证判据**：全仓 `grep -E 'Src/dsp|Inc/dsp'` 无自研文件残留引用；`ls` 实证 `App/`/`BSP/` 路径全部存在。

### 8.2 措辞未回填
| 位置 | 动作 |
|---|---|
| `README.md:80`、`App/main.c:38` | "临界区/`taskENTER_CRITICAL`" → **osMutex**（`main.c:67-75/114-127/305-306`） |
| `HANDOFF.md:14` | "32 条规则 R0~R31" → 含 R32 + §7 表 R33~R41（`rules.md:169-183`） |
| `PROJECT_PLAN.md:365-380` §6 | A1~A4 路线图勾选（实际已收官）、A5 联调中 |
| `HANDOFF.md:43` | "新建 `BSP/param.c`" → 实为 `BSP/param.h`（由 `App/modbus_app.c` 承接） |

---

## 9. 【P2】§6 1.67V 裁决（延续 09-17 章程，❌ 未办）

- 现状：`硬件配置-2026-09-16.md:70`（漂浮电平=共地缺失）vs `目前进度-2026-09-16.md:57`（适配器正常中间电平）**两判据仍互抵**（审核报告 §4.5 实证）
- 处置：沿用 09-17 章程 §6 方案——**先验共地 → 同一参考地下量 A对地 / B对地 / A−B** → 裁决 → 两份文档同步更正
- 依赖：硬件实测（新 ESP32 到手后与 §3 补测一并做）
- 决策门：裁决结果出来后由用户拍板"共地缺失 vs 适配器中间电平"哪一判据成立

---

## 10. 【P1】`portserial.c:230` 判读基准更正（复核 §3 补入，前置项）

> 依据补记：本项源自审计报告 **§6.6④-1**（2026-09-19 更正后），原章程"依据"只写了台账所以漏转译。

- **现状**：`portserial.c:230` RX 探针注释仍写「8 字节 `01 03 00 00 00 01 C4 0B` = 帧完整」；该帧正确 CRC16 = **`0A 84`**（线上低字节先发 `84 0A`）；`C4 0B` 实为「读 2 个寄存器」帧的 CRC。
- **处置**：把注释基准 `C4 0B` 更正为 `84 0A`。
- **为何 P1（firmware 注释级）**：① 它是**重跑回环之前的 R25 前置**——链路通后板端必打印 `RX[8]: 01 03 00 00 00 01 84 0A`，按错基准判读会凭空制造"末字节被掐"的误诊（当前排查故障表征之一）；② 位于 probe 同文件同段，**与 P0-1/R38 拆探针同批一次做**最省事，单独留注释会被漏掉。
- **验证判据（R25）**：`grep -n "C4 0B" portserial.c` 无命中；注释基准与 `gen_param_frames.py` 复算 CRC（`01 03 00 00 00 01` → `0A84`）一致。
- **决策门**：随拆探针一次做（推荐），由用户裁决是否现在单独先改。

---

## 11. 【P3】批次3（可选，审核报告 §1）

- FreeModbus port 层整文件审（`portserial.c`/`porttimer.c`）+ `modbus/mb*.c` 栈本体
- 两个 `.ps1` 门禁内容审 + 实跑
- 门禁实跑前置 `make clean`（破坏性、清 build 目录），**须用户同意**才执行
- 决策门：是否执行批次3、何时执行 —— 由用户裁决

---

## 12. 执行纪律

1. **任何代码/脚本改动落盘前**：先按 R27 查三源（本项目内部行为 / Issue 区 / 坑清单）
2. **任何"完成"声称**：附构建日志 / grep 实证 / size 证据（R21）
3. **任何验证结论**：写明验证条件与判据（R25），不越级下结论
4. **审查官只读**：本轮 `firmware/`、`scripts/`、`docs/` 审查官一字未改；执行方改动须与审核报告条目一一对应
5. **行号类回填**：一律先回源码核对再落笔，改动后 `grep` 实证无悬空引用
6. **门禁/CI 改动**：改完必须跑一遍 `ci_local.sh` 验证不破坏现有检查
7. **0xA5 去留**：决策未定前不擅改 D-3/D-4 正文（§6.1）

---

## 13. 待用户确认的决策门（汇总）

| # | 决策 | 选项 |
|---|---|---|
| 1 | S1/S2 是否现在批准改 scripts（P1） | 是 / 否（先做文档） |
| 2 | S2 门禁接入方式 | 追加调用（推荐）/ 显式声明不接 |
| 3 | S3 排除粒度（连同 DOC-STATE `TASKS` 计数影响，复核观察③） | 仅 `port/cmsis_rtos2`（推荐）/ 整 Middlewares 白名单 |
| 4 | S8 `bug_shturl` 命名 | 改名补 `.md` + 全仓同步 / 保持现状 |
| 5 | S9 `requirements.txt` | 现在建（推荐）/ 暂缓 |
| 6 | D-3/D-4 0xA5 去留 | ① 改文档标注废弃（推荐）② 补 A5 设计 |
| 7 | §10 `portserial.c:230` 判读基准更正 | 随拆探针一次做（推荐）/ 现在单独先改 |
| 8 | 批次3（port 层 + 门禁实跑） | 执行 / 暂缓 |
| 9 | 本章程是否作为本轮执行基线 | 确认 / 修改 |

---

*本章程由审核覆盖台账与脚本审计报告转译，条目可追溯至 `SoundDog-审核覆盖台账与脚本审计-2026-09-19.md` 与 `SoundDog-审核覆盖台账处置章程复核-2026-09-19.md`（复核更正）对应小节。*
*执行方 ｜ 2026-09-19*
