wumu-dot/SoundDog/docs/features/FEAT-A7-06-能力矩阵与对比基线实验.md

# FEAT-A7-06 能力矩阵与对比基线实验（计划书）

- **文档状态**：🟡 **S1~S3 已落地；静/动各 1 h 基线已采集；噪声底残差实验与两级级联（提示级）已完成并烧录验证（2026-11-05）** —— 结果见 §13~§15；S4 故障工况仍待硬件，DR/TD 未测
- **出具**：审查官 ｜ **日期**：2026-11-01
- **上游**：`FEAT-A7-05-多源判据同构化与融合设计.md`（v2，三模块同构与融合）｜`FEAT-A4-02-距离实时比对.md`（MFCC 距离实测）｜`FEAT-A4-03-连续帧防抖.md`
- **背景**：评审反馈「检测能力有限、站不住脚」。根因不是实现不行，而是**评价口径错位**——拿 ISO 工业标准要求一个低成本节点，必然"这也不行那也不行"。本文把口径改为「**低成本边缘节点 + 多源可解释分诊**」，并用四组对比实验给出**增量证据**（"有用"要测出来，不是声称）。

---

## 1. 研究问题（论文口径，不是功能口径）

| # | 问题 | 为什么必须回答 |
|---|---|---|
| **RQ1** | 单靠声学（MFCC 距离）在**真实设备噪声**下的误报率是多少？ | 全项目唯一从未测过的定量证据（A7-05 M-1） |
| **RQ2** | 加入振动趋势量后，检出率 / 误报率是否改善？改善多少？ | 决定"第二通道"是否有存在价值 |
| **RQ3** | 两路共现升级（A7-05 §4.1）是否比"单源各自报警"更准、不更慢？ | 决定"融合"是否有语义增量 |

**非目标（明确写在论文里，不回避）**：

- ⛔ 轴承早期故障（需 500 Hz~10 kHz + 包络解调，本硬件不支持）
- ⛔ ISO 10816/20816 振动烈度分区对标（评价带 10~1000 Hz，本硬件带宽 10~250 Hz）
- ⛔ 故障定位 / 故障频率证据

---

## 2. 能力矩阵（按故障类型说，不按标准条款说）

| 故障类型 | 本平台 | 依据 |
|---|---|---|
| 不平衡（1×） | ✅ 可检 | 1500 rpm = 25 Hz，1× 落在 250 Hz 带内；mg RMS 抬升可测 |
| 不对中（2×） | ✅ 可检 | 2× = 50 Hz，带内 |
| 地脚松动（亚谐波/多阶） | 🟡 条件可检 | 0.5×≈12.5 Hz，需高通截止 ≤10 Hz 才保得住（P2a 实测确认） |
| 摩擦 / 异物 / 漏气（声学） | ✅ 可检 | MFCC 距离偏离；A4-02 实测金属 vs 正常判别比 **2.52×** |
| 宽带吹气类异常 | ⚠️ 不可分 | 与背景噪声同分布（A4-02 已归因，非 bug） |
| 轴承早期点蚀 | ❌ 不能 | 需高频包络，硬件不支持 |
| 电气 / 绕组故障 | ❌ 不能 | 无电流 / 本体温度信号 |

**口径换算（写进论文，替换"对标 ISO"的说法）**：

> 本节点适用 **≤1500 rpm 的中低速设备**：1×~3× 谐波（25~75 Hz）完整覆盖，最高可到 10×（250 Hz）。评价量取**加速度 RMS（mg）趋势**与**自建基线偏离**，不输出 ISO 振动烈度。

---

## 3. 三条硬边界（自己先说，别等评审问）

| # | 边界 | 论文中的正面表述 |
|---|---|---|
| B-1 | 加速度带宽上限 260 Hz（DLPF_CFG=0），实际落 10~250 Hz | "受传感器带宽限制，本方法面向中低速设备的转频谐波，不覆盖轴承高频带" |
| B-2 | SHT30 测环境空气，非设备本体 | "温度作为环境修正量（GB/T 755 温升定义要求本体测温，本节点不具备）" |
| B-3 | 声学对宽带噪声类异常不可分 | "MFCC 距离对稳态谱形状敏感，对与背景同分布的宽带噪声无效" |

---

## 4. 四组对比基线（E1~E4）

统一工况、统一指标、同一批数据回放，**只让"特征 + 判决"变化**：

| 组 | 方法 | 特征 | 判决 | 复用现有代码 |
|---|---|---|---|---|
| **E1** | 帧能量阈值 | 每帧 RMS / 峰值 | `rms > μ0+kσ0` | `i2s_drv.c` 帧数据，零改动 |
| **E2** | 频带能量距离 | `spectrum.c` 的 32 频带归一化向量 | 与正常模板欧氏距离 > 阈值 | `spectrum.c` + `model_normal`（需新增 32 维模板） |
| **E3** | MFCC 距离（**现状**） | MFCC 13 维 `d_min` | `d > th` + 防抖 | `dist.c` / `debounce.c`（现成） |
| **E4** | 多源融合 | E3 + 振动 mg RMS 趋势 | `max(s1,s2)` + 共现升级 | A7-05 §4.1（P3/P4 后可用）；**本科口径属加分项，非必做** |

**统一指标**（每工况独立统计）：

| 指标 | 定义 | 通过线 |
|---|---|---|
| **FAR** | 安静环境 1 h 误报次数 | ≤ 1 次/h（A7-05 AC-1） |
| **DR** | 3 次故障施加中，10 s 内报警的次数 | ≥ 2/3（AC-3） |
| **TD** | 故障施加 → 首次报警的延迟 | 相对 E3 不劣化 >5 s（AC-4） |

**预期结论（写进论文的论点，不是预设结果）**：E1 最迟钝、E3 对谱形状变化最敏感、E4 在不牺牲 FAR 的前提下抬高 DR —— **若实测不成立，就如实写"融合无增量"**，这也是有效结论（R25）。

---

## 5. 实现步骤（S1~S6）

### S1 定义 EVAL 行格式（0.2 天）

串口新增一行，**只读旁挂，不参与判决**：

```
EVAL,<tick_ms>,<d_x100>,<th_x100>,<rms_x100>,<pk_x100>,<band_sum>,<band_argmax>,<level>,<res_x100>
```

（实现定稿：9 字段逗号分隔，`rms/pk` 为原始 PCM（非加窗帧）的 ×100 定点，`bs/ba` 为 32 频带能量和与最大带号，`lv`=防抖状态 0/1。
**2026-11-05 追加第 10 字段 `res`**：§14 噪声底残差比 ×100（只读旁挂，旧脚本按 `len>=9` + 固定下标，追加不破坏兼容）。）

- 输出频率 **10 Hz**（每 10 帧一行），不是 100 Hz：115200 下现有 `SPEC/BANDS` 已占可观带宽，10 Hz 足以支撑秒级 TD 统计；
- `band_sum` / `band_argmax` 只是 32 频带的两个标量摘要，避免一行过长（完整 32 维由 PC 端用 `BANDS` 行补采）

### S2 固件旁挂输出（0.3 天）

| 文件 | 改动 |
|---|---|
| `App/freertos.c` | `SpecTask` 内每 10 帧追加一次 EVAL 打印；⛔ 不改 `debounce_process` 调用与参数 |
| `BSP/eval.h`（新增，可选） | 只放格式化宏，避免把拼接逻辑塞进 `SpecTask` |
| `sources.mk` | 若新增 `.c` 才需要登记（仅头文件则不用） |

### S3 PC 侧评测脚本（0.5 天）

新增 `scripts/eval_baselines.py`：

1. 读串口日志（复用 `scripts/collect_mfcc.py` 的前缀过滤与 CSV 落盘模式）；
2. 按工况标注切段（`normal` / `imbalance` / `loose` / `acoustic`）；
3. 离线重算 E1/E2/E3/E4 的分数与判决（阈值、防抖参数全部走配置文件，不硬编码）；
4. 输出 `eval_summary.csv`：行 = 工况 × 方法，列 = FAR / DR / TD。

> ⚠️ 该脚本必须能在**没有硬件**的情况下用已有 `data/*.csv` 跑通一半逻辑（至少 E2/E3 部分），避免"只有实物才能验证"的死结。

### S4 工况采集协议（1 天，需真实设备）

| 工况 | 做法 | 时长 | 重复 |
|---|---|---|---|
| 正常 | 设备稳态运行 | 10 min | 2 次 |
| 不平衡 | 联轴器贴配重 | 10 min（含施加时刻标注） | 3 次 |
| 松动 | 松一个地脚螺栓 | 10 min | 3 次 |
| 声学异常 | 轻触旋转件 / 放异物 | 10 min | 3 次 |
| 安静基线 | 设备停机、环境安静 | **60 min** | 1 次（M-1 用） |

每次采集必须记录：转速（或"未知"）、环境温度、传感器位置、施加时刻（秒级时间戳）。⚠️ **没有转速记录的振动数据不能用于 1×/2× 论证**。

### S5 结果表与图（0.5 天）

- 表：`工况 × 方法` 的 FAR/DR/TD（论文正文用）
- 图 1：E1~E4 的 ROC 或 FAR-DR 散点（阈值扫描）
- 图 2：不平衡工况下振动 mg RMS 随时间的曲线（证明 1× 谐波可测）
- 图 3：声学 `d_min` 与阈值对比曲线（支撑 MFCC 有效性）

### S6 回归验收（0.3 天）

- 编译零警告、`text` 增量 ≤ 2 KB（EVAL 打印不应显著膨胀）
- A4-04 Modbus 9 寄存器 `ok=9` 不下降
- 连续运行 30 min 无 HardFault / 无 IWDG 复位（关联 BUG-20261029-001）

**合计 ≈ 2.8 天（不含 S4 现场采集的排队时间）；本科口径去掉 E4 后 ≈ 2.5 天**

---

## 6. 数据记录规范（CSV 统一列）

```
ts_ms, frame_idx, label, d_min_x100, th_x100, rms_x100, peak_x100,
band_e_sum, band_e_argmax, vib_rms_mg, level, note
```

- `label` 由采集时人工标注，取值 `normal|imbalance|loose|acoustic|quiet`
- `note` 记施加时刻、转速、异常事件（换件/碰线）
- ⚠️ 缺列的数据一律不进入最终统计（曾出现 d/min 配对错位，见 FEAT-A4-02 日志）

---

## 7. 验收（AC）

| # | 通过线 |
|---|---|
| AC-1 | 四组方法在**同一批数据**上产出完整 FAR/DR/TD，无空缺 |
| AC-2 | 安静基线 60 min 内，E3 误报 ≤ 1 次/h（A7-05 AC-1 同源） |
| AC-3 | 不平衡 / 松动工况中，E4 的 DR 不低于 E3，或 FAR 不高于 E3（**二者至少一项有改善**，否则如实写"融合无增量"） |
| AC-4 | 所有对比均在固件判决路径**零改动**前提下完成（`debounce_process` 与 9 寄存器均不动） |
| AC-5 | 每条结论可追溯到 CSV 行号与采集时间；无"凭印象"结论 |
| AC-6 | 无测试遗留（临时脚本、调试开关、日志文件） |

---

## 8. 待定 / 风险

| # | 项 | 影响 |
|---|---|---|
| R-1 | 无转速信号（T-2） | 无法做"1× 跟随转速"论证；退化为"故障类型 × 可检性"定性结论 |
| R-2 | 只有一台设备 | 结论是"该设备上成立"，论文须标注样本量=1，不做跨设备泛化声明 |
| R-3 | 串口带宽 | EVAL 若 10 Hz 仍影响现有打印，降为 5 Hz（TD 粒度放宽到 200 ms，对秒级 AC 无影响） |
| R-4 | 振动通道未实现（A7-04 仍是计划） | E4 无法开跑；可先做 E1~E3，E4 待 A7-05 P4 后补 |

---

## 9. 培养层次口径（已确认：**本科**，2026-11-01）

> 用户确认本项目为**本科毕业设计**。据此收窄范围：**E1~E3 必做、E4 改为加分项**，不再要求统计显著性重复实验。

| 层次 | 最低要做的 | 加分项 |
|---|---|---|
| **本科（本次确认）** | **E1~E3 + M-1 误报率（安静 60 min）+ 能力矩阵**；结论写"可实现 + 有边界"即可 | E4 融合对比（需 A7-05 P4 完成后，约 +0.3 天） |
| 硕士（仅存档，不适用） | 必须含 E4 + 至少一项特征改进（1×/2× 谐波能量比或频带峭度），≥5 次重复 | 跨转速验证、误报-检出权衡曲线 |

**本科口径下的取舍（已写进 §5 估时）**：

- S1~S3 全保留（它们是"有没有证据"的分界线，不可省）
- S4 采集量不减（不平衡/松动各 3 次是 AC-3 的前提），但安静基线 60 min 可用"夜间静置一次跑完"
- S5 图表减为 **2 张**：`FAR/DR/TD` 汇总表 + `d_min vs 阈值` 曲线（图中不平衡工况的振动曲线移入加分项）
- 论文创新点落在「**低成本边缘节点的可解释异常检测**」，不落在"精度超过某方法"（本硬件无法支撑后者）

---

## 10. 执行记录（S1~S3，2026-11-01）

| 步 | 结果 | 证据 |
|---|---|---|
| **S1** | EVAL 行格式定稿为 9 字段（见 §5） | 本节格式块 + 固件 `snprintf` 格式串逐字一致 |
| **S2** | `App/freertos.c` 加旁挂输出：`mel_frame_cb` 每 10 帧打印 EVAL；`SpecTask` 每窗算 E1（PCM RMS/峰值）与 E2（频带和/最大带号） | **构建通过**；量测基线 `text 181732 / bss 115504` → 改动后 `text 182124 / bss 115608`，即 **+392 B text、+104 B bss**（≤ AC 预算 2 KB）。`debounce_process` 调用与 9 个 Modbus 寄存器**零改动** |
| **S3** | 新增 `scripts/eval_baselines.py`（仅标准库）：解析 dmin CSV（1 Hz）与 EVAL 日志（10 Hz），阈值扫描 μ+kσ，输出 `data/eval_summary.csv` | `--selftest` **5/5 PASS**（阈值换算/正常段零报警/故障即时触发/回落解除/分段计数）；在 `data/` 上跑出首版粗评表 |

**首版粗评（1 Hz 代理，k=3σ，正常段作 FAR 代理）**：

| 文件 | 工况 | 事件数 | FAR/h（外推） | 首次报警 |
|---|---|---|---|---|
| `dmin_normal2.csv` | normal | 1 | 52.94 | 54 s |
| `dmin_anomaly_metal.csv` | acoustic（金属） | 10 | 529.41 | 0 s |
| `dmin_anomaly2.csv` | broadband（吹气） | 0 | 0 | — |

> 读法与限制：三个文件都只有 **68 s**，FAR/h 是外推值，不能当 AC-2 的结论；`broadband` 0 次报警正是 A4-02 已归因的"宽带噪声不可分"，作为反例保留。**AC-2（安静 1 h ≤1 次/h）仍待 S4 补采**。
> 另：本次仅有 d 通道参与评测，E1/E2 需等 EVAL 日志（10 Hz）才能开跑——S2 已就绪，插上板子任意跑 10 min 即有数据。

---

### 10.1 EVAL 实测（2026-11-05，烧录后首次真机数据）

- 数据：`data/eval_normal_2026-11-04.log` —— **5998 采样 / 599.8 s / 10.0 Hz**
- 固件生产配置（`th=6.00` + 0.3 s/0.6 s 防抖）下 **`ALARM` 行 0 次**（与阈值的 `d>6.0` 共 53 行被防抖全部滤除）

| 特征 | μ | σ | CV | p50 | p99 | max |
|---|---|---|---|---|---|---|
| E3 `d` | 2.590 | 0.931 | **0.36** | 2.39 | 5.92 | 9.28 |
| E1 `rms` | 79.5 | 126.1 | 1.59 | 30.7 | 565.6 | 1710.5 |
| E2 `bs` | 12.95 | 25.88 | 2.00 | 7.0 | 101 | 1096 |

k 扫描（事件数，含 0.3/0.6 s 防抖）：

```
d   1σ:44  2σ:8   3σ:1   4σ:0   5σ:0   6σ:0
rms 1σ:46  2σ:19  3σ:12  4σ:8   5σ:4   6σ:3
bs  1σ:20  2σ:7   3σ:5   4σ:2   5σ:1   6σ:0
```

> **口径修正（重要）**：首版脚本把"连续越限"按 1 个采样算，而固件是 0.3 s（100 fps×30 帧）。10 Hz 日志里 1 采样只有 0.1 s ⇒ 毛刺全算报警，`d` 由 **1 次**虚增到 **121 次**。现已改为按时间换算（`--alarm-sec 0.3` / `--release-sec 0.6`）。**任何用 10 Hz 日志评 FAR 的结论都必须走这一口径**。

### 10.2 安静段（部分，采集中途暂停）

- 数据：`data/eval_quiet_2026-11-04.log` —— **14131 采样 / 23.6 min**（计划 60 min，**未跑完**）
- `d`：μ=2.510 / σ=0.765 / **CV=0.30**（比 normal 段更稳）
- **`ALARM` 行 6 条 = 3 次报警**（3 次 `on` + 3 次 `off`，每次持续 1~1.5 s）⇒ 外推 **≈7.6 次/h**，**AC-2（≤1 次/h）当前不通过**
- 三次报警的成因已判为**真实环境声事件**，非链路伪迹，见 §10.4

### 10.3 暂停时点与恢复方式

| 项 | 状态 |
|---|---|
| S1/S2 固件 | ✅ 已烧录并验证（EVAL 10 Hz 稳定输出） |
| S3 脚本 | ✅ 可用（`--selftest` 5/5）；口径已改为时间制防抖 |
| 60 min 安静基线 | ⛔ **中途暂停（23.6/60 min）**，数据保留，但不足 1 h，不能直接判 AC-2 |
| 故障工况（不平衡/松动/声学） | ⛔ 未采（S4 未做） |

恢复采集（端口空闲时直接跑，文件名带 `quiet` 才会被当成参考段）：

```
python scripts/eval_baselines.py --eval-log data/eval_quiet_2026-11-04.log --out data/eval_summary_quiet.csv
```

### 10.4 三次报警的成因判定（2026-11-05）

判定方法（§10.3 预留的判据）：看 `d` 飙升的同一时刻，`rms / pk / bs` 是否同步抬升。三者同升 = 真实声事件；只有 `d` 升而 `rms` 平 = 特征侧伪迹。

| # | 时刻 | d | rms | pk | bs | 判定 |
|---|---|---|---|---|---|---|
| 1 | 1554.2 s（25.9 min） | 3.83 → **7.13** | 56.5 → **156.9** | 355 | 153 | 真实声（中等） |
| 2 | 1909.3 s（31.8 min） | 2.25 → **11.72** | 821 → **922.8** | 1220 | 472 | 真实声（起点已偏高） |
| 3 | 1927.7 s（32.1 min） | 1.23 → **8.58** | 297 → **1289.6** | 1506 | 442 | 真实声（最强） |

**结论**：

1. 三次全部是 **`d`、`rms`、`bs` 同步抬升**，**没有**"仅 `d` 升而能量不变"的样本 ⇒ **排除 I2S/特征链路伪迹**。
2. 2、3 两次相隔 19 s，且第 2 次的起点 `rms` 已达 821（远超该段 μ=59）⇒ 环境本身在 32 min 前后有一段持续活动（人声/走动/搬动物件）。
3. 触发源均为 `src=mofn`（滑窗 30/100 帧），不是连续 30 帧 ⇒ 单次 1 s 量级的短促声音即可触发，这正是 0.3 s 防抖挡不住的部分。
4. ⇒ **AC-2 的失败应归因于"安静前提未成立"**，不是算法误报；但从可用性看，人走动/说话就能触发报警，说明当前 `th=6.00` 在该环境下偏松，或者判据需要限定频带（人声集中于 1~4 kHz，机械故障多在低频）。

> 因此 AC-2 有两种合规写法：① 在真正无人/隔声条件下重测 60 min；② 改写成"实验室环境 ≤ N 次/h"并如实标注环境条件。**不能**用当前 23.6 min 数据直接宣称通过或失败。

### 10.5 采集口径调整：安静段→活动段（2026-11-05）

采集开始约 10 min 时发现**环境已被人员活动污染**，据实测判断后调整口径：

| 指标 | 当前段（10 min） | 既有安静段（23.6 min） | 比值 |
|---|---|---|---|
| rms μ | **98.8** | 59.1 | **1.67×** |
| bs μ | **31.4** | 19.3 | 1.63× |
| d μ / CV | 2.37 / 0.39 | 2.51 / 0.30 | — |

⇒ 环境本底抬升 1.6~1.7 倍，**不能作为安静基线**（否则 μ/σ 被抬高，后续 FAR 偏乐观）。

**调整后的采集安排**：

| 段 | 文件 | 时长 | 工况标签 |
|---|---|---|---|
| part1 | `data/eval_quiet_2026-11-05.log` | 60 min | **activity**（文件名含 quiet 但需 `--label activity` 覆盖） |
| part2 | `data/eval_quiet2_2026-11-05.log` | 120 min | **activity** |
| 安静基线 | 待补（次日无人时段） | **3 h** | quiet（作参考段） |

**分析口径**：

- 活动段**不作参考段**，只用于评估"活动环境下的 FAR / 阈值取舍"
- 参考段（μ/σ）必须来自 3 h 安静段；在它到位前，活动段无法出 z-score 结论
- 脚本已支持 `--label` 覆盖，避免文件名推断污染（`eval_baselines.py`）

> ⚠️ 这不是"实验失败"：活动段本身就是必需的对照工况，用于验证双阈值/门控是否有效；缺的只是"安静参考"和"故障样本"两块拼图。

---

## 11. 方法适用边界与工业阈值对照（论文素材）

> 本节由 §10.4 的三次"真实环境声报警"引出：若附近有人工作就能触发报警，本方法在开放车间必然失效。
> 结论先行：**工业侧不是"把阈值调高"，而是换判据与换设定方式**；本方法适用面收窄为「受控近场单机监测」，必须写死。

### 11.1 工业界的阈值设定方式（有据可查）

| 体系 | 阈值怎么定 | 对本项目的含义 |
|---|---|---|
| ISO 10816/20816 分区 | A/B/C/D 四区；**ALARM 设在该机稳态基线之上**（基线 + Zone B 上界的 25%，通常 ≤125% 该边界）；新机无基线时先用同类设备经验值，**等稳定基线建立后再调整** | 阈值是"每台设备的"，不是通用常数 |
| 同标准的组别边界 | 小功率组（≤15 kW）：A/B 界 **0.71**、B/C **1.80**、C/D **4.50 mm/s** | 同一读数在不同设备上含义不同 |
| 声学异音（专利 CN122266394A） | **动态阈值 + 频带能量差 + 频带连续性验证** | 明确否定"单一绝对阈值" |
| 产线实践（工控网） | **按工况分段**而非单阈值；麦克风布点与抗噪是落地前提 | 单一模板 + 固定阈值不可部署 |
| 学术（ADS 低误报研究） | 把**低误报率**作为部署约束，配合 few-shot 适配 | 工业现场误报不可接受，需在线适配 |

**差距对照**：

| 维度 | 工业做法 | 本项目现状 |
|---|---|---|
| 阈值来源 | 每台设备自建基线 + 随工况调整 | 固定 `th=6.00` + 单一 600 帧模板 |
| 判据维度 | 频带 + 持续时长 + 转速阶次，多条件 AND | 单特征 `d` + 一个滑窗 |
| 工况 | 分段（启停/空载/满载） | 仅一套 |
| 传感 | 多点、方向性、抗噪布点 | 单个 INMP441，单点声学 |

### 11.2 实测证据：误报落在人声频带

`spectrum.c` 为 256 点 FFT、bin 宽 62.5 Hz（16 kHz 采样）、每 4 bin 聚 1 带 ⇒ **带号 b 覆盖 4b~4b+3 bin**。

- 带 9 ⇒ bin 36~39 ⇒ **2250~2437 Hz**
- §10.4 的报警事件中，`band_argmax = 9` 恰为峰值带

结论：这类误报的**主导能量就在人声共振峰区间**。⇒ 用**频带门控**（限制 1~4 kHz 权重）即可抑制，不必牺牲低频灵敏度。这比简单抬高 `th` 更划算，且论文章节有物理依据。

### 11.3 适用 / 不适用范围（建议直接写入论文）

| 适用 | 不适用 |
|---|---|
| 单台设备、近场（麦克风距声源 <30 cm） | 开放车间（多声源 + 人员走动） |
| 背景相对稳定、有明确"正常态"可建模板 | 变频 / 变载频繁工况 |
| 关注"是否偏离正常"，不要求故障定位 | 轴承早期诊断（带宽仅 10~250 Hz） |
| 振动通道：≤1500 rpm 的 1×~3× 谐波 | 任何"无人值守、要求零误报"的场合 |

**可用性判定条件（新场景上机前的自检）**：

1. 正常态连续 10 min 的 `d` 的 CV < 0.5（本项目实测 0.30~0.36，达标）；
2. 正常态与"有人走动/说话"两种状态的 `d` 分位数分得开（否则需频带门控）；
3. 背景噪声不随班次大幅漂移（否则必须做自适应基线）。

### 11.4 改造优先级（按性价比）

| # | 改造 | 成本 | 效果 | 验证方式 |
|---|---|---|---|---|
| 1 | **频带门控**：32 带中限制人声带（1~4 kHz）权重 | ~1 天 | 直接压掉 §10.4 这类误报 | 用已有 `eval_quiet` 日志离线复算，FAR 应显著下降而故障段 DR 不降 |
| 2 | **双阈值 + 时长约束**：预警/报警两级 + 最短 1 s 持续 | ~0.5 天 | 工业标配，压短促噪声 | `mofn` 基础上加最短持续，重跑 §10.4 三事件 |
| 3 | **自适应基线**：滑窗分位数跟踪，`th` 由绝对值改相对值 | 1~2 天 | 应对背景漂移/季节/负载 | 需两段不同背景数据对比（当前数据不足） |
| 4 | 工况标志（运行/停机两套基线） | ~1 天 | 需上位机或 PLC 给信号 | 依赖外部信号，本科可不做 |

> 建议先做 **1 + 2**（约 1.5 天）：这两项能把"人走动就报警"直接压掉，且都能用现有日志离线验证，不需要新采集。

### 11.5 论文表述建议（可直接改写）

> 本节点定位为**受控近场单机声学监测**，而非通用工业诊断系统。其适用前提是：设备背景噪声相对稳定、存在可采集的正常态样本、测点与声源距离在 30 cm 以内。在此前提下，MFCC 距离特征在三组对比基线中表现出最低的离散度（CV 0.36，对比帧能量 1.59、频带能量和 2.00），因而具备最低的误报倾向。方法不覆盖开放车间、变工况设备与轴承早期故障，相应限制已在 §7 明确列出。

⚠️ 不得在本节出现"工业通用""可替代振动分析仪"等表述——与 §7 能力边界和本节的适用条件直接矛盾。

### 11.6 来源

- [ISO 10816-3 全文（A/B/C/D 分区定义）](http://www.cemb-china.com/pdf/ISO%2010816-3%20Mechanical%20Vibration%20Measurements.pdf)
- [ISO 10816-7 全文（泵类分区）](https://nexgen-cableway.com/wp-content/uploads/2025/11/ISO-10816-7-2009.pdf)
- [ISO 10816-3 分区与 ALARM 设定方法（vibromera）](https://vibromera.eu/glossary/iso-10816-3/)
- [钢厂振动 ISO 10816 组别边界表（oxmaint）](https://oxmaint.ai/industries/steel-plant/steel-vibration-iso-10816-software-compliance-pdm-guide)
- [CN122266394A 基于听觉感知的异音检测（动态阈值 + 频带连续性）](https://eureka.patsnap.com/patent/CN122266394A)
- [听音质检误报率如何压到产线可接受（中国工控网）](http://www.gongkong.com/Info/202609/2471.html)
- [Few-Shot Adaptation for Anomalous Sound Detection at Low False-Positive Rate](https://arxiv.org/html/2610.19893v1)
- [车间高背景噪声下的无监督声学异常检测（MDPI）](https://www.mdpi.com/2079-9292/15/15/3363)

---

## 12. 三源核对：频带门控与迟滞判据（2026-11-05）

### 12.1 三源

| 源 | 来源 | 用途 |
|---|---|---|
| **① 标准 / 权威** | IEC 61672-1 频率计权（A 加权曲线）；ISO 10816 ALARM/TRIP 双阈值 | 确定"频带权重"与"两级阈值"的合法性 |
| **② 项目内** | `BSP/spectrum.c`（256 点 FFT、4 bin 聚 1 带）、`BSP/debounce.c`（连续 30 帧 / 滑窗 30/100） | 现状判据与可用数据 |
| **③ 交叉验证（可复用实现）** | `node-red-contrib-condition-monitoring`：**迟滞（防抖振）+ 连续样本数 + 退出死区百分比**；`python-acoustics`：IEC 61672 A 加权实现 | 迟滞逻辑与频带加权均为成熟实现，可照搬"逻辑" |

**复用边界（R28）**：逻辑与判据结构可复用；**具体阈值不得照搬**——它们是别人的设备/量程下的值，本项目必须用自测数据标定。

### 12.2 离线验证结论（`scripts/eval_gate.py`，23.6 min quiet 日志）

| 门控 | 阈值 | 报警事件 | 结论 |
|---|---|---|---|
| 无门控 | — | 6 次（15.3/h） | 基线 |
| 人声带占比上限 | `speech ≤ 0.70` | **4 次** | 只压掉 2 次，**效果有限** |
| 低频带占比下限 | `low ≥ 0.60` | **1 次** | 显著，但**未经故障验证** |
| 同上 | `low ≥ 0.80` | **0 次** | 疑似过度抑制，风险高 |

> ⚠️ **仿真口径偏差**：脚本按 10 Hz 复刻固件双轨（连续 3 采样 / 滑窗 10 采样内 3 个），且 `BANDS` 只有 200 ms 一条需沿用，因此得到 **6 次**，而固件实测是 **3 次**。**绝对值不可直接对比**，只可用同脚本内的"门控前 vs 后"相对变化；要复现固件绝对次数须用 100 Hz 级日志。

**判读**：

1. §11.2 的假设"误报落在人声带、门控即可解决"**只部分成立**：这些事件是**宽带**的（low 与 speech 同时抬升），人声带门控对 1555/1910/1929 三次无效。
2. 低频带门控确实能压掉大部分，但**没有任何一条真实故障样本**（不平衡/松动尚未采集）⇒ **无法证明不误伤**。若直接上 `low≥0.80`，可能把宽带机械异响一并挡掉。
3. 因此本轮**不把门控写进固件判决**。已落地的只有评测脚本，固件报警逻辑仍是 `d > 6.0` + 30/100。

### 12.3 由此得到的结论（比改造本身更重要）

> 人声/走动在**能量域**与"设备异响"高度重叠，**任何单麦克风 + 频带门控的组合都无法在保灵敏度前提下消除这类误报**。
> 工业界的解法是二选一：**① 背景噪声参考通道（第二麦克风做差分）**；**② 运行状态门控（只在设备运行时判）**。前者要改硬件，后者要外部信号——两者本科阶段都不具备。

**可执行方案（本科可选）**：

| 方案 | 做法 | 代价 | 能否用现有数据验证 |
|---|---|---|---|
| A | **双阈值分级**：`d>6` 只升"预警"，`d>8` 或"低频占比≥0.6 且持续 2 s"才升"报警" | 改判决时序，不改特征 | ✅ 可以（quiet 日志里 3 次会降级为预警、787 那组被时长滤掉） |
| B | 门控先只做"提示"，不参与报警 | 改一行 | ✅ 可以 |
| C | 门控正式参与报警 | 需真实故障样本标定 | ❌ 必须等 S4 |

> 建议：**A + B**（约 1 天）。C 需等不平衡/松动数据到手，否则是拿灵敏度赌误报。

### 12.4 来源

- [python-acoustics：IEC 61672-1 计权实现](https://python-acoustics.github.io/python-acoustics/_modules/acoustics/weighting.html)
- [python-acoustics：IEC 61672-1:2013 A 加权公式](https://python-acoustics.github.io/python-acoustics/_modules/acoustics/standards/iec_61672_1_2013.html)
- [node-red-contrib-condition-monitoring（迟滞 + 连续样本 + 退出死区）](http://raw.githubusercontent.com/blanpa/node-red-contrib-condition-monitoring/HEAD/CHANGELOG.md)
- [ST FP-AI-PREDMNT2（工业声发射监测参考实现）](https://www.st.com/en/embedded-software/fp-ai-predmnt2.html)
- [ECHO：频带感知的工业信号异常检测（开源）](https://arxiv.org/html/2508.14689v3)
- [ISO 10816-3 分区与 ALARM 设定](https://vibromera.eu/glossary/iso-10816-3/)

---

## 13. T1/T2/T3 完整结果（安静 1 h vs 活动 1 h，2026-11-05）

> 采集到此为止，不再追加上时长。本科口径下这 2 h 已够支撑"可检测 + 有边界"的结论；
> 统计置信不足的部分作为限制如实写明，不用"再采几小时"来补。

### 13.1 数据与口径

| 段 | 文件 | 时间 | 采样 | 时长 |
|---|---|---|---|---|
| **安静** | `data/eval_quiet_hour_2026-11-05.log` | 20:20:00–21:20:00 | 36000 | 60.0 min |
| **活动** | `data/eval_quiet_2026-11-05.log` | 19:04:19–20:04:19 | 35994 | 60.0 min |

- **FAR 权威值 = 固件 `ALARM` 行**（100 fps 原始防抖，`debounce.c` 双轨判据）
- 离线 10 Hz 回放（`eval_gate.py`）只用于阈值/门控的**相对比较**：安静段与固件一致（1 vs 1），
  活动段比固件多计约 4 倍（35 vs 9），原因见 §12.2（10 Hz 抽样 + 滑窗近似）
- 原定的第 2 段 2 h 活动采集在第 6 min 被中止，数据不计入本节
- 仓库只保留本文用到的两份 **1 h 证据日志**（安静/活动）；11-04 的过程日志（含被污染段、6 min 残片）
  留在本地不入库，`.gitignore` 用例外规则保留两份正式日志

### 13.2 特征基线（μ / σ / CV）

| 段 | d μ | d σ | d CV | rms μ | bs μ |
|---|---|---|---|---|---|
| 安静 | **1.90** | **0.53** | **0.28** | 52.6 | 13.1 |
| 活动 | 2.49 | 1.00 | 0.40 | 96.5 | 32.6 |

> 活动段的 d 均值只升 31%，但 **σ 翻倍、CV 从 0.28→0.40**：环境声抬高的是离散度，
> 不是整体平移 —— 这正是"固定阈值在开放环境失效"的定量证据。

### 13.3 T1 误报率（FAR）

**固件口径（权威）**

| 段 | 报警次数 | FAR |
|---|---|---|
| 安静 | 1（`src=mofn`，20:36:45） | **1.0 次/h** |
| 活动 | 9（9 on / 9 off） | **9.0 次/h** |

**离线阈值扫描（10 Hz 回放，仅作相对比较）**

| 阈值 | 安静 | 活动 |
|---|---|---|
| 6.0 | 1 | 35 |
| 6.5 | 0 | 21 |
| 7.0 | **0** | 11 |
| 7.5 | 0 | 5 |
| 8.0 | 0 | **0** |
| 9.0 | 0 | 0 |

> 置信区间（如实写）：安静段 1 h 内 1 次事件，Poisson 95% 区间 **0.03–5.6 次/h**。
> 因此 AC-2 只能写"**点估计 1 次/h**"，不能宣称"已证明 ≤1 次/h"。

### 13.4 T2 频带门控（离线，th=6.0）

| 门控 | 安静事件 | 活动事件 |
|---|---|---|
| 无门控 | 1 | 35 |
| speech ≤ 0.70 | 1 | 28 |
| speech ≤ 0.50 | **0** | 10 |
| low ≥ 0.60 | **0** | **1** |
| low ≥ 0.80 | 0 | 0 |

> 解读：安静段本来只有 1 次，门控"压掉它"没有统计意义；活动段 `low≥0.60` 可把 35→1。
> 但**灵敏度代价仍无数据**（无故障样本），所以门控只能按 §12.3 方案 B 做"提示"，不参与报警。

### 13.5 T3 事件明细

**安静段唯一一次报警**

| 时刻 | 时长 | d（连续 3 帧） | rms | pk | bs | low / speech / high |
|---|---|---|---|---|---|---|
| 20:36:45 | 0.6 s | 9.22 → **10.73** → 6.27 | 159.4 | 308 | 146 | 0.16 / 0.49 / 0.36 |

> `rms` 同步升到本段 μ 的 3 倍 ⇒ **真实瞬时声**（关门/碰物一类），非 I2S/特征链路伪迹。

**活动段（离线 35 次，按时间聚成 3 簇）**

| 时间段 | 次数 | 特征 |
|---|---|---|
| 19:16:24 | 1 | 单发，speech 0.72 |
| 19:47:47–19:49:39 | 12 | speech 0.6~0.8 为主，典型人声 |
| 19:59:23–20:02:10 | 12 | 含最强 #30（`rms` 1225.9）与 #31（d 9.25 / `rms` 359.8） |

### 13.6 阈值与判决建议（本科口径，不再追加采集）

| 项 | 建议 | 依据 |
|---|---|---|
| 生产阈值 | **保持 th=6.0** + 0.3/0.6 s 防抖 | 安静 1 次/h，可接受；th=7.0 更保守但会降灵敏度 |
| 门控 | 只做 `low≥0.60` **提示**，不改报警 | 活动段可压到 1 次，但无故障样本无法证明不误伤 |
| 论文表述 | 写"安静 1 h 点估计 1 次/h，95% 上界 5.6 次/h" | 样本量=1 h，不得宣称 AC-2 严格达标 |

### 13.7 本节结论（可直接进论文）

1. **安静 / 活动误报比 = 1 : 9（固件口径）** —— 检测器的"灵敏度"在开放环境会被环境声淹没，这是适用边界的量化证据。
2. **误报源是真实环境声，不是链路伪迹** —— T3 中 `d / rms / bs` 同步抬升，链路伪迹不会带能量。
3. **频带门控在活动段有效（35→1），但只在离线口径成立**；正式启用需 S4 故障样本证明不误伤。
4. 证据链完整度（本科）：能力矩阵（§2）+ 静/动基线（§13）+ 事件明细（§13.5）+ 边界（§3/§11）。
5. 未完成项如实标注：S4 故障工况（DR/TD）、振动通道（E4）、3 h 安静基线的统计强度。

---

## 14. 实验 B：噪声底跟踪 + 残差确认（2026-11-05）

> 起因：评审问题「故障的频带和能量与正常噪声不同，为什么不做滤波」。
> **结论先行**：简单噪声底归一化确实能压掉活动误报（离线 35→1 次/h），但**不能单独当报警判据**——
> 它会把真实瞬态一起压掉，且持续故障会被底噪慢慢吸收。

### 14.1 方法

| 项 | 做法 |
|---|---|
| 数据 | `BANDS` 32 带（实测 **4.8 Hz**）+ `EVAL` 10 Hz；时间对齐取最近一条 EVAL tick（误差 ≤100 ms） |
| 噪声底 | 每频带 **1 s 块最小值 + 每秒 2% 上升泄漏**（背景降得快、升得慢） |
| 残差比 | `(Σ带能量 + 32) / (Σ噪声底 + 32)`，伪计数防 1 LSB 量化爆表 |
| 防抖 | 与固件同构（0.3 s 连续 / 1 s 内 0.3 s；解除 0.6 s）；4.8 Hz 下 0.3 s 只能取整到 2 采样 |
| 脚本 | `scripts/eval_residual.py` |

### 14.2 残差比分布（自适应底）

| 段 | p50 | p90 | p99 | max |
|---|---|---|---|---|
| 安静（全带） | 0.67 | 0.80 | **1.40** | 9.17 |
| 活动（全带） | 0.80 | 1.60 | **3.33** | 41.36 |
| 安静（低频） | 1.49 | 2.22 | 4.60 | 41.02 |
| 活动（低频） | 1.79 | 4.30 | 9.88 | 114.30 |

> 全带残差把"安静 vs 活动"的 p99 拉开 **2.4 倍（1.40 vs 3.33）**，这是 `d`（安静 3.62 vs 活动 6.22）之外的第二条可分证据。

### 14.3 单独作判据（残差 > τ，4.8 Hz 防抖）

| τ | 活动事件/h | 安静事件/h |
|---|---|---|
| 2.0 | 213 | 11 |
| 2.5 | 83 | 6 |
| 3.0 | 37 | 4 |
| 3.5 | 19 | 2 |
| 4.0 | 10 | 2 |
| **5.0** | **4** | **1** |
| **6.0** | **3** | **1** |
| 8.0 | 1 | 0 |

> τ=5~6 时活动 3~4 次/h，相对 `d` 的 35 次/h 改善 **9~12 倍**，安静段保持 1 次/h。
> 但 τ 必须按设备标定，且没有故障样本时无法判断它是否把故障也压掉了。

### 14.4 级联判据（`d>6` 触发 + 残差确认）

| 段 | d 事件 | τ=3 | τ=4 | τ=5 |
|---|---|---|---|---|
| 安静 | 1 | **1** | **1** | **1** |
| 活动 | 35 | 2 | **1** | 1 |

> 这是本次实验最有价值的配置：**保留 `d` 的灵敏度作为一级判据，用残差做二级否决**。
> 活动段 35→1（离线），安静段那一次真实瞬态保持不被压掉。

### 14.5 结论与风险

1. **能滤波**：不是 FIR/IIR，而是"噪声底归一化"；全带残差 p99 安静 1.40 / 活动 3.33，可分。
2. **级联最优**：`d>6` + 残差 `τ=4` 时，活动 35→1、安静 1→1（离线口径）。
3. **低频带残差不可用**：τ=4 时安静段仍 50 次/h —— 1 LSB 量化 + 门限附近抖动，不能代替时域 `d`。
4. **风险**：① 持续 >1 min 的故障会被 2%/s 的泄漏慢慢吸收；② 无故障样本 ⇒ DR 未验证；
   ③ 离线 10 Hz 回放比固件多计（活动 35 vs 9），绝对值只看相对变化（同 §12.2）。
5. **建议**：级联先做"**提示级**"（不改报警），报警级保持 `d>6`；等 S4 故障样本再决定是否升级。

### 14.6 实现（提示级，已编译通过 2026-11-05）

- 位置：`App/freertos.c` —— `SpecTask` 每窗调 `residual_update(bands, tick)`（62.5 Hz），
  `mel_frame_cb` 在**报警触发沿**抓取残差并标记 `conf`
- 输出：`ALARM on src=mofn n=30 conf=1 res=415`（`conf=1` 确认 / `0` 疑似；`res` 为比值 ×100）
- **EVAL 追加第 10 字段 `res`（10 Hz）**：`EVAL,<t>,<d>,<th>,<rms>,<pk>,<bs>,<ba>,<lv>,<res>`；
  实测 450 行全部 10 字段、无短行，`res` 稳态中位 ≈ 0.95（比值≈1，符合"背景=底噪"预期）
- ⚠️ **τ 需按固件口径重标**：固件在 62.5 Hz 更新底噪，离线标定用的是 4.8 Hz 的 `BANDS` 快照
  （采样越密 → 块最小值越低 → 同一环境 `res` 偏高：本次 45 s p50 0.95 / p90 8.98，离线活动段 p90 仅 1.60）。
  故 `τ=4.0` 只是暂定值，正式值需用**新日志（含 res）**重标；`conf` 仅提示，不影响报警
- 成本：`text +496 B`、`data +4 B`、`bss +272 B`（基线 182124/256/115608 → 182620/260/115880）
- 判决边界：⛔ 不改 `debounce_process`、不改 9 个 Modbus 寄存器；`conf` 只写串口
- 烧录注意（2026-11-05 实测）：IWDG 超时约 1 s，`reset halt` 时固件尚未执行 `__HAL_DBGMCU_FREEZE_IWDG()`，
  烧写会被看门狗复位打断（`flash write algorithm aborted by target`）→ 需先 `mww 0xE0042008 0x00001000`
  冻结 IWDG，再 `program ... verify`（已验证 OK）
- 状态：**已烧录并验证**（EVAL 10 Hz / BANDS 4.8 Hz / DMIN 1 Hz 正常，无 HardFault）；
  `conf/res` 字段只在真实报警沿出现，安静段可能 1 h 才 1 次

---

## 15. 三源核对：两级级联（`d` 触发 + 残差确认）是否成立

> 目的：确认 §14 的两级级联不是"自己拍脑袋加的功能"，而是有标准/成熟实现/文献支撑的做法。
> 结论：**成立**，但必须写明它与工业标准的**语义映射**与**两处差异**。

### 15.1 三源

| 源 | 内容 | 对我们的支撑 |
|---|---|---|
| ① 标准 | ISO 10816/20816 的限值体系分 **ALERT / ALARM / TRIP** 多级；相对判据常用 **2~3 倍为警示、5~6 倍为异常** | 两级不是新发明；"相对基线的倍数"即我们的残差比 |
| ② 成熟实现 | **Martin (1994) minimum statistics**：用平滑功率谱的时域最小值估计噪声底，是语音增强的标准前置（SOF/RTNR 亦如此）；行业分析把 **two-stage alarm confirmation** 列为"结构上最成熟的反误报手段" | 我们的 1 s 块最小值 + 2%/s 泄漏是它的简化版；二次确认的思路同源 |
| ③ 交叉 | DCASE Task 2 用**只用正常数据**的 target-aware 阈值；专利 US12669412B2 用两阶段机器异常检测 | 设备相关阈值、两阶段结构均有先例 |

### 15.2 对照

| 我们的做法 | 对应标准/实现 | 吻合度 |
|---|---|---|
| 一级 `d>6` 触发 | ALERT（警示） | 语义吻合（我们一级只产生"候选/疑似"） |
| 二级 残差 > 4 确认 | ALARM（报警）/ 二次确认 | 吻合；且二级用的是**另一个特征**，不是"更高的 d 阈值" |
| 阈值相对近期底噪 | ISO 相对判据 2~3× 警示、5~6× 异常 | τ=4 落在两者之间，量级合理 |
| 1 s 块最小 + 2%/s | Martin minimum statistics | 原理一致；**未做偏差补偿**，是简化版 |

### 15.3 结论与两处必须写明的差异

1. **成立**：多级限值、二次确认、相对基线三点都能在标准与工业实现里找到对应，不是自创。
2. **差异一（结构）**：二次确认必须用**不同特征**才叫"错误纠正"；若二级只是把 `d` 阈值从 6 提到 8，那只是保守化，不是级联。我们用 MFCC 距离 vs 频带相对能量，属于不同特征，成立。
3. **差异二（适用域）**：底噪跟踪是为**噪声**设计的（语音增强），不是为**故障**设计的；用它做故障监测，持续 >1 min 的故障会被吸收，因此只能做"提示级"，报警级仍由 `d>6` 承担。
4. **数据侧**：离线口径下活动 35→1 次/h、安静 1→1 次/h（§14.4），与上述结构判断一致。

### 15.4 来源

- [ISO 10816-21:2015（ALERT / ALARM / TRIP 限值体系）](https://www.iso.org/obp/ui#!iso:std:60328:en)
- [ISO 20816-1:2016（机械振动测量与评价总则）](https://www.iso.org/obp/ui/es/#!iso:std:84280:en)
- [振动感测器型录（相对判据：2~3 倍警示、5~6 倍异常）](https://www.mactech.com.tw/archive/product/item/files/%E6%8C%AF%E5%8B%95%E6%84%9F%E6%B8%AC%E5%99%A8%E5%9E%8B%E9%8C%84.pdf)
- [Martin, Spectral Subtraction Based on Minimum Statistics (1994)](http://ikspub.iks.rwth-aachen.de/pdfs/martin94b.pdf)
- [SOF RTNR：minimum statistics 噪声底估计](https://thesofproject.github.io/latest/developer_guides/firmware/rtnr.html)
- [Reducing False Alarm Rates in AI Anomaly Detection（two-stage alarm confirmation）](https://www.patsnap.com/resources/blog/articles/reducing-false-alarms-in-ai-anomaly-detection-systems/)
- [US12669412B2：两阶段机器异常检测](https://eureka.patsnap.com/patent/US12669412B2)
- [DCASE 2026 Task 2：target-aware thresholding](https://dcase.community/documents/challenge2026/technical_reports/DCASE2026_Zhou_15_t2.pdf)

---

*出具：审查官 ｜ 2026-11-01（S1~S3）｜ 2026-11-05 追加真机实测（S4 部分）、§11 适用边界、§12 三源核对与门控验证、§13 静/动 1 h 结果、§14 噪声底残差实验、§15 两级级联三源核对*
