wumu-dot/SoundDog/docs/features/FEAT-A5-02-协议帧打包解析.md

# FEAT-A5-02-协议帧打包解析

> **AI 执行规则**：必须按阶段顺序执行，每个阶段开头声明角色。严禁跳跃、越界、自审自判。
> 阶段间停等：每完成一个阶段，停下来，输出结果，等人说"继续"。
> 阶段5通过后：回填父FEAT项目表该行 + 更新 `docs/features/INDEX.md` + `docs/features/维护地图.md`。
> 历史记录只更新状态字段，严禁删除/篡改已完成记录。
> 事实来源：`.sop-agent规格.md` §3（禁止自造数值；未覆盖项写"待定（需人确认）"）。

## 0. 元数据
- **父FEAT**：FEAT-A5-RS485通信
- **优先级**：P1
- **预估总耗时**：2h（父FEAT 预算 8h 内拆分）
- **当前状态**：🔴未开始（傻瓜式操作单已备好，依赖 A5-01 通过后开跑）

## 1. 总体目标与硬边界

### 1.1 核心目标（一句话）
> 在 A5-01 打通的 USART3+RS485 通道上实现**协议帧打包/解析**（帧头 0xA5 / 帧尾 0x5A / CRC16），非法帧可拒绝，为 A5-03 双向收发与 A5-04 轮询提供统一帧格式。

### 1.2 地基触碰前置自检
- [x] 否 → 继续（App 层状态机 + HAL 标准库，不碰 `firmware/Drivers/`）

### 1.3 任务边界
| 类型 | 具体内容 |
|---|---|
| 范围内（可改） | 新增协议模块文件（帧打包/解析 + CRC16，文件名待定（需人确认））、`Makefile`（C_SOURCES 补源文件）、A5-01 驱动接口调用 |
| 超出范围（禁止碰） | `firmware/Drivers/` HAL 底层库；帧格式/CRC16 参数**未确认前**不得自定（须人确认） |
| 外部依赖 | A5-01 已通过（USART3+RS485 回环可用）、SSCOM（USART1 调试口 115200） |

### 1.4 关键参数与接口（事实包 §3，禁止自造）
- **帧头 = 0xA5**；**帧尾 = 0x5A**；**CRC16**（事实包 A5-02）。
- 传输通道：USART3 + TTL-RS485（半双工，115200，A5-01 打通）。
- 调试打印走 USART1（115200）。
- **待定（需人确认，缺一不可，确认前禁止实现**：
  - CRC16 具体参数：多项式 / 初值 / 位序（左移 or 右移）/ 字节序（高字节在前 or 低字节在前）——事实包只写"CRC16"。
  - 帧格式字段定义：是否含长度域 / 地址域 / 命令域 / 负载定义——事实包未给。
  - 超时 / 重传策略——事实包未给。
  - 负载长度上限——事实包未给。

## 2. 执行路线图（5 阶段）

### 🟢 阶段 1：准备（角色：Dev Agent）
- **读什么**：A5-01 文档（驱动接口）、`CLAUDE.md`（硬边界）、`.sop-agent规格.md` §3.6 A5-02（帧头/帧尾/CRC16）
- [ ] 步骤1：确认 A5-01 已通过（回环可收发）
- [ ] 步骤2：列出协议**待定项清单**（§1.4），输出给人确认
- [ ] 步骤3：输出影响范围（新增协议模块 / Makefile / 调用点）
- **判定标准**：待定项清单已列全、A5-01 状态已核实
- **⏸️ 停等：人确认待定项（帧格式 + CRC16 参数）后进入阶段 2**

### 🔵 阶段 2：设计（角色：Dev Agent）
- **阶段目标**：产出帧格式定义 + 打包/解析状态机设计 + 傻瓜式操作单（§3）
- [ ] 步骤1：按已确认参数设计帧格式（帧头/长度/地址/命令/负载/CRC16/帧尾）
- [ ] 步骤2：设计解析状态机（逐字节扫描：找帧头 → 收负载 → 算 CRC → 校验帧尾与 CRC → 判定合法/丢弃）
- [ ] 步骤3：设计接口签名（Pack / Parse / 非法帧丢弃计数，签名待定（需人确认））
- **判定标准**：帧格式表已产出、状态机已产出、接口签名已产出
- **⏸️ 停等：人确认后进入阶段 3**

### 🟠 阶段 3：实现（角色：Dev Agent）
- **阶段目标**：写代码，每改完一个文件对照 §4 自检
- [ ] 步骤1：实现 CRC16（按已确认参数）
- [ ] 步骤2：实现打包（Pack）与解析（Parse）+ 非法帧丢弃计数
- [ ] 步骤3：`Makefile` C_SOURCES 补源文件（BUG-002 教训）
- [ ] 步骤4：`firmware\build.bat` 编译，期望无错误退出、无新增警告
- **判定标准**：编译通过
- **⏸️ 停等：人确认后进入阶段 4**

===== 切换至 Test Agent =====

### 🟣 阶段 4：测试（角色：Test Agent）
- **阶段目标**：独立验证——按 §3 操作单逐条跑，核对 §4 验收标准
- [ ] 步骤1：按 §3.2 打包自测：合法帧往返一致（AC-01）
- [ ] 步骤2：按 §3.3 解析负例：4 种篡改全部被拒绝（AC-01）
- [ ] 步骤3：边界用例：空负载帧 / 最长负载帧（AC-01）
- [ ] 若失败 → 退回阶段 3
- **⏸️ 停等：人确认后进入阶段 5**

===== 切换至 Review Agent =====

### 🔴 阶段 5：审查（角色：Review Agent）
- **阶段目标**：独立审查——AC 逐条打勾
- 全部通过 → ✅ 回填「维护与调试」+ 父FEAT项目表 + INDEX + 维护地图
- 未通过 → 退回对应阶段并附意见

## 3. 傻瓜式操作单（照做即可）

### 3.0 物品/工具清单
- [ ] 核心板（A5-01 已通过，USART3+RS485 回环可用）
- [ ] SSCOM（USART1 调试口，115200；COM 以设备管理器为准）
- [ ] ST-Link（SWD 烧录，如需重烧）
- [ ] 已确认的帧格式定义与 CRC16 参数（§1.4 待定项的人确认结果）

### 3.1 帧定义确认（先做！全部来自人确认结果，禁止自造）
1. 记录 CRC16 参数（多项式/初值/位序/字节序）：______
2. 记录帧格式（字段顺序与长度）：______
3. 记录负载长度上限：______
4. ⚠️ 任一项未确认 → **停，不得进入 §3.2**，回报人补齐。

### 3.2 打包/解析自测（合法帧往返，阶段 4 执行）
1. 构造 1 帧，负载 2 字节（如 0x01 0x02）：期望输出
   `0xA5 [负载] [CRC16 字节序按 §3.1] 0x5A`。
   记录：打包输出（完整字节序列）：______
2. 将上述帧喂回解析器：期望解析成功、CRC 校验通过。
   记录：解析结果：成功 / 失败；负载还原：______
3. 连续打包-解析往返 100 次：期望 100 次全部一致。
   记录：失败次数：___/100

### 3.3 解析负例与边界（阶段 4 执行）
对同一合法帧，逐项篡改后喂入解析器，期望**全部被拒绝**（丢弃，不误判为合法）：
| 篡改方式 | 期望 | 记录（拒绝=✓ / 误收=✗） |
|---|---|---|
| 帧头 0xA5 改错 | 拒绝 | ☐ |
| 负载 1 字节改错 | 拒绝（CRC 错） | ☐ |
| CRC16 字节改错 | 拒绝（CRC 错） | ☐ |
| 帧尾 0x5A 改错 | 拒绝 | ☐ |
| 空负载帧 | 按帧定义接受或拒绝（记录结论） | ☐ |
| 负载超上限帧 | 拒绝（长度超限） | ☐ |

### 3.4 故障速查表
| 现象 | 可能原因 | 处理 |
|---|---|---|
| 合法帧往返不一致 | 打包/解析字段顺序错 | 对照 §3.1 帧格式逐字段核对 |
| CRC 校验全部失败 | 多项式/初值/位序/字节序与收发双方不一致 | 核对 §3.1 记录值与两端实现一致 |
| 帧头帧尾识别错 | 帧格式双方定义不一致 | 核对 §3.1；确认未确认项已补齐 |
| 解析器误收篡改帧 | 未校验帧尾/CRC/长度 | 退回阶段 3，补全校验路径 |
| 半双工下收发冲突 | 发完未等回复就再发 | 发完一帧等对方回复或超时后再发（A5-04 细化） |

## 4. 验收标准（12 条）

### 功能验收
- [ ] AC-01 打包-解析往返 100 次全部一致，且 4 类篡改（帧头/负载/CRC/帧尾）全部被拒绝（§3.2/§3.3 记录）
- [ ] AC-02 向后兼容：A5-01 回环收发仍正常，不破坏已有链路

### 代码质量
- [ ] AC-03 编译通过：`firmware\build.bat` 无错误退出
- [ ] AC-04 无新增警告
- [ ] AC-05 文档已更新：帧格式与 CRC16 参数写入本 FEAT 维护章节

### 安全红线
- [ ] AC-06 N/A：无密钥；帧头/帧尾为协议常量，非密钥
- [ ] AC-07 错误处理：非法帧丢弃有计数（记录丢弃数），解析不崩溃
- [ ] AC-08 输入校验：解析器对帧头/帧尾/CRC16/长度逐项校验，非法帧有明确拒绝路径

### 测试与边界
- [ ] AC-09 测试：PC 端构造帧批量验证脚本（脚本路径待定（需人确认））；若未建立自动测试 → 手动验证并记录
- [ ] AC-10 回归：`./scripts/ci_local.sh` 通过（若适用）
- [ ] AC-11 N/A：嵌入式手动验证，覆盖率不适用
- [ ] AC-12 按 FEAT 模板执行（本文件即模板产物）

## 5. 维护与调试（阶段5通过后回填）

### 5.1 影响文件
| 文件 | 改动类型 | 说明 |
|---|---|---|
| `firmware/soundDog/Src/proto_drv.c` / `Inc/proto_drv.h` | 新增 | 帧打包/解析 + CRC16（文件名待定（需人确认）） |
| `firmware/soundDog/Makefile` | 修改 | C_SOURCES 补协议源文件（BUG-002 教训） |
| A5-01 rs485 驱动调用点 | 修改 | 收发数据接入协议层 |

> **实施结果（2026-11-01 回填）**：上表的 `proto_drv.c/.h` **未创建**。2026-09-08 阶段2 经人确认废弃 0xA5/0x5A 自定义帧，改 **Modbus RTU**，帧打包/解析由 `Middlewares/Third_Party/FreeModbus/` + `App/modbus_app.c` 承担（见 FEAT-A4-04 及其阶段4 实测 BUG-20260914-001）。本 FEAT 的验收项实际由 FEAT-A4-04 覆盖。

### 5.2 调试要点
- 帧格式与 CRC16 参数以 §3.1 人确认记录为准，两端（板端/PC 端）必须一致
- 调试打印走 USART1（115200），协议数据走 USART3（115200）

### 5.3 测试入口
- §3.2/§3.3 自测用例（对应 AC-01）

## 6. 执行日志

| 时间 | 阶段 | 角色 | 摘要 | 遇阻 |
|---|---|---|---|---|
| | | | | |
