wumu-dot/SoundDog/docs/features/FEAT-A7-02-IWDG看门狗.md

# FEAT-A7-02-IWDG看门狗

> **AI 执行规则**：必须按阶段顺序执行，每个阶段开头声明角色。严禁跳跃、越界、自审自判。
> 阶段间停等：每完成一个阶段，停下来，输出结果，等人说"继续"。
> 阶段5通过后：回填父FEAT项目表该行 + 更新 `docs/features/INDEX.md` + `docs/features/维护地图.md`。
> 历史记录只更新状态字段，严禁删除/篡改已完成记录。
> 事实来源：`.sop-agent规格.md` §3（禁止自造数值，没有的一律写"待定（需人确认）"）。

## 0. 元数据
- **父FEAT**：FEAT-A7-辅助功能
- **优先级**：P2
- **预估总耗时**：2h
- **当前状态**：🟡代码已落地，未烧录实测（`BSP/iwdg_drv.c` + `freertos.c` 的 `WDTPollTask`：200 ms 喂狗 / 1 s 超时；编译通过，待烧录实测归档）

## 1. 总体目标与硬边界

### 1.1 核心目标（一句话）
> 使能 IWDG 独立看门狗：系统异常死机（任务/主流程卡死）时**自动复位**，复位后串口重新输出 boot 三行可观测。

### 1.2 地基触碰前置自检
- [x] 否 → 继续（经 HAL IWDG 标准接口使能/喂狗，不触碰 `firmware/Drivers/` 底层库文件）

### 1.3 任务边界
| 类型 | 具体内容 |
|---|---|
| 范围内（可改） | 新建/挂接喂狗任务（App 层）、`soundDog.ioc` 使能 IWDG、模拟死机测试点（条件编译） |
| 超出范围（禁止碰） | `firmware/Drivers/` HAL 底层库文件 |
| 外部依赖 | 无新增硬件（复用现有核心板） |

### 1.4 关键参数（事实包 §3，禁止自造）
- IWDG 超时时间 / 预分频 / 重装载值：**待定（需人确认）**。
- 喂狗函数：`HAL_IWDG_Refresh`（HAL 标准接口，**禁止修改 HAL**）。
- 🚫 **硬性红线（FreeRTOS 配合）**：
  - **喂狗只能在任务上下文（独立喂狗任务）中调用，禁止在任何中断服务函数（ISR）里喂**——中断仍运行时主流程可能已死，ISR 喂狗会掩盖死机，使看门狗失去意义。
  - 中断优先级 0~4 禁止调用 FreeRTOS FromISR API（CLAUDE.md 铁律）；喂狗走任务路径，不涉及 FromISR。
  - 喂狗任务堆栈 ≥ 256 字（CLAUDE.md：业务任务最低 256 字）；喂狗周期必须 < IWDG 超时（**具体周期/优先级待定需人确认**）。
- 复位观测：复位后串口重新输出 `SoundDog boot OK` → `I2S_DRV_Init ret=0` → `I2S DMA started`（事实包 §3.4）。
- 调试注意：IWDG 一旦使能无法在运行中关闭，**调试暂停（halt）时看门狗仍计数可能触发复位**；调试构建关闭 IWDG 的条件编译开关：**待定（需人确认）**。
- 复位原因区分（IWDG 复位 vs 上电复位）：**待定（需人确认，如读取复位标志）**。

## 2. 执行路线图（5 阶段）

### 🟢 阶段 1：准备（角色：Dev Agent）
- **读什么**：`PROJECT_PLAN.md` §5.1（任务规划）+ 现有任务列表 + `main.c` 初始化顺序。
- [ ] 步骤1：列出当前任务与优先级/堆栈配置，确定喂狗任务挂点
- [ ] 步骤2：确认 `soundDog.ioc` 当前外设配置（IWDG 未使能），输出影响范围
- **判定标准**：影响范围明确"新增喂狗任务 + ioc 使能 IWDG + 测试点"
- **⏸️ 停等：人确认后进入阶段 2**

### 🔵 阶段 2：设计（角色：Dev Agent）
- **阶段目标**：定 IWDG 参数与喂狗任务设计，产出 §3 操作单
- [ ] 步骤1：IWDG 超时/预分频/重装载（**待定需人确认**）、喂狗周期与任务优先级（**待定需人确认**）
- [ ] 步骤2：设计模拟死机测试点（条件编译开关，**方案待定需人确认**）
- [ ] 步骤3：编写 §3 操作单（烧录/正常观察/模拟死机/喂狗合规检查/故障表）
- **判定标准**：§3 覆盖"正常不误复位"与"死机必复位"两条验证路径，含喂狗合规检查清单
- **⏸️ 停等：人确认后进入阶段 3**

### 🟠 阶段 3：实现（角色：Dev Agent）
- **阶段目标**：写代码，每改完一个文件对照 AC 自检
- [ ] 步骤1：`soundDog.ioc` 使能 IWDG（参数按阶段2定稿，待定需人确认）
- [ ] 步骤2：新建/挂接喂狗任务：仅任务上下文调用 `HAL_IWDG_Refresh`，堆栈 ≥ 256 字
- [ ] 步骤3：全工程搜索确认**无任何 ISR 内喂狗**；编译 `firmware\build.bat` 无错误、无新增警告
- **判定标准**：编译通过；ISR 喂狗搜索为 0 命中
- **⏸️ 停等：人确认后进入阶段 4**

===== 切换至 Test Agent =====

### 🟣 阶段 4：测试（角色：Test Agent）
- **阶段目标**：独立测试——只看 §3 操作单与 §4 验收标准，不看 Dev 实现细节
- [ ] 步骤1：按 §3.2 正常运行观察（时长待定），记录意外复位次数（AC-01）
- [ ] 步骤2：按 §3.3 模拟死机，记录自动复位与复位间隔（AC-02）
- [ ] 步骤3：按 §3.4 喂狗合规检查；运行 `./scripts/ci_local.sh`
- [ ] 若失败 → 查 §3.5 故障表，退回阶段 3
- **判定标准**：AC-01/02 证据齐全（记录观察时长、复位次数、复位间隔）
- **⏸️ 停等：人确认后进入阶段 5**

===== 切换至 Review Agent =====

### 🔴 阶段 5：审查（角色：Review Agent）
- **阶段目标**：独立审查——安全红线（ISR 喂狗禁令）、代码质量、AC 逐条打勾
- [ ] 步骤1：核对 §4 全部 AC 勾选与记录值
- [ ] 步骤2：核对喂狗周期/任务优先级与 FreeRTOS 配置一致，ISR 喂狗禁令合规
- **判定标准**：AC 全部通过且记录值完整
- 全部通过 → ✅ 回填「维护与调试」+ 父FEAT项目表 + INDEX + 维护地图
- 未通过 → 退回对应阶段并附意见
- **⏸️ 停等：人确认 Review 通过后归档**

## 3. 傻瓜式操作单（照做即可）

### 3.0 物品清单（动手前先打勾，缺一不可）
- [ ] 核心板（已按 A1-02 烧录验证过）
- [ ] ST-Link（SWD：SWDIO/SWCLK/GND/3.3V 四线）
- [ ] USB-TTL（CH340）+ SSCOM（115200）
- [ ] 5V 电源（非快充）
- [ ] （可选）逻辑分析仪

### 3.1 烧录（阶段 3 执行）
1. 打开 `firmware` 目录，**双击 `build_and_flash.bat`**。
2. 等待：先编译（gcc 输出），再 OpenOCD 烧录，最后应看到 `wrote ... bytes` / `Verified OK`。
3. 失败兜底：OpenOCD 连不上 → 查 ST-Link 四线/驱动；仍不行 → `firmware\flash_isp.bat`（BOOT0+USART1，见 HANDOFF §4.3，沿用 A1-02 §3.1）。

### 3.2 正常运行观察（阶段 4 执行）
1. 上电，SSCOM 打开，期望依次出现 boot 三行：`SoundDog boot OK` → `I2S_DRV_Init ret=0` → `I2S DMA started`。
2. 连续观察 **___ 分钟**（时长待定，需人确认）不做任何操作，记录意外复位次数：**___ 次（期望 0）**。

### 3.3 模拟死机验证（阶段 4 执行；测试点方案待定需人确认后运行）
1. 使能模拟死机测试点（**方案待定需人确认**：如条件编译的死循环/超时阻塞，由阶段3实现）。
2. 上电/复位后，等待 IWDG 超时自动复位：串口应**重新出现 boot 三行**。
3. 记录复位间隔：**___ ms（期望 ≈ IWDG 超时值，超时值待定需人确认）**。
4. ⚠️ 验证完**必须关闭测试点**、重编译重烧录，严禁把死机测试点留在正式固件。

### 3.4 喂狗合规检查（Review 走查清单）
> 🚫 红线：**喂狗只在任务上下文，禁止在任何中断里喂**（中断活着不代表系统活着）。
- [ ] 喂狗调用点列表（记录 `文件:行号`：______）全部位于任务上下文
- [ ] 全部中断服务函数内**无**喂狗调用（搜索 `HAL_IWDG_Refresh` 于 ISR 内 → 0 命中）
- [ ] 喂狗任务堆栈 ≥ 256 字（记录配置值：___ 字）
- [ ] 喂狗周期 < IWDG 超时（记录：喂狗周期 ___，超时 ___，两值均待定需人确认）

### 3.5 故障速查表
| 现象 | 可能原因 | 处理 |
|---|---|---|
| 频繁意外复位 | 喂狗周期 ≥ 超时 / 喂狗任务被饿死（优先级过低长期被抢占） | 缩短喂狗周期；调高喂狗任务优先级或改由空闲钩子喂（需人确认） |
| 模拟死机后不复位 | IWDG 未使能 / 超时过长 / 测试点未编译进去 | 查 ioc 使能与超时（待定）；确认条件编译开关生效 |
| 烧录后立即循环复位 | IWDG 使能早于喂狗任务启动 | 调整初始化顺序：先建喂狗任务再使能 IWDG（方案待定需人确认） |
| 调试暂停即复位 | IWDG 在 halt 时继续计数 | 调试构建条件编译关闭 IWDG（方案待定需人确认） |
| 喂狗后仍复位 | 喂狗调用被条件编译掉/未实际执行 | 断点/打印确认调用点执行 |

## 4. 验收标准（12 条）

### 功能验收
- [ ] AC-01 正常运行观察（时长待定）内 **0 次**意外复位（记录观察时长与复位次数）
- [ ] AC-02 模拟死机后自动复位：串口重出 boot 三行，复位间隔 ≈ IWDG 超时（记录实际间隔；超时值待定）

### 代码质量
- [ ] AC-03 编译通过（`firmware\build.bat` 无错误退出）
- [ ] AC-04 无新增编译警告
- [ ] AC-05 文档已更新（本 FEAT + 父 FEAT-A7 项目表回填）

### 安全红线
- [ ] AC-06 无硬编码密钥 → **N/A**（嵌入式固件无密钥场景，说明）
- [ ] AC-07 错误处理完善：喂狗任务创建失败/初始化失败有明确日志或断言（处理方式待定需人确认）
- [ ] AC-08 用户输入校验 → **N/A**（无用户输入，说明）

### 测试与边界
- [ ] AC-09 新增测试自动运行 → **N/A**（人工 + 串口复位观察验证，无自动化测试基建，说明）
- [ ] AC-10 全部回归测试通过：boot 三行 + 既有采集功能不回归
- [ ] AC-11 测试覆盖率 ≥ 80% → **N/A**（无单元测试基建，说明）
- [ ] AC-12 按 FEAT 模板执行（结构符合 `.sop-agent规格.md` §2）

## 5. 维护与调试（阶段5通过后回填）

### 5.1 影响文件
| 文件 | 改动类型 | 说明 |
|---|---|---|
| `firmware/soundDog/Src/main.c` | 修改 | 喂狗任务创建/挂接、初始化顺序 |
| `firmware/soundDog/soundDog.ioc` | 修改 | 使能 IWDG（参数待定） |
| 喂狗任务所在文件 | 新增/修改 | `HAL_IWDG_Refresh` 调用点（阶段1 定位后回填） |
| 模拟死机测试点文件 | 新增/修改 | 条件编译开关（方案待定） |

### 5.2 调试要点
- 复位原因区分：读取复位标志判断 IWDG 复位（实现待定需人确认）
- 走查 `HAL_IWDG_Refresh` 全部调用点，确认无 ISR 内喂狗

### 5.3 测试入口
- SSCOM 观察复位行为（对应 AC-01/AC-02）

## 6. 执行日志

| 时间 | 阶段 | 角色 | 摘要 | 遇阻 |
|---|---|---|---|---|
| | | | | |
