wumu-dot/SoundDog/docs/features/FEAT-A7-辅助功能.md

# FEAT-A7-辅助功能（父FEAT · 统筹规划）

> **AI 执行规则**：父FEAT 只做统筹规划，禁止编写实现代码；实现一律拆成子FEAT。
> 创建/修改项目表后必须停等，输出结果等人类确认方向后才允许创建子FEAT。
> 禁止自审自判完成：父FEAT 置 🟢 仅当项目表全部子FEAT 🟢 且每个都经过 Review。
> 历史记录只更新状态字段，严禁删除/篡改已完成记录。

## 0. 元数据

* **角色**：Planner（统筹规划）

* **优先级**：P3

* **预估总耗时**：6h

* **当前状态**：🟡进行中（A7-01 SHT30 代码已落地待实测；A7-02 IWDG 代码已落地未烧录实测；A7-03 Flash 未开始；A7-04/A7-05/A7-06 计划待审）

## 1. 总体目标与方向

### 1.1 核心目标（一句话）

> 补齐温湿度采集、看门狗、Flash 存储等辅助能力，提升系统可靠性与可维护性。

### 1.2 大方向策略

> 先 SHT30 温湿度，再看门狗，最后 Flash 存模版参数与事件日志。

### 1.3 硬边界（继承 CLAUDE.md）

* [x] 是否涉及底层库 / 第三方库？→ 否

* [x] 否 → 继续

## 2. 项目表（子FEAT清单）

> 每个子FEAT 按子模板（`.template-child.md`）创建，并已按 `.sop-agent规格.md` 细化为傻瓜式操作单（见「文件」列）。

| 子FEAT编号 | 功能 | 验收要点 | 优先级 | 依赖 | 状态 | 文件 |
| --- | --- | --- | --- | ----- | ----- | --- |
| FEAT-A7-01 | SHT30 温湿度 | I2C1 读取温湿度，数值合理 | P3  | 无 | 🔴未开始 | `FEAT-A7-01-SHT30温湿度采集.md` |
| FEAT-A7-02 | IWDG 看门狗  | 异常死机自动复位 | P2  | 无 | 🔴未开始 | `FEAT-A7-02-IWDG看门狗.md` |
| FEAT-A7-03 | Flash 存储  | 模版参数 + 事件日志读写 | P2  | 依赖 A4 | 🔴未开始 | `FEAT-A7-03-Flash存储.md` |

> 子FEAT 完成后回填本行状态与文件链接。

## 3. 依赖与执行顺序

1. 01 SHT30 / 02 IWDG 可并行；03 Flash 依赖 A4 模版参数

## 4. 阻塞与下一步

* **阻塞**：低优先级，待核心链路稳定后再做

* **下一步**：核心链路稳定后开 A7-01

## 5. 完成定义（DoD）

* [ ] 项目表全部子FEAT 🟢 且每个经 Review

* [ ] 本表状态与 `docs/features/INDEX.md` 一致

* [ ] 经验教训已提炼（如有）

## 6. 执行日志

| 时间 | 动作 | 角色 | 摘要 | 遇阻 |
| --- | --- | --- | --- | --- |
| 2026-08-16 | 细化子FEAT | Planner | 按统一规格创建 A7-01/02/03 傻瓜式操作单，项目表「文件」列已回填 | 待定项需人确认：SHT30 命令/供电（地址 0x44 已由 pin\_config.h 定义）、IWDG 超时/喂狗参数/测试点方案、Flash 存储介质（片内 vs 外挂 W25Q64）与扇区规划/校验算法 |
