wumu-dot/SoundDog/docs/features/INDEX.md

# 功能开发索引（FEAT INDEX）

> 维护规则：父FEAT 用 `.template-parent.md` 创建（统筹规划+项目表）；子FEAT 用 `.template-child.md` 创建（5阶段实现）。
> 子FEAT 阶段5通过后：回填父FEAT项目表该行 + 更新本表子行 + 更新 `docs/features/维护地图.md`。
> 父行状态由子行推导（见推导规则）；修改 docs 后同步本表对应行（状态/耗时/文件链接）。

## 状态图例

| 标记 | 子FEAT | 父FEAT |
| --- | --- | --- |
| 🔴 未开始 | 已建档未启动 | 规划中，尚未开子FEAT |
| 🟡 进行中 | 阶段X进行中 | 部分子FEAT已完成 |
| 🟢 已完成 | 阶段5 Review 通过 | 全部子FEAT 🟢（DoD达成） |

## 父行状态推导规则

* 全部子 🟢 → 父 🟢

* 有子 🟡（或部分 🟢）→ 父 🟡

* 无子开工 → 父 🔴

## 索引表

| 层级 | FEAT ID | 优先级 | 描述 | 状态 | 创建日期 | 预估耗时 | 实际耗时 | 文件 |
| -- | --- | --- | --- | -- | --- | ---- | --- | --- |
| 父  | FEAT-A1 | P1  | 音频采集链路 | 🟢 | 2026-08-16 | 4h | 0.5h | `FEAT-A1-音频采集链路.md` |
| ├子 | FEAT-A1-01 | P0  | 换麦克风接线自检 | 🟡 | 2026-08-16 | 0.5h | <br /> | `FEAT-A1-01-换麦克风接线自检.md` |
| ├子 | FEAT-A1-02 | P0  | 音频链路验证 | 🟢 | 2026-08-16 | 1h | 0.5h | `FEAT-A1-02-音频链路验证.md` |
| ├子 | FEAT-A1-03 | P1  | L/R 通道确认 | 🟢 | 2026-08-16 | 0.5h | 0.5h | `FEAT-A1-03-LR通道确认.md` |
| ├子 | FEAT-A1-04 | P1  | SCK 时钟核实 | 🟢 | 2026-08-16 | 1h | 0.5h | `FEAT-A1-04-SCK时钟核实.md` |
| 父  | FEAT-A2 | P1  | FFT 频谱可视化 | 🟢 | 2026-08-30 | 8h | <br /> | `FEAT-A2-FFT频谱可视化.md` |
| ├子 | FEAT-A2-01 | P0  | CMSIS-DSP 库集成 | 🟢 | 2026-08-16 | 2h | 0.5h | `FEAT-A2-01-CMSIS-DSP集成.md` |
| ├子 | FEAT-A2-02 | P0  | 256点 FFT + 幅度谱 | 🟢 | 2026-08-29 | 2h | <br /> | `FEAT-A2-02-FFT幅度谱.md` |
| ├子 | FEAT-A2-03 | P1  | OLED 频谱显示 | 🟢 | 2026-08-16 | 2h | <br /> | `FEAT-A2-03-OLED频谱显示.md` |
| ├子 | FEAT-A2-04 | P1  | 串口频谱输出 | 🟢 | 2026-08-30 | 1h | <br /> | `FEAT-A2-04-串口频谱输出.md` |
| 父  | FEAT-A3 | P1  | MFCC 特征提取 | 🟢 | 2026-08-30 | 8h | <br /> | `FEAT-A3-MFCC特征提取.md` |
| ├子 | FEAT-A3-01 | P1  | 预处理分帧加窗 | 🟢 | 2026-08-30 | 1.5h | <br /> | `FEAT-A3-01-预加重分帧汉明窗.md` |
| ├子 | FEAT-A3-02 | P1  | Mel 滤波器组 | 🟢 | 2026-08-30 | 2h | <br /> | `FEAT-A3-02-Mel滤波器组.md` |
| ├子 | FEAT-A3-03 | P1  | Log 能量 + DCT-II | 🟢 | 2026-08-30 | 2h | <br /> | `FEAT-A3-03-Log能量DCT-II.md` |
| ├子 | FEAT-A3-04 | P1  | 特征向量验证 | 🟢 | 2026-08-30 | 1.5h | <br /> | `FEAT-A3-04-特征向量验证.md` |
| 父  | FEAT-A4 | P1  | 模版比对检测 | 🟢 | 2026-09-01 | 8h | <br /> | `FEAT-A4-模版比对检测.md` |
| ├子 | FEAT-A4-01 | P1  | 离线模版生成 | 🟢 | 2026-09-01 | 2h | <br /> | `FEAT-A4-01-离线模版生成.md` |
| ├子 | FEAT-A4-02 | P1  | 距离实时比对 | 🟢 | 2026-09-01 | 2h | <br /> | `FEAT-A4-02-距离实时比对.md` |
| ├子 | FEAT-A4-03 | P1  | 连续帧防抖 | 🟢 | 2026-08-16 | 2h | <br /> | `FEAT-A4-03-连续帧防抖.md` |
| ├子 | FEAT-A4-04 | P2  | 参数可调 | 🟢 | 2026-08-16 | 2h | **阶段5 已过**（阶段4 实测见 BUG-20260914-001：0 基址逐项回读吻合；维护地图已收录 3 行） | `FEAT-A4-04-参数可调.md` |
| 父  | FEAT-A5 | P1  | RS485 通信 | 🟡 | 2026-08-16 | 8h | <br /> | `FEAT-A5-RS485通信.md` |
| ├子 | FEAT-A5-01 | P1  | USART3 驱动（预研已建，待阶段5验证） | 🟡 | 2026-08-16 | 2h | <br /> | `FEAT-A5-01-USART3-RS485模块驱动.md` |
| ├子 | FEAT-A5-02 | P1  | 协议帧打包解析 | 🔴 | 2026-08-16 | 2h | <br /> | `FEAT-A5-02-协议帧打包解析.md` |
| ├子 | FEAT-A5-03 | P1  | PC 端收发验证 | 🔴 | 2026-08-16 | 2h | <br /> | `FEAT-A5-03-PC端收发验证.md` |
| ├子 | FEAT-A5-04 | P2  | 主从轮询时序 | 🔴 | 2026-08-16 | 2h | <br /> | `FEAT-A5-04-主从轮询时序.md` |
| 父  | FEAT-A6 | P2  | 报警输出 | 🔴 | 2026-08-16 | 2h | <br /> | `FEAT-A6-报警输出.md` |
| ├子 | FEAT-A6-01 | P2  | 红灯 PWM 报警 | 🔴 | 2026-08-16 | 1h | <br /> | `FEAT-A6-01-红灯PWM报警.md` |
| ├子 | FEAT-A6-02 | P2  | 绿灯状态 | 🔴 | 2026-08-16 | 0.5h | <br /> | `FEAT-A6-02-绿灯状态.md` |
| ├子 | FEAT-A6-03 | P2  | 蜂鸣器报警 | 🔴 | 2026-08-16 | 0.5h | <br /> | `FEAT-A6-03-蜂鸣器报警.md` |
| 父  | FEAT-A7 | P3  | 辅助功能 | 🟡 | 2026-08-16 | 6h | <br /> | `FEAT-A7-辅助功能.md` |
| ├子 | FEAT-A7-01 | P3  | SHT30 温湿度 | 🟡 | 2026-08-16 | 2h | **代码已落地，待实测归档**（`BSP/sht30.c` + `sht30Task` 已启用，堆问题见 BUG-20261029-001） | `FEAT-A7-01-SHT30温湿度采集.md` |
| ├子 | FEAT-A7-02 | P2  | IWDG 看门狗 | 🟡 | 2026-08-16 | 1h | **代码已落地，未烧录实测**（`BSP/iwdg_drv.c` + `WDTPollTask`） | `FEAT-A7-02-IWDG看门狗.md` |
| ├子 | FEAT-A7-03 | P2  | Flash 存储 | 🔴 | 2026-08-16 | 3h | <br /> | `FEAT-A7-03-Flash存储.md` |
| ├子 | FEAT-A7-04 | P2  | MPU6050 振动 | 🔴 | 2026-11-01 | 4h | **计划书已出，未实施**（三源已核，含 5 处旧规格冲突裁决） | `FEAT-A7-04-MPU6050振动监测.md` |
| ├子 | FEAT-A7-05 | P1  | 多源判据同构化与融合 | 🔴 | 2026-11-01 | 8d | **计划 v2 待审**（评审后 5 项修订：带宽降 10~250 Hz / 共现升级 / 跨仓零改动保 mg / k 标定 / 阶段重排） | `FEAT-A7-05-多源判据同构化与融合设计.md` |
| ├子 | FEAT-A7-06 | P1  | 能力矩阵与对比基线实验 | 🟡 | 2026-11-01 | 2.8d | **S1~S3 已落地**（EVAL 旁挂 +392B/104B，脚本 selftest 5/5，首版 k=3σ 粗评已出）；S4 待硬件 | `FEAT-A7-06-能力矩阵与对比基线实验.md` |
| 父  | FEAT-A8 | P2  | 上位机（Python） | 🔴 | 2026-08-16 | 16h  | <br /> | `FEAT-A8-上位机.md` |
| ├子 | FEAT-A8-01 | P0  | 通信层 | 🔴 | 2026-08-16 | 4h | <br /> | `FEAT-A8-01-通信层.md` |
| ├子 | FEAT-A8-02 | P1  | 频谱实时显示 | 🔴 | 2026-08-16 | 4h | <br /> | `FEAT-A8-02-频谱实时显示.md` |
| ├子 | FEAT-A8-03 | P1  | 模版采集与训练 | 🔴 | 2026-08-16 | 5h | <br /> | `FEAT-A8-03-模版采集与训练.md` |
| ├子 | FEAT-A8-04 | P1  | 参数下发与报警监控 | 🔴 | 2026-08-16 | 3h | <br /> | `FEAT-A8-04-参数下发与报警监控.md` |

> 注：A1 固件（I2S3+DMA 采集）在 FEAT 体系建立前已实现，故 A1 标 🟡（部分完成）；A1-01\~04 为换麦克风后的验证收尾步骤。
