wumu-dot/SoundDog/docs/features/维护地图.md

# 维护地图（文件 → FEAT 反查）

> 用法：出问题时先定位到文件/模块 → 查本表 → 读关联FEAT 的「维护与调试」章节 → 拿调试要点与测试入口。
> 子FEAT 阶段5通过后由 AI 追加一行；历史记录只更新状态字段，严禁删除/篡改已完成记录。
> 状态沿用 `docs/features/INDEX.md` 状态图例（🔴未开始/🟡进行中/🟢已完成）；另加 ⛔作废（设计已废止、无对应文件，仅本表使用）。

| 文件/模块 | 关联FEAT | 功能简述 | 状态 |
| --- | --- | --- | -- |
| `firmware/soundDog/BSP/i2s_drv.c` | FEAT-A1-02 | I2S3 DMA 双缓冲采集驱动（v10：4 字周期提取，BUG-002 修复） | 🟢 |
| `firmware/soundDog/Inc/pin_config.h` | FEAT-A1-01 | 引脚映射权威来源（改引脚只改这里） | 🟡 |
| `firmware/soundDog/soundDog.ioc` | FEAT-A1-04 | CubeMX 时钟/I2S3 配置（实测确证：WS=16kHz 精确/SCK≈1MHz，无需修正） | 🟢 |
| `firmware/soundDog/BSP/fft.c` | FEAT-A2-01 | FFT 封装（CMSIS-DSP rfft\_fast 256 点；含 1kHz 自测，A2-02 换真音频） | 🟢 |
| `firmware/soundDog/BSP/spectrum.c` | FEAT-A2-02 | 幅度谱/32 频带聚合（去直流 signed 除法 + 汉明窗 + 峰值 getter；调试要点见 A2-02 §5.2） | 🟢 |
| `firmware/soundDog/App/audio_pipe.h` | FEAT-A2-02 | 音频帧队列共享接口（frame\_msg\_t + audio\_queue\_get；A2-03/04 消费侧复用） | 🟢 |
| `firmware/soundDog/BSP/oled_drv.c` | FEAT-A2-03 | SSD1306 OLED 驱动+频谱绘制（Mem\_Write 分笔 + F1 实测电气参数 + 柱高钳位，12 AC 全绿） | 🟢 |
| `firmware/soundDog/App/freertos.c` | FEAT-A2-02/03/04 | 任务定义与串口打印（specTask：SPEC/BANDS 行 + OLED err；DisplayTask 200ms 刷新） | 🟢 |
| `firmware/soundDog/Src/i2c.c` | FEAT-A2-03 | I2C1 400kHz 配置层（PB6/PB7，含 HAL\_I2C 模块启用） | 🟢 |
| `.skills/oocd_probe.ps1` | 工具 | 非侵入式 OpenOCD telnet 探针（BUG-20260830-001 沉淀；运行态监控禁用 gdb connect） | 🟢 |
| `firmware/soundDog/BSP/mfcc.c` | FEAT-A3-01/02/03/04 | 预加重/分帧/汉明窗（A3-01 收官，含评审修复的有界计数）+ 帧回调 API（A3-02 帧率修正，100 帧/s）+ e 钳位（A3-04 清偿：energy\_x100 溢出 UB 防护，统计打印字段非算法参数）；Log-DCT 独立为 mfcc\_dct.c 未扩展本文件 | 🟢 |
| `firmware/soundDog/BSP/mel.c` | FEAT-A3-02/03 | 32 三角 Mel 滤波器组（512 rfft 独立实例 + 473 系数稀疏表 const；A3-02 收官，1kHz→b=7 精确命中） | 🟢 |
| `firmware/soundDog/BSP/mfcc_dct.c` | FEAT-A3-03 | Log 能量 + DCT-II（Mel 域 absmax 归一化 + ln + 1e-6 + 13×32 矩阵 416-MAC；A3-03 收官，PC 自洽 diff≤1.1；416 系数表脚本生成禁止手改；坑 8：arm\_offset\_f32 参数序 (pSrc,offset,pDst,n)） | 🟢 |
| `scripts/gen_dct_table.py` | FEAT-A3-03 | DCT 表生成器（复刻官方 mfccdata.py dctMatrix，--c 输出 C 数组） | 🟢 |
| `scripts/a3_03_pc_check.py` | FEAT-A3-03 | PC 自洽核验（三态帧+全零地板，可复跑取证） | 🟢 |
| `scripts/gen_mel_table.py` | FEAT-A3-02 | Mel 表生成器（复刻官方 mfccdata.py，A3-03 DCT 表可同法生成） | 🟢 |
| `scripts/collect_mfcc.py` | FEAT-A4-01 | 串口采集 MFCC13 → CSV（前缀过滤/×100 还原/维数校验/600 帧自停；现场重采复用入口） | 🟢 |
| `scripts/kmeans_model.py` | FEAT-A4-01 | K-means(K=16, seed=42) 聚类 + model\_normal.c/h 导出（`--check` 跨日复跑比对） | 🟢 |
| `data/mfcc_normal_600.csv` | FEAT-A4-01 | 600×13 正常样本存档（模版复现证据，删除即 AC-04 失效） | 🟢 |
| `firmware/soundDog/BSP/model_normal.c/h`  | FEAT-A4-01 | 正常模版 16×13 float32 常量表（**脚本产物禁止手改**；A4-02 距离比对消费；无引用时被 --gc-sections 丢弃，A4-02 引用后 +832B Flash） | 🟢 |
| `firmware/soundDog/BSP/dist.c/h` | FEAT-A4-02 | 距离比对模块（欧氏平方比较+出值 1 次 sqrt，16 模版 argmin；复刻官方 arm\_euclidean\_distance\_f32 标量算法；A4-02 收官，金属判别比 2.52×；消费 model\_normal） | 🟢 |
| `scripts/collect_dmin.py` | FEAT-A4-02 | DMIN d/m 序列采集 → CSV（行数配对防错位防护；A4-03 阈值标定数据入口，金属轮 26% 错位行 caveat 见 FEAT-A4-02 日志） | 🟢 |
| `scripts/analyze_dmin.py` | FEAT-A4-02 | PC 离线复算 d\_min + 分维判别比诊断（固件正确性 PC 闭环入口） | 🟢 |
| `data/dmin_*.csv` | FEAT-A4-02 | 3 份 70s 工况存证（normal2/anomaly2/anomaly\_metal，正常+吹气+金属；A4-03 阈值区间输入） | 🟢 |
| `firmware/soundDog/BSP/debounce.c/h` | FEAT-A4-03 | 连续帧防抖双轨状态机（连续30帧|滑窗30/100→报警，连续60帧→解除；位图滑窗 O(1)） | 🟢 |
| `firmware/soundDog/App/freertos.c` | FEAT-A4-03 | mel\_frame\_cb 逐帧喂入 debounce\_process + SpecTask ALARM 事件即时打印（src/n 诊断） | 🟢 |
| `firmware/soundDog/sources.mk` | FEAT-A4-03 等 | 手写源文件/头文件路径/编译宏集中处（BSP 12 + App 2 + FreeModbus 14 + HAL/CMSIS-DSP 等共 50 项）；`Makefile` 只留 CubeMX 生成清单 + 一行 `include sources.mk`；含 `App/main.c`/`App/freertos.c` 的归属保护（2026-11-01 拆分区，防再生成撞名） | 🟢 |
| `scripts/simulate_debounce.py` | FEAT-A4-03 | PC 端复刻状态机，§3.3 六边界用例（29/30/59/60/散布）6/6 断言闭环 | 🟢 |
| `firmware/soundDog/App/modbus_app.c` | FEAT-A4-04 | FreeModbus 保持寄存器回调（TH/触发/解除/滑窗/窗内，帧地址 0 基址，R34；2 遍校验全合法才 param\_apply） | 🟢 |
| `firmware/soundDog/Middlewares/Third_Party/FreeModbus/` | FEAT-A4-04 | FreeModbus 移植（portserial/porttimer/portevent，USART3 115200-8N1；寄存器帧地址 0 基址 off-by-one 见 R34/BUG-20260914-001） | 🟢 |
| `scripts/gen_param_frames.py` | FEAT-A4-04 | Modbus RTU 参数下发帧生成器 + `--com COMx` 实机下发/回读验证（0 基址 RIP 修复，R34/BUG-20260914-001；越界→异常0x02） | 🟢 |
| `firmware/soundDog/BSP/rs485_drv.c` | FEAT-A5-01 | USART3+EN 方向控制驱动（已建，待 FEAT-A5-01 阶段5验证） | 🟡 |
| ~~`firmware/soundDog/BSP/proto_drv.c`~~ | FEAT-A5-02 | ⛔ 该文件不存在：0xA5/0x5A 自定义帧已于 2026-09-08 阶段2 废弃（人确认改 Modbus RTU），实现见 `App/modbus_app.c` + FreeModbus 两行 | ⛔ 作废 |
| `firmware/soundDog/BSP/alarm.c` | FEAT-A6-01/02/03 | 红灯/绿灯/蜂鸣器输出（待建） | 🔴 |
| `firmware/soundDog/BSP/sht30.c` | FEAT-A7-01 | SHT30 温湿度（I2C3 PA8/PC9 自建初始化，2 s 刷新 `g_temp_x10`/`g_humi_x10`；`sht30_task` 已启用；启用后暴露堆缺口见 BUG-20261029-001） | 🟡 |
| `firmware/soundDog/BSP/iwdg_drv.c` | FEAT-A7-02 | IWDG 200 ms 喂狗 / 1 s 超时（`WDTPollTask`）；编译通过，未烧录实测 | 🟡 |
| `firmware/soundDog/BSP/flash_store_drv.c` | FEAT-A7-03 | Flash 存储（介质待定）（待建） | 🔴 |
| `host_app/comm/` | FEAT-A8-01 | 上位机通信层（pySerial+帧协议）（待建） | 🔴 |
| `host_app/gui/` | FEAT-A8-02/04 | 上位机 GUI（频谱/参数/报警）（待建） | 🔴 |
| `host_app/ml/` | FEAT-A8-03 | 上位机 K-means 模版训练（待建） | 🔴 |

> 上表前 4 行（i2s\_drv.c / pin\_config.h / soundDog.ioc / rs485\_drv.c）是 FEAT 体系建立前已有的历史成果，待对应子FEAT 完成验证后转 🟢；其余为规划中的待建文件，随子FEAT 落地后更新。

> **2026-11-01 状态同步**（修文档漂移）：A7-01/A7-02 由"待建"改为真实文件 `BSP/sht30.c` / `BSP/iwdg_drv.c`（🟡 代码已落地未验收，依据 BUG-20261029-001）；A5-02 的 `BSP/proto_drv.c` 标记 ⛔作废（0xA5 帧已改 Modbus RTU）；Makefile 行改为 `sources.mk`（构建分区后手写源清单已迁出）。

> **2026-08-29 目录架构迁移**（GitHub 成熟工程模式，R27 参考 RM\_Infantry\_2026\_EC/CubeMX-CMake-VSCode）：
> 自研代码从 CubeMX 的 Inc/Src 迁出到物理分层目录——`App/`（应用层：main.c、freertos.c、audio\_pipe.h）、`BSP/`（驱动层：xxx\_drv + fft/spectrum 等计算模块），Inc/Src 只留 CubeMX 生成/配置层（i2c.c、usart.c、pin\_config.h 等）。
> 迁移后 text=157060 与迁移前逐字节一致（纯移动零行为变化）。
> ⚠️ **再生成警告**：`.ioc` 重新生成会在 Src/ 重建 main.c/freertos.c → 链接期重复定义报错（显性，非静默）。本项目已走「手写 i2c.c、不再用 CubeMX 再生成」路线（历史坑：再生成覆盖 USER CODE）。
> ✅ codegraph 索引已重建（2026-08-30，A3-01 阶段 2：146→655 文件，含 App/BSP 与 vendored cmsis-dsp；`status` 报"up to date"不可信，符号查不到即强制 `index`）。
