wumu-dot/SoundDog/docs/features/FEAT-A4-03-连续帧防抖.md

# FEAT-A4-03-连续帧防抖

> **AI 执行规则**：必须按阶段顺序执行，每个阶段开头声明角色。严禁跳跃、越界、自审自判。
> 阶段间停等：每完成一个阶段，停下来，输出结果，等人说"继续"。
> 阶段5通过后：回填父FEAT项目表该行 + 更新 `docs/features/INDEX.md` + `docs/features/维护地图.md`。
> 历史记录只更新状态字段，严禁删除/篡改已完成记录。
> 事实来源：`.sop-agent规格.md` §3（禁止自造数值）。

## 0. 元数据

* **父FEAT**：FEAT-A4-模版比对检测

* **优先级**：P1

* **预估总耗时**：1.5h

* **当前状态**：🔴未开始（傻瓜式操作单已备好，依赖 A4-02 通过后开跑）

## 1. 总体目标与硬边界

### 1.1 核心目标（一句话）

> 在 A4-02 的 d\_min 基础上加连续帧判决状态机：**连续 30 帧异常 → 报警**、**连续 60 帧正常 → 解除**，抑制瞬时误报/误解除。

### 1.2 地基触碰前置自检

* [x] 否 → 继续（App 层状态机，不碰底层库）

### 1.3 任务边界

| 类型 | 具体内容 |
| --- | --- |
| 范围内（可改） | 帧计数状态机、报警/解除输出（串口打印必做；A6 灯/蜂鸣器接口预留） |
| 超出范围（禁止碰） | `firmware/Drivers/` HAL 底层库、A4-02 距离计算内部实现 |
| 外部依赖 | A4-02 通过（d\_min 可用）、异常阈值（本 FEAT 先固化默认值：待定（需人确认）；A4-04 支持 RS485 下发） |

### 1.4 关键参数（事实包 §3，禁止自造）

* 判决计数：**连续 30 帧异常 → 报警**；**连续 60 帧正常 → 解除**（A4-03 事实，不可改）。

* 帧率参考：特征帧移 10ms=160 样（A3-01 事实）→ 若逐帧判决，30 帧≈300ms、60 帧≈600ms（实际判决节拍：待定（需人确认））。

* 报警输出：串口打印（本 FEAT 必做）；A6-01 红灯快闪 / A6-03 蜂鸣器异常断续报警（A6 未开始，仅预留接口，接线与启用：待定（需人确认））。

* 阈值来源：A4-02 d\_min 阈值（A4-04 支持 RS485 下发）。

## 2. 执行路线图（5 阶段）

### 🟢 阶段 1：准备（角色：Dev Agent）

* **阶段目标**：确认 A4-02 已通过、明确判决输入与输出，输出影响范围

* [ ] 步骤1：确认 A4-02 已通过（正常/异常 d\_min 有区分，记录值在案）

* [ ] 步骤2：明确判决输入（d\_min）与输出（报警/解除标志 + 串口打印）

* [ ] 步骤3：输出影响范围：新增帧计数状态机；风险=边界计数/重启残留/报警输出依赖 A6

* **判定标准**：输入输出接口明确

* **⏸️ 停等：人确认后进入阶段 2**

### 🔵 阶段 2：设计（角色：Dev Agent）

* **阶段目标**：设计状态机并产出 §3 操作单（含 29/30/59/60 帧边界用例）

* [ ] 步骤1：设计状态机（正常/异常计数、报警/解除状态迁移，连续中断即清零）

* [ ] 步骤2：设计边界用例（§3.3：29/30/59/60 帧）

* [ ] 步骤3：确定报警输出方式（串口必做；A6 灯/蜂鸣器预留）

* **判定标准**：状态机迁移规则明确，操作单每步有期望值

* **⏸️ 停等：人确认后进入阶段 3**

### 🟠 阶段 3：实现（角色：Dev Agent）

* **阶段目标**：实现状态机并编译烧录

* [ ] 步骤1：实现帧计数状态机（连续判定：任一帧不满足即清零）

* [ ] 步骤2：`firmware\build.bat` 编译（期望无错误退出、无新增警告）

* [ ] 步骤3：`firmware\build_and_flash.bat` 烧录（期望 `wrote ...` / `Verified OK`）

* **判定标准**：编译/烧录输出证据已记录

* **⏸️ 停等：人确认后进入阶段 4**

### 🟣 阶段 4：测试（角色：Test Agent）

* **阶段目标**：独立验证——按 §3 实测三场景与边界，核对 §4

* [ ] 步骤1：正常→异常→正常全流程（§3.2），记录触发/解除帧数

* [ ] 步骤2：29/30/59/60 帧边界用例（§3.3），逐条记录

* [ ] 步骤3：逐条核对 §4；若失败 → 查 §3.4 故障表，退回阶段 3

* **判定标准**：AC-01\~AC-03 有实际记录值

* **⏸️ 停等：人确认后进入阶段 5**

### 🔴 阶段 5：审查（角色：Review Agent）

* **阶段目标**：独立审查——AC 逐条打勾、状态机边界与重启路径

* [ ] 步骤1：核对 §4 全部 AC 勾选与记录值

* [ ] 步骤2：核对状态机：连续中断清零、重启/看门狗复位后计数器清零

* **判定标准**：AC 全部通过且记录值完整

* 全部通过 → ✅ 回填「维护与调试」+ 父FEAT项目表 + INDEX + 维护地图

* 未通过 → 退回对应阶段并附意见

* **⏸️ 停等：人确认 Review 通过后归档**

## 3. 傻瓜式操作单（照做即可）

### 3.0 物品/工具清单（动手前先打勾，缺一不可）

* [ ] 核心板（A4-02 已通过：d\_min 输出正常）

* [ ] ST-Link（SWD：SWDIO/SWCLK/GND/3.3V 四线）

* [ ] USB-TTL（CH340）+ SSCOM（115200，COM 以设备管理器为准）

* [ ] 5V 电源（非快充；供电红线沿用 A1-01 §3.2：**严禁手机快充头**）

* [ ] 制造异常用道具（吹气/敲击/异物，任选）

### 3.1 编译烧录

1. `firmware\build.bat` 编译：期望**无错误退出、无新增警告**（记录结果：\_\_\_\_\_\_）。
2. `firmware\build_and_flash.bat` 烧录：期望 `wrote ... bytes` / `Verified OK`（记录输出：\_\_\_\_\_\_）。
3. 失败兜底：OpenOCD 连不上 → 查 SWD 四线；仍不行 → `firmware\flash_isp.bat`（BOOT0+USART1，见 HANDOFF §4.3）。

### 3.2 全流程验证（正常→异常→正常）

1. 上电，正常环境保持一段时间（时长：待定（需人确认），记录实际时长：___）：\*\*记录误报次数：___（期望 0）\*\*。
2. 制造异常（吹气/敲击/异物）并持续保持：期望在**连续 30 帧异常**后触发报警（**记录触发时异常帧数：\_\_\_，期望 ≥30**；**记录报警输出内容：\_\_\_\_\_\_**）。
3. 恢复正常并持续保持：期望在**连续 60 帧正常**后解除报警（**记录解除时正常帧数：\_\_\_，期望 ≥60**）。

> **阶段4 实测记录（2026-09-01，SSCOM 115200）**：
>
> * 正常段（boot→异常开始）：d=151\~222（×100 域，<600 阈值下界），**误报 0 次** ✅
>
> * 异常段（吹气+敲击，\~10s）：d 上穿 6.0，**`ALARM on src=mofn n=30`**（03:30:04.328，异常开始后 \~0.5s）——轨2 触发 ✅
>
> * 解除段：声音停止后 \~0.6s，**`ALARM off n=60`**（03:30:14.952）✅
>
> * **轨1（连续30帧）硬件未复现**：d 围绕 TH=6.0 抖动（526\~849，间歇跌破阈值），无法凑齐连续 30 帧 → 轨1 边界由 PC 仿真闭环（见 §3.3 ②③④）
>
> **吹气 A/B/C 对照实证（2026-09-01，SSCOM 115200，日志 17:16:58\~）**：
>
> | 轮次                         | d 区间（×100 域，TH=600）     | ALARM                                  | 结论                                                |
> | -------------------------- | ----------------------- | -------------------------------------- | ------------------------------------------------- |
> | A 正常基线（不吹不敲，\~30s）         | 96\~287（皆 <600）         | **无**，误报 **0** ✅                       | 环境声不触发                                            |
> | B 纯吹气（距麦 5\~10cm 恒定，\~30s） | 155\~947（瞬时抬升，部分帧 >600） | **未触发** ✅                              | 吹气瞬时 d 高大半超 TH，但滑窗内异常帧占比 <30%、连续异常 <30 → 双轨防抖正确拦截 |
> | C 吹气+敲击（\~10s）             | —                       | 触发 `src=mofn n=30`，解除 `ALARM off n=60` | 敲击使异常帧密集才触发（与 §3.2 一致）                            |
>
> **策略结论（闭环"吹气歧义"）**：吹气（宽带噪声）是 d 围绕 TH 抖动的**灰度带**，单帧 d>TH 不足为凭；双轨防抖以滑窗比例/连续帧为判据，故**纯吹气不报警、敲击才报警**。B 段 d 峰值 947 同时佐证了单帧判据会误报、防抖判据正确拦截的设计价值。**报警源全部为 mofn（轨2）**，轨1 在实际音频下仍不可触达，其边界持续由 §3.3 PC 仿真闭环。

### 3.3 边界用例（每步记录实际帧数与状态）

| 用例 | 操作 | 期望结果 | 实际记录 |
| ---- | --- | --- | --- |
| ① | 异常 29 帧后恢复  | **不报警** | PC 仿真（scripts/simulate\_debounce.py ①）：29 连续异常+恢复，**不报警 PASS** |
| ② | 异常 30 帧后恢复  | **报警**（30 帧触发） | PC 仿真②：第30帧 `ALARM on src=consec n=30` **PASS**（轨1边界 AC-01） |
| ③ | 报警后正常 59 帧  | **仍报警**（未达 60 不解除） | PC 仿真③：59 帧正常后**仍 ALARMED**，不解除 **PASS**（AC-03） |
| ④ | 报警后正常 60 帧  | **解除报警** | PC 仿真④：第60帧 `ALARM off n=60` **PASS**（AC-02） |
| ⑤(附) | 窗内 29 帧散布异常 | **不报警** | PC 仿真⑤：散布异常（无连续），窗内 29<30，**不报警 PASS**（轨2下界） |
| ⑥(附) | 窗内 30 帧散布异常 | **报警**（mofn） | PC 仿真⑥：散布异常（无连续），第59帧 `ALARM on src=mofn n=30` **PASS**（轨2接管）  |

> **验证口径（R25）**：轨1 硬件人工无法复现（d 围绕 TH 抖动、间歇清零），故 AC-01/AC-03 轨1 边界用例由 `scripts/simulate_debounce.py`（逐行复刻 debounce.c 状态机含位图滑窗）在 PC 上断言闭环，2026-09-01 运行 6/6 PASS。轨2（mofn）触发/解除已硬件实测（§3.2）。

### 3.4 故障速查表

| 现象 | 可能原因 | 处理 |
| --- | --- | --- |
| 帧数未到就报警 | "连续"判定未实现（中断未清零） | 确认状态机：任一帧不满足即清零计数 |
| 一直不报警 | d\_min 阈值过高 / 特征无差异 | 回 A4-02 §3.2/§3.3 对比实验；待 A4-04 下调阈值 |
| 报警后不解除  | 正常帧未达 60 / 计数卡死 | 确认解除路径；确认计数器在每帧正常时累加 |
| 重启后状态残留 | 计数器未初始化 | 确认上电/看门狗复位路径计数器清零 |
| 编译/烧录失败 | C\_SOURCES 漏加 / SWD 问题 | 加源文件（BUG-002 教训）；查 SWD 四线，兜底 `flash_isp.bat` |

## 4. 验收标准（12 条）

### 功能验收

* [ ] AC-01 连续 30 帧异常触发报警（记录触发时异常帧数与报警输出）

* [ ] AC-02 连续 60 帧正常解除报警（记录解除时正常帧数）

* [ ] AC-03 边界：异常 29 帧不报警、报警后正常 59 帧不解除（记录用例①③）

* [ ] AC-04 编译通过：`build.bat` 无错误退出（记录结果）

* [ ] AC-05 无新增警告

* [ ] AC-06 文档已更新（本 FEAT 维护章节 + 父表回填）

### 代码质量 / 安全红线 / 测试边界

* [ ] AC-07 无硬编码密钥：**N/A**（无密钥/凭据概念——说明）

* [ ] AC-08 错误处理：计数器边界无溢出（如 uint32 计数上限说明或防御，记录处理说明）

* [ ] AC-09 用户输入校验：**N/A**（判决输入为内部 d\_min，无外部用户输入——说明）

* [ ] AC-10 新增测试：29/30/59/60 帧边界用例逐条执行（记录 §3.3 表）

* [ ] AC-11 全部回归：A4-02 d\_min 输出不受影响（串口观察记录）

* [ ] AC-12 按 FEAT 模板执行；覆盖率 **N/A**（嵌入式手测，无覆盖率要求——说明）

## 5. 维护与调试（阶段5通过后回填）

### 5.1 影响文件

| 文件 | 改动类型 | 说明 |
| --- | ---- | --- |
| {{固件新增模块路径：待定（需人确认）}} | 新增 | 连续帧判决状态机（30 帧报警/60 帧解除） |
| {{报警输出接线/接口}} | 预留 | A6-01 红灯快闪 / A6-03 蜂鸣器（A6 未开始，待定（需人确认）） |

### 5.2 调试要点

* 提前报警 → 查"连续"判定清零逻辑；不解除 → 查 60 帧累加路径

* 重启残留 → 查计数器初始化（含看门狗复位路径）

### 5.3 测试入口

* §3.2 全流程 + §3.3 边界用例表（对应 AC-01\~AC-03、AC-10）

## 6. 执行日志

| 时间 | 阶段 | 角色 | 摘要 | 遇阻 |
| --- | --- | ---- | --- | --- |
| 2026-09-01 | 阶段 1 准备 | Dev  | A4-02 依赖确认（判别比 2.52× 在案）；判决输入 s\_dmin 100 帧/s、输出串口 ALARM 行 + A6 接口预留；影响：新增 BSP/debounce.c/h + freertos.c 挂接，不触 A4-02 内部。阈值定标（A4-02 存证 CSV）：TH=6.0（正常误判 1%/金属漏判 16%）。**设计矛盾提出**：规格"连续 30 帧"对敲击类瞬态（间歇清零）可能不触发 → 人拍板**方案 B 双轨**（连续 30 帧规格判据 + 1s 窗 m-of-n ≥30 帧比率判据） | 无 |
| 2026-09-01 | 阶段 3 实现 | Dev  | debounce.c/h 双轨状态机（位图滑窗 O(1)）；freertos.c mel\_frame\_cb 逐帧喂入 + SpecTask 事件即时打印（ALARM on src= / off n=）；Makefile 登记 BSP/debounce.c（BUG-002 教训）。编译通过（text=168740 / bss=97032），烧录验证。**修复**：解除时清空 s\_win\_bits 位图（防陈旧位弹出致 win\_anom 下溢）；事件打印绕 1s 节流即时输出 | 无 |
| 2026-09-01 | 阶段 4 测试 | Test | 硬件实测：正常段误报 0、异常段 `ALARM on src=mofn n=30`（轨2 触发 \~0.5s）、解除 `ALARM off n=60`。**轨1 硬件不可复现**（d 抖动间歇清零）→ PC 仿真 simulate\_debounce.py 复刻状态机跑 §3.3 六用例 6/6 PASS（29 不报/30 consec 报/59 不解/60 解除/散布 mofn）。**吹气歧义提出**：A4-02"吹气不可分"被误读为"吹气永不报警"，实际为灰度带，TH=6.0 下吹气可触发 mofn → 人拍板先做**纯吹气 A/B 对照**定策略 | 轨1 硬件不可复现（PC 仿真闭环） |
