wumu-dot/SoundDog/docs/features/FEAT-A4-02-距离实时比对.md

# FEAT-A4-02-距离实时比对

> **AI 执行规则**：必须按阶段顺序执行，每个阶段开头声明角色。严禁跳跃、越界、自审自判。
> 阶段间停等：每完成一个阶段，停下来，输出结果，等人说"继续"。
> 阶段5通过后：回填父FEAT项目表该行 + 更新 `docs/features/INDEX.md` + `docs/features/维护地图.md`。
> 历史记录只更新状态字段，严禁删除/篡改已完成记录。
> 事实来源：`.sop-agent规格.md` §3（禁止自造数值）。

## 0. 元数据

* **父FEAT**：FEAT-A4-模版比对检测

* **优先级**：P1

* **预估总耗时**：2h

* **当前状态**：🟢阶段 5 评审通过待收官（快照 1.4×→峰值 0.95×→金属敲击 2.52× 达标；吹气类不可分已归因；R23 评审"修复后可"，I-1/I-2/M 项已闭环）

## 1. 总体目标与硬边界

### 1.1 核心目标（一句话）

> 板端实时计算当前 13 维 MFCC 特征与 16 个正常模版的距离（欧氏/余弦），**取最小距离 d\_min** 输出，为 A4-03 连续帧判决提供输入。

### 1.2 地基触碰前置自检

* [x] 否 → 继续（App 层实现；如需 CMSIS-DSP 数学函数，仅链接不改源码，见 A2-01 事实）

### 1.3 任务边界

| 类型 | 具体内容 |
| --- | --- |
| 范围内（可改） | 距离计算模块、d\_min 输出接口（供 A4-03）、阈值常量（暂定，A4-04 使其可配置） |
| 超出范围（禁止碰） | `firmware/Drivers/` HAL 底层库、A4-01 模版生成（PC 端）、A4-03 防抖判决 |
| 外部依赖 | A4-01 通过（16 个 13 维模版可用）、A3 通过（板端 13 维 MFCC 特征流） |

### 1.4 关键参数（事实包 §3，禁止自造）

* 模版库：**16 个簇中心**（A4-01 输出，每个 13 维向量）。

* 距离度量：**欧氏距离 / 余弦距离**（A4-02 事实；**默认：欧氏**——阶段 2 定稿，见 §1.5 决策表）。

* 判决量：**取最小距离 d\_min**（A4-02 事实，不可改）。

* 异常阈值：d\_min 判定阈值 **不在本 FEAT 定**（判决属 A4-03，阈值下发属 A4-04；本 FEAT 只输出 d\_min 原始值）。

* 特征帧率参考：帧移 10ms=160 样（A3-01 事实）；**逐帧 100 帧/s**（mel\_frame\_cb 挂接，同 A3-02/03 网格）。

### 1.5 设计定稿（阶段 2 输出，2026-09-01，按八节模板 + R29 四件套）

#### 一、已确认决策

| 决策项 | 定稿 | 来源/理由 |
| --- | --- | --- |
| 距离度量 | **欧氏距离**（平方距离比较，仅出值 1 次 sqrt） | ① sklearn KMeans 即欧氏空间聚类，模版空间与度量必须一致（余弦质心无最优性保证）② 无除零 NaN 坑 ③ sqrt 单调 → 比较用平方值免 16 次 sqrt |
| 模版加载方式（原文待定） | **编译期常量直接 include** **`model_normal.h`** | A4-01 阶段 2 定稿（MODEL\_NORMAL\_K/D + const 数组）；A7-03/A4-04 就绪后换数据来源不改接口语义 |
| 挂接点 | `mel_frame_cb` 内 mfcc\_dct\_process 之后逐帧调用 | 同 100 帧/s 规整 10ms 网格（A3-02 帧率口径修正先例）；打印 1s 节流仅显示层 |
| d\_min 输出接口  | `int dist_process(const float32_t *mfcc13, float32_t *d_min)`——0 成功/-1 参数空；A4-03 消费 | 沿项目惯例（mfcc\_dct\_process 同款签名风格） |
| 串口打印 | `DMIN d=<×100 整数> m=<1s 窗峰值 ×100>`，1s 节流，前缀 DMIN 防撞行 | ×100 定标（newlib-nano 无 %f，坑 6 惯例）；m= 为阶段 4 诊断增强（R30 偏差登记：快照漏帧级瞬态） |
| 阈值 | **本 FEAT 不设阈值**（只输出 d\_min 原始值） | 判决属 A4-03、下发属 A4-04；阶段 4 仅做正常/异常 d\_min 区间实测对比 |

#### 二、坑清单（R27 源③：坑→后果→预防→验证判据）

| # | 坑 | 后果 | 预防 | 验证判据 |
| - | --- | --- | --- | --- |
| 1 | 度量空间不一致（余弦比对欧氏质心） | d\_min 无判别力、误报/漏报 | 模版与度量同欧氏空间（阶段 1 定） | 阶段 4 正常/异常 d\_min 区间显著分离 |
| 2 | 每模版取 sqrt 后比较 | 精度损耗 + 16 次多余 sqrt | 平方距离比较，仅出值 1 次 sqrt | 代码评审确认 |
| 3 | 模表被 gc-sections 丢弃 | 链接丢模版数据 | 本 FEAT 引用 model\_normal 后自然保留 | size text 较 A4-01 基线 +\~832B |
| 4 | 打印撞行（与 MFCC13/MEL 交错） | 采集解析污染 | DMIN 前缀 + 1s 节流 + 静态缓冲整行 Transmit | 串口日志逐行前缀唯一 |
| 5 | newlib-nano 无 %f | d\_min 打印失败/链接膨胀 | ×100 整数定标（惯例） | 串口输出正常数值 |
| 6 | 新源文件漏登记 C\_SOURCES | 链接失败（BUG-002） | 编码步骤含 Makefile 登记 | build.bat 通过 |
| 7 | 特征流未初始化即计算 | 全 0 帧 d\_min 误导 | dist 挂 s\_mel\_ok 门控链之后（mel 失败即不注册回调） | 复用 A3-03 评审 M-1 门控先例 |
| 8 | 1s 快照观测漏帧级瞬态 | AC-02 误判"无区分" | 1s 窗峰值 m= 统计（阶段 4 偏差登记） | 峰值口径判别比复测 |
| 9 | 峰值统计搬离回调/改抽样（打印任务里"顺便采样"） | max 系统性低估 2\~4×（ViolaWake PR#34 实证：抽稀 max 只会丢最坏帧） | 峰值累积必须留在 mel\_frame\_cb 对全部 100 帧逐帧比较 | 代码位置审查：s\_dmin\_peak 更新在回调内  |

#### 峰值观测设计补研（R27 补课，2026-09-01，先写后研已认账）

* **源② Issue 区调研：ViolaWake PR#34**（GitHub issue/PR 实证）：报告 max 取自抽稀子集 → 低估 2\~4×；修复=取全流 worst。核对：本项目峰值在回调内对全部 100 帧比较，合规（坑 9 由此提炼）

* **源② Edge Impulse 官方后处理**：窗口均值平滑 → 阈值 → 抑制期（生产判决不用裸 max）

* **源② prmon-anomaly-detection**：run 级判定 = ≥10% 时间步被标记（m-of-n 比率聚合）

* **源② AdaBEAM**（DCASE ASD 2026）：mean/max 双轨分数各捕稳态/瞬态，单用有盲区

* **结论**：m= 作为测量口径维持现状；**A4-03 立项输入**——判决不裸用 max 过阈值，应走窗口均值或 m-of-n 连续帧比率（恰与 A4-03"连续帧判决"规划吻合），此条已回填父 FEAT

#### 三、资源预算

* **CPU**：208 MAC（16 模版 × 13 维）/帧 × 100 帧/s = 2.08 万 MAC/s ≈ 2.1 万周期/s @168MHz = **0.012%**（vs specTask 现有 FFT/Mel/DCT 负荷 \~1ms/帧，增量可忽略）

* **RAM**：d\_min 静态 8B（含峰值）+ DMIN 行缓冲 32B 静态；无堆无动态

* **Flash**：代码 \~250B + 模表 832B（gc 保留后）≈ +1.1KB

* **串口带宽**：DMIN 行 \~18B/s，总打印预算（BANDS+MEL+MFCC13+DMIN < 350B/s）仍在 115200bps（\~11.5KB/s）内

#### 四、改动影响地图（R9/R29）

* **新增** `BSP/dist.c/h`（纯函数，无状态无 init）；Makefile C\_SOURCES +1 行

* **修改** `freertos.c`：mel\_frame\_cb 尾部 +1 行调用（s\_mel\_ok 门控链内）+ 峰值累积 3 行；SpecTask 打印块 +DMIN 节流段（复制 dct 段模式）

* **不触**：mel.c/mfcc\_dct.c/model\_normal.c（只读消费）、USART1 单写者、A4-03 判决逻辑、ISR/队列

* **零冲突面**：dist\_process 仅在 specTask 上下文调用（单消费者约定），无重入问题

* **编译期耦合检查**：`_Static_assert(MODEL_NORMAL_D == MFCC_DCT_OUT)`（A3-01 评审 M-2 先例）

#### R29 四件套之①：GitHub 调研（阶段 1 已做，标记可抄性）

* CMSIS-DSP `arm_euclidean_distance_f32`（官方，标量路径 6 行）——**算法可复制**（R28：硬件无关），本地未 vendor DistanceFunctions .c → 沿 A3-03 对策 B 先例自写 208-MAC 循环

* Edge Impulse K-means 异常检测块（官方文档）——**"nearest centroid distance 超阈值=异常"模式可复制**；差异：EI 含簇半径（距边缘），本项目无半径 → 裸 d\_min，阈值吸收

* iot-anomaly-detector（Arduino 落地实例）——**部署形态可参考**（质心表+最近距离=异常分）

## 2. 执行路线图（5 阶段）

### 🟢 阶段 1：准备（角色：Dev Agent）✅ 完成（2026-09-01）

* **阶段目标**：确认 A4-01 已通过、定位 A3 特征流接口，输出影响范围

* [x] 步骤1：确认 A4-01 已通过，模版数据（16×13）可加载（格式：**编译期常量 include model\_normal.h**，阶段 1 定案回填 §1.5）

* [x] 步骤2：定位 A3 MFCC 输出接口（mel\_frame\_cb → mfcc\_dct\_process → s\_mfcc13，100 帧/s）

* [x] 步骤3：影响范围：新增 BSP/dist.c/h + freertos.c 1 处挂接 + 1 打印段（详见 §1.5 四）

* **判定标准**：模版与特征流接口均明确 ✅

* **⏸️ 停等：人确认后进入阶段 2** ✅（人确认"继续"）

### 🔵 阶段 2：设计（角色：Dev Agent）✅ 完成（2026-09-01）

* **阶段目标**：设计距离计算接口并产出 §3 操作单

* [x] 步骤1：设计距离计算接口（输入 13 维特征 + 16 模版 → 输出 d\_min）→ §1.5 一

* [x] 步骤2：确定欧氏/余弦实现方式与默认选择 → **欧氏**（§1.5 决策表）

* [x] 步骤3：产出 §3 操作单（含正常/异常 d\_min 对比实验）→ §3 全待定项定值

* **判定标准**：操作单每步有期望值与记录空位 ✅

* **⏸️ 停等：人确认后进入阶段 3** ✅（人确认"继续"）

### 🟠 阶段 3：实现（角色：Dev Agent）✅ 完成（2026-09-01）

* **阶段目标**：实现距离计算并编译烧录

* [x] 步骤1：实现距离计算（**欧氏**——平方距离比较+出值 1 次 sqrt，BSP/dist.c 复刻官方 arm\_euclidean\_distance\_f32 标量算法注明出处；freertos.c 挂 mel\_frame\_cb 尾部 + DMIN 打印段 + \_Static\_assert 维度耦合检查；Makefile 登记 BSP/dist.c 坑 6 预防）

* [x] 步骤2：`firmware\build.bat` 编译 ✅（**退出码 0、\[ OK ] Build OK**；dist.o/freertos.c 零告警；`__FPU_PRESENT redefined` 为存量告警非新增）

* [x] 步骤3：`firmware\build_and_flash.bat` 烧录 ✅（人执行烧录成功，串口 DMIN 行输出确认）

* **判定标准**：编译/烧录输出证据已记录 ✅（size：text=167992，较基线 166860 **+1132B**——坑 3 判据达成：模表 832B gc 保留 + dist 代码 \~300B，与 §1.5 三预算吻合）

* **⏸️ 停等：人确认后进入阶段 4** ✅（人确认"好的，执行吧"）

### 🟣 阶段 4：测试（角色：Test Agent）⏳ 进行中

* **阶段目标**：独立验证——按 §3 操作单实测正常/异常 d\_min，核对 §4

* [x] 步骤1：正常工况采集 d\_min 序列（70s：d 0.98\~5.16，均值 2.05，§3.2）

* [x] 步骤2：异常工况采集 d\_min 序列（70s 持续吹气+敲击：d 1.17\~7.62，均值 2.87；快照判别比 1.4× 未达 2×）→ 偏差登记：加 1s 窗峰值 m= 重测帧级口径

* [ ] 步骤3：峰值口径复测正常/异常两轮，判 AC-02

* [ ] 步骤4：逐条核对 §4 验收标准；若失败 → 查 §3.4 故障表，退回阶段 3

* **判定标准**：AC-01/AC-02 有实际记录数值

* **⏸️ 停等：人确认后进入阶段 5**

### 🔴 阶段 5：审查（角色：Review Agent）

* **阶段目标**：独立审查——AC 逐条打勾、d\_min 输出接口与 A4-03 约定一致

* [ ] 步骤1：核对 §4 全部 AC 勾选与记录值

* [ ] 步骤2：核对 d\_min 输出（数据类型/更新节拍）与 A4-03 接口一致

* **判定标准**：AC 全部通过且记录值完整

* 全部通过 → ✅ 回填「维护与调试」+ 父FEAT项目表 + INDEX + 维护地图

* 未通过 → 退回对应阶段并附意见

* **⏸️ 停等：人确认 Review 通过后归档**

## 3. 傻瓜式操作单（照做即可）

### 3.0 物品/工具清单（动手前先打勾，缺一不可）

* [x] 核心板（A1-01 接线 + A3 MFCC 打印正常）

* [x] A4-01 模版文件（16×13，导入方式：**编译期常量 include model\_normal.h，已就位**）

* [x] ST-Link（SWD：SWDIO/SWCLK/GND/3.3V 四线）

* [x] USB-TTL（CH340）+ 串口脚本 scripts/collect\_dmin.py（115200，COM4）

* [x] 5V 电源（非快充；供电红线沿用 A1-01 §3.2：**严禁手机快充头**）

### 3.1 编译烧录

1. 模版已编译期链接（A4-01 产物），dist 模块编码时 Makefile 登记 `BSP/dist.c`。
2. `firmware\build.bat` 编译 ✅（退出码 0、\[ OK ] Build OK；无新增告警）。
3. 烧录 ✅（人执行 build\_and\_flash.bat / ST-Link，串口 DMIN 行确认）。
4. size 核对 ✅：text=167992，较 A4-01 基线（166860）+1132B（模表 gc 保留 832B + dist 代码；坑 3 判据达成）。峰值增强后再编译 +52B/bss+8B。
5. 失败兜底：OpenOCD 连不上 → 查 SWD 四线；仍不行 → `firmware\flash_isp.bat`（BOOT0+USART1，见 HANDOFF §4.3）。

### 3.2 正常工况 d\_min 采集

1. 上电，串口观察 `DMIN d= m=` 行（1s 一行），保持与 A4-01 采集同款环境声（**时长 ≥60s**，记录实际时长：**70s**）。
2. 记录 d\_min 序列范围：**正常 d\_min：快照 0.98 \~ 9.08（第一轮 0.98\~5.16 均值 2.05；第二轮 1.29\~6.96 均值 3.11，背景漂移见日志）；峰值 m 4.71 \~ 9.08 均值 6.32**（×100 定标已还原，CSV 存证 data/dmin\_normal2.csv）。
3. 记录是否出现异常判定：本 FEAT 无判决，仅观察 d\_min 稳定性（两轮均 70s/69 行无缺行）。

### 3.3 异常工况 d\_min 采集

1. 异常声源两轮：**吹气+敲击**（宽带噪声类）与 **金属敲击**（结构异响类），各持续 **≥60s**（实际：均 70s）。
2. 记录 d\_min 序列范围：**吹气+敲击：快照 1.17 \~ 7.62 均值 2.87 / 峰值 m 4.61 \~ 8.65 均值 6.02；金属敲击：快照 1.80 \~ 12.69 均值 7.83 / 峰值 m 8.99 \~ 13.63 均值 11.87**（CSV 存证 data/dmin\_anomaly2.csv / dmin\_anomaly\_metal.csv）。
3. 对比：**异常 d\_min 应明显大于正常 d\_min**——金属敲击判别比 **2.52×（快照均值 7.83 vs 3.11）≥2× 达标**；吹气类 1.4×（不可分，归因见执行日志：宽带噪声与背景在 MFCC 空间同分布，交 A4-01 异常类型定义/A4-03 吸收）。

### 3.4 故障速查表

| 现象 | 可能原因 | 处理 |
| --- | --- | --- |
| d\_min 恒为 0 或全部相等 | 模版未加载 / 特征恒 0 | size 核对 +832B（坑 3）；回 A3 查特征流 |
| 正常/异常 d\_min 无区分  | 观测粒度（先查坑 8 峰值口径）；模版不具代表性 / 特征失效 | 峰值复测仍无区分 → 回 A4-01 重采；回 A3-04 验证特征 |
| 编译失败（链接错误） | 新源文件漏加 C\_SOURCES（BUG-002 教训） | 确认 Makefile `C_SOURCES` 已加 `BSP/dist.c` |
| 烧录失败 | ST-Link 接线/驱动 | 查 SWD 四线；兜底 `flash_isp.bat`（HANDOFF §4.3） |
| d\_min 为 NaN | 输入含 NaN（上游特征坏） | 欧氏无除零（设计已规避余弦）；回 A3-03 查 log 域 |

## 4. 验收标准（12 条）

### 功能验收

* [x] AC-01 正常工况 d\_min 可测量且稳定（记录区间），无误报（快照 0.98\~9.08 两轮 + 峰值 m 4.71\~9.08，69 行/轮无缺行，CSV 存证）

* [x] AC-02 异常工况 d\_min 明显大于正常工况（金属敲击快照均值 7.83 vs 正常 3.11 = **2.52× ≥2× 达标**，区间几乎不重叠；吹气类 1.4× 不可分已归因归档，异常类型定义边界交 A4-01/A4-03）

* [x] AC-03 编译通过：`build.bat` 无错误退出（✅ 退出码 0，三次编译均过：含 dist 模块 +1132B、峰值观测 +52B）

* [x] AC-04 无新增警告（✅ dist.o/freertos.c 零告警；\_\_FPU\_PRESENT 为存量）

* [x] AC-05 文档已更新（本 FEAT 维护章节 + 父表回填：FEAT-A4 §0/§3/§4/§6 已同步 A4-02 收官）

### 代码质量 / 安全红线 / 测试边界

* [x] AC-06 无硬编码密钥/凭据：**N/A**（无密钥/凭据概念——说明；阈值暂为代码常量，A4-04 使其可配置）

* [x] AC-07 错误处理：模版未加载 / 特征维度≠13 时有防御——\_Static\_assert 维度耦合（编译期阻断）+ dist\_process NULL 参数返回 -1（R23 评审实读确认；NaN 传播路径 §3.4 已列）
* [x] AC-08 输入校验：13 维特征校验通过后才计算距离——编译期 \_Static\_assert（MODEL\_NORMAL\_D == MFCC\_DCT\_OUT）；R23 评审核对通过（运行时维度由编译期断言 + DCT 输出定长保证）

* [x] AC-09 新增测试：正常/异常样本各若干组（正常 2 轮 + 异常 2 轮各 70s/69 行——首秒边界少 1 行属采集启动正常现象，快照+峰值两口径，CSV 存证 data/dmin\_\*.csv ×3）

* [x] AC-10 全部回归：串口 boot 三行 + `max` 随声音变化不受影响（三轮采集中 MFCC13/MEL/SPEC/BANDS 计数正常；R11 CI=build.bat 编译校验退出 0）

* [x] AC-11 测试覆盖率：**N/A**（嵌入式手测场景，无覆盖率要求——说明）

* [x] AC-12 按 FEAT 模板执行（本文档结构合规）

## 5. 维护与调试（阶段5通过后回填）

### 5.1 影响文件

| 文件 | 改动类型 | 说明 |
| --- | ---- | --- |
| `firmware/soundDog/BSP/dist.c` / `dist.h` | 新增 | 欧氏距离（平方比较+1 次 sqrt）16 模版最小距离 d\_min |
| `firmware/soundDog/App/freertos.c` | 修改 | mel\_frame\_cb 尾挂 dist\_process + 峰值累积；DMIN 打印段（d/m 双字段） |
| `firmware/soundDog/Makefile` | 修改 | C\_SOURCES 登记 BSP/dist.c（坑 6） |
| `scripts/collect_dmin.py` | 新增 | 阶段 4 采集/统计/CSV 存证工具 |
| `firmware/soundDog/Inc/pin_config.h` | 不改 | 引脚权威（本 FEAT 不涉及新引脚） |

### 5.2 调试要点

* d\_min 全 0 / 无区分 → 先查峰值口径（坑 8），再查模版导入与 A3 特征流

* d\_min 为 NaN → 查上游特征（欧氏无除零）

### 5.3 测试入口

* §3.2/§3.3 正常/异常 d\_min 对比实验（对应 AC-01/AC-02）；scripts/collect\_dmin.py

## 6. 执行日志

| 时间 | 阶段 | 角色 | 摘要 | 遇阻 |
| --- | --- | ---- | --- | --- |
| 2026-09-01 | 阶段 1 准备 | Dev  | A4-01 模版就位（编译期常量）；特征流挂接点定位 mel\_frame\_cb→s\_mfcc13（100 帧/s）；R27 源①官方 arm\_euclidean\_distance\_f32 标量路径实读（6 行纯函数）、源② Edge Impulse K-means 块"nearest centroid"模式 + iot-anomaly-detector 实证；本地未 vendor DistanceFunctions .c → 沿 A3-03 对策 B 自写；初步决策：默认欧氏（模版空间一致性） | CodeGraph 未用（调用链单一 grep 实读定位，R22 降级说明：目标符号 3 个、路径唯一） |
| 2026-09-01 | 阶段 2 设计 | Dev  | §1.5 八节定稿：欧氏（平方比较+1 次 sqrt）/编译期 include/挂 mel\_frame\_cb/接口 dist\_process/DMIN 打印 ×100 定标/不设阈值（留 A4-03/04）；坑 7 条；资源预算 CPU 0.012%+RAM 36B+Flash \~1KB；影响地图（不触 mel/dct/model\_normal，零冲突面）；§3 操作单待定项全定值（60s 正常+60s 异常、判别比 ≥2×） | 无 |
| 2026-09-01 | 阶段 3 实现 | Dev  | dist.c/h 新增（208-MAC 平方距离最小搜索 + arm\_sqrt\_f32 出值，复刻官方标量算法）；Makefile 登记；freertos.c 挂 mel\_frame\_cb 尾 + DMIN 段 + \_Static\_assert 维度耦合；build.bat 退出 0、size text=167992（+1132B 与预算吻合，坑 3 判据达成）；dist.o 零告警 | 存量告警 \_\_FPU\_PRESENT redefined 非新增 |
| 2026-09-01 | 阶段 4 测试 | Test | 快照口径初测：正常 70s（d 0.98~~5.16 均值 2.05）vs 异常 70s 持续吹气+敲击（d 1.17~~7.62 均值 2.87）→ 判别比 1.4× 未达 ≥2×（AC-02 初判未过）；d\_min 扰动跟随确认（R25 因果链 OK）。成因：1s 快照漏帧级瞬态（坑 8） | R30 偏差登记：观测粒度不足 → freertos.c 显示层加 1s 窗峰值 m=（非算法改动，编译 +52B/bss+8B）；重测以帧级口径判 AC-02。另：本文档当日遭外部格式化工具多次实时改写（行数骤降/日志行被吞），以 Write 全量重写恢复并入 git 索引快照防丢 |
| 2026-09-01 | 阶段 4 测试 | Test | 峰值口径复测：AC-02 仍未过。正常 m 均值 6.32（4.71~~9.08）vs 异常 m 均值 6.02（4.61~~8.65）→ 判别比 0.95×，m 两工况均饱和——推翻"快照漏尖峰"假设。PC 离线复算（analyze\_dmin.py）：①固件 d 与 PC 复算一致（Δ≈0.01\~0.06）→ 距离计算正确（R25 条件：CSV 13 维存证×16 质心复算）；②分维判别比全维 <0.31 → 吹气（宽带噪声）与抖音工厂声在 MFCC 空间同分布；③正常背景相对模版整体漂移（d 均值 2.05→3.11，环境与采集日不同）。结论：瓶颈在特征/模版侧（A4-01 代表性+异常类型谱形态），非距离模块缺陷 | AC-02 对"吹气"类异常不可达；按 §3.4 指向回 A4-01（重采/异常类型定义）或 A4-03（判决统计量吸收）；停等人决策 |
| 2026-09-01 | 阶段 4 测试 | Test | **方案 A（金属敲击重测）：AC-02 达标 ✅**。异常 70s 金属敲击：快照 d 均值 7.83（1.80~12.69）vs 正常 3.11 → **判别比 2.52×（≥2× 判据达成）**，区间几乎不重叠；峰值 m 11.87 vs 6.32（1.88×）。离线复算：分维判别比 9 维 >0.5（c2=3.29/c0=2.44/c11=2.02，金属尖峰谱 vs 背景差异显著）；金属帧 69 中 48 帧聚簇 6（异常呈点聚集态，正常分散 16 簇）；固件-PC 一致性中位 Δ=0.01（51/69 行定标精度内）。R25 条件：同日同环境，正常=环境声背景、异常=金属物敲击。**R23 评审修正（I-1）**：金属轮 18/69 行 Δ>0.5（最大 2.55）系采集脚本按下标配对遇串口丢行错位所致（非定标误差，原"动态范围大"归因失实，已更正）；错位数据已标记 caveat 禁入 A4-03 阈值标定；collect_dmin.py 已加行数配对防护，行级帧号对齐列为 A4-03 立项输入 | 吹气类不可分结论维持（归档）；AC-01/AC-02/AC-09/AC-10 全过，AC-07/AC-08 阶段 5 复核；停等人确认进阶段 5 |
| 2026-09-01 | 阶段 5 评审 | Review | R23 独立评审（子代理实读+PC 独立复算）：固件四项（dist.c/h、freertos.c 挂接、Makefile）零代码缺陷通过；测试数值全部真实（判别比 2.52×/簇 6 聚集/分维比复算吻合）。结论"修复后可"。闭环 7 项：I-1 Δ=0.32 归因更正（串口丢行错位非定标误差）+ collect\_dmin.py 行数配对防护；I-2 §0 状态/§3.2-3.3 记录位/AC 复选框回填；M-1/M-2 analyze\_dmin.py 模版解析健壮化+argv 校验；M-3 8 维更正 9 维；M-4 AC-09 行数口径对齐 69；M-5 DMIN 打印 len 钳位+行尾补偿（防御，build.bat 退出 0，正常路径行为不变不重烧） | 评审余留观察项（A4-03 立项输入）：DMIN/MFCC13 行级帧号对齐、金属轮 26% 错位行 caveat、吹气类异常类型边界定义 |
