wumu-dot/SoundDog/docs/features/.sop-agent规格.md

# Agent 傻瓜式操作单 · 统一规格（SOP 规范）

> **用途**：本文件定义"傻瓜式操作单"的格式与 Agent 执行铁律。所有子 FEAT 文档（新建或重写）必须遵守本规格。
> **目标**：任何一个**没有对话上下文**的 Agent，只读文档即可独立、正确、不越界地执行完 5 阶段。
> **地位**：与 `.template-child.md`（最小骨架）配合；本规格是"细化实施层"。事实以 `pin_config.h` / `HANDOFF.md` / 本规格 §3 为准，**Agent 禁止猜测、禁止自造数值**。

## 0. 文档体系

* 父 FEAT = 规划（Planner 角色），子 FEAT = 执行（Dev → Test → Review 角色）。

* 父 FEAT 文档：项目表 + 依赖顺序 + 阻塞（规划层，不写实现）。

* 子 FEAT 文档：5 阶段执行 + §3 傻瓜式操作单（执行层，照做即可）。

* 新建子 FEAT 文件命名：`FEAT-{A1}-{NN}-{中文描述}.md`，并在父 FEAT 项目表「文件」列回填。

## 1. Agent 执行铁律（防翻车 · 硬性，违反即退回）

### 1.1 动手前必读（按任务类型）

| 要做什么 | 必读文件 |
| --- | --- |
| 任何代码改动 | `CLAUDE.md`（硬边界）+ `PROJECT_PLAN.md` §5.1（任务规划）+ 本 FEAT 文档 |
| 硬件接线/测量 | `HANDOFF.md` §4.2 + `firmware/soundDog/Inc/pin_config.h` + 本 FEAT §3 |
| 时钟/I2S 相关 | `docs/CubeMX_I2S3配置详解.md` + `firmware/soundDog/soundDog.ioc` |
| 编译/烧录 | `firmware/build.sh` / `firmware/build_and_flash.bat` 使用说明 |
| 出问题查故障 | `docs/troubleshooting/bug_shturl` + `docs/bugs/` |

### 1.2 绝对禁止（红线）

1. 禁止修改 `firmware/Drivers/` 下任何 HAL 库文件。
2. 禁止未读 §1.1 必读文件就动手改代码。
3. 禁止跳阶段 / 自审自判：阶段 4 必须 Test 角色独立验证，阶段 5 必须 Review 角色独立审查。
4. 禁止删除/篡改执行日志中已完成的历史行（只允许追加新行、更新状态字段）。
5. 中断优先级 0~~4 禁止调用 FreeRTOS FromISR API（仅 5~~15 可安全调用）。
6. 禁止在 ⏸️ 停等点未获人确认"继续"前进入下一阶段。
7. 禁止为"通过"而编造证据——无证据的"看起来正常"一律视为未通过。

### 1.3 判定标准（有客观证据才算通过）

| 验证项 | 通过证据（必须记录实际值） |
| ----- | --- |
| 编译 | `build.bat` 无错误退出，无新增警告 |
| 烧录 | OpenOCD 输出 `wrote ...` / `Verified OK` |
| 串口 | 抓到的 boot 三行 + `max` 数值变化（记录读数） |
| 硬件电压  | 万用表读数落在期望区间（记录数值） |
| 逻辑分析仪 | 实测 SCK 频率在期望 ±5%（记录数值） |

### 1.4 阶段输出格式（每阶段完成时输出，供人确认）

```
【阶段N 完成｜角色：Dev/Test/Review】
做了什么：<一句话>
证据：<串口/万用表/编译输出实际值>
下一步：请确认"继续"进入阶段N+1
```

## 2. 子 FEAT 文档结构（傻瓜式操作单格式）

在 `.template-child.md` 基础上增强：

* **§1.4 关键参数与接口**：写具体数值/文件名/命令（从本规格 §3 抄，禁止自造）。

* **§2 执行路线图**：每阶段 = 【读什么 → 做什么（checkbox 步骤）→ 判定标准 → ⏸️ 停等】。

* **§3 傻瓜式操作单**（阶段 2 的产物，阶段 3/4 照做）：

  * 3.0 物品/工具清单（☐ 打勾，缺一不可）

  * 3.1\~3.n 分步操作：每步 = 动作 + **期望值** + 记录空位（`记录数值：___`）

  * 最后一节 = **故障速查表**（现象 → 可能原因 → 处理）

  * 硬件步骤必须含**红线警告**（如供电、防短路）

* **§4 验收标准**：12 条具体化，可测量可判定；纯硬件/纯验证步骤不适用项标 N/A 并说明。

* **§5 维护与调试**：影响文件 / 调试要点 / 测试入口（阶段 5 通过后回填）。

* **§6 执行日志**：追加不删除。

## 3. 项目事实包（Agent 唯一事实来源 · 禁止自造数值）

### 3.1 芯片与时钟

* STM32F407ZGT6；HSE=8MHz → SYSCLK 168MHz（PLLM=8/PLLN=336/PLLP=2）。

* I2S3：PLLI2SR=5 → I2SxCLK=51.2MHz；I2SDIV=25 → SCK=1.024MHz；Fs=SCK/64=16kHz。

* NVIC 分组 4；`configLIBRARY_MAX_SYSCALL_INTERRUPT_PRIORITY=5`；TIM7=HAL 时基、SysTick=FreeRTOS tick。

### 3.2 引脚（权威 `pin_config.h`，改引脚只改此文件）

| 功能 | 引脚 | 备注 |
| --- | --- | --- |
| I2S3 WS | PA4 | 主模式 |
| I2S3 CK | PB3 | SCK，预期 1.024MHz |
| I2S3 SD | PB5 | INMP441 SD，建议 4.7kΩ 上拉至 3.3V |
| LED 红 | PB0 | TIM3\_CH3，串 220Ω |
| LED 绿 | PB1 | TIM3\_CH4，串 220Ω |
| 蜂鸣器 | PE6 | 三极管驱动 |
| OLED | I2C1（PB6 SCL / PB7 SDA） | SSD1306 0.96"，地址 0x3C/0x3D |
| SHT30 | I2C1 | 温湿度传感器 |
| RS485 | USART3 + TTL-RS485 模块(3.3V/SP3485) | 模块引脚：**EN/VCC/A/B/GND×2/RXD/TXD**；EN=方向使能（高=发送/低=接收）接 GPIO(PD11) |
| 调试串口 | USART1 | 115200 |

### 3.3 构建与烧录

* 编译：`firmware\build.bat`（mingw32-make + arm-none-eabi-gcc）。

* 烧录 SWD：`firmware\build_and_flash.bat`（期望 `wrote ...` / `Verified OK`）。

* 兜底 ISP：`firmware\flash_isp.bat`（BOOT0 + USART1，见 HANDOFF §4.3）。

* Makefile 手动加源文件到 C\_SOURCES（BUG-002 教训：漏加导致链接失败）。

### 3.4 串口输出（USART1 · 115200）

* 开机三行：`SoundDog boot OK` → `I2S_DRV_Init ret=0` → `I2S DMA started`。

* 采集打印：`[n] max=xxxx`，max 随吹气/敲击明显变化。

* SSCOM 打开，COM 口以设备管理器为准（不一定是 COM4）。

### 3.5 已知 Bug（引用 `docs/bugs/`）

* BUG-20260816-001：`HAL_I2S_Receive_DMA` Size 翻倍溢出（已修：传半缓冲）。

* BUG-20260816-002：I2S 数据槽偏移，取数用 `(int16_t)(raw & 0xFFFF)`。

### 3.6 各 FEAT 关键参数（固化，禁止自造）

| FEAT  | 关键参数 |
| ----- | --- |
| A1-01 | 接线：VDD→3.3V、GND→GND、L/R→GND（必接）、SCK→PB3、WS→PA4、SD→PB5(+4.7kΩ)；供电红线：严禁快充头 |
| A1-02 | 烧录后串口 boot 三行 + `max` 随声音变化 |
| A1-03 | L/R→GND=左声道；数据在 32 位字低 16 位；取 `(int16_t)(raw & 0xFFFF)` |
| A1-04 | 逻辑分析仪 24M/8ch；SCK 实测期望 1.024MHz±5%；若 \~2.048MHz → 改 `soundDog.ioc` I2SDIV/PLLI2S |
| A2-01 | 链接 `libarm_cortexM4lf_math.a` 或直编 DSP 源；`-mfpu=fpv4-sp-d16 -mfloat-abi=hard` |
| A2-02 | 256 点 FFT；分辨率 16kHz/256≈62.5Hz/bin；1kHz→bin≈16；幅度 `arm_cmplx_mag_f32`；汉明窗 |
| A2-03 | OLED 32 频带柱状图；128 列每柱 4px；刷新 \~200ms（TaskDisplay） |
| A2-04 | 串口一行 32 个整数（能量）；节流 \~200ms |
| A3-01 | 预加重 α≈0.97；分帧 25ms=400 样 / 帧移 10ms=160 样；汉明窗 |
| A3-02 | 32 个三角 Mel 滤波器，覆盖 300Hz\~8kHz |
| A3-03 | Log 能量 + DCT-II，取前 13 维 MFCC |
| A3-04 | 串口打印 13 维，与已知信号特征吻合 |
| A4-01 | PC 端 K-means(K=16) 生成正常模版 |
| A4-02 | 欧氏/余弦距离，取最小 d\_min |
| A4-03 | 连续 30 帧异常报警、60 帧正常解除 |
| A4-04 | 阈值/帧数可经 RS485 下发 |
| A5-01 | USART3 + TTL-RS485 模块(3.3V/SP3485)：半双工；模块引脚 **EN/VCC/A/B/GND×2/RXD/TXD**，EN 接 GPIO(PD11) 方向控制（高=发送/低=接收）；回环可收发 |
| A5-02 | 帧头 0xA5 / 帧尾 0x5A / CRC16 |
| A5-03 | PC 端 USB-TTL + TTL-RS485 模块，与板端模块 A/B 对接，双向收发无误码 |
| A5-04 | 主从轮询，节点不主动发 |
| A6-01 | 红灯 PWM（TIM3\_CH3/PB0）：异常快闪/警告慢闪/正常灭 |
| A6-02 | 绿灯（TIM3\_CH4/PB1）：正常常亮/故障灭 |
| A6-03 | 蜂鸣器（PE6）异常断续报警 |
| A7-01 | SHT30 I2C1 温湿度，数值合理 |
| A7-02 | IWDG 看门狗，异常死机自动复位 |
| A7-03 | Flash 存模版参数 + 事件日志 |

### 3.7 开发机环境（2026-08-16 全量实测）

| 项 | 值 | 备注 |
| --- | --- | --- |
| 固件编译链 | arm-none-eabi-gcc 14.3.1（STM32CubeCLT 1.21.0）+ mingw32-make + OpenOCD 0.12.0 | ✅ 齐全 |
| CubeMX / ST-LINK Utility | ✅ 已装 | Program Files\ST / Program Files (x86)\ST |
| 驱动 | CH340(wch.cn)、ST-Link 全套(bridge/dbg/vcp)、Silicon Labs 串口 | ✅ 已装驱动包 |
| 项目脚本 | `build.bat`/`build_and_flash.bat`/`flash_isp.bat`/`build.sh`/`ci_local.sh` | ✅ 全存在 |
| 上位机 Python | **Anaconda** **`C:\Users\wumu2\anaconda3\python.exe`（3.13.5）** | 首选；`C:\Users\wumu2\pythonapp`（3.13.9）备选 |
| 已装包 | numpy 2.1.3 / scipy 1.15.3 / **matplotlib 3.10.0** / **scikit-learn 1.6.1** | Anaconda 自带 |
| 需补装 | 无（pyserial 3.5 已装） | 原计划 PySide6 因 6.11 DLL 加载失败已放弃；GUI 用 **matplotlib 3.10.0 + tkinter（Anaconda 自带）**，零新增依赖 |
| 串口助手 | **SSCOM 未安装** | A1\~A7 验证需它；免安装绿色工具，或改用 A8-01 pySerial 脚本替代 |
| 逻辑分析仪软件 | **Saleae Logic 1.2.17 已安装**（`C:\Program Files\Saleae Inc\`，Connected 验证通过；资料/说明书在 `桌面\stm32F407ZGT6\逻辑分析仪\`） | A1-04 用。~~原计划 PulseView(sigrok)~~——实际随机附赠 Saleae 克隆机资料，已装 Logic 1.2.17 替代（2026-08-28） |
| 其他 | Keil5、Qt、ESP-IDF、OpenCV、WCH 工具已装（无冲突） | dev-setup 的 CodeGraph/OpenCLI/Ponytail 未装（可选，不阻塞） |

## 4. 自检清单（Agent 写完文档后必须自查）

* [ ] 每阶段有角色声明 + 具体步骤 + 判定标准 + ⏸️ 停等

* [ ] §3 有物品清单 + 分步操作（含期望值/记录空位）+ 故障速查表

* [ ] §4 AC-01/02 可测量；AC-03\~12 不适用项标 N/A 并说明

* [ ] 全部数值来自本规格 §3 / 父 FEAT / 必读文件，无自造

* [ ] 执行日志历史行未删除

* [ ] 文件名符合 `FEAT-{父}-{NN}-{描述}.md`，父表已回填
