wumu-dot/SoundDog/docs/features/.template-parent.md

# FEAT-{A1}-{简短描述}（父FEAT · 统筹规划）

> **AI 执行规则**：父FEAT 只做统筹规划，禁止编写实现代码；实现一律拆成子FEAT。
> 创建/修改项目表后必须停等，输出结果等人类确认方向后才允许创建子FEAT。
> 禁止自审自判完成：父FEAT 置 🟢 仅当项目表全部子FEAT 🟢 且每个都经过 Review。
> 历史记录只更新状态字段，严禁删除/篡改已完成记录。

## 0. 元数据

* **角色**：Planner（统筹规划）

* **优先级**：P0(阻断) / P1(紧急) / P2(正常) / P3(可缓)

* **预估总耗时**：

* **当前状态**：🔴规划中 / 🟡部分子FEAT完成 / 🟢全部完成

## 1. 总体目标与方向

### 1.1 核心目标（一句话）

> 示例：实现 {{功能域}} 的 {{能力}}，支撑 {{大阶段目标}}。

### 1.2 大方向策略

> 示例：先 {{基础能力}} 后 {{进阶能力}}；优先复用 {{现有模块}}，不重复造轮子。

### 1.3 硬边界（继承 CLAUDE.md）

* [ ] 是否涉及底层库 / 第三方库？是 → 暂停，进地基评估

* [ ] 否 → 继续进入项目表规划

## 2. 项目表（子FEAT清单）

> 每个子FEAT 按子模板（`.template-child.md`）创建，独立执行 5 阶段（准备→设计→实现→测试→审查）。

| 子FEAT编号 | 功能 | 验收要点 | 优先级 | 依赖 | 状态 | 文件 |
| --- | --- | --- | --- | ----- | ----- | --- |
| FEAT-{A1}-01 | {{功能}} | {{验收要点}} | P2  | 无 | 🔴未开始 | `FEAT-{A1}-01-{简短描述}.md` |
| FEAT-{A1}-02 | {{功能}} | {{验收要点}} | P2  | 依赖 01 | 🔴未开始 | `FEAT-{A1}-02-{简短描述}.md` |

> 子FEAT 完成后回填本行状态与文件链接（🟢已完成 / 🟡阶段X进行中）。

## 3. 依赖与执行顺序

1. {{先做X}} → {{再做Y}}（{{原因}}）
2. {{可并行}}：{{功能C}} 与 {{功能D}} 互不依赖

## 4. 阻塞与下一步

* **阻塞**：{{阻塞原因（如：等硬件）}}

* **下一步**：{{第一个要开的子FEAT及其原因}}

## 5. 完成定义（DoD）

* [ ] 项目表全部子FEAT 🟢 且每个经 Review

* [ ] 本表状态与 `docs/features/INDEX.md` 一致

* [ ] 经验教训已提炼（如有）

## 6. 执行日志

| 时间 | 动作 | 角色 | 摘要 | 遇阻 |
| --- | --- | --- | --- | --- |
| <br /> | <br /> | <br /> | <br /> | <br /> |
