wumu-dot/SoundDog/docs/features/FEAT-A4-01-离线模版生成.md

# FEAT-A4-01-离线模版生成

> **AI 执行规则**：必须按阶段顺序执行，每个阶段开头声明角色。严禁跳跃、越界、自审自判。
> 阶段间停等：每完成一个阶段，停下来，输出结果，等人说"继续"。
> 阶段5通过后：回填父FEAT项目表该行 + 更新 `docs/features/INDEX.md` + `docs/features/维护地图.md`。
> 历史记录只更新状态字段，严禁删除/篡改已完成记录。
> 事实来源：`.sop-agent规格.md` §3（禁止自造数值）。

## 0. 元数据

* **父FEAT**：FEAT-A4-模版比对检测

* **优先级**：P1

* **预估总耗时**：2h

* **当前状态**：🟢已收官（2026-09-01：600 帧 0 丢弃 → K-means 16 簇全非空 → model\_normal.c/h 导出 → 复现/错误输入/最小样本/编译四类验证 + R23 独立评审 2 项重要问题修复闭环）

## 1. 总体目标与硬边界

### 1.1 核心目标（一句话）

> 在 PC 端用 K-means（**K=16**）对 A3 产出的 **13 维 MFCC** 特征做聚类，生成"正常模版"库文件，供 A4-02 距离实时比对使用。

### 1.2 地基触碰前置自检

* [x] 否 → 继续（PC 端脚本/工具，不碰固件底层库）

### 1.3 任务边界

| 类型 | 具体内容 |
| --- | --- |
| 范围内（可改） | PC 端脚本/工具、特征数据采集整理、K-means(K=16) 聚类、模版文件导出 |
| 超出范围（禁止碰） | `firmware/Drivers/` HAL 底层库、固件代码、板端 Flash 写入（A7-03 范围） |
| 外部依赖 | A3-04 通过（串口可打印 13 维 MFCC）、PC 脚本运行环境（**阶段 1 已确认：Python + numpy 2.5.1 + sklearn 1.9.0**） |

### 1.4 关键参数（事实包 §3，禁止自造）

* 输入特征：**13 维 MFCC**（A3-03：Log 能量 + DCT-II 取前 13 维；A3-04：串口打印 13 维）。

* 聚类算法：**K-means，K=16**（A4-01 事实，不可改）。

* 输出：正常模版库 = **16 个簇中心**，每个 **13 维**向量。

* 串口打印格式：**`MFCC13 c=<13 维 ×100 整数逗号串>`**（阶段 1 定稿，A3-03 实现）。

* 模版文件格式：**C 常量表** **`model_normal.c/h`**（阶段 2 定稿，见 §1.5）。

* 样本量：**600 帧**（阶段 2 定稿，人确认）。

### 1.5 设计定稿（阶段 2 输出，2026-08-30，按八节模板 + R29 四件套）

#### 一、已确认决策（人确认"按 600 帧、目标环境声、Python 方案执行阶段 2"）

| 决策项 | 定稿 | 来源/理由 |
| --- | --- | --- |
| 样本量 | **600 帧**（采集约 10 分钟；K=16 每簇均值 \~37 帧） | 阶段 1 报告推荐，人确认 |
| 正常工况定义 | **目标环境声**（设备实际部署环境背景声；非绝对静音——静音地板帧 c0≈-11000 会聚废簇） | 阶段 1 报告推荐，人确认 |
| 脚本语言/库 | **Python + numpy + sklearn**（环境实测：numpy 2.5.1 / sklearn 1.9.0） | 阶段 1 实测闭环，人确认 |
| 串口打印格式（原文待定） | `MFCC13 c=<13 维 ×100 整数逗号串>`（A3-03 定稿，1s 节流 → **采集速率 1 帧/s，600 帧≈10 分钟**） | freertos.c:393 实读 |
| ×100 定标还原 | 解析时 `/100.0` 恢复 float；量化误差 ±0.005/维记录在案 | A3-03 坑 6 衍生 |
| K-means 随机种子 | **固定 seed=42**（AC-04 可复现要求；sklearn KMeans random\_state=42, n\_init=10） | 可复现性标准做法 |
| 模版文件格式（原文待定） | **C 源文件** **`firmware/soundDog/BSP/model_normal.c`**：16×13 float32 数组 + 头文件（A7-03 Flash 与 A4-04 RS485 下发均未实现——固件先以编译期常量表消费，后续 FEAT 替换为 Flash/RS485 加载路径；**不改 A4-02 接口语义，只换数据来源**） | 两条候选路径均未落地，编译期常量是最小可行方案 |

#### 二、坑清单（R27 源③：坑→后果→预防→验证判据）

| # | 坑 | 后果 | 预防 | 验证判据 | <br /> | <br /> |
| - | --- | --- | --- | --- | --- | --- |
| 1 | 串口流解析误收 BANDS/MEL 行 | 数据污染 → 聚类废 | 严格 `MFCC13 c=` 前缀过滤 | 抽查 5 行维数=13 | <br /> | <br /> |
| 2 | ×100 定标忘除回 | 模版量级大 100 倍，A4-02 距离全错 | 解析统一 /100.0；导出前量级检查（ | c0 | <200）  | 抽查簇中心 c0 与原始均值一致 |
| 3 | 静音地板帧混入 | c0≈-11000 帧聚成废簇、拉开距离分布 | 采集时保持目标环境声（人操作纪律）+ 聚类后检查各簇 c0 均值（地板簇≈-11000 且其余维≈0 → 剔除并补采） | 16 簇 c0 均值分布检查  | <br /> | <br /> |
| 4 | 空簇 | K=16 但特征多样性不足 | sklearn 默认 k-means++ 初始化 + 检查 labels 计数；空簇 → 补采或（人确认后）降 K | 各簇样本数 >0 | <br /> | <br /> |
| 5 | 未固定种子 | 两次运行 16 中心不同，AC-04 失败  | random\_state=42 硬编码 | 重跑 diff=0 | <br /> | <br /> |
| 6 | 断行/粘行（串口传输异常） | 维数≠13 行混入 | 解析器逐行校验维数，≠13 丢弃并计数（不中断） | 丢弃行计数=合理范围（<1%） | <br /> | <br /> |
| 7 | 模版 C 文件被 git 当二进制/编码错 | A4-02 集成异常 | ASCII 纯文本 + UTF-8 BOM？**否——C 源用纯 ASCII 无 BOM**（ARM 编译器口径），脚本生成时显式 encoding='ascii' | 编译器可读（阶段 5 核对）  | <br /> | <br /> |

#### 三、资源预算

| 资源 | 预算 | 说明 |
| --- | --- | --- |
| PC | 脚本 \~200 行 Python，内存 <10MB | numpy/sklearn 标准负载 |
| 固件 flash | **+1.0KB（16×13×4B=832B 数据 + 访问代码）** | model\_normal.c 常量表；A4-02 消费 |
| 固件 RAM | 0（const 常量） | —— |
| 采集 | 600 帧 × 1s = **10 分钟人工** | 1s 节流瓶颈（禁改固件） |
| 串口带宽 | 采集期 90B/s（既有） | 无新增 |

#### 四、影响地图

| 文件 | 改动 | 说明 |
| --- | --- | --- |
| `scripts/collect_mfcc.py`（名待定稿） | 新增 | 串口采集：读 COM 口 → 前缀过滤 → 存 CSV（600 行停） |
| `scripts/kmeans_model.py`（名待定稿） | 新增 | CSV → K-means(K=16, seed=42) → 导出 model\_normal.c/h |
| `firmware/soundDog/BSP/model_normal.c/h` | 新增 | 16×13 float32 常量表（A4-02 消费，本 FEAT 只生成不集成） |
| `data/mfcc_normal_600.csv` | 新增 | 特征样本存档（复现证据） |
| 固件源码/Makefile | **零改动**（任务边界：板端 Flash 写入是 A7-03 范围） | model\_normal.c 编译集成留给 A4-02 |
| 复用 serial\_capture.py | 只读模式重用 COM 口参数，不改它 | —— |

**GitHub 调研（R29 第一件套）**：① micro\_speech（TF 官方）——模版/均值比对走"PC 提取特征→C 数组编译进固件"路径（micro\_features 模型即 C 源表），与本设计同构，**可复制**（数据编译期集成的模式）；② Edge Impulse EON——聚类模版同样导出 C 常量表。**不可复制**：它们的 K 值/特征维度是其模型口径，与本规格 K=16/13 维无关联。

## 2. 执行路线图（5 阶段）

### 🟢 阶段 1：准备（角色：Dev Agent）✅ 完成（2026-08-30）

* **阶段目标**：确认 A3-04 已通过、定位特征数据获取方式，输出影响范围

* [x] 步骤1：确认 A3-04 已通过（A3 全线 🟢，提交 925535c；MFCC13 行实测正常）

* [x] 步骤2：确认 PC 端脚本运行环境可用（**实测：Python + numpy 2.5.1 + sklearn 1.9.0 全就绪**，原文"待定"闭环）

* [x] 步骤3：影响范围：新增 PC 脚本 2 个 + model\_normal.c/h（仅生成不集成）+ data CSV；固件零改动；风险=正常工况定义/空簇/样本量

* **判定标准**：A3 数据可获取、运行环境可用、影响范围明确 ✅

* **⏸️ 停等：人确认后进入阶段 2** ✅（人确认"按 600 帧、目标环境声、Python 方案执行阶段 2"）

### 🔵 阶段 2：设计（角色：Dev Agent）✅ 完成（2026-08-30）

* **阶段目标**：产出傻瓜式操作单（§3：采集 → 聚类 → 导出）

* [x] 步骤1：§3.1 采集定稿（600 帧/目标环境声/collect\_mfcc.py 自动过滤+校验）

* [x] 步骤2：§3.2 K-means 定稿（K=16 禁改、seed=42、n\_init=10、空簇/地板簇检查）

* [x] 步骤3：§3.3 导出定稿（model\_normal.c/h C 常量表 + A4-02 接口 MODEL\_NORMAL\_K/D 宏——原文"待定"闭环）

* 设计定稿 §1.5 八节 + R29 四件套（决策 7 项/坑 7 条/预算/影响地图/GitHub 调研）

* **判定标准**：操作单每步有期望值与记录空位 ✅

* **⏸️ 停等：人确认后进入阶段 3**

### 🟠 阶段 3：实现（角色：Dev Agent）✅ 完成（2026-09-01）

* **阶段目标**：按 §3 执行采集 + 聚类 + 导出，逐行打勾

* [x] 步骤1：按 §3.1 采集并保存 N 帧 13 维 MFCC（记录文件路径与帧数）

* [x] 步骤2：按 §3.2 运行 K-means(K=16)，记录 16 个簇中心与各簇样本数

* [x] 步骤3：按 §3.3 导出模版文件（记录路径/格式）

* **判定标准**：16 簇全部非空、导出文件可读 ✅（600 帧全采、各簇非空、编译器可读——Makefile 登记 + build.bat 通过，size 证据见执行日志）

* **⏸️ 停等：人确认后进入阶段 4** ✅（人确认"开始"，抖音模拟工厂环境声）

### 🟣 阶段 4：测试（角色：Test Agent）✅ 完成（2026-09-01）

* **阶段目标**：独立验证——只看规格与 §4 验收标准，不复用 Dev 脚本内部细节

* [x] 步骤1：用独立最小样本集重跑脚本，结果可复现（最小样本数：**16 帧 = K（理论下限，按惯例处理，人有异议再改）**，16 簇各 1 样本全非空，exit=0）

* [x] 步骤2：逐条核对 §4 验收标准（AC-01\~AC-10 全过，见 §4 勾选记录）

* [ ] 若失败 → 查 §3.4 故障速查表，退回阶段 3（未触发）

* **判定标准**：AC-01\~AC-04 均有实际记录值 ✅

* **⏸️ 停等：人确认后进入阶段 5** ✅（按 §0 A4-01 中级任务策略，阶段 3+4 连续执行）

### 🔴 阶段 5：审查（角色：Review Agent）✅ 完成（2026-09-01，R23 独立评审）

* **阶段目标**：独立审查——AC 逐条打勾、模版文件与 A4-02 接口约定一致

* [x] 步骤1：核对 §4 全部 AC 勾选与记录值（评审结论：AC-01\~AC-12 全过；AC-03 串口来源部分靠日志采信——CSV 产物本身经评审人程序化核验 600×13）

* [x] 步骤2：核对模版输出（16×13）与 A4-02 加载接口一致（评审确认：MODEL\_NORMAL\_K/D 宏 + extern 声明与父 FEAT 需求形状一致；A4-02 文档侧"模版加载方式待定"回填留给 A4-02 阶段 1——不阻塞本 FEAT）

* **判定标准**：AC 全部通过且记录值完整 ✅

* **评审发现问题与处置**（requesting-code-review skill 独立评审员，工作区 diff 复审 + 5 项独立复验）：

  * **重要-1（已修复）**：`--check` 复跑比对含生成日期 → 跨日期复验必误报 FAIL（评审人实验证实）。修复：比较前 `re.sub` 归一化 date 字段；修复后以 2026-08-31 假日期实测 `[OK]` 通过。顺手删除 :57 恒空死代码。

  * **重要-2（已修复）**：文档"模版 832B 进 Flash"记录失实——map 实证 `.rodata.model_normal` 因无引用者被 `--gc-sections` 丢弃，未计入 text。已更正 §3.3.4 与执行日志（A4-02 引用后自然保留 +832B）。

  * 轻微 6 条：3 条死代码/死分支（1 条顺手修，其余挂账 A4-02 前处理）、A4-02 文档"待定"回填（留给 A4-02 阶段 1）、BOM/非数值 token 栈回溯（已挂账）。

  * **观察（非缺陷）**：600 帧"正常"样本来自手机播放抖音模拟工厂声——模版刻画的是"手机扬声器播放的工厂声"分布，与真实部署环境存在偏移风险，A4-02 阈值调优时留意，正式部署前建议现场重采（collect\_mfcc.py 可直接复用）。

* **⏸️ 停等：人确认 Review 通过后归档** ✅（评审结论"修复后可"，两项重要问题已修复并附验证证据）

## 3. 傻瓜式操作单（照做即可）

### 3.0 物品/工具清单（动手前先打勾，缺一不可）

* [x] PC（**Python + numpy 2.5.1 + sklearn 1.9.0 实测就绪**）

* [x] 核心板（A3-04 已通过：串口可打印 13 维 MFCC）

* [x] USB-TTL（CH340）+ serial\_capture.py 同款 COM 口参数（115200）

* [x] 5V 电源（非快充；供电红线沿用 A1-01 §3.2：**严禁手机快充头**）

* [x] 特征数据文件保存位置：**`data/mfcc_normal_600.csv`**（data/ 目录随本 FEAT 创建）

### 3.1 采集正常特征数据（A3-04 串口输出 → CSV，目标环境声）

1. 上电，确认串口出现 boot 三行 + `MFCC13 c=...` 行（1s 一行）。
2. **保持目标环境声**（设备部署环境的背景声，人确认的"正常"工况；全程避免吹气/敲击/突然说话等异常声）。**实际执行：人打开抖音模拟日常工厂环境声（人确认）。**
3. 运行 `python scripts/collect_mfcc.py data/mfcc_normal_600.csv --n 600`（自动前缀过滤 MFCC13 行、×100→float 还原、维数校验、600 帧自动停；预计 **\~10 分钟**）。
4. 记录：**实际帧数：600**（期望 ≥600；若丢弃行 >1% → 查串口质量）；**丢弃行数：0/600（0.00%）**。实际耗时 604s，节拍精确 1 帧/s。
5. 抽查：CSV 每行 13 个数（**期望 13 维**，记录实际维数：13，解析器逐行校验 0 丢弃）；c0 量级 |c0|<200（×100 已还原）。**实测 c0 范围 -30.98 \~ -4.50，无 c0<-90 静音地板帧。**

### 3.2 运行 K-means（K=16）

1. 运行 `python scripts/kmeans_model.py data/mfcc_normal_600.csv firmware/soundDog/BSP/model_normal.c`（**K=16 禁改**、seed=42 硬编码、n\_init=10）。
2. 记录输出：**簇中心数：16**（固定）；每个中心维度：**13**（固定）。
3. 检查各簇样本数（脚本打印各簇计数 + 空簇告警）：**各簇样本数：\[50, 47, 78, 53, 17, 19, 13, 49, 14, 79, 44, 24, 7, 14, 26, 66]（总和 600，最小簇 7）**（任一簇=0 → 空簇 → 回 §3.1 补采 300 帧）。
4. 种子值：**42**（硬编码，重跑必然一致）。
5. 检查无静音地板簇（各簇 c0 均值分布——若某簇 c0≈-110 且其余维≈0 → 地板簇混入，回 §3.1 重采）。**脚本自检 \[OK] 无空簇、无地板簇；整体均值 c0..c2 = -10.54 / -3.06 / +0.13。**

### 3.3 导出正常模版

1. 脚本自动导出 `firmware/soundDog/BSP/model_normal.c` + `model_normal.h`（16×13 float32 常量表，ASCII 无 BOM，含生成注释头：样本数/K/seed/日期）。
2. 人工抽查 1 个中心向量：**记录该中心前 3 维数值：-8.0332 / -2.2944 / +0.5210（簇 0）**（量级应与原始特征均值一致，|c0|<200）。
3. 与 A4-02 约定模版加载接口：**`model_normal.h`** **导出** **`MODEL_NORMAL_K(16)/MODEL_NORMAL_D(13)/model_normal[16][13]`**（编译期常量；A7-03 Flash / A4-04 RS485 路径就绪后替换数据来源，接口语义不变——阶段 2 定稿）。
4. **编译验证（坑 7 判据"编译器可读"）**：Makefile C\_SOURCES 登记 `BSP/model_normal.c`（BUG-002 教训），`firmware/build.bat` 通过——size **text=166860 data=108 bss=96960**。**修正（阶段 5 评审 map 证伪后）**：因暂无代码引用该符号，`-Wl,--gc-sections` 下 `.rodata.model_normal` 832B 被 gc 丢弃、未计入当前 text（map Discarded input sections 区实证）；A4-02 引用后自然保留并 +832B（RAM 恒零占用）。

### 3.4 故障速查表

| 现象 | 可能原因 | 处理 |
| --- | --- | --- |
| 串口无 MFCC13 打印 | A3-04 未通过 / COM 口错 / 波特率错 | 确认 A3-04 🟢；COM 以设备管理器为准；115200 |
| 行维数 ≠ 13 | 断行/粘行 | 解析器自动丢弃计数（<1% 正常）；>1% 查串口线 |
| 空簇（某簇 0 样本） | 样本多样性不足 / 特征全雷同 | 补采 300 帧重跑；仍空 → 检查环境声是否过于单调（人确认是否加大环境多样性） |
| 地板簇（c0≈-110 其余≈0） | 混入静音帧 | 重采（采集纪律：全程目标环境声） |
| 两次运行结果不一致 | 未固定种子（不会发生——seed=42 硬编码）  | 若发生 → 查 sklearn 版本是否被换 |
| 模版数值全 0 / 巨大 | ×100 定标未还原 / 链路异常 | 脚本已内置 /100.0；回 A1-02/A1-03 查链路 |

## 4. 验收标准（12 条）

### 功能验收

* [x] AC-01 K-means(K=16) 运行成功，输出 **16 个 13 维簇中心**（记录：16 中心 × 13 维，簇中心数与维度脚本自报）

* [x] AC-02 各簇样本数 > 0（无空簇），模版文件已导出（记录：各簇 \[50,47,78,53,17,19,13,49,14,79,44,24,7,14,26,66]，路径 firmware/soundDog/BSP/model\_normal.c + .h）

* [x] AC-03 输入为 A3-04 串口打印的 13 维 MFCC，行维度核验 = 13（记录：采集解析 600 行全 13 维、0 丢弃；独立复核 collect 脚本逐行校验逻辑）

* [x] AC-04 结果可复现：固定随机种子，重跑结果一致（记录：seed=42，`--check` 复跑**逐字节一致**；阶段 5 修复日期敏感缺陷后，跨日期复跑同样通过——评审人以假日期 2026-08-31 实验证实）

* [x] AC-05 向后兼容：无固件改动，无接口变化（记录：固件仅新增 model\_normal.c/h 常量表 + Makefile 1 行登记——零逻辑改动，无既有接口变化；新符号未被任何现有代码引用）

### 代码质量 / 安全红线 / 测试边界

* [x] AC-06 PC 脚本运行无报错、无警告输出（记录：采集/聚类/复跑/最小样本四轮运行均无警告）

* [x] AC-07 无硬编码密钥/凭据（脚本无敏感信息）（记录：两脚本通读，仅 COM 口号/路径/K/seed 等工程常量）

* [x] AC-08 输入校验：文件缺失/行维数≠13 时报错退出（制造一次错误输入验证，记录报错信息）（记录：① 缺文件 → `[ERR] 输入文件不存在: data/nonexistent.csv` exit=1；② 12 维行 → `[ERR] 第 1 行维数 12 ≠ 13` exit=1。附注：带 UTF-8 BOM 的输入触发 UnicodeDecodeError 栈回溯，仍 exit=1 属"报错退出"但消息不友好——流水线真实文件由 Python 纯 ASCII 写出不受影响，A4-02 前不处理（低风险））

* [x] AC-09 新增测试：最小样本集可跑通并输出 16 簇（记录：**16 帧**（理论下限=K，按惯例处理），16 簇各 1 样本全非空，exit=0，导出成功）

* [x] AC-10 全部回归：用全量数据复跑，结果与首次一致（记录：`--check` 全量复跑逐字节一致；日期归一化后跨日不误报）

* [x] AC-11 测试覆盖率：**N/A**（一次性 PC 工具脚本，无单元测试覆盖率要求——说明）

* [x] AC-12 按 FEAT 模板执行（本文档结构合规）（阶段 5 评审核对通过：元数据/硬边界/5 阶段路线图/操作单/12AC/维护/执行日志齐全）

## 5. 维护与调试（阶段5通过后回填，2026-09-01）

### 5.1 影响文件

| 文件 | 改动类型 | 说明 |
| --- | ---- | --- |
| `scripts/collect_mfcc.py` | 新增 | 串口采集（前缀过滤/×100 还原/维数校验/600 帧自停；复用可重采） |
| `scripts/kmeans_model.py` | 新增 | K-means(K=16, seed=42) 聚类 + model\_normal.c/h 导出 + `--check` 复跑 |
| `firmware/soundDog/BSP/model_normal.c/h` | 新生成  | 16×13 float32 常量表（**脚本产物，禁止手改**；重生成 = 重采 CSV 后跑 kmeans\_model.py） |
| `data/mfcc_normal_600.csv` | 新增 | 600×13 特征样本存档（复现证据；删除后模版无法复现，AC-04 失效） |
| `firmware/soundDog/Makefile` | +1 行 | C\_SOURCES 登记 BSP/model\_normal.c（BUG-002 教训） |

### 5.2 调试要点

* 空簇 → 补采样本；结果不可复现 → 查 seed=42 是否被改/sklearn 版本

* 数据异常 → 回 A1-02/A1-03 查采集链路（BUG-002 取数/麦克风）

* **A4-02 阈值误报率高 → 优先怀疑模版偏移**：本模版采集自"手机播放抖音模拟工厂声"，与真实部署环境分布有偏移（阶段 5 评审观察）；正式部署前用现场环境声重采（collect\_mfcc.py 直接复用，重跑 kmeans\_model.py 重生成）

* 模表数值疑似错误 → 跑 `python scripts/kmeans_model.py data/mfcc_normal_600.csv firmware/soundDog/BSP/model_normal.c --check`（模表逐字节比对，日期已归一化跨日可用）

### 5.3 测试入口

* 最小样本集复跑（对应 AC-09）；全量数据复跑 `--check`（对应 AC-04/AC-10）；错误输入（AC-08）

## 6. 执行日志

| 时间 | 阶段 | 角色 | 摘要 | 遇阻 |
| --- | --- | --- | --- | --- |
| 2026-08-30 | 阶段 1 准备 | Dev | A3-04 🟢（925535c）；环境实测就绪（numpy 2.5.1/sklearn 1.9.0，原文待定闭环）；关键发现：**MFCC13 打印 1s 节流 → 采集 1 帧/s**（600 帧≈10 分钟，禁改固件）；A3 硬约束澄清（固件串口直采=同网格同归一化天然成立）；风险=正常工况定义/空簇/样本量 | 无 |
| 2026-08-30 | 阶段 2 设计 | Dev | 人确认 600 帧/目标环境声/Python。定稿：串口解析（MFCC13 前缀过滤+×100 还原+维数校验）、K-means（K=16 禁改/seed=42/n\_init=10）、导出 **model\_normal.c/h C 常量表**（A7-03/A4-04 未落地 → 编译期常量最小方案，接口宏 MODEL\_NORMAL\_K/D，后续换数据来源不改语义）；坑 7 条（前缀污染/定标/地板簇/空簇/种子/断行/编码）；R29 四件套（GitHub：micro\_speech C 表集成模式可复制） | 无 |
| 2026-09-01 | 阶段 3 实现 | Dev | 人确认"开始"（抖音模拟工厂环境声）。采集 600/600 帧 0 丢弃（604s，1 帧/s 精确，c0 -30.98\~-4.50 无地板帧）→ K-means 16 簇全非空（最小簇 7，无地板簇）→ 导出 model\_normal.c/h（簇 0 前三维 -8.0332/-2.2944/+0.5210）。**偏差登记（超出阶段 2 "Makefile 零改动"边界）**：为满足坑 7 验证判据"编译器可读"，Makefile C\_SOURCES 登记 BSP/model\_normal.c（1 行机械改动，BUG-002 教训）——build.bat 通过，size text=166860/data=108/bss=96960。**阶段 5 修正**：832B 模表因无引用者被 --gc-sections 丢弃，未计入 text（详见 §3.3.4） | 遇阻×1：首轮采集命令 Python stdout 缓冲无进度输出，停掉重启 `python -u`（损失 \~2.5 分钟，无数据损失） |
| 2026-09-01 | 阶段 4 测试 | Test | 独立复现四项：① `--check` 全量复跑**逐字节一致**（AC-04/10）；② 最小样本 16 帧=K（理论下限，按惯例处理）→ 16 簇各 1 全非空 exit=0（AC-09）；③ 错误输入：缺文件 `[ERR] 输入文件不存在` exit=1、12 维行 `[ERR] 第 1 行维数 12 ≠ 13` exit=1（AC-08）；④ 编译回归 build.bat 通过（含模表登记）。AC-01\~AC-11 勾选+记录值回填 §4，AC-12 留阶段 5 | 附注：UTF-8 BOM 输入触发 UnicodeDecodeError 栈回溯（exit=1 仍属报错退出，消息不友好；流水线真实文件纯 ASCII 不受影响，低风险挂账） |
| 2026-09-01 | 阶段 5 审查 | Review | R23 独立评审（requesting-code-review skill，独立复验 5 项：--check/错误输入×2/CSV 体检/最小样本/map 核查）。结论"修复后可"→ 2 项重要已修复闭环：① `--check` 日期敏感（假日期实测复现→re.sub 归一化→复测 \[OK]，顺删死代码）；② "832B 进 Flash"失实（map 证 gc 丢弃→更正表述，A4-02 引用后 +832B）。AC-01\~12 全过；轻微 6 条挂账/移交 A4-02；观察项：抖音模拟环境与真实部署分布偏移 → §5.2 调试要点。回填父 FEAT/INDEX/维护地图/rules §0，独立提交 | rules.md §0 "A4-01 执行策略覆盖"块已被历史覆写丢失（git 从未提交，实查确认）——本次收官直接归档至本文档 §7，无需从 §0 移除 |

## 7. 附录：执行策略试验记录（归档，2026-09-01 收官）

> 背景：A4-01 期间（2026-08-30 起）人批准在 rules.md §0 临时追加"风险分级裁剪"执行策略覆盖。**注**：该 §0 覆盖块后被历史"文档覆写"事故丢失（git 实查从未提交），本节按当时批准内容归档存档。

**策略原文（当时批准稿，生效日期按人指示改为 2026-09-01——原文 2026-08-30，归档时一并记录）**：

* 按**风险分级**裁剪流程，不修改 §1-§6 硬规则：

  * **重级**（固件代码/硬件参数/算法口径）：全流程（5 阶段 + 每步停等 + R23 评审）

  * **中级**（PC 脚本/纯文档）：压缩为 2 步——设计简报（复用已有确认）→ 直接做 → 收尾一次性评审（豁免 R9/R14 中间停等，保留 R21 证据 + R23 评审）

  * **轻级**：走 §5 快速路径

* 低风险事项不再列为确认项，标注"已按 X 惯例处理，有异议再改"。

**试验结论（供后续 FEAT 参考）**：

* 本 FEAT 为首个完整走"中级"路径的子 FEAT（A4-01 阶段 3+4 连续执行、仅阶段 2/3 边界停等 2 次）：全程无返工，评审 12 AC 一次通过（2 项重要问题均属实现细节而非流程缺口）。

* 有效点：采集→聚类→导出属强顺序物理流程（10 分钟人工采集中间打断无意义），停等豁免收益明显；R21 证据 + R23 独立评审保留底线后，质量未见下降。

* 风险点：分级判定靠 Dev 自评——本次固件 Makefile +1 行（重级边界）靠"偏差登记"机制兜底暴露；后续沿用时，凡触及 firmware/ 目录的改动建议一律按重级或显式登记偏差。

* 沉淀建议：后续 FEAT 可默认沿用"中/轻级裁剪 + 偏差登记"模式，作为正式规则候选（待父 FEAT A4 收官时决定是否写入 rules §3）。
