wumu-dot/SoundDog/docs/features/FEAT-A8-01-通信层.md

# FEAT-A8-01-通信层

> **AI 执行规则**：必须按阶段顺序执行，每个阶段开头声明角色。严禁跳跃、越界、自审自判。
> 阶段间停等：每完成一个阶段，停下来，输出结果，等人说"继续"。
> 阶段5通过后：回填父FEAT项目表该行 + 更新 `docs/features/INDEX.md` + `docs/features/维护地图.md`。
> 历史记录只更新状态字段，严禁删除/篡改已完成记录。
> 事实来源：`.sop-agent规格.md` §3 + 父 FEAT-A8（禁止自造数值；未覆盖项写"待定（需人确认）"）。

## 0. 元数据

* **父FEAT**：FEAT-A8-上位机

* **优先级**：P0

* **预估总耗时**：4h

* **当前状态**：🔴未开始（傻瓜式操作单已备好，依赖 A5-02 帧协议 + A5-03 物理链路通过后开跑）

## 1. 总体目标与硬边界

### 1.1 核心目标（一句话）

> 用 **Python + pySerial** 实现 PC 端串口通信层：按 A5-02 帧协议（0xA5/0x5A/CRC16）与板端**双向收发无误码**，为 A8-02 频谱显示、A8-04 参数报警提供可靠数据管道。

### 1.2 地基触碰前置自检

* [x] 否 → 继续（PC 端应用，不碰 `firmware/Drivers/` 板端代码）

### 1.3 任务边界

| 类型 | 具体内容 |
| --- | --- |
| 范围内（可改） | 新建上位机 `comm/` 模块（串口枚举/打开/收发/帧解析）、配置文件、测试脚本 |
| 超出范围（禁止碰） | `firmware/Drivers/` HAL 底层库；板端固件（帧协议由 A5-02 定义，本 FEAT 只做 PC 端解析） |
| 外部依赖 | **Anaconda Python 3.13.5**（事实包 §3.7）、pySerial（需补装）、CH340 USB-TTL、TTL-RS485 模块×2、A5-03 物理链路已通 |

### 1.4 关键参数与接口（事实包 §3 + 父 FEAT-A8，禁止自造）

* **串口**：CH340 的 COM 口（设备管理器为准），波特率 **115200**（`RS485_UART_BAUD`）。

* **帧协议**：帧头 **0xA5** / 帧尾 **0x5A** / **CRC16**（事实包 A5-02；CRC 多项式/帧字段格式**待定（需人确认，以 A5-02 阶段2 定稿为准）**）。

* **半双工**：同一时刻只允许一端发送（事实包 A5-01）。

* **运行环境（事实包 §3.7 实测 2026-08-16）**：**Anaconda** **`C:\Users\wumu2\anaconda3\python.exe`（3.13.5）**，numpy/scipy/matplotlib/scikit-learn 已装；**需补装** **`pyserial`**（`python.exe -m pip install pyserial`，阿里云镜像）；⚠️ **勿用 conda 命令**（本机 conda 有 bug）。

* **工具**：pySerial；测试对照 SSCOM。

* **待定（需人确认）**：CRC16 参数、帧字段、超时值、日志格式。

## 2. 执行路线图（5 阶段）

### 🟢 阶段 1：准备（角色：Dev Agent）

* **读什么**：`A5-02` 文档（帧协议）、`A5-03` 文档（物理链路）、父 `FEAT-A8`、`.sop-agent规格.md` §3

* [ ] 步骤1：确认 A5-02/A5-03 已通过（帧协议定稿 + 双向链路可用）

* [ ] 步骤2：确认 Python + pySerial 已安装；枚举 CH340 COM 口

* [ ] 步骤3：输出影响范围（comm/ 模块结构 / 依赖 / 风险：半双工、超时）

* **判定标准**：A5 状态已核实、环境已就绪、影响范围已输出

* **⏸️ 停等：人确认后进入阶段 2**

### 🔵 阶段 2：设计（角色：Dev Agent）

* **阶段目标**：设计 comm/ 模块接口与帧解析，产出傻瓜式操作单（§3）

* [ ] 步骤1：设计模块接口（枚举串口 / open / send\_frame / recv\_frame / 超时策略）

* [ ] 步骤2：按 A5-02 帧协议实现帧打包/解析（CRC16 参数以 A5-02 定稿为准）

* [ ] 步骤3：产出 §3 操作单（环境搭建 + 回环测试 + 对板测试 + 故障表）

* **判定标准**：接口签名已产出、帧协议字段已对照 A5-02 核对、待定项已列全

* **⏸️ 停等：人确认后进入阶段 3**

### 🟠 阶段 3：实现（角色：Dev Agent）

* **阶段目标**：写 comm/ 模块，编译/运行自测

* [ ] 步骤1：实现串口枚举/打开/关闭（异常处理：端口被占用/拔出）

* [ ] 步骤2：实现帧打包/解析 + CRC16 + 超时重试

* [ ] 步骤3：`python -m py_compile` 语法检查 + 本地回环自测（AC-03）

* **判定标准**：语法通过、本地回环自测通过（无异常）

* **⏸️ 停等：人确认后进入阶段 4**

\===== 切换至 Test Agent =====

### 🟣 阶段 4：测试（角色：Test Agent）

* **阶段目标**：独立验证——按 §3 操作单实测，核对 §4 验收标准

* [ ] 步骤1：按 §3.2 板端回环测试（PC 发→板转发→PC 收，100 帧）（AC-01）

* [ ] 步骤2：按 §3.3 坏帧/超时测试（篡改帧、拔线）（AC-02）

* [ ] 若失败 → 查 §3.4 故障表，退回阶段 3

* **判定标准**：AC-01/02 有实际记录数值

* **⏸️ 停等：人确认后进入阶段 5**

\===== 切换至 Review Agent =====

### 🔴 阶段 5：审查（角色：Review Agent）

* **阶段目标**：独立审查——AC 逐条打勾、帧协议与 A5-02 一致

* [ ] 步骤1：核对 §4 全部 AC 勾选与记录值（100 帧、误码数、超时行为）

* [ ] 步骤2：核对帧打包/解析与 A5-02 协议定义逐字节一致

* **判定标准**：AC 全部通过且记录值完整

* 全部通过 → ✅ 回填「维护与调试」+ 父FEAT项目表 + INDEX + 维护地图

* 未通过 → 退回对应阶段并附意见

* **⏸️ 停等：人确认 Review 通过后归档**

## 3. 傻瓜式操作单（照做即可）

### 3.0 物品/工具清单（动手前先打勾，缺一不可）

* [ ] PC（Windows）+ **Anaconda Python 3.13.5**（`C:\Users\wumu2\anaconda3\python.exe`，事实包 §3.7）

* [ ] pySerial 已安装（`& C:\Users\wumu2\anaconda3\python.exe -m pip install pyserial`；`-m pip show pyserial` 确认）

* [ ] CH340 USB-TTL + TTL-RS485 模块×2（A5-03 已对接）

* [ ] SSCOM（对照观察）

* [ ] 核心板（A5-03 已通过，通电正常）

### 3.1 环境确认（阶段 1 执行）

1. `& C:\Users\wumu2\anaconda3\python.exe --version` → 记录版本：\_\_\_（期望 3.13.5）
2. `& C:\Users\wumu2\anaconda3\python.exe -m pip show pyserial` → 记录版本：\_\_\_（无 → 先 `-m pip install pyserial`）
3. 设备管理器确认 CH340 COM 口：**COM\_\_\_**（记录）

### 3.2 板端回环测试（阶段 4 执行）

1. 板端固件配置为"收到帧即原样回发"（A5-02 已实现的回显功能）。
2. 运行 comm/ 测试脚本：发送 100 帧（内容递增字节），期望每帧收到**原样回发**。

   * 记录：发送 100 帧，接收成功 \_\_\_ 帧，误码 \_\_\_ 帧
3. 期望 **100 帧全部一致、误码 0**（AC-01）。
4. ⚠️ 半双工：发送后等待接收完成再发下一帧（超时 100ms，待定需人确认）。

### 3.3 坏帧/超时测试（阶段 4 执行）

1. 构造坏帧（CRC 错误 / 帧头错误 / 截断帧）发送 → 期望解析层**正确丢弃并计数**。

   * 记录：坏帧数 \_\_\_，正确丢弃 \_\_\_，误收 \_\_\_（期望误收 0）
2. 拔掉 USB-TTL → 期望**超时报错**（不卡死、有明确错误信息）。记录：行为：\_\_\_
3. 插回 → 期望**自动恢复**可继续收发（或需重连，按实现记录）。

### 3.4 故障速查表

| 现象 | 可能原因 | 处理 |
| --- | --- | --- |
| 打开串口失败 | COM 被占用 / 端口号错 | 关闭 SSCOM 等其他占用程序；设备管理器核对 COM |
| 收不到回环 | 物理链路（A5-03）没通 / 半双工时序错 | 先跑 A5-03 验证；发完等接收完成再发下一帧 |
| 乱码 | 波特率不是 115200 | 两端改 115200 |
| 坏帧未丢弃 | CRC16 参数与板端不一致 | 对照 A5-02 定稿核对多项式/初值/位序 |
| 拔线后卡死 | 无超时处理 | 确认 recv 有超时（100ms 待定需人确认） |
| CRC 计算不符 | 实现与板端算法不同 | 与板端交换已知向量测试（A5-02 提供） |

## 4. 验收标准（12 条）

### 功能验收

* [ ] AC-01 板端回环：100 帧全部原样收到、误码 0（§3.2 记录）

* [ ] AC-02 坏帧正确丢弃（误收 0）、拔线超时不卡死、插回可恢复（§3.3 记录）

* [ ] AC-03 向后兼容：PC 端独立模块，不影响板端固件

### 代码质量

* [ ] AC-04 语法检查通过（`python -m py_compile` 无错误）

* [ ] AC-05 无未处理异常（串口错误均有 try/except 与日志）

* [ ] AC-06 文档已更新（本 FEAT + 父 FEAT-A8 回填）

### 安全红线

* [ ] AC-07 N/A：无密钥（本地串口工具）

* [ ] AC-08 N/A：无用户输入注入面（帧内容按协议解析，长度受限）

### 测试与边界

* [ ] AC-09 坏帧/超时用例已执行（§3.3）

* [ ] AC-10 N/A：无自动化测试基建（脚本化测试待定需人确认）

* [ ] AC-11 N/A：手动验证，覆盖率不适用

* [ ] AC-12 按 FEAT 模板执行（本文件即模板产物）

## 5. 维护与调试（阶段5通过后回填）

### 5.1 影响文件

| 文件 | 改动类型 | 说明 |
| --- | ---- | --- |
| `host_app/comm/serial_port.py` | 新增 | 串口枚举/打开/收发 |
| `host_app/comm/frame.py` | 新增 | 帧打包/解析/CRC16  |
| `host_app/comm/test_loopback.py` | 新增 | 回环测试脚本 |
| `host_app/requirements.txt` | 新增 | pyserial 依赖清单 |

### 5.2 调试要点

* 调试打印：帧头/长度/CRC 逐字节打印；对照 SSCOM 观察

* 半双工时序：发送→等待→接收，用时间戳记录每帧耗时

### 5.3 测试入口

* §3.2 回环测试脚本（对应 AC-01）

## 6. 执行日志

| 时间 | 阶段 | 角色 | 摘要 | 遇阻 |
| --- | --- | --- | --- | --- |
| <br /> | <br /> | <br /> | <br /> | <br /> |
