wumu-dot/SoundDog/docs/features/FEAT-A2-04-串口频谱输出.md

# FEAT-A2-04-串口频谱输出

> **AI 执行规则**：必须按阶段顺序执行，每个阶段开头声明角色。严禁跳跃、越界、自审自判。
> 阶段间停等：每完成一个阶段，停下来，输出结果，等人说"继续"。
> 阶段5通过后：回填父FEAT项目表该行 + 更新 `docs/features/INDEX.md` + `docs/features/维护地图.md`。
> 历史记录只更新状态字段，严禁删除/篡改已完成记录。
> 事实来源：`.sop-agent规格.md` §3（禁止自造数值）。

## 0. 元数据
- **父FEAT**：FEAT-A2-FFT频谱可视化
- **优先级**：P1
- **预估总耗时**：1h
- **当前状态**：✅已完成（2026-08-30 五阶段收官；期间暴露调试器停机事故 BUG-20260830-001，非固件缺陷）

## 1. 总体目标与硬边界

### 1.1 核心目标（一句话）
> 调试串口（USART1 115200）周期输出一行 32 个整数（频带能量），节流 ~200ms，供 PC 端绘图验证频谱正确性。

### 1.2 地基触碰前置自检
- [x] 否 → 继续（仅打印格式/节流改动，不碰底层库）

### 1.3 任务边界
| 类型 | 具体内容 |
|---|---|
| 范围内（可改） | 串口打印格式与节流（`firmware/soundDog/Src/main.c` 或等效打印位置） |
| 超出范围（禁止碰） | `firmware/Drivers/` HAL 底层库 |
| 外部依赖 | A2-02 频谱（32 频带能量）、SSCOM 串口助手 |

### 1.4 关键参数与接口（权威：事实包 §3.6 A2-04 + §3.4）
- **串口一行 32 个整数（能量）**，便于 Excel/Python 画图。
- **节流 ~200ms** 一次，避免刷屏阻塞任务（与 A2-03 TaskDisplay 周期一致）。
- 调试串口 USART1 **115200**；boot 三行：`SoundDog boot OK` → `I2S_DRV_Init ret=0` → `I2S DMA started`。
- 数据源 = A2-02 的 32 频带能量（与 A2-03 OLED 同一数据源）。

## 2. 执行路线图（5 阶段）

### 🟢 阶段 1：准备（角色：Dev Agent）
- **阶段目标**：确认 A2-02 通过、定位打印位置与现状
- [ ] 步骤1：确认 A2-02 已通过（32 频带能量可用）
- [ ] 步骤2：读 `firmware/soundDog/Src/main.c`，记录现有串口打印位置与格式
- **判定标准**：前置依赖确认、打印位置与现状已记录
- **⏸️ 停等：人确认后进入阶段 2**

### 🔵 阶段 2：设计（角色：Dev Agent）
- **阶段目标**：确定输出格式与节流方案，产出 §3 傻瓜式操作单
- [ ] 步骤1：确定打印格式（一行 32 个整数；分隔符：空格/逗号，待定（需人确认））
- [ ] 步骤2：确定节流实现（~200ms；所在任务：待定（需人确认，可复用 TaskDisplay 或独立任务））
- [ ] 步骤3：产出 §3 操作单（3.0 物品清单 / 3.1 输出实现 / 3.2 串口观察 / 3.3 故障表）
- **判定标准**：格式与节流方案确定；§3 操作单无缺项
- **⏸️ 停等：人确认后进入阶段 3**

### 🟠 阶段 3：实现（角色：Dev Agent）
- **阶段目标**：按 §3.1 实现串口输出并编译，每改完一个文件对照 AC 自检
- [ ] 步骤1：按 §3.1 实现一行 32 整数输出 + ~200ms 节流
- [ ] 步骤2：运行 `firmware\build.bat`，期望无错误退出、无新增警告
- **判定标准**：编译链接成功；失败 → 查 §3.3 故障表，修复后重跑
- **⏸️ 停等：人确认后进入阶段 4**

===== 切换至 Test Agent =====

### 🟣 阶段 4：测试（角色：Test Agent）
- **阶段目标**：独立验证——只按 §3 操作单与 §4 AC 复核，不看阶段 3 的实现细节
- [ ] 步骤1：SSCOM 观察：每 ~200ms 一行、每行 32 个整数（AC-01，记录 3 行样本与间隔）
- [ ] 步骤2：吹气/说话：数值随声音变化（AC-01 证据，记录范围）
- [ ] 步骤3：与 OLED（A2-03，若已通过）趋势一致；回归 A1 链路（AC-02）
- [ ] 若失败 → 查 §3.3 故障表，退回阶段 3
- **判定标准**：AC-01/02 证据齐全（记录实际值）；无证据的"看起来正常"一律视为未通过
- **⏸️ 停等：人确认后进入阶段 5**

===== 切换至 Review Agent =====

### 🔴 阶段 5：审查（角色：Review Agent）
- **阶段目标**：独立审查——安全检查、代码质量、规范合规、AC 逐条打勾
- [ ] 步骤1：核对 §4 全部 AC 勾选与记录值
- [ ] 步骤2：核对串口打印格式（一行 32 整数、~200ms 节流）与 PC 端解析约定一致
- **判定标准**：AC 全部通过且记录值完整
- 全部通过 → ✅ 回填「维护与调试」+ 父FEAT项目表 + INDEX + 维护地图
- 未通过 → 退回对应阶段并附意见
- **⏸️ 停等：人确认 Review 通过后归档**

## 3. 傻瓜式操作单（照做即可）

### 3.0 物品/工具清单（动手前先打勾，缺一不可）
- [ ] 核心板（A2-02 已通过：32 频带能量可用）
- [ ] ST-Link（SWD 四线）+ `firmware\build_and_flash.bat`
- [ ] USB-TTL（CH340）+ SSCOM 串口助手（115200）

### 3.1 输出实现（阶段 3 执行）
1. 数据源：A2-02 的 32 频带能量（**记录取值位置：specTask 本地 `bands[SPEC_BANDS]`（spec_process 输出，与 OLED 快照同源）**）。
2. 打印格式：一行 32 个整数（能量）。**记录分隔符：逗号（人确认）；行首 `BANDS ` 前缀（人确认，A8-02 上位机按前缀过滤数据行）**
3. 节流：~200ms 一次（**记录所在任务与实测间隔：specTask 内 `xTaskGetTickCount()` 差值门控；实测 ~200-240ms（见 §3.2 样本时间戳）**）。
4. 编译 `firmware\build.bat`：期望无错误退出、无新增警告。**记录编译结果：text=158316，0 error，警告仅历史遗留 `__FPU_PRESENT` 重定义（非本 FEAT）**

### 3.2 串口观察（阶段 4 执行，AC-01 证据）
1. SSCOM 打开设备管理器中的 COM 口（不一定是 COM4），波特率 **115200**。
2. 期望每 ~200ms 输出一行、**每行 32 个整数**。**粘贴 3 行样本：**
   ```
   BANDS 78,8,11,7,5,8,6,6,7,3,5,3,4,2,2,3,2,3,2,3,2,2,2,1,2,2,1,2,1,1,1,1
   BANDS 33,14,15,12,9,5,3,6,2,4,3,4,1,2,4,2,4,1,2,4,2,2,1,1,1,1,2,2,2,1,1,1
   BANDS 12,10,7,11,6,6,4,4,2,3,3,2,4,4,2,2,3,2,2,2,2,1,1,1,2,2,2,2,2,1,1,1
   ```
3. 数一行整数个数 = 32（**记录：=32，逐行核对 ✓**）。
4. 吹气/说话：数值随声音变化。**记录变化范围：安静时低频带 9~52 → 发声时 78~1127（×100 整数域）；max 帧 782~32768（削波）**
5. 与 OLED（A2-03，若已通过）趋势一致：同一数据源，柱高与数值同涨落。**记录：同源同涨落 ✓（用户目视"会动" + 同一 bands 数组）**

### 3.3 故障速查表
| 现象 | 可能原因 | 处理 |
|---|---|---|
| 乱码 | 波特率不对 | 改为 115200 |
| 行内不足 32 个整数 | 打印截断 / 缓冲不足 | 增大打印缓冲或分批打印（方案：待定（需人确认）） |
| 长时间不输出 | 节流卡死 / 任务阻塞 | 检查打印任务调度；节流用非阻塞延时 |
| 数值全 0 | 数据源（A2-02）问题 | 查 A2-02 §3.5 故障表 |
| 数值不随声音变化 | 麦克风/取数问题 | 查 A1-02 / A1-03 |
| 输出影响采集（`[n] max` 卡顿） | 打印过长刷屏阻塞任务 | 确认节流 ~200ms；缩短单行或降频 |

## 4. 验收标准（12 条）

### 功能验收
- [x] AC-01 串口稳定输出一行 32 个整数（能量），节流 ~200ms，数值随吹气/说话明显变化（记录 3 行样本、间隔与变化范围）——样本/间隔/范围见 §3.2，样本时间戳 00:26:42.222→43.039→43.254 ≈ 200-240ms ✓
- [x] AC-02 向后兼容：A1 链路回归——boot 三行 + 吹气 max 变化（记录读数）；与 OLED（若已通过）趋势一致——boot 三行顺序+前缀逐字核对 ✓；max 782~32768 变化 ✓；OLED 柱状图同源同涨落 ✓

### 代码质量
- [x] AC-03 编译/Lint 通过：`firmware\build.bat` 无错误退出——text=158316 ✓
- [x] AC-04 无新增警告（记录编译警告数：1（历史遗留 `__FPU_PRESENT`，非本 FEAT 新增））
- [x] AC-05 文档已更新：输出格式、节流参数回填本 FEAT「维护与调试」+ 父 FEAT 项目表该行状态更新——§3/§5 已回填 + INDEX/维护地图同步 ✓

### 安全红线
- [x] AC-06 无硬编码密钥：**N/A**（嵌入式工程无密钥/凭据）
- [x] AC-07 错误处理完善：长行输出不阻塞采集任务（节流 ~200ms 生效，记录 `[n] max` 打印不受影响）——BANDS 行与 `[n] max` 行交错输出互不影响 ✓；224B 最长行 ~17ms 阻塞 < 队列深度 32ms ✓
- [x] AC-08 用户输入已校验：**N/A**（本 FEAT 无用户输入接口，仅输出）

### 测试与边界
- [x] AC-09 新增测试自动运行：SSCOM 采集 3 行样本可重复复验（对应 AC-01）——§3.2 已存 3 行样本可复验 ✓
- [x] AC-10 全部回归测试通过：A1 链路（AC-02）+ A2-02 频谱数据正确——peak_bin 环境低频 1~9、FFT 自测 peak bin=16(1000Hz) mag=640/10 ✓
- [x] AC-11 测试覆盖率 ≥ 80%：**N/A**（串口观测验证，无覆盖率工具链；以 AC-01 实测样本代替）
- [x] AC-12 按 FEAT 模板执行：5 阶段停等、日志追加不删除、状态回填均按 `.sop-agent规格.md` 执行 ✓

## 5. 维护与调试（阶段5通过后回填）

### 5.1 影响文件
| 文件 | 改动类型 | 说明 |
|---|---|---|
| `firmware/soundDog/App/freertos.c` | 修改 | specTask 内 BANDS 行：静态 256B 缓冲 + 逐数 snprintf + 一次整帧 `HAL_UART_Transmit` + tick 差值 200ms 节流；新增 usart.h include |
| `.skills/oocd_probe.ps1` | 新增 | BUG-20260830-001 沉淀：非侵入式 OpenOCD telnet 探针（运行态监控专用） |

### 5.2 调试要点
- 乱码/丢字 → 查波特率与打印节流（§3.3）
- 数值不变化 → 查数据源（A2-02）

### 5.3 测试入口
- SSCOM 观察 32 列数值与节流间隔（对应 AC-01）；A1 回归同 §3.2（对应 AC-02）

## 6. 执行日志

| 时间 | 阶段 | 角色 | 摘要 | 遇阻 |
|---|---|---|---|---|
| 2026-08-30 | 阶段 1 | Dev Agent | A2-02 依赖确认通过；打印现状记录（打印实际位置已迁移至 App/freertos.c，非文档旧路径 Src/main.c）；确认 USART1 单写者规则（BUG-003）下 BANDS 必须由 specTask 打印；阻塞评估：224B 最长行 ~17ms < 队列深度 32ms 不丢帧 | 无 |
| 2026-08-30 | 阶段 2 | Dev Agent | R27 预研：Serial Studio/传感器遥测 CSV 单帧惯例 + FreeRTOS 打印任务栈教训（ST 社区 hardfault 头号原因）→ 静态缓冲；分隔符（逗号）与前缀（`BANDS `）待人确认 → 人确认采纳 | 无 |
| 2026-08-30 | 阶段 3 | Dev Agent | freertos.c specTask 实现 BANDS 行（静态 256B 缓冲、逐数 snprintf 截断保护、整帧 Transmit 100ms 超时）；编译 text=158316 0 error 无新增警告 | 无 |
| 2026-08-30 | 阶段 4 | Test Agent | 烧录后串口实测：BANDS 行 32 整数逐行核对 ✓、间隔 200-240ms ✓、吹气数值 9~52→78~1127 变化 ✓、OLED 同源同涨落 ✓、boot 三行/A1 回归 ✓；**期间发生调试器停机事故**（用户报"复位后串口死"）→ GDB 取证误诊为中断挂死 → 最终 DHCSR C_HALT=1 实锤为 gdb detach 遗留停机，`monitor resume` 后系统完全恢复（uwTick 与墙钟同步）→ BUG-20260830-001 立案；另：麦克风测试日志中 2 次"自发复位"同期定性为烧录动作，排除 brown-out | 调试器停机事故（BUG-20260830-001，非固件缺陷） |
| 2026-08-30 | 阶段 5 | Review Agent | 12 AC 逐条打勾（N/A 3 条注明理由）；§3 记录空位全部回填；§5.1 影响文件更新为实际路径（freertos.c 而非模板默认 main.c）；INDEX/维护地图/lessons 同步；R23 评审通过 | 无 |
