wumu-dot/SoundDog/docs/features/FEAT-A1-04-SCK时钟核实.md

# FEAT-A1-04-SCK时钟核实

> **AI 执行规则**：必须按阶段顺序执行，每个阶段开头声明角色。严禁跳跃、越界、自审自判。
> 阶段间停等：每完成一个阶段，停下来，输出结果，等人说"继续"。
> 阶段5通过后：回填父FEAT项目表该行 + 更新 `docs/features/INDEX.md` + `docs/features/维护地图.md`。
> 历史记录只更新状态字段，严禁删除/篡改已完成记录。
> 事实来源：`.sop-agent规格.md` §3（禁止自造数值）。

## 0. 元数据
- **父FEAT**：FEAT-A1-音频采集链路
- **优先级**：P1
- **预估总耗时**：1h
- **当前状态**：🟢已完成（2026-08-28 阶段5审查通过：SCK 实测 1MHz/WS 实测 16kHz 精确，Fs=16000Hz 无误，"2 倍疑点"证伪关闭，无代码改动）

## 1. 总体目标与硬边界

### 1.1 核心目标（一句话）
> 用逻辑分析仪实测 I2S3 SCK 频率，确认采样率 16kHz 无误（README 遗留：SCK 疑似 2 倍）。

### 1.2 地基触碰前置自检
- [x] 否 → 继续（时钟配置在 CubeMX/ioc 层，非底层库）

### 1.3 任务边界
| 类型 | 具体内容 |
|---|---|
| 范围内（可改） | `soundDog.ioc` 时钟配置（I2SDIV / PLLI2S），经 CubeMX 重新生成 |
| 超出范围（禁止碰） | `firmware/Drivers/` HAL 底层库 |
| 外部依赖 | 逻辑分析仪（zave 24M/8ch）、已跑通链路（A1-02） |

### 1.4 关键参数（事实包 §3）
- 理论值：SCK = 51.2MHz / (2×25) = **1.024MHz**；Fs = 1.024M/64 = **16kHz**。
- 实测期望：SCK = 1.024MHz ±5%。
- 若实测 ~2.048MHz → 帧节奏翻倍 → 改 `soundDog.ioc`（I2SDIV/PLLI2S）→ CubeMX 重新生成（手动代码在 USER CODE 区间，见 BUG-001）→ 重烧复测。

## 2. 执行路线图（5 阶段）

### 🟢 阶段 1：准备（角色：Dev Agent）
- **阶段目标**：确认工具与接线图
- [x] 步骤1：确认逻辑分析仪（zave 24M/8ch，Saleae 8 兼容克隆）+ **Saleae Logic 1.2.17** 软件可用（2026-08-28 安装并 Connected；软件来源：`桌面\stm32F407ZGT6\逻辑分析仪\saleae...\Logic Setup 1.2.17.exe`，驱动/说明书同目录）
- [x] 步骤2：确认 A1-02 已通过（链路在跑）
- **⏸️ 停等：人确认后进入阶段 2**

### 🔵 阶段 2：设计（角色：Dev Agent）
- **阶段目标**：确定抓取步骤与判定标准（§3 操作单）
- [ ] 步骤1：确定探头接线（CH0→PB3 SCK、CH1→PA4 WS、CH2→PB5 SD）
- [ ] 步骤2：确定采样率 24M 与判定阈值（1.024MHz±5%）
- **⏸️ 停等：人确认后进入阶段 3**

### 🟠 阶段 3：实现（角色：Dev Agent）
- **阶段目标**：接线并抓取波形
- [ ] 步骤1：断电接探头（CH0/CH1/CH2 + GND 共地）
- [ ] 步骤2：上电，Saleae Logic 采样率 16M（Logic 1 8 通道上限），采集数秒
- **⏸️ 停等：人确认后进入阶段 4**

### 🟣 阶段 4：测试（角色：Test Agent）
- **阶段目标**：独立验证——读频率、判 AC
- [ ] 步骤1：读 SCK 频率（AC-01：1.024MHz±5%）
- [ ] 步骤2：读 WS 周期（= 64 SCK → Fs=16kHz）
- [ ] 步骤3：若 ~2.048MHz → 改 `soundDog.ioc` 重生成重烧，复测
- [ ] 若失败 → 退回阶段 3
- **⏸️ 停等：人确认后进入阶段 5**

### 🔴 阶段 5：审查（角色：Review Agent）
- **阶段目标**：独立审查——AC 逐条打勾
- 全部通过 → ✅ 回填「维护与调试」+ 父FEAT项目表 + INDEX + 维护地图
- 未通过 → 退回对应阶段并附意见

## 3. 傻瓜式操作单（照做即可）

### 3.0 物品/工具清单
- [ ] 逻辑分析仪 zave 24M/8ch（Saleae 8 兼容克隆）
- [ ] **Saleae Logic 1.2.17** 软件（已装，路径 `C:\Program Files\Saleae Inc\`；资料/说明书在 `桌面\stm32F407ZGT6\逻辑分析仪\saleae逻辑分析仪软件客户资料20190718\`）
- [ ] 杜邦线 ×4（CH0/CH1/CH2/GND）
- [ ] 核心板（A1-02 已通过）

### 3.1 接线（断电操作）
> 注：通道号是标签，用哪几个通道都行（本机 Logic 1 界面显示 Channel 4~7）。接完可按波形形状自检：最快方波=SCK、慢方波=WS、数据突发=SD。

| 逻辑分析仪 | 接到核心板 | 核对要点 |
|---|---|---|
| 任选通道①（如 CH4） | PB3（SCK） | 时钟线 |
| 任选通道②（如 CH5） | PA4（WS） | 声道选择 |
| 任选通道③（如 CH6） | PB5（SD） | 数据线 |
| GND | GND | 必须共地 |

### 3.2 抓取
1. 打开 Saleae Logic 1.2.17 → 顶部应显示 **[Connected]**（未识别则看资料夹《手把手教...手动安装教程.docx》装驱动）。
2. 左下 Capture：采样率 **24M**（本机 8 通道上限，实测可选"24 M Samples"；≥23 倍过采样），采样时长数秒。
3. 核心板上电，点绿色 **Start**，等采集完成自动停止。
4. 滚轮放大 CH0 波形，拖时间标尺量 SCK 一个完整周期（ΔT 显示在测量栏）。
5. （可选交叉验证）右侧 **Analyzers +** → 添加 **I2S** 解码器 → 绑定 SCK/WS/SD 通道 → 自动标出 32-bit 帧。

### 3.3 读数与判定
- **SCK 频率**：实测值 = 1 / 周期 = **___ MHz**；期望 1.024MHz，合格范围 0.973 ~ 1.075。
- **WS 周期**：应 = 64 个 SCK（对应 Fs=16kHz）：**___ 个 SCK**。
- 两项都合格 → ✅ 通过，README 遗留关闭。
- 若 SCK ≈ **2.048MHz**（2 倍）→ 进入 §3.4 修正。

### 3.4 修正流程（仅当实测 ~2.048MHz）
1. 打开 `firmware/soundDog/soundDog.ioc`（CubeMX）。
2. 调整 I2SDIV 或 PLLI2S 分频，使 SCK 回到 1.024MHz（参考 `docs/CubeMX_I2S3配置详解.md` 时钟推导）。
3. 重新生成代码（确认手动代码都在 USER CODE 区间，见 BUG-001 教训）。
4. `firmware\build_and_flash.bat` 重烧 → 回到 §3.3 复测。

### 3.5 故障速查表
| 现象 | 可能原因 | 处理 |
|---|---|---|
| 抓不到任何波形 | 探头没夹牢 / 未上电 / 通道接错 | 检查杜邦线接触；确认板子供电 |
| SCK 显示失真/毛刺 | 采样率不足 | 采样率必须 ≥8M，用 16M |
| WS 无周期性 | 未在采集 I2S（麦克风未工作） | 确认 A1-02 链路在跑 |
| 频率 ~2.048MHz | I2SDIV/PLLI2S 配置问题 | 按 §3.4 修正 |

## 4. 验收标准（12 条）

### 功能验收
- [x] AC-01 逻辑分析仪实测 SCK = 1.024MHz ±5%（0.973~1.075MHz），Fs=16kHz
  **✅ 通过（2026-08-28 Saleae Logic 1.2.17 实测，24MHz/1s）**：
  - SCK（CH3，PB3）：f = 1MHz（T=1µs，标注分辨率 ±4%，真值 0.977~1.024µs，与设计 1.024MHz 兼容）
  - WS（CH4，PA4）：f = **16kHz 精确命中**（T=62.5µs，50% 占空比，标准 I2S 帧同步形态）
  - 交叉验证：WS 周期 ÷ SCK 周期 = 62.5µs ÷ 1µs ≈ 62~64 SCK/帧，与 32-bit×2 声道结构自洽
  - **结论：Fs=16000Hz 无误，README"SCK 疑似 2 倍"遗留正式证伪关闭**
- [x] AC-02 向后兼容（不破坏 A1-02 已通过链路；若改配置，重烧后 A1-02 复测通过）
  **✅ 通过**：纯测量，无代码/配置改动，A1-02 链路在测量期间持续运行（串口 max= 正常输出）

### 代码质量 / 安全红线 / 测试边界
- [x] AC-03 若改配置：编译通过（`build.bat` 无错误）→ **N/A（未改任何配置）**
- [x] AC-04 无新增警告 → **N/A（未改代码）**
- [x] AC-05 实测值已记录到本 FEAT 维护章节 + README 遗留更新 → **✅ 已完成**
- [x] AC-06 ~ AC-12：不适用项标 **N/A**（测量步骤：无密钥/输入/新测试/覆盖率）

## 5. 维护与调试（阶段5通过后回填）

### 5.1 影响文件
| 文件 | 改动类型 | 说明 |
|---|---|---|
| （无代码/配置改动） | — | 纯测量验证；时钟配置无需修正 |
| `README.md` / `HANDOFF.md` / 父FEAT / INDEX | 文档回填 | SCK 2 倍疑点关闭，A1 全线收官 |

### 5.2 实测基准（生产参考值）
| 信号 | 引脚 | 实测 | 设计值 | 判定 |
|---|---|---|---|---|
| SCK | PB3 | 1MHz（±4% 分辨率，真值区间含 1.024MHz） | 1.024MHz | ✅ |
| WS | PA4 | 16kHz 精确（T=62.5µs，50%） | 16kHz | ✅ 精确命中 |
| Fs（推导） | — | 16000 Hz 整 | 16000 Hz | ✅ |

### 5.3 调试要点
- 逻辑分析仪抓 SCK（PB3）测频率；与 WS 周期交叉验证
- SCK 自动标注显示"1 MHz"为分辨率取整（41.67ns/点 × 24 点），非偏差；精确判 Fs 看 WS（16kHz 直读）

### 5.4 测试入口
- Saleae Logic 1.2.17 测频 + 串口帧节奏（对应 AC-01）

## 6. 执行日志

| 时间 | 阶段 | 角色 | 摘要 | 遇阻 |
|---|---|---|---|---|
| 2026-08-28 | 阶段1 准备 | Dev Agent | 逻辑分析仪（zave 24M/8ch，Saleae 8 兼容克隆）+ PulseView 可用；A1-02 链路在跑（18:40 复验）。软件侧已有三条独立证据预证 SCK=1.024MHz（寄存器推导 / 16kHz 采样率反推 / BUG-002 误判根源消除），本次实测为最终确证 | 无 |
| 2026-08-28 | 阶段2 设计 | Dev Agent | 判读标准细化：SCK 周期 928~1029ns、WS 周期 ~32µs、WS/SCK=64±1；PulseView 加 I2S 协议解码器交叉验证位宽（32-bit） | 无 |
| 2026-08-28 | 阶段1/2 复核修订 | Dev Agent | 文档纠偏：实际安装软件为 **Saleae Logic 1.2.17**（非 PulseView/sigrok——原操作单基于错误假设）；抓取步骤/故障表/工具清单全部改写为 Logic 1.2.17 界面操作（Connected 标识、Capture 采样率 16M、Start、Analyzers+I2S）。历史行保留原文 | 无 |
| 2026-08-28 | 阶段3 实现 | Dev Agent | 实测接线（通道号通用化：本机界面 CH4~7，实接 CH3=SCK/CH4=WS）；采样率 24M（用户软件实测可选"24 M Samples"，原 16M 为保守误估已修正）；采集 24MHz/1s | 无 |
| 2026-08-28 | 阶段4 测试 | Test Agent | 实测：SCK f=1MHz（±4% 分辨率，真值含 1.024MHz）；WS f=16kHz 精确（T=62.5µs/50%）；比值 62~64 SCK/帧自洽 → Fs=16000Hz 无误，"2 倍疑点"证伪 | 无 |
| 2026-08-28 | 阶段5 审查 | Review Agent | AC-01/02/05 ✅、AC-03/04/06~12 N/A。实测基准固化 §5.2；回填 README/HANDOFF/父FEAT/INDEX/维护地图；**A1 全线收官** | 无 |
