wumu-dot/SoundDog/docs/features/FEAT-A8-上位机.md

# FEAT-A8-上位机（父FEAT · 统筹规划）

> **AI 执行规则**：父FEAT 只做统筹规划，禁止编写实现代码；实现一律拆成子FEAT。
> 创建/修改项目表后必须停等，输出结果等人类确认方向后才允许创建子FEAT。
> 禁止自审自判完成：父FEAT 置 🟢 仅当项目表全部子FEAT 🟢 且每个都经过 Review。
> 历史记录只更新状态字段，严禁删除/篡改已完成记录。
> 事实来源：`.sop-agent规格.md` §3（禁止自造数值；未覆盖项写"待定（需人确认）"）。

## 0. 元数据
- **角色**：Planner（统筹规划）
- **优先级**：P2（非主链路，但统合 PC 端验证工具）
- **预估总耗时**：16h（含等 A5 通信链路）
- **当前状态**：🔴规划中

## 1. 总体目标与方向

### 1.1 核心目标（一句话）
> 用 **Python（Anaconda 3.13.5）+ matplotlib + tkinter + pySerial** 做 PC 端上位机，统一整合现有计划中的 PC 端需求：频谱实时显示、模版采集训练、参数下发、报警监控，通过 **RS485（对接 A5）** 与板子通信。GUI 不引入 PySide6（6.11 DLL 加载失败已放弃，事实包 §3.7）。

### 1.2 大方向策略
> 先做**通信层**（A8-01，对接 A5-02 帧协议）打通数据管道；再做**频谱显示**（A8-02，对接 A2-04 输出）——这两步是基础；模版训练（A8-03）与参数/报警（A8-04）依赖前者。A8-03 的 K-means 与 A4-01 是同一算法，PC 端实现可提前独立开发（只需数据文件，不依赖硬件）。GUI 用 tkinter + matplotlib（Anaconda 自带，零安装）。

### 1.3 硬边界（继承 CLAUDE.md）
- [x] 是否涉及底层库 / 第三方库？→ 否（PC 端应用，不碰 `firmware/Drivers/`；第三方库 PySide6/pySerial/numpy 经 pip 安装，不改其源码）
- [x] 否 → 继续

### 1.4 关键参数与接口（事实包 §3，禁止自造）
- **语言/框架**：Python 3.13.5（Anaconda）+ **tkinter + matplotlib 3.10.0**（GUI，自带）+ pySerial（已装）+ numpy（自带）+ scikit-learn 1.6.1（K-means，自带）。
- **通信链路**：PC 端 USB-TTL(CH340) → TTL-RS485 模块(3.3V/SP3485，引脚 EN/VCC/A/B/GND×2/RXD/TXD) → A/B 对接 → 板端模块 → USART3（PD8/PD9，115200，EN=PD11）——见 A5-01/A5-03。
- **帧协议**：对接 A5-02（帧头 0xA5 / 帧尾 0x5A / CRC16；参数未定，需人确认）。
- **频谱数据**：对接 A2-04 输出（一行 32 个整数，~200ms 节流）。
- **模版**：13 维 MFCC × K=16（A4-01 约定），训练数据来自板端串口采集。
- **参数下发**：阈值/帧数（A4-04 约定，30/60 帧基线）。
- **待定（需人确认）**：绘图库选型、Python 版本、打包分发方式（pyinstaller？）、日志格式、模版文件格式。

## 2. 项目表（子FEAT清单）

> 每个子FEAT 按子模板（`.template-child.md`）创建，独立执行 5 阶段（准备→设计→实现→测试→审查）。子FEAT 文档待 A8 方向确认后按命名规范建档。

| 子FEAT编号 | 功能 | 验收要点 | 优先级 | 依赖 | 状态 | 文件 |
|---|---|---|---|---|---|---|
| FEAT-A8-01 | 通信层（pySerial+帧协议） | 与板端双向收发无误码，帧解析正确 | P0 | 依赖 A5-02 | 🔴未开始 | `FEAT-A8-01-通信层.md` |
| FEAT-A8-02 | 频谱实时显示 | 32 频带柱状/波形实时刷新，与串口数据一致 | P1 | 依赖 01 | 🔴未开始 | `FEAT-A8-02-频谱实时显示.md` |
| FEAT-A8-03 | 模版采集与训练 | 采集 MFCC→K-means(K=16)→导出模版文件 | P1 | 依赖 A3（数据流） | 🔴未开始 | `FEAT-A8-03-模版采集与训练.md` |
| FEAT-A8-04 | 参数下发与报警监控 | 阈值/帧数下发成功；报警弹窗+日志 | P1 | 依赖 01 | 🔴未开始 | `FEAT-A8-04-参数下发与报警监控.md` |

> 子FEAT 完成后回填本行状态与文件链接（🟢已完成 / 🟡阶段X进行中）。

## 3. 依赖与执行顺序

1. A8-01 通信层 → A8-02 频谱显示 / A8-04 参数报警（串行基础，后两者可并行，均依赖 01）
2. A8-03 模版训练 **可独立提前开发**（PC 端算法 + 数据文件即可，不需硬件），但联调依赖 A8-01
3. 全链路依赖 **A5 通信先通**（A5-01~A5-04）

## 4. 阻塞与下一步

- **阻塞**：A5 RS485 通信链路未完成（A5-01~04 均未开始）；A3 MFCC 数据流未就绪（影响 A8-03 实采）
- **下一步**：方向确认后创建 A8-01 子FEAT；同时 A8-03 的 K-means 算法可先独立开发（与 A4-01 共用设计）

## 5. 完成定义（DoD）

- [ ] 项目表全部子FEAT 🟢 且每个经 Review
- [ ] 本表状态与 `docs/features/INDEX.md` 一致
- [ ] 经验教训已提炼（如有）

## 6. 执行日志

| 时间 | 动作 | 角色 | 摘要 | 遇阻 |
|---|---|---|---|---|
| 2026-08-16 | 创建父FEAT | Planner | 立项全功能上位机：Python+PySide6，4 个子FEAT（通信/频谱/模版/参数报警），方向待人确认 | 依赖 A5 通信链路 |
