wumu-dot/SoundDog/docs/features/FEAT-A5-04-主从轮询时序.md

# FEAT-A5-04-主从轮询时序

> **AI 执行规则**：必须按阶段顺序执行，每个阶段开头声明角色。严禁跳跃、越界、自审自判。
> 阶段间停等：每完成一个阶段，停下来，输出结果，等人说"继续"。
> 阶段5通过后：回填父FEAT项目表该行 + 更新 `docs/features/INDEX.md` + `docs/features/维护地图.md`。
> 历史记录只更新状态字段，严禁删除/篡改已完成记录。
> 事实来源：`.sop-agent规格.md` §3（禁止自造数值；未覆盖项写"待定（需人确认）"）。

## 0. 元数据
- **父FEAT**：FEAT-A5-RS485通信
- **优先级**：P2
- **预估总耗时**：2h（父FEAT 预算 8h 内拆分）
- **当前状态**：🔴未开始（傻瓜式操作单已备好，依赖 A5-03 通过后开跑）

## 1. 总体目标与硬边界

### 1.1 核心目标（一句话）
> 在 A5-03 双向无冲突链路上实现**主从轮询**：主节点按周期发轮询帧，从节点**不主动发**、被轮询到才回复；验证多轮轮询无冲突、超时不挂死。

### 1.2 地基触碰前置自检
- [x] 否 → 继续（App 层轮询状态机，不碰 `firmware/Drivers/`）

### 1.3 任务边界
| 类型 | 具体内容 |
|---|---|
| 范围内（可改） | 轮询状态机（主/从逻辑）、轮询参数（确认后固化）、`Makefile`（如需补源文件） |
| 超出范围（禁止碰） | `firmware/Drivers/` HAL 底层库；帧格式/CRC16（A5-02 已定，不得改） |
| 外部依赖 | A5-03 已通过（双模块链路可用）、A5-02 协议帧、SSCOM |

### 1.4 关键参数与接口（事实包 §3，禁止自造）
- **主从轮询，节点不主动发**（事实包 A5-04）——从节点只响应轮询帧，绝不主动上总线。
- 帧格式 / CRC16：沿用 **A5-02** 产物（帧头 0xA5 / 帧尾 0x5A / CRC16；字段定义以 A5-02 §3.1 人确认记录为准）。
- 传输通道：USART3 + TTL-RS485（半双工，115200，A5-01/03 打通）。
- **待定（需人确认，确认前禁止固化实现**：
  - **主节点角色**：PC 端上位机（经 CH340）还是 STM32 板端？——事实包未指定。
  - **从节点地址分配**：地址域定义/编址方式——事实包未给。
  - **轮询周期**：多久轮询一次——事实包未给。
  - **回复超时**：主发轮询后等多久算超时——事实包未给。
  - **失败重试次数**：超时后重试几次——事实包未给。

## 2. 执行路线图（5 阶段）

### 🟢 阶段 1：准备（角色：Dev Agent）
- **读什么**：A5-02（帧格式/CRC16）、A5-03（链路拓扑/COM）、`CLAUDE.md`（硬边界）、`.sop-agent规格.md` §3.6 A5-04
- [ ] 步骤1：确认 A5-03 已通过（双向无误码）
- [ ] 步骤2：列出轮询**待定项清单**（§1.4：主角色/从地址/周期/超时/重试），输出给人确认
- [ ] 步骤3：输出影响范围（轮询状态机 / 主从两端代码 / 测试脚本）
- **判定标准**：A5-03 状态已核实、待定项清单已列全
- **⏸️ 停等：人确认待定项（主角色/从地址/周期/超时/重试）后进入阶段 2**

### 🔵 阶段 2：设计（角色：Dev Agent）
- **阶段目标**：产出轮询时序设计与傻瓜式操作单（§3）
- [ ] 步骤1：设计主节点轮询状态机（发轮询帧 → 等回复 → 超时 → 重试/记失败 → 下一轮）
- [ ] 步骤2：设计从节点监听状态机（只收不发；收到本地址轮询帧才回复，回复完立即回监听态）
- [ ] 步骤3：按人确认参数固化轮询周期/超时/重试（记录到 §3.1）
- **判定标准**：主/从状态机已产出、参数已固化记录
- **⏸️ 停等：人确认后进入阶段 3**

### 🟠 阶段 3：实现（角色：Dev Agent）
- **阶段目标**：写代码，每改完一个文件对照 §4 自检
- [ ] 步骤1：实现主节点轮询逻辑（含超时/重试）
- [ ] 步骤2：实现从节点监听逻辑（不主动发，被轮询才回复）
- [ ] 步骤3：`firmware\build.bat` 编译通过（若改板端代码）；PC 端脚本（如用上位机）路径待定（需人确认）
- **判定标准**：编译通过（涉及代码时）
- **⏸️ 停等：人确认后进入阶段 4**

===== 切换至 Test Agent =====

### 🟣 阶段 4：测试（角色：Test Agent）
- **阶段目标**：独立验证——按 §3 操作单跑轮询时序，核对 §4 验收标准
- [ ] 步骤1：按 §3.2 连续 100 轮轮询，记录成功轮数/冲突/超时（AC-01）
- [ ] 步骤2：按 §3.3 观察从节点 60s 无主动发送（AC-01）
- [ ] 步骤3：按 §3.4 无应答场景：主不挂死、超时后继续下一轮（AC-01）
- [ ] 若失败 → 退回阶段 3
- **⏸️ 停等：人确认后进入阶段 5**

===== 切换至 Review Agent =====

### 🔴 阶段 5：审查（角色：Review Agent）
- **阶段目标**：独立审查——AC 逐条打勾
- 全部通过 → ✅ 回填「维护与调试」+ 父FEAT项目表 + INDEX + 维护地图
- 未通过 → 退回对应阶段并附意见

## 3. 傻瓜式操作单（照做即可）

### 3.0 物品/工具清单
- [ ] 核心板 + 双模块链路（A5-03 已通过状态）
- [ ] SSCOM（CH340 COM，115200）或 PC 端上位机脚本
- [ ] SSCOM 或串口工具（USART1 调试口，观察板端日志）
- [ ] 秒表或上位机时间戳（记录轮询周期/超时）

### 3.1 轮询参数确认（先做！全部来自人确认结果，禁止自造）
1. 记录主节点角色：**PC 上位机 / STM32 板端**（圈选）
2. 记录从节点地址分配：______
3. 记录轮询周期：______
4. 记录回复超时：______
5. 记录失败重试次数：______
6. ⚠️ 任一项未确认 → **停，不得进入 §3.2**，回报人补齐。

### 3.2 正常轮询时序（阶段 4 执行）
1. 启动轮询（主节点发轮询帧，含从地址）。
2. 期望：从节点在**超时内**回复（回复帧含从地址 + 数据）。
   记录：从"收到轮询"到"发出回复"耗时：____
3. 连续轮询 100 轮：期望 100 轮全部成功、无总线冲突。
   记录：成功轮数：___/100；冲突次数：___；超时次数：___
4. 半双工红线：主发完轮询帧后**立即转接收态**；从回复期间主不得再发。

### 3.3 从节点不主动发验证（阶段 4 执行）
1. 主节点停止轮询，让总线空闲。
2. 观察从节点 60s（时长可现场调整，记录实际值）：期望**从节点不发任何字节**。
   记录：观察时长：____；发现主动发送：是 / 否
3. 若从节点主动发 → 违反"节点不主动发"，退回阶段 3 查监听状态机。

### 3.4 无应答场景（阶段 4 执行；验证主节点不挂死）
1. 人为制造无应答：拔掉从端模块电源（或从端不响应）。
2. 主节点继续轮询：期望主节点**超时后重试（按 §3.1 次数）→ 记录失败 → 继续下一轮，不挂死**。
   记录：单轮无应答处理耗时：____；连续 10 轮无应答后主节点状态：正常 / 挂死
3. 恢复从端供电：期望下一轮轮询自动恢复成功。
   记录：恢复后首轮结果：成功 / 失败

### 3.5 故障速查表
| 现象 | 可能原因 | 处理 |
|---|---|---|
| 轮询冲突乱码 | 两端同时发送（主重发过快 / 从主动发） | 核对半双工错开（§3.2 步骤4）；查从节点是否违规主动发 |
| 轮询超时无回复 | 从地址不符 / 帧格式错（A5-02） / 波特率 | 核对 §3.1 地址与 A5-02 §3.1 帧格式；两端 115200 |
| 从节点主动发数据 | 监听状态机缺陷，违反"节点不主动发" | 退回阶段 3，修复从节点状态机（只收不发） |
| 主节点挂死 | 超时/重试未实现 | 退回阶段 3，补超时与重试逻辑 |
| 恢复供电后仍失败 | 从节点未回监听态 / 主节点状态错乱 | 两端复位重连，重跑 §3.2 |

## 4. 验收标准（12 条）

### 功能验收
- [ ] AC-01 连续 100 轮轮询全部成功（冲突 0、超时 0，§3.2 记录）；从节点 60s 观察期无主动发送（§3.3 记录）；无应答时主节点不挂死（§3.4 记录）
- [ ] AC-02 向后兼容：A5-03 双向收发仍可用，A5-02 帧格式未改动

### 代码质量
- [ ] AC-03 若改代码：`firmware\build.bat` 编译通过
- [ ] AC-04 若改代码：无新增警告
- [ ] AC-05 文档已更新：轮询参数（周期/超时/重试/地址）写入本 FEAT 维护章节

### 安全红线
- [ ] AC-06 N/A：无密钥
- [ ] AC-07 错误处理：超时/重试/失败计数完善，主节点不挂死（§3.4 记录）
- [ ] AC-08 输入校验：从节点校验轮询帧地址与 CRC16（A5-02 已实现），非本地址帧忽略

### 测试与边界
- [ ] AC-09 N/A：无自动测试框架；轮询为手动验证（自动化脚本待定（需人确认））
- [ ] AC-10 回归：`./scripts/ci_local.sh` 通过（若适用）
- [ ] AC-11 N/A：嵌入式手动验证，覆盖率不适用
- [ ] AC-12 按 FEAT 模板执行（本文件即模板产物）

## 5. 维护与调试（阶段5通过后回填）

### 5.1 影响文件
| 文件 | 改动类型 | 说明 |
|---|---|---|
| 轮询状态机文件（A5-02 协议层之上，文件名待定（需人确认）） | 新增/修改 | 主节点轮询 + 从节点监听 |
| `firmware/soundDog/Makefile` | 修改（如需） | C_SOURCES 补源文件（BUG-002 教训） |
| PC 端上位机/脚本（如主节点为 PC） | 新增（路径待定（需人确认）） | 轮询触发 + 统计 |

### 5.2 调试要点
- 轮询参数（周期/超时/重试/地址）以 §3.1 人确认记录为准
- 半双工铁律：主发→转收；从回复→回监听；任何一端都不得在对方发送期间上总线
- 调试打印走 USART1（115200），协议数据走 USART3（115200）

### 5.3 测试入口
- §3.2 / §3.3 / §3.4 轮询用例（对应 AC-01）

## 6. 执行日志

| 时间 | 阶段 | 角色 | 摘要 | 遇阻 |
|---|---|---|---|---|
| | | | | |
