wumu-dot/SoundDog/docs/features/FEAT-A5-RS485通信.md

# FEAT-A5-RS485通信（父FEAT · 统筹规划）

> **AI 执行规则**：父FEAT 只做统筹规划，禁止编写实现代码；实现一律拆成子FEAT。
> 创建/修改项目表后必须停等，输出结果等人类确认方向后才允许创建子FEAT。
> 禁止自审自判完成：父FEAT 置 🟢 仅当项目表全部子FEAT 🟢 且每个都经过 Review。
> 历史记录只更新状态字段，严禁删除/篡改已完成记录。

## 0. 元数据
- **角色**：Planner（统筹规划）
- **优先级**：P1
- **预估总耗时**：8h
- **当前状态**：🔴规划中

## 1. 总体目标与方向

### 1.1 核心目标（一句话）
> 打通 STM32 ↔ PC 的 RS485 半双工通信，实现协议帧收发（含 CRC16），支撑检测结果上报。

### 1.2 大方向策略
> 先 USART3+TTL-RS485 模块(3.3V) 驱动，再协议帧打包/解析，最后 PC 端收发验证与主从轮询。

### 1.3 硬边界（继承 CLAUDE.md）
- [x] 是否涉及底层库 / 第三方库？→ 否（UART 走 HAL 标准库，App 层状态机）
- [x] 否 → 继续

## 2. 项目表（子FEAT清单）

> 每个子FEAT 按子模板（`.template-child.md`）创建。子FEAT 文档待细化时再建。

| 子FEAT编号 | 功能 | 验收要点 | 优先级 | 依赖 | 状态 | 文件 |
|---|---|---|---|---|---|---|
| FEAT-A5-01 | USART3+TTL-RS485 模块驱动 | DE/RE 方向控制（自动收发型免接），回环可收发 | P1 | 无 | 🔴未开始 | `FEAT-A5-01-USART3-RS485模块驱动.md` |
| FEAT-A5-02 | 协议帧打包/解析 | 帧头 0xA5/帧尾 0x5A/CRC16 校验 | P1 | 依赖 01 | 🔴未开始 | `FEAT-A5-02-协议帧打包解析.md` |
| FEAT-A5-03 | PC 端收发验证 | PC 端 USB-TTL+TTL-RS485 模块与板端 A/B 对接，双向收发无误码 | P1 | 依赖 02 | 🔴未开始 | `FEAT-A5-03-PC端收发验证.md` |
| FEAT-A5-04 | 主从轮询时序 | 节点不主动发，轮询无冲突 | P2 | 依赖 03 | 🔴未开始 | `FEAT-A5-04-主从轮询时序.md` |

> 子FEAT 完成后回填本行状态与文件链接。

## 3. 依赖与执行顺序

1. 01 驱动 → 02 协议 → 03 PC 验证 → 04 轮询（串行）

## 4. 阻塞与下一步

- **阻塞**：可独立于 A3/A4 先做硬件接口
- **下一步**：开 A5-01 USART3+TTL-RS485 模块(SP3485) 驱动（模块已到货，先看丝印确认 DE/RE 类型）

## 5. 完成定义（DoD）

- [ ] 项目表全部子FEAT 🟢 且每个经 Review
- [ ] 本表状态与 `docs/features/INDEX.md` 一致
- [ ] 经验教训已提炼（如有）

## 6. 执行日志

| 时间 | 动作 | 角色 | 摘要 | 遇阻 |
|---|---|---|---|---|
| | | | | |
