wumu-dot/SoundDog/docs/features/FEAT-A7-03-Flash存储.md

# FEAT-A7-03-Flash存储

> **AI 执行规则**：必须按阶段顺序执行，每个阶段开头声明角色。严禁跳跃、越界、自审自判。
> 阶段间停等：每完成一个阶段，停下来，输出结果，等人说"继续"。
> 阶段5通过后：回填父FEAT项目表该行 + 更新 `docs/features/INDEX.md` + `docs/features/维护地图.md`。
> 历史记录只更新状态字段，严禁删除/篡改已完成记录。
> 事实来源：`.sop-agent规格.md` §3（禁止自造数值，没有的一律写"待定（需人确认）"）。

## 0. 元数据
- **父FEAT**：FEAT-A7-辅助功能
- **优先级**：P2
- **预估总耗时**：3h
- **当前状态**：🔴未开始（傻瓜式操作单已备好；**依赖 A4，阻塞中**）

## 1. 总体目标与硬边界

### 1.1 核心目标（一句话）
> 把 A4 生成的正常模版参数与系统事件日志存入**存储介质**（片内 Flash 或外挂 SPI2 W25Q64，**介质选择待定（需人确认）**），**掉电不丢失、上电自动加载**。

### 1.2 地基触碰前置自检
- [x] 否 → 继续（经 HAL 标准接口调用：片内 Flash 用 `HAL_FLASH_Program/Erase`；W25Q64 走 SPI2 HAL SPI 接口；均不触碰 `firmware/Drivers/` 底层库文件）

### 1.3 任务边界
| 类型 | 具体内容 |
|---|---|
| 范围内（可改） | 新增 App 层 `flash_store_drv.c/.h`、模版参数读写、事件日志（环形）、上电加载 |
| 超出范围（禁止碰） | `firmware/Drivers/` HAL 底层库文件、A4 算法实现本身（本 FEAT 只做存储） |
| 外部依赖 | A4 模版参数（A4-01 PC 端 K-means K=16 生成的正常模版，事实包 §3.6）、Flash 扇区规划（待定需人确认） |

### 1.4 关键参数（事实包 §3，禁止自造）
- **存储介质（待定需人确认）**：两种候选，开跑前必须选定：
  - ① STM32 **片内 Flash**（HAL `HAL_FLASH_Program/Erase`，扇区规划需人确认）；
  - ② **外挂 SPI2 W25Q64**（`pin_config.h` 已定义：`FLASH_SPI=SPI2`、8MB、扇区 4096、页 256，注释"复用 pointer-desk 已验证引脚"；接线 SCK=PB10/MOSI=PC3/MISO=PC2/CS=PB12）。
  - **选择权在人，本 FEAT 不擅自决定**；选定后按对应接口实现。
- 模版参数来源：**A4-01** PC 端 K-means（K=16）生成的正常模版（事实包 §3.6）；参数具体格式/字节数：**待定（需人确认，依赖 A4 输出格式）**。
- 事件日志来源：如 **A4-03** 连续 30 帧异常报警 / 连续 60 帧正常解除等事件（事实包 §3.6）；日志条目结构/数量上限：**待定（需人确认）**。
- Flash 扇区规划（存储区起始地址、参数区/日志区划分）：**待定（需人确认）**。通用约束：**写前必须先擦除、擦除以扇区为单位**；日志频繁写需考虑擦写寿命与磨损（环形多扇区方案待定需人确认）。
- 数据完整性：魔数 / 版本 / 校验（**校验算法待定需人确认**；可参考 A5-02 CRC16 思路，但**不得直接套用**，需人确认后定稿）。
- 写入触发：**待定（需人确认：串口命令 / 自动 / A4 校准完成时）**。

## 2. 执行路线图（5 阶段）

### 🟢 阶段 1：准备（角色：Dev Agent）
- **读什么**：A4 相关文档（模版参数格式/交付物，路径待定）+ `main.c` 初始化顺序 + 现有串口命令（如有）。
- [ ] 步骤1：确认 A4 交付物：模版参数文件/格式/字节数（**待定需人确认**）
- [ ] 步骤2：**确认存储介质**（片内 Flash vs 外挂 SPI2 W25Q64，见 §1.4 待定项；需人确认），定位上电初始化点与串口打印入口，输出影响范围
- **判定标准**：影响范围明确"新增 flash_store_drv + 上电加载 + A4 依赖项"
- **⏸️ 停等：人确认后进入阶段 2**

### 🔵 阶段 2：设计（角色：Dev Agent）
- **阶段目标**：定存储布局与 API，产出 §3 操作单
- [ ] 步骤1：**存储介质定稿（需人确认）** + Flash 扇区规划（参数区/日志区地址，**待定需人确认**）与日志环形策略（**待定需人确认**）
- [ ] 步骤2：数据格式设计（魔数/版本/校验，校验算法**待定需人确认**）
- [ ] 步骤3：编写 §3 操作单（写读验证/掉电保持/环形覆盖/故障表）
- **判定标准**：§3 每步含期望值与记录空位；布局不重叠、两区留余量
- **⏸️ 停等：人确认后进入阶段 3**

### 🟠 阶段 3：实现（角色：Dev Agent）
- **阶段目标**：写代码，每改完一个文件对照 AC 自检
- [ ] 步骤1：新建 `flash_store_drv.c/.h`：写参数/读参数/写日志/读日志（含擦除流程）
- [ ] 步骤2：上电加载模版参数 + 校验失败回退默认值（处理方式待定需人确认）
- [ ] 步骤3：串口打印验证输出（格式待定需人确认）；编译 `firmware\build.bat` 无错误、无新增警告
- **判定标准**：编译通过（build.bat 无错误退出、无新增警告）
- **⏸️ 停等：人确认后进入阶段 4**

===== 切换至 Test Agent =====

### 🟣 阶段 4：测试（角色：Test Agent）
- **阶段目标**：独立测试——只看 §3 操作单与 §4 验收标准，不看 Dev 实现细节
- [ ] 步骤1：按 §3.2 参数写→读回逐字节比对（AC-01）
- [ ] 步骤2：按 §3.3 断电重启，参数仍在（AC-01）
- [ ] 步骤3：按 §3.4 事件日志追加与环形覆盖（AC-02，依赖 A4-03 事件源，未就绪则 ⏸️ 停等）
- [ ] 步骤4：运行 `./scripts/ci_local.sh`；若失败 → 查 §3.5 故障表，退回阶段 3
- **判定标准**：AC-01/02 证据齐全（记录比对结果、重启加载结果、日志条目数）
- **⏸️ 停等：人确认后进入阶段 5**

===== 切换至 Review Agent =====

### 🔴 阶段 5：审查（角色：Review Agent）
- **阶段目标**：独立审查——代码质量、越界/擦写安全、AC 逐条打勾
- 全部通过 → ✅ 回填「维护与调试」+ 父FEAT项目表 + INDEX + 维护地图
- 未通过 → 退回对应阶段并附意见
- **判定标准**：§4 十二条 AC 全部通过或 N/A 有说明；确认未越界修改 A4 算法

## 3. 傻瓜式操作单（照做即可）

### 3.0 物品清单（动手前先打勾，缺一不可）
- [ ] 核心板（已按 A1-02 烧录验证过）
- [ ] ST-Link（SWD：SWDIO/SWCLK/GND/3.3V 四线）
- [ ] USB-TTL（CH340）+ SSCOM（115200）
- [ ] 5V 电源（非快充）
- [ ] A4 模版参数交付物（**文件路径待定需人确认**）
- [ ] （若选外挂 W25Q64）W25Q64 模块 + 杜邦线 ×4（SCK=PB10/MOSI=PC3/MISO=PC2/CS=PB12，待定需人确认）

### 3.1 前置确认（阶段1/2 产物，缺一项都先 ⏸️ 停等问人）
- [ ] **存储介质**：片内 Flash / 外挂 SPI2 W25Q64（圈选，**待定需人确认**）
- [ ] A4 模版参数格式与字节数（记录：___，**待定需人确认**）
- [ ] Flash 扇区规划：参数区地址 ___ / 日志区地址 ___（**待定需人确认**，两区不得重叠）
- [ ] 写入触发方式（记录：___，**待定需人确认**）
- [ ] 校验算法（记录：___，**待定需人确认**）

### 3.2 参数写 → 读回验证（阶段 4 执行）
1. 触发写入模版参数（触发方式见 §3.1 记录）。
2. 串口打印读出结果（打印格式待定需人确认，记录读出值：___）。
3. 与写入内容**逐字节比对**：一致 / 不一致（圈选）。不一致 → 查 §3.5。

### 3.3 掉电保持验证（阶段 4 执行）
1. 断电，等待片刻（Flash 掉电稳定所需时长待定需人确认），重新上电。
2. SSCOM 看 boot 三行后，模版参数应自动加载并打印：**加载成功 / 加载失败（回退默认值）**（圈选，记录：___）。
3. 加载失败 → 查 §3.5（可能写入未完成或校验失败，记录回退动作）。

### 3.4 事件日志验证（阶段 4 执行；依赖 A4-03 事件源，未就绪则 ⏸️ 停等）
1. 触发若干事件（记录事件类型与次数：___）。
2. 读日志：条目数与顺序与写入一致（记录：___）。
3. 写满后继续触发：日志**环形覆盖**、不越界、不破坏参数区（记录：___）。

### 3.5 故障速查表
| 现象 | 可能原因 | 处理 |
|---|---|---|
| 读回全 0xFF | 从未写入 / 地址错 / 擦除后未写 / 介质选择或接线错（W25Q64 未接对） | 确认存储介质与扇区规划（待定）；片内先擦除再编程；W25Q64 查 SPI2 接线（SCK=PB10/MOSI=PC3/MISO=PC2/CS=PB12） |
| 写失败/返回错误 | 未擦除 / 地址越界 / 对齐问题 | 检查擦除流程与地址范围（待定） |
| 重启后参数丢失 | 写未完成即掉电 / 校验失败回退默认 | 查写入完成确认（HAL 返回值）+ 掉电时序；记录回退事件 |
| 参数损坏但无提示 | 无校验 | 加魔数 + 校验（方案待定需人确认） |
| 日志区越界写坏参数区 | 两区布局重叠 | 确认地址不重叠且留余量（待定） |
| 擦写次数超限后失效 | 日志频繁写同一扇区 | 环形多扇区/磨损均衡（方案待定需人确认） |

## 4. 验收标准（12 条）

### 功能验收
- [ ] AC-01 模版参数写→读回**逐字节一致**，断电重启后仍在（记录比对结果与重启加载结果）
- [ ] AC-02 事件日志按序追加、写满后环形覆盖，不越界、不破坏参数区（记录条目数与覆盖行为）

### 代码质量
- [ ] AC-03 编译通过（`firmware\build.bat` 无错误退出）
- [ ] AC-04 无新增编译警告
- [ ] AC-05 文档已更新（本 FEAT + 父 FEAT-A7 项目表回填）

### 安全红线
- [ ] AC-06 无硬编码密钥 → **N/A**（嵌入式固件无密钥场景，说明）
- [ ] AC-07 错误处理完善：校验失败回退默认值且有记录；写失败有返回值/日志，不静默
- [ ] AC-08 用户输入校验 → **N/A**（当前无用户输入；若引入串口命令则需校验，方案待定需人确认）

### 测试与边界
- [ ] AC-09 新增测试自动运行 → **N/A**（人工串口验证 + 断电重启验证，无自动化测试基建，说明）
- [ ] AC-10 全部回归测试通过：boot 三行 + 既有采集功能不回归
- [ ] AC-11 测试覆盖率 ≥ 80% → **N/A**（无单元测试基建，说明）
- [ ] AC-12 按 FEAT 模板执行（结构符合 `.sop-agent规格.md` §2）

## 5. 维护与调试（阶段5通过后回填）

### 5.1 影响文件
| 文件 | 改动类型 | 说明 |
|---|---|---|
| `firmware/soundDog/Src/flash_store_drv.c` | 新增 | 参数/日志读写、擦除流程（介质：片内 Flash 或 SPI2 W25Q64，待定需人确认） |
| `firmware/soundDog/Inc/flash_store_drv.h` | 新增 | 对外接口 |
| `firmware/soundDog/Src/main.c` | 修改 | 上电加载模版参数 |
| `firmware/soundDog/soundDog.ioc` | 修改（若选 W25Q64） | 使能 SPI2（SCK=PB10/MOSI=PC3/MISO=PC2/CS=PB12，pin_config.h 已定义） |
| A4 模版格式/交付物 | 依赖（只读） | 路径待定需人确认 |

### 5.2 调试要点
- 读回打印逐字节比对（§3.2 记录值）
- 复位/重启后确认加载分支（成功 or 回退默认，§3.3 记录）

### 5.3 测试入口
- SSCOM 观察参数加载与日志输出（对应 AC-01/AC-02）

## 6. 执行日志

| 时间 | 阶段 | 角色 | 摘要 | 遇阻 |
|---|---|---|---|---|
| | | | | |
