wumu-dot/SoundDog/docs/bugs/BUG-20260816-002-i2s-data-alignment.md

# I2S3 数据与 WS 槽存在 16 SCK 相位偏移，取数必须用高 16 位

- **Bug ID**：BUG-20260816-002
- **严重等级**：P1-严重（音频数据能收到但取数恒为 0，A1 验证无法通过）
- **发现日期**：2026-08-16
- **修复日期**：2026-08-16
- **当前状态**：✅ **已修复并验证**（v10，2026-08-28 复测通过，见文末）

## 现象描述

修复 BUG-20260816-001（DMA 溢出）后，DMA 数据正常流动、回调正常触发、RTOS 正常，但 `max=` 恒为 0。原始数据全为 `0x0000FFFF`（静音）或 `0xSSSSFFFF`（有数据时数据在高 16 位）。

## 复现步骤

1. 修复 BUG-20260816-001 后烧录
2. 串口看到 `[n] max=0` 恒为 0
3. 用诊断固件打印 DMA 原始数据：`RAW: 0000FFFF 0000FFFF ...`

## 根因分析

本工程 I2S3 的 32-bit 字边界与 INMP441 的 WS 槽存在 **16 SCK（半槽）相位偏移**：
- 帧结构 = `[16 位空闲/0][16 位音频]`
- 音频数据位于 32 位字的 **bits[15:0]（低 16 位）**，高 16 位恒为 0
- 初版修复误判数据在高 16 位（依据静音模式的 `0x0000FFFF` 推断），改为 `raw >> 16`，导致取数恒 0（max=0 一直查不到音频）；v9 修正为 `raw & 0xFFFF` 后能读到帧内容（max=32639 ≠ 0）

注：16 SCK 偏移的硬件成因未深究（疑为 INMP441 输出相位 vs STM32 Philips 采样的时序差），实测确定数据在低 16 位后软件补偿即可。

## 修复方案

`I2S_DRV_ExtractPCM` 最终采用 `(int16_t)(raw & 0xFFFF)`，取低 16 位作为 16-bit PCM。

## 影响文件

- `firmware/soundDog/Inc/i2s_drv.h`（I2S_DRV_ExtractPCM）

## 验证方式

- PB5 短接 3.3V 自证：`max=1`（全 1 帧 → 低 16 位 = 0xFFFF = -1 → 绝对值 1）✅ 接收链路确认正常
- 当前阻塞为麦克风本体（疑似超压事故损坏，SD 高阻无输出），换新 INMP441 后说话应见 `max` 随声音变化
- 若以后修正 WS 相位使数据回到 bits[31:8]，需把取数改回 `(int16_t)(raw >> 8)` 语义（i2s_drv.h 内注释已写明）

## 遗留

- 采样率实测约为设计的 2 倍（帧节奏 31 帧/250ms），SCK 实际值待逻辑分析仪确认；不影响 A1 max 验证，A2 FFT 前需核实

---

## 🔴 2026-08-28 复核：v9 修复有效性存疑（待 RAW dump 确诊）

**新证据**（新 INMP441 到货后的串口日志，FEAT-A1-01 阶段 4）：

| 场景 | max 值 | 十六进制 | 解读 |
|---|---|---|---|
| 坏麦克风接着（8/16 v9 时代） | 恒 32639 | 0x7F7F | 死 MEMS 恒定输出 |
| PB5 短接 3.3V（8/17 自证） | 恒 1 | — | 全 1 帧 → 0xFFFF → abs=1，链路自证 |
| **新麦克风接着（8/28）** | 31871~32767 波动 | 0x7C7F~0x7FFF | **吹气无变化** |

**关键疑点**：

1. **v9 从未验证过音频跟随性**——8/16 验证时麦克风 MEMS 已坏（数字接口输出恒定 0x7F7F），"max=32639≠0"只能证明"取到了非零值"，不能证明"取到了音频"。v9 的参考系（坏麦恒定输出）不可靠。
2. **0x7Fxx 模式跨两个麦克风复现**——坏麦恒 0x7F7F、新麦 0x7Fxx 波动，同一模式说明被提取的低 16 位是一个 ~0x7Fxx 的直流平台，不是音频信号。
3. **饱和掩盖机制自洽**——max 频繁顶到 32767（0x7FFF，int16 上限）：直流偏置吃掉动态范围后，即使音频混在低位段也已饱和，"有波动但吹气不变"与位段错位完全兼容。
4. **本文档自身矛盾**——"现象描述"称有数据时数据在高 16 位（`0xSSSSFFFF`），"修复方案"却取低 16 位；当时无法用坏麦分辨谁对谁错。

**确诊手段**（已就位）：2026-08-28 在 `main.c` 回调中加了 RAW dump 诊断打印（`I2S_DRV_GetRawFrame()`，编译通过 text=24000），打印每帧前 8 个原始 32-bit 字的十六进制。**吹气时观察哪 16 位在动即为音频所在位段**，据此修正 `I2S_DRV_ExtractPCM` 一行即可。

**注意事项**：
- 曾存在两份不同语义的 `i2s_drv.h`（`firmware/Core/Inc/` 为 `>>8` 旧版）；`firmware/Core/` 整树未参与编译，已于 2026-08-28 删除，唯一权威版本为 `firmware/soundDog/Inc/i2s_drv.h`。
- 若确诊音频在 bits[31:16]，改回 `(int16_t)(raw >> 16)`；若在 bits[31:8]（24-bit 对齐），用 `(int16_t)(raw >> 8)`。

---

## ✅ 2026-08-28 确诊与修复 v10（RAW dump 实证）

**诊断固件输出**（每帧打印前 8 个原始 32-bit 字，47 帧稳定复现）：

```
安静：0000FC0B 0000B97F 0000FFFF 0000FFFF 0000FC20 00007A7F 0000FFFF 0000FFFF
吹气：00008AFF 0000F07F 0000FFFF 0000FFFF 00008C3D 0000F27F 0000FFFF 0000FFFF
```

**确诊**：4 字周期模式，每 4 个 DMA 字含 1 个真实采样：

| 位置 | 值形 | 含义 |
|---|---|---|
| word[4k+0] | `0000_PPPP` | **真实音频**：PPPP = 24-bit 采样的高 16 位（bits[23:8]）→ 直接作 16-bit PCM |
| word[4k+1] | `0000_LL7F` | 同一采样低 8 位（LL）+ SD 悬空释放伪迹（0x7F） |
| word[4k+2..3] | `0000_FFFF` | INMP441 非活动槽 SD 悬空电平，伪数据 |

**吹气响应实证**：安静 word0 = `0x02xx`/`0xFCxx`（±600，底噪+INMP441 直流偏置）；吹气 = `0x8AFF`/`0xBB23`（±30000，91% FS）→ **麦克风声学通道正常**，A1-01 的 AC-04 失败根因即此提取 bug。

**v9 错误定性**：`& 0xFFFF` 掩码本身没错（对 word[4k] 恰好正确），错在**对全部 512 字提取**——3/4 样本是 `0xXX7F`（~32000 量级伪迹）和 `0xFFFF`（-1），max 统计被伪迹钉死在 ~32000，真实音频（安静 ±600）抬不动它 → "吹气 max 不变"。

**修复（v10）**：`extract_frame` 步进 4 只取 word[4k]，512 字 → 128 有效采样/帧；`audio_frame_t` 新增 `samples` 字段标明有效长度。

**有效采样率核准**：125 帧/s × 128 采样 = **16000 Hz，与设计完全一致**。旧注"采样率约 2 倍"系把 DMA 字当采样点计数的误判，已修订。

**验证状态**：🟡 编译通过（text=24016 data=108 bss=78512，无警告），待烧录后吹气复测——预期安静 max ≈ 数百~一千，吹气 max 冲上数万。

---

## ✅ 2026-08-28 17:58 复测通过（v10 修复验证）

**串口证据**（v10 固件，RAW dump 保留观察）：

| 状态 | max 序列（实测） | 判定 |
|---|---|---|
| 安静（52.0~57.5s） | 803, 2352, 858, 1048, 1147, 154, 372, 98, 301, 108, 189, 276, 285, 240, 240, 149, 622, 334, 248, 1383, 610, 1202 | 安静底噪 ≈ 百量级 ✅（修复前被伪迹钉死 ~32000） |
| 吹气（57.5~59.9s） | 31592, 32767, 30898, 32767, 31912, 32595, 32767, 20890, 7394, 6556, 4577 | 吹气冲满量程（最高 32767 = 100% FS）✅ |

**对照修复前**：安静/吹气 max 均恒 31871~32767 无差异 → 修复后安静 ~几百 vs 吹气 ~三万，**信噪分离清晰，AC-04（吹气 max 明显变化）达成**。

**结论**：BUG-20260816-002 关闭。A1-01 遗留的 AC-04 受限判定随之解除（根因即本 bug）。

**详细原理说明**：见 `docs/summary/BUG-002-I2S数据提取问题详解.md`。

**遗留清理项**：RAW dump 诊断代码（`I2S_DRV_GetRawFrame()` + main.c RAW 打印）为临时诊断用途，验证已完成，可在 A1-02 收尾时摘除或保留观察。
