wumu-dot/SoundDog/firmware/soundDog/App/main.c

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
/* Includes ------------------------------------------------------------------*/
#include "main.h"
#include "cmsis_os.h"
#include "dma.h"
#include "i2s.h"
#include "usart.h"
#include "gpio.h"

/* USER CODE BEGIN Includes */
#include "i2s_drv.h"
#include "rs485_drv.h"
#include "i2c.h"
#include "oled_drv.h"
#include "fft.h"
#include "spectrum.h"
#include "audio_pipe.h"
#include "FreeRTOS.h"
#include "queue.h"
#include "task.h"          /* P2-1: _write 内 taskENTER_CRITICAL 互斥（USART1 单写者） */
#include <stdio.h>
#include <string.h>
#include <math.h>
/* USER CODE END Includes */


/* USER CODE BEGIN PV */

/* ---- A2-02: 音频帧队列（ISR → 任务），参考 CSDN 频谱工程/CubeMX 音频 demo 模式 ---- */
/* frame_msg_t / audio_queue_get() 声明移至 audio_pipe.h（freertos.c 的 specTask 共用） */
static QueueHandle_t audio_q = NULL;   /* 必须先于 I2S_DRV_Init 创建！深度 4（~32ms 缓冲余量） */

/* ---- P2-1 复核修正（2026-09-17，审查报告第三节）：USART1 写互斥改用 osMutex ----
 * 原 taskENTER_CRITICAL 包阻塞式 HAL_UART_Transmit 会屏蔽 SysTick/I2S/USART3/SPI3
 * 中断：RX 探针单行~778B≈67ms，tick 冻结 + I2S DMA 溢出丢帧风险 + 临界区内
 * HAL_GetTick() 被屏蔽致 100ms 超时永不成立→_write 死循环。
 * 改为互斥信号量：只做任务级串行化、不屏蔽任何中断（审查官建议首选）。
 * NULL=调度器启动前 boot 期：此时单线程无并发，直接发送（不拿锁→无自旋死锁）；
 * 非 NULL=运行期：osMutexAcquire/Release 串行化所有走 printf 的 USART1 写。
 * 创建点在 osKernelInitialize() 之后、osKernelStart() 之前（boot printf 已先执行完毕）。 */
static osMutexId_t g_uart1_mutex = NULL;

/* ---- 音频帧回调（在 DMA ISR 中调用，务必短小！）----
 * A2-02 架构：只做拷贝+入队（~10µs），FFT 计算移到 specTask（CPU 预算 3%）。
 * 串口修复（2026-08-29）：原 ISR 内 printf（max 统计/首帧提示）与任务侧
 * printf 并发调用 HAL_UART_Transmit（不可重入）→ 输出交错 + HAL 状态风险。
 * 现全部打印移至 specTask（运行期唯一打印者）；max 统计同样移过去，
 * 判据不变（AC-02：吹气 → max 明显变化）。 */
static void audio_frame_cb(const audio_frame_t *frame)
{
    frame_msg_t msg;
    memcpy(msg.pcm, frame->pcm, sizeof(msg.pcm));
    msg.frame_index = frame->frame_index;
    /* 满时丢弃本帧（音频流允许丢帧，不阻塞 ISR） */
    /* P2-2（审查缺陷）：传 &hpw + portYIELD_FROM_ISR，被唤醒任务随 ISR 返回立即抢占，
     * 而非等下个 tick（1ms）——减少 specTask 最坏唤醒延迟。 */
    BaseType_t xHigherPriorityTaskWoken = pdFALSE;
    xQueueSendFromISR(audio_q, &msg, &xHigherPriorityTaskWoken);
    portYIELD_FROM_ISR(xHigherPriorityTaskWoken);
}

/* 任务侧取队列的句柄暴露（freertos.c 的 defaultTask 使用） */
QueueHandle_t audio_queue_get(void)
{
    return audio_q;
}

/* USER CODE END PV */

void SystemClock_Config(void);
void MX_FREERTOS_Init(void);
/* USER CODE BEGIN 0 */

int _write(int fd, char *ptr, int len)
{
    /* P2-1（审查缺陷→复核修正 2026-09-17）：USART1 单写者（BUG-20260829-003）——
     * specTask 与 MBSlavePollTask 并发调 HAL_UART_Transmit（不可重入）→ 输出交错/HAL 竞争。
     * 修正：以互斥信号量 g_uart1_mutex 串行化（不屏蔽任何中断，规避原临界区
     * tick 冻结/I2S 打断/超时死循环——审查报告第三节）。NULL=boot 期（调度器未启动、
     * 单线程无并发）直接发送，不拿锁，从根上避免调度器未启动时的自旋。 */
    if (g_uart1_mutex != NULL) {
        (void)osMutexAcquire(g_uart1_mutex, osWaitForever);
        HAL_UART_Transmit(&huart1, (uint8_t *)ptr, (uint16_t)len, 100);
        (void)osMutexRelease(g_uart1_mutex);
    } else {
        HAL_UART_Transmit(&huart1, (uint8_t *)ptr, (uint16_t)len, 100);
    }
    return len;
}

/* ---- FEAT-A2-01: FFT 自测（1kHz 正弦，boot 后跑一次）----
 * 判据（§3.2）：peak bin = 16（1000Hz / 62.5Hz），幅度有限值，无 NaN。
 * 临时验证代码，A2-01 验收后由 A2-02 换成真音频通路。
 */
static void fft_selftest(void)
{
    fft_ctx_t ctx;
    static float32_t in[FFT_LEN];
    static float32_t mag[FFT_BINS];

    if (fft_init(&ctx) != 0) {
        printf("FFT init FAIL\r\n");
        return;
    }

    /* 合成 1kHz 正弦：x[n] = 0.5*sin(2*pi*1000*n/16000) */
    for (int n = 0; n < FFT_LEN; n++) {
        in[n] = 0.5f * sinf(2.0f * 3.14159265f * 1000.0f * (float)n / 16000.0f);
    }

    if (fft_run(&ctx, in, mag) != 0) {
        printf("FFT run FAIL\r\n");
        return;
    }

    /* 找峰值 bin（跳过 DC bin0） */
    int peak = 1;
    float32_t peak_val = mag[1];
    for (int k = 2; k < FFT_BINS; k++) {
        if (mag[k] > peak_val) { peak_val = mag[k]; peak = k; }
    }

    /* 整数化打印（nano.specs 无 %f）：mag*10 显示，mag=640 即 64.0 */
    printf("FFT selftest: peak bin=%d (%u Hz) mag=%u/10 DC=%u/10\r\n",
           peak,
           (unsigned)(peak * 62.5f + 0.5f),
           (unsigned)(peak_val * 10.0f + 0.5f),
           (unsigned)(mag[0] * 10.0f + 0.5f));
    /* 期望输出：peak bin=16 (1000 Hz) mag=640/10 DC=0/10 */
}
/* USER CODE END 0 */

/**
  * @brief  The application entry point.
  * @retval int
  */
int main(void)
{

  /* MCU Configuration--------------------------------------------------------*/

  /* Reset of all peripherals, Initializes the Flash interface and the Systick. */
  HAL_Init();

  /* USER CODE BEGIN Init */
  /* P1-3（复核更正 2026-09-17）：显式重申 NVIC Priority Group 4（4 位抢占 / 0 位子优先级）。
   * 复核确认：此配置实为幂等重申——HAL_Init() 内部（stm32f4xx_hal.c:173）已调用
   * HAL_NVIC_SetPriorityGrouping(NVIC_PRIORITYGROUP_4)，分组自复位起就显式成立。
   * 此处保留作为显式 enforce，防后续改动分组时 DMA1_Stream2/USART3/SPI3 的优先级 5
   * 语义静默改变（触及 configLIBRARY_MAX_SYSCALL_INTERRUPT_PRIORITY=5「0~4 禁调 FromISR」
   * 红线），与 HAL_Init() 保持一致，防改动漂移。 */
  HAL_NVIC_SetPriorityGrouping(NVIC_PRIORITYGROUP_4);
  /* USER CODE END Init */

  /* Configure the system clock */
  SystemClock_Config();

  /* Initialize all configured peripherals */
  MX_GPIO_Init();
  MX_DMA_Init();
  MX_I2S3_Init();
  MX_USART1_UART_Init();
  /* USER CODE BEGIN 2 */

/* 点亮绿灯 = 程序已经跑到 main 的 USER CODE 2 区 */
HAL_GPIO_WritePin(LED_STATUS_GPIO_Port, LED_STATUS_Pin, GPIO_PIN_SET);

/* 先打印，确认 printf 和串口工作 */
printf("SoundDog boot OK, SYSCLK=%lu\r\n", HAL_RCC_GetSysClockFreq());

/* FEAT-A2-03: I2C1 + OLED 初始化（自检画面 ~1s 后由 displayTask 切柱状图）。
 * ⚠️ 顺序关键（BUG-20260829-006）：必须放在 xQueueCreate 等任何 FreeRTOS
 * 内核调用之前——调度器启动前内核调用会把 BASEPRI 抬到 0x50 不落下
 * （uxCriticalNesting 哨兵值 0xaaaaaaaa 机制），SysTick 被屏蔽，
 * OLED_DRV_Init 里的 HAL_Delay 会死循环（P0 黑屏真根因）。
 * boot 三行契约（boot OK / I2S_DRV_Init ret=0 / I2S DMA started）相对
 * 顺序不变，本块打印插在第 1 行之后，按序前缀匹配判据不受影响。 */
{
    MX_I2C1_Init();
    /* BUG 排查（黑屏全 NACK）：I2C 总线扫描 0x08~0x77，打印所有应答地址。
     * 正常应见 0x3C（或 0x3D 若模块焊盘反）。若一个都没有 → 硬件层
     * （接线反/松线/无上拉/模块坏）。扫描完继续 OLED 初始化不影响。 */
    printf("I2C scan:");
    for (uint8_t a = 0x08; a <= 0x77; a++) {
        HAL_StatusTypeDef st = HAL_I2C_IsDeviceReady(&hi2c1,
                (uint16_t)(a << 1), 2, 10);
        if (st == HAL_OK) { printf(" 0x%02X", a); }
    }
    printf(" (end)\r\n");
    int32_t oled_err = OLED_DRV_Init();
    if (oled_err == 0) {
        printf("OLED init OK (selftest grid)\r\n");
    } else {
        printf("OLED init FAIL err=%ld (check wiring/addr 0x3C)\r\n", (long)oled_err);
    }
}

/* FEAT-A2-02: 真音频通路初始化（FFT 实例 + 汉明窗 + 帧队列）
 * 顺序关键：队列必须先于 I2S_DRV_Init 创建，否则 DMA 起流后
 * 回调里 xQueueSendFromISR(NULL, ...) 直接硬错误。
 * ⚠️ 此后到 osKernelStart 之间 BASEPRI=0x50（见上方 BUG-006 注释），
 * 禁止插入任何 HAL_Delay/带超时轮询等依赖 SysTick 的调用 */
{
    /* fft_ctx_get 共享实例初始化（自测的局部 ctx 保留独立，互不干扰） */
    if (fft_init(fft_ctx_get()) != 0) {
        printf("spec init FAIL (fft)\r\n");
    }
    spec_init();
    audio_q = xQueueCreate(4, sizeof(frame_msg_t));
    if (audio_q == NULL) {   /* 堆耗尽防御（评审 Minor#4）：SpecTask 侧有 NULL
                              * 防御，ISR 侧没有——NULL 队列会让首个 DMA IRQ 硬错误 */
        printf("audio queue create FAIL\r\n");
        Error_Handler();
    }
    printf("A2-02: spectrum path ready\r\n");
}

/* FEAT-A2-01: FFT 自测（1kHz 正弦 → 期望 peak bin=16），AC-10 回归保留 */
fft_selftest();

/* 启动 I2S DMA 采集（回调只做拷贝+入队，FFT 在 freertos.c 的 specTask 消费） */
HAL_StatusTypeDef ret = I2S_DRV_Init(&hi2s3, audio_frame_cb);
printf("I2S_DRV_Init ret=%d (0=HAL_OK)\r\n", ret);

/* A5-01: USART3 + RS485 初始化 */
  MX_USART3_UART_Init();
  RS485_Init();

  /* RS485 回环自测已移入 freertos.c 的 RS485LoopTask —— ⛔ 不要搬回这里：
   * 本区在 osKernelStart() 前、BASEPRI=0x50，SysTick 被 FreeRTOS 屏蔽
   * ⇒ HAL_GetTick() 冻结 ⇒ HAL_UART_Receive 的超时形同虚设 ⇒ 死等卡死
   * （与 BUG-20260829-006 的 OLED HAL_Delay 同根）。
   * 完整机理与证据链见 docs/bugs/BUG-20260902-001。死代码已于 2026-11-06 删除。 */

  /* USER CODE END 2 */

  /* Init scheduler */
  osKernelInitialize();  /* Call init function for freertos objects (in cmsis_os2.c) */
  MX_FREERTOS_Init();

  /* P2-1 复核修正（2026-09-17）：USART1 写互斥量在核对象就绪后创建。
   * 此段之前的所有 boot printf 走 g_uart1_mutex==NULL 无锁分支（单线程，无并发）；
   * 之后运行期所有 printf 经互斥串行化。osMutexNew 在调度器未启动时允许调用。 */
  g_uart1_mutex = osMutexNew(NULL);

  /* Start scheduler */
  osKernelStart();

  /* We should never get here as control is now taken by the scheduler */

  /* Infinite loop */
  /* USER CODE BEGIN WHILE */
  while (1)
  {
    /* USER CODE END WHILE */

    /* USER CODE BEGIN 3 */
  }
  /* USER CODE END 3 */
}

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
/**
  * @brief  Period elapsed callback in non blocking mode
  * @note   This function is called  when TIM7 interrupt took place, inside
  * HAL_TIM_IRQHandler(). It makes a direct call to HAL_IncTick() to increment
  * a global variable "uwTick" used as application time base.
  * @param  htim : TIM handle
  * @retval None
  */
void HAL_TIM_PeriodElapsedCallback(TIM_HandleTypeDef *htim)
{
  if (htim->Instance == TIM7)
  {
    HAL_IncTick();
  }
}

/**
  * @brief  This function is executed in case of error occurrence.
  * @retval None
  */
void Error_Handler(void)
{
  /* USER CODE BEGIN Error_Handler_Debug */
  /* User can add his own implementation to report the HAL error return state */
  __disable_irq();
  while (1)
  {
  }
  /* USER CODE END Error_Handler_Debug */
}
#ifdef USE_FULL_ASSERT
/**
  * @brief  Reports the name of the source file and the source line number
  *         where the assert_param error has occurred.
  * @param  file: pointer to the source file name
  * @param  line: assert_param error line source number
  * @retval None
  */
void assert_failed(uint8_t *file, uint32_t line)
{
  /* USER CODE BEGIN 6 */
  /* User can add his own implementation to report the file name and line number,
     ex: printf("Wrong parameters value: file %s on line %d\r\n", file, line) */
  /* USER CODE END 6 */
}
#endif /* USE_FULL_ASSERT */
