wumu-dot/SoundDog/firmware/soundDog/Inc/main.h

#define BUZZER_Pin GPIO_PIN_6
#define BUZZER_GPIO_Port GPIOE
#define LED_ALARM_Pin GPIO_PIN_0
#define LED_ALARM_GPIO_Port GPIOB
#define LED_STATUS_Pin GPIO_PIN_1
#define LED_STATUS_GPIO_Port GPIOB
