wumu-dot/SoundDog/firmware/soundDog/BSP/mel.c

/**
 * @file    mel.c
 * @brief   FEAT-A3-02：Mel 滤波器组实现（512 rfft + 幅度谱 + 稀疏三角滤波）
 *
 * 架构（设计定稿 §1.5）：纯 BSP 模块，四层架构第 2 层；
 * 输入来自 mfcc_last_frame()（A3-01），输出供 A3-03（Log+DCT）与串口 MEL 行。
 *
 * R27 三源坑防御落地（附 3 坑清单，行号见 FEAT 文档）：
 *   坑1: rfft 打包输出解包——照抄官方 arm_mfcc_f32（v1.14.4 L113-115）；
 *   坑2: 幅度谱长度 257 = fftLen/2+1（显式写，防按 256 写漏 Nyquist）；
 *   坑4: 三表全 static const（.rodata，防表进 .data 双耗 RAM）；
 *   坑5: 表由 gen_mel_table.py --c 整块生成，禁止手改（1kHz→带 7 预测对照）；
 *   坑7: 输入立即拷贝（last_frame 静态缓冲跨迭代覆写）。
 * 全程 float32 域计算（坑 6：无符号陷阱教训）。
 */
#include "mel.h"
#include <string.h>

/* ==== 稀疏 Mel 表（gen_mel_table.py 生成，2026-08-30）====
 * 算法复刻 CMSIS-DSP v1.14.4 Scripts/mfccdata.py melFilterMatrix()：
 * mels = linspace(mel(300), mel(8000), 34)，HTK 三角滤波，非零段稀疏打包。
 * 关键对照值（表错即对不上）：filtPos[0]=10（bin10=312.5Hz 首个非零）、
 * 末带终点 bin256=8000Hz 精确、1kHz→bin32→峰值带 7。 */
static const uint32_t mel_filt_pos[32] = {10,12,15,17,20,23,26,29,32,36,40,44,48,53,58,64,69,76,82,89,97,105,113,123,132,143,154,166,179,192,207,222};
static const uint32_t mel_filt_len[32] = {5,5,5,6,6,6,6,7,8,8,8,9,10,11,11,12,13,13,15,16,16,18,19,20,22,23,25,26,28,30,32,34};
static const float32_t mel_coefs[473] = {
  0.189496971f, 0.653189510f, 0.896798211f, 0.459682057f, 0.034743439f, 0.103201789f, 0.540317943f, 0.965256561f,
  0.621322201f, 0.218810458f, 0.378677799f, 0.781189542f, 0.826647216f, 0.444313669f, 0.071329074f, 0.173352784f,
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
};

/* ==== 内部状态（全静态：大数组不上任务栈——ST 社区 hardfault 头号原因） ==== */

/* 独立 512 点实例：fft.c 是 256 点且 fft_run 单消费者（设计 §1.5 决策）。
 * f32 rfft 无全局状态（状态全在实例结构体内），与 fft.c 互不污染。 */
static arm_rfft_fast_instance_f32 s_rfft;

static float32_t s_in[MEL_FFT_LEN];              /* 512：400 样 + 112 零 */
static float32_t s_tmp[MEL_FFT_LEN + 2u];        /* rfft 输出 + Nyquist 解包位（514） */
static float32_t s_mag[(MEL_FFT_LEN / 2u) + 1u]; /* 257 幅度谱（坑 2：+1 含 Nyquist） */

static uint8_t s_inited = 0u;

int mel_init(void)
{
  if (s_inited != 0u) { return 0; }                    /* 幂等 */
  arm_status st = arm_rfft_fast_init_f32(&s_rfft, MEL_FFT_LEN);
  if (st != ARM_MATH_SUCCESS) { return -1; }
  s_inited = 1u;
  return 0;
}

int mel_process(const float32_t *frame400, float32_t *mel_out)
{
  if ((frame400 == NULL) || (mel_out == NULL) || (s_inited == 0u)) {
    return -1;
  }

  /* 坑 7：立即拷贝（mfcc_last_frame 返回静态缓冲，下一次 mfcc_feed 覆写） */
  memcpy(s_in, frame400, (size_t)MEL_FRAME_IN * sizeof(float32_t));
  memset(&s_in[MEL_FRAME_IN], 0,
         (size_t)(MEL_FFT_LEN - MEL_FRAME_IN) * sizeof(float32_t));

  arm_rfft_fast_f32(&s_rfft, s_in, s_tmp, 0u);

  /* 坑 1：rfft 打包格式解包——照抄官方 arm_mfcc_f32（v1.14.4 L113-115）。
   * 打包输出：[0]=DC, [1]=Nyquist, [2k]/[2k+1]=bin k 的 re/im；
   * 解包为 257 个复数排布：Nyquist 搬至 [fftLen]（bin 256 实部位），
   * [1]（DC 虚部位）清零。不做此步 → bin1/Nyquist 错 → 低频带与带 31 静默数值错。 */
  s_tmp[MEL_FFT_LEN]        = s_tmp[1];
  s_tmp[MEL_FFT_LEN + 1u]   = 0.0f;
  s_tmp[1]                  = 0.0f;

  /* 幅度谱口径（官方 #279/#338 印证）：257 点，显式 +1 防按 256 写漏 Nyquist */
  arm_cmplx_mag_f32(s_tmp, s_mag, (MEL_FFT_LEN / 2u) + 1u);

  /* 稀疏三角滤波：与官方 arm_mfcc_f32 L120-131 同构（off 累加） */
  uint32_t off = 0u;
  for (uint32_t i = 0u; i < MEL_NB_BANDS; i++) {
    arm_dot_prod_f32(&s_mag[mel_filt_pos[i]], &mel_coefs[off],
                     (uint32_t)mel_filt_len[i], &mel_out[i]);
    off += mel_filt_len[i];
  }
  return 0;
}
