wumu-dot/SoundDog/firmware/soundDog/BSP/mfcc_dct.c

/**
 * @file    mfcc_dct.c
 * @brief   FEAT-A3-03：Log 能量 + DCT-II 实现（32 维 Mel → 13 维 MFCC）
 *
 * 算法（设计定稿 §1.5，全部官方口径除归一化位置外）：
 *   ① Mel 域 absmax 归一化（音量鲁棒；偏离官方 FFT 前时域归一化位置——
 *      官方 arm_mfcc_f32.c L84-87 对帧 absmax，我们帧已加窗不能照搬，
 *      A4-01 模版生成必须复刻本位置）
 *   ② +1e-6 偏移（官方 L134 字面值）→ ln（arm_vlog_f32，官方 L135 口径）
 *   ③ 13×32 DCT-II 矩阵乘（行主序 416 系数，自写循环——对策 B：
 *      arm_mat_vec_mult_f32 未 vendored，不引 MatrixFunctions 依赖链）
 *
 * 表由 scripts/gen_dct_table.py --c 生成（算法逐字对齐官方 v1.14.4
 * Scripts/mfccdata.py dctMatrix()），**禁止手改**（坑 5）。
 * 归一化 sqrt(2/32)=0.25 精确值；k=0 行全 0.25 常数（"almost
 * orthogonal" 口径：k=0 行范数²=2，TF 文档原话，Issue #54 背书）。
 */
#include "mfcc_dct.h"
#include "mel.h"     /* MEL_NB_BANDS（编译期耦合检查） */

/* ---- DCT-II 系数表（416 = 13×32，行主序；gen_dct_table.py 生成） ---- */
static const float32_t s_dct_coefs[MFCC_DCT_OUT * MFCC_DCT_IN] = {
  0.250000000f, 0.250000000f, 0.250000000f, 0.250000000f, 0.250000000f, 0.250000000f, 0.250000000f, 0.250000000f,
  0.250000000f, 0.250000000f, 0.250000000f, 0.250000000f, 0.250000000f, 0.250000000f, 0.250000000f, 0.250000000f,
  0.250000000f, 0.250000000f, 0.250000000f, 0.250000000f, 0.250000000f, 0.250000000f, 0.250000000f, 0.250000000f,
  0.250000000f, 0.250000000f, 0.250000000f, 0.250000000f, 0.250000000f, 0.250000000f, 0.250000000f, 0.250000000f,
  0.249698864f, 0.247294127f, 0.242507813f, 0.235386016f, 0.225997323f, 0.214432153f, 0.200801883f, 0.185237781f,
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
               "mfcc_dct input must equal mel band count");

/* log 域中间缓冲（非重入来源；仅 specTask 单消费者） */
static float32_t s_logmel[MFCC_DCT_IN];

/* ---- 接口实现 ---- */

int mfcc_dct_process(const float32_t *mel32, float32_t *mfcc13)
{
  if ((mel32 == NULL) || (mfcc13 == NULL)) { return -1; }

  /* ① absmax 归一化（音量鲁棒；Mel 能量为幅度谱口径恒 ≥0）
   * 坑 2 防护：max ≤ 1e-12（静音帧全 0）跳过归一化直接走 +1e-6 地板，
   * 输出确定值（c0=-11000 常数行、其余≈0）而非 NaN。 */
  float32_t vmax = 0.0f;
  for (uint32_t i = 0u; i < MFCC_DCT_IN; i++) {
    if (mel32[i] > vmax) { vmax = mel32[i]; }
  }
  if (vmax > 1.0e-12f) {
    for (uint32_t i = 0u; i < MFCC_DCT_IN; i++) {
      s_logmel[i] = mel32[i] / vmax;
    }
  } else {
    for (uint32_t i = 0u; i < MFCC_DCT_IN; i++) {
      s_logmel[i] = mel32[i];
    }
  }

  /* ② +1e-6 偏移（官方 L134 字面值）→ ln（官方 L135 口径）。
   * 两 API 文件在 vendored 树（FastMath/BasicMath），Makefile 已登记。 */
  arm_offset_f32(s_logmel, 1.0e-6f, s_logmel, MFCC_DCT_IN);
  arm_vlog_f32(s_logmel, s_logmel, MFCC_DCT_IN);

  /* ③ 13×32 矩阵乘（行主序 416 MAC，自写循环——对策 B） */
  for (uint32_t k = 0u; k < MFCC_DCT_OUT; k++) {
    float32_t acc = 0.0f;
    const float32_t *row = &s_dct_coefs[k * MFCC_DCT_IN];
    for (uint32_t j = 0u; j < MFCC_DCT_IN; j++) {
      acc += row[j] * s_logmel[j];
    }
    mfcc13[k] = acc;
  }

  return 0;
}
