wumu-dot/SoundDog/firmware/soundDog/BSP/model_normal.h

#ifndef MODEL_NORMAL_H
#define MODEL_NORMAL_H

#include "arm_math.h"

#define MODEL_NORMAL_K  16
#define MODEL_NORMAL_D  13

extern const float32_t model_normal[MODEL_NORMAL_K][MODEL_NORMAL_D];

#endif /* MODEL_NORMAL_H */
