wumu-dot/SoundDog/(commit log)

2026-07-20 Init SoundDog with EmbedSpec foundation: CLAUDE.md + CI + FEAT + Bug + Debug
    Project: STM32F407ZGT6 audio anomaly detection node (MFCC + RS485).
    EmbedSpec applied: DOC-STATE, R0-R20 rules, ci_local.sh, check-doc-drift.sh,
    FEAT/Bug templates, GDB/OpenOCD/Flash skill scripts.
    [i2s_drv.c, i2s_drv.h]
2026-08-16 SoundDog A1: I2S3+INMP441 audio capture baseline, handover docs
    - firmware/soundDog: CubeMX project (I2S3 Master RX/32bit/16kHz PLLI2S, DMA1_Stream2 double-buffer i2s_drv, FreeRTOS CMSIS-RTOS_v2, TIM7 HAL tick, USART1 printf debug, JTAG release in HAL_MspInit)
    - I2S clock: HSE 8M -> PLLM(8) -> PLLI2S N=256 R=5 -> 51.2MHz -> I2SDIV=25 -> SCK 1.024MHz -> Fs 16kHz (0% error); doc formulas corrected from I2SDIV=50 to 25
    - docs: HANDOFF.md handover (new board checklist, power red line, pit list), 5 bug records, bug_shturl 8 entries, INDEX/CLAUDE.md sync
    - scripts: build/flash/ISP-recovery bat+sh, DOC-STATE drift check rework, openocd swd speed 500
    [i2s_drv.c, i2s_drv.h, main.c, main.h, pin_config.h]
2026-08-16 Fix P0: I2S DMA size overflow corrupting UART handle and FreeRTOS globals (BUG-20260816-001)
    Root cause: DMA configured 32-bit wide (PSIZE=WORD, CubeMX default) counts NDTR in 32-bit words, but HAL_I2S_Receive_DMA doubles Size for 32-bit format (half-word mental model). Passing I2S_FULL_BUF_SIZE(1024) -> NDTR=2048 words = 8192B, overflowing dma_buf(4096B) by 4096B from ~32ms after start, trashing huart1 and pxReadyTasksLists (verified via OpenOCD: HardFault in vListInsertEnd, BFAR=DCRDR).
    Fix: pass I2S_HALF_BUF_SIZE(512) -> NDTR=1024 words = 4096B exactly; half-transfer fires at 512 samples matching the double-buffer design.
    Also: restored main.c/freertos.c/stm32f4xx_it.c diagnostic scaffo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
    [i2s_drv.c]
2026-08-16 Fix P1: I2S data alignment (16SCK WS offset) - extract high 16 bits (BUG-20260816-002)
    Root cause: I2S3 32-bit frame boundary is 16 SCK off the INMP441 WS slot; frame = [16b audio][16b idle 0xFFFF], audio in bits[31:16]. Original extraction (raw>>8>>8) straddled data-low-byte + idle -> always 0.
    Fix: I2S_DRV_ExtractPCM = (int16_t)(raw >> 16).
    Also: clear I2S OVR flag in DMA callbacks (prevents RX stall); removed diagnostic scaffolding (RAW dump, HardFault printer, step markers); added BUG-20260816-002 doc + shturl + INDEX entries.
    Note: mic suspected dead from earlier overvoltage (outputs constant 0); firmware verified ready pending new mic.
    [i2s_drv.c, i2s_drv.h]
2026-08-16 Fix extraction direction: audio in low 16 bits (raw & 0xFFFF), RX chain verified via PB5 short test
    - Correct BUG-20260816-002: initial fix (raw>>16) was based on misreading the silence pattern; actual audio is in bits[15:0]. v9: (int16_t)(raw & 0xFFFF) -> max reads 32639 (real frame content) instead of constant 0.
    - PB5-to-3.3V self-test confirms RX chain (I2S+DMA+extraction) 100% working: max=1.
    - Remaining blocker is the INMP441 unit itself (suspected dead from the earlier 5V overvoltage; SD high-Z, no output).
    - Keep OVR robustness fixes: minimal SPI3 IRQ (clear OVR only, no HAL state machine), RXNEIE forced off, robust OVR clear loop in DMA callbacks.
    - Removed diagnostic scaffolding (R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
    [i2s_drv.c, i2s_drv.h]
2026-08-16 Add README: project overview, current status, fixed bugs, quick start
2026-08-16 docs: FEAT A1~A8 全部计划细化为傻瓜式操作单（含规格/索引/维护地图）
2026-08-16 docs: A8 GUI 改用 matplotlib+tkinter（PySide6 6.11 DLL 失败放弃）；记录环境实测与 pyserial 已装
2026-08-16 chore: 清理 .pip-tmp 残留并加入 .gitignore
2026-08-29 feat(A2-03): OLED频谱显示收官 + App/BSP架构迁移 + 6 bug闭环归档
    固件（A2 主线全线打通）:
    - 新增 BSP/oled_drv.c/h：SSD1306 128x64 驱动（1KB framebuffer、页式刷新、4ilo Mem_Write 分笔传输 + F1 工程实测电气参数，R28）；含全屏白2s诊断期
    - 新增 Src/i2c.c + Inc/i2c.h：I2C1 400kHz 配置层（PB6/PB7）
    - vendored 官方 stm32f4xx_hal_i2c{,_ex} 4 文件并启用 HAL_I2C 模块
    - freertos.c：DisplayTask（200ms）；OLED err 打印并入 specTask（USART1 单写者）
    - oled_drv 柱高钳位防无符号下溢（评审 Important）；注释两处修正
    - main.c：OLED init 上移至 xQueueCreate 前，修复 BUG-006（FreeRTOS 预调度器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
    [audio_pipe.h, fft.c, fft.h, i2c.c, i2c.h, i2s_drv.c, i2s_drv.h, main.c]
2026-08-29 feat(A2-04): 串口BANDS频谱输出收官 + BUG-20260830-001调试器停机事故归档
    固件（A2-04 五阶段全绿）:
    - freertos.c specTask 新增 BANDS 行：一行 32 个 ×100 整数、逗号分隔、
    `BANDS ` 前缀（A8-02 上位机按前缀过滤）、tick 差值 200ms 节流；
    静态 256B 行缓冲（printf 栈风险规避）+ 截断保护 + 整帧 Transmit；
    USART1 单写者规则保持（BUG-003 教训）
    - 新增 usart.h include（huart1 声明来源）
    - 编译 text=158316 0 error 无新增警告
    BUG-20260830-001（P0 流程事故，非固件缺陷）:
    - gdb connect 即 halt、detach 不恢复 → 板子停机被误诊"挂死/自发复位"
    （含此前麦克风日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
2026-08-29 chore(A2): 父FEAT收官归档——FFT频谱可视化全线打通
    - FEAT-A2 父文档：状态转 ✅已完成；项目表四子全 🟢 回填；
    DoD 三条全勾（四子均经 Review/与 INDEX 一致/教训已提炼）；
    §4 下一步指向 A3（MFCC，输入接口已就绪）；执行日志 4 行补全
    - INDEX.md：父 FEAT-A2 转 🟢
    - HANDOFF.md §七：A2 收官状态 + 待办重排（A3 置顶，
    含 unsigned 陷阱/fft_run 串行化预警；OLED 从待办移除）
    A2 主线终态：麦克风 → I2S DMA → FreeRTOS 队列 → 256 点 FFT 32 频带
    → OLED 柱状图 + 串口 BANDS 行双输出；8 bug 闭环、R28 规则、
    oocd_probe.ps1 工具沉淀
2026-08-29 feat(A3-01): 预加重分帧汉明窗收官 + 规则集v2分层重构
    BSP/mfcc.c/h：流式预加重(x_prev跨块)+400环形缓冲逐样出帧(128/160不通约)+arm_cos_f32运行期窗表；specTask旁路挂接(方案A)，A2链路零回归；验证：f精确+100/s零漂移、1kHz扰动e量级响应、boot三行回归；rules.md v2：L1/L2/L3分层+冲突仲裁+阶段上下文+R29设计四件套；build_and_flash.bat烧录前自动清残留openocd
2026-08-29 chore(rules): v2.1 收官——强制等级标签+§0更新责任+R29模板锚点+R19 pre-commit钩子（双向实测通过）
2026-08-30 fix(A3-01): 评审回绕死锁修复收官 + 阶段4实测证据补档 + 7个bat LF行尾修复
    [mfcc.c, mfcc.h, serial_capture.py]
2026-08-30 chore(git): .gitattributes 行尾强制（*.bat/ps1 检出 CRLF）——根治 bat LF 解析炸裂复发路径
2026-08-30 docs(A3-02): R27升级预研三源(源码副作用+Issue区+坑清单交付物) + CMSIS-DSP #279官方背书400补零/幅度谱口径 + A3-02阶段2设计定稿(八节+R29四件套+坑清单) + gen_mel_table表生成器
    [gen_mel_table.py]
2026-08-30 docs(INDEX): A3-02 🔴→🟡 阶段2设计定稿（R2 同步）
2026-08-30 feat(A3-02): Mel滤波器组收官——1kHz→b=7精确命中 + 评审I-1/I-2修复闭环
    [mel.c, mel.h]
2026-08-30 fix(A3-02): 帧率口径修正——轮询跳帧改mfcc帧回调逐帧消费(100帧/s规整10ms网格) + 评审M-1顺手闭环
    [mfcc.c, mfcc.h]
2026-08-30 chore(hooks): R27预研三源强制钩子——pre-commit串接R19+R27双检查
    - 新增 scripts/check_r27_research.ps1：检测staged代码新增HEAD未用过的arm_* API，
    要求同提交文档含三源证据标记（源码/issue/坑+预防），缺任一拦截
    - check_r19_zone.ps1 安装器升级：-InstallHook 一条命令装双检查
    - rules.md：R27加[MUST]标签；§6登记钩子条目+Edit工具剥BOM二次实证
    - 双向实测三案例：拦截/复用放行/证据放行（2026-08-30）
2026-08-30 feat(A3-03): Log能量+DCT-II收官——32维Mel→13维MFCC + R23独立评审四项修复
    - 新增 BSP/mfcc_dct.c/h：Mel域absmax归一化(音量不变性实证) + arm_offset_f32(+1e-6)
    + arm_vlog_f32(ln) + 13×32 DCT-II矩阵416-MAC自写循环(对策B)；
    静音地板防护(max≤1e-12) + _Static_assert维度耦合
    - 416系数表由gen_dct_table.py生成整块粘贴(官方mfccdata.py dctMatrix复刻，
    正交性almost-orthogonal口径判据PASS)
    - freertos.c：mel_frame_cb串接mfcc_dct_process(逐帧100帧/s) + MFCC13打印行
    (1s节流×100定标，I-1同款钳位，评审M-1补s_mel_ok门控)
    - Makefile登记3源(BUG-002)；坑8新增：arm_offset_f32参数序(pSrc,offset,pDs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
    [a3_03_pc_check.py, gen_dct_table.py, mfcc_dct.c, mfcc_dct.h]
2026-08-30 docs(A3-03): 归因修正——文档覆写4次初判编辑器缓冲不成立，改为subagent/TRAE内部机制(无法100%自证)
2026-08-30 feat(A3-04): 特征向量验证收官——三态证据链+e钳位清偿 + A3父FEAT收官(4子FEAT全绿)
2026-08-31 feat(A4-01): 离线模版生成收官——600帧K-means(K=16)正常模版C常量表
    - collect_mfcc.py: 串口采集MFCC13(前缀过滤/×100还原/维数校验/600帧自停), 实采600帧0丢弃604s
    - kmeans_model.py: KMeans(K=16, seed=42, n_init=10) + 空簇/地板簇检查 + model_normal.c/h导出(纯ASCII无BOM)
    - model_normal.c/h: 16×13 float32常量表(MODEL_NORMAL_K/D接口, A4-02消费; 无引用时被gc-sections丢弃, 引用后+832B)
    - Makefile: C_SOURCES登记BSP/model_normal.c(BUG-002教训)
    - --check复跑逐字节一致(阶段5修复日期敏感缺陷, 跨日复跑不误报)
    - R23独立评审2项重要问题修复闭环(--check日期敏感 + 832B进Flash记录失实证伪)
    - 1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
    [mfcc_normal_600.csv]
2026-08-31 chore: markdown 格式化噪声一次性别归档（外部工具自动重排）
    - 12 份文档: 表格重排/转义符/空行变化, 语义零变化 (git diff --ignore-all-space 核查)
    - 含 FEAT-A4-01 收官文档 (提交 40502df 后数分钟内又被外部格式化工具改写, 同模式)
    - 目的: 终止工作区反复出现的格式漂移, 之后再有格式化改动另算
2026-08-31 chore(rules): v2.1 -> v3.0 —— R30 风险分级执行路径固化 + 非红线条目案例压缩
    - 新增 R30(置于R23后): 重/中/轻级流程裁剪, A4-01 实战验证(无返工/12AC一次过),
    含触及 firmware/ 即按重级或偏差登记兜底, 试验档案 FEAT-A4-01 §7
    - 保守压缩: 仅非[MUST]条目(R22/R24)案例叙述压为指针, 红线四条(R26/R27/R28/R29)与
    §2/§6 钩子一字不动
    - 规则完整性核验: R0~R30 + R1.1 共32条零丢号(行首锚定 grep 实证)
    - 早前v3.0草案丢 R22/R13 问题已规避: 编号原位保留, 下游按编号引用不断链
2026-08-31 A4-02 距离实时比对：阶段1-4中期成果（dist模块+峰值口径观测+R27补研+R31）
    - BSP/dist.c/h：欧氏距离16模版最小d_min（平方比较+1次sqrt，复刻官方arm_euclidean_distance_f32标量算法）
    - R27三源证据入dist.c头注释（源码实读/Issue区调研PR#34/坑清单1-9）
    - freertos.c：mel_frame_cb尾挂dist_process（s_mel_ok门控链）+ DMIN d/m双字段打印（1s窗峰值）
    - Makefile登记dist.c；collect_dmin.py采集+CSV存证
    - 阶段4快照口径初测：正常2.05 vs 异常2.87（1.4x未达标）→ 峰值口径待复测AC-02
    - R27补研闭环：ViolaWake PR#34（坑9峰值统计不得搬离回调）+ Edge Impulse/prmon/AdaBEAM（A4-03立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
    [collect_dmin.py, dist.c, dist.h]
2026-08-31 A4-02 距离实时比对：收官（阶段5评审通过+12AC全勾+归档回填）
    - 阶段4实测：金属敲击判别比2.52x达标（AC-02过）；吹气类1.4x不可分已归因归档（宽带噪声与背景同分布，异常类型边界交A4-03）
    - R23独立评审：固件四项零代码缺陷；I-1配对错位归因更正+collect_dmin.py行数防护；I-2状态/记录位/AC复选框回填；M-1~M-5闭环（analyze健壮化/9维更正/69行口径/DMIN钳位+行尾补偿，编译退出0）
    - 数据存证：data/dmin_*.csv x3（正常/吹气/金属，A4-03阈值区间输入，金属轮26%错位行caveat已标）
    - 归档：FEAT-A4-02 12AC全勾+日志6行；父FEAT A4回填收官；INDEX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
    [dmin_anomaly2.csv, dmin_anomaly_metal.csv, dmin_normal2.csv]
2026-08-31 docs: HANDOFF.md 交接文档 A4 中期大更新（新Agent快速上手路径+在途任务快照）
    - 新增§零 10分钟上手路径（rules §0→INDEX→在途快照→维护地图→FEAT→git自检）与红线速记
    - 新增§零点五 A4-03 阶段2停等点精确快照（方案B双轨/TH=6.0/debounce设计要点/挂接链/三源结论指针）
    - 新增§1.3.1 固件音频链路数据流图（A4-02 收官时点）+ 架构铁律
    - 新增§7.1 活跃风险表5条（TRAE缓冲区回写/钩子quotepath bug/R31/模版偏移/A4-02遗留）+ §7.3 提交锚点与证据链入口
    - §2.3.1 scripts 工具链表；§七 待办更新至 A4-03
    - 调研依据（R27 源②）：交接=工作状态转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
2026-08-31 A4-03 连续帧防抖：阶段3编码（debounce状态机+BSP接入+事件打印）
    - 新增 BSP/debounce.c/h：双轨判据状态机（连续30帧|滑窗30/100帧→报警，连续60帧→解除）
    - freertos.c：mel_frame_cb 逐帧喂入 debounce_process，SpecTask 即时打印 ALARM 事件（不走1s节流，坑1预防）
    - Makefile：登记 BSP/debounce.c 防链接失败（BUG-002 教训）
    - 新增 scripts/simulate_debounce.py：PC 端仿真验证
    - FEAT-A4-03-连续帧防抖.md：阶段3 编码回填
    [debounce.c, debounce.h, simulate_debounce.py]
2026-09-01 feat(A4-03): 连续帧防抖收官（阶段5 R23独立评审通过+12AC全勾+归档回填）
    - debounce.h: DB_COUNT_CAP 补 _Static_assert 位宽防御（评审整改）
    - FEAT-A4-03: 阶段5审查日志、AC全勾、§5维护回填、A/B/C对照实证
    - 父FEAT-A4/INDEX/维护地图: A4-03 状态回填
2026-09-01 docs(A4-04): 阶段1/2准备+设计定稿(param.h接口+帧生成脚本+交接文档更新)"
2026-09-02 feat(A4-04 §3 + A5-01 §4): 参数帧实时生效(paramTask) + RS485回环排查落档
    A4-04 阶段3 编码（本会话新增，阶段2后未即时提交，与A5排查同批编入）：
    - 新增 BSP/param.c：逐字节状态机 param_feed_byte + CRC16-Modbus(0x8005/init 0xFFFF/反射/大端) + 坏帧计数 + 最近帧 getter + PARAM_DROP_OR/PARAM_RX_FRAME 语义
    - param.h 接口定稿：param_apply 为编译期符号链接(freertos.c 定义)；越界也更新 last_pid/val
    - debounce.c/h：宏保留为默认值 + debounce_param_t + debounce_get/set_params（getter 返回副本，读/写各包 portENTER/EXIT_CRITICAL 防跨任务撕裂）
    - freertos.c：mel_frame_cb 阈值改读运行期 debo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
2026-09-08 feat(A4-04 §3): 参数可调迁移至 Modbus RTU(FreeModbus 从站), 废弃 0xA5 私有帧
    成熟方案(quanghona/Freemodbus-CMSIS-RTOS2-STM32, R27/R32):
    - portserial.c: RS485 方向宏对齐 PD11 + 修 put_index 收帧 bug + 补事件句柄
    - modbus_app.c/h: 保持寄存器 0x0001~0x0005 读写回调(读快照/写两遍校验)
    - freertos.c: 删 paramTask/RS485LoopTask, 新增 MBSlavePollTask + param_apply 定义
    - stm32f4xx_it.c: USART3_IRQHandler(RXNE/IDLE/TC/ORE), usart.c NVIC 使能
    - Makefile: 收录 FreeModbus 源+头路径, 移除 param.c
    - param.h: 保留 ID/范围宏 + param_apply(校验单一源), 废弃 0xA5 帧接口
    - gen_param_frames.py: 0xA5 帧 -> Modbus RTU 帧(FC03/FC06, c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
2026-09-08 docs(A4-04): 文档表格对齐/下划线转义格式重整(无内容改动)
2026-09-08 feat(A4-04 阶段4工具): gen_param_frames.py 新增 --com 下发并回读应答(验证链路/生效/越界)
2026-09-15 chore(gitignore): 忽略 .ua 知识图谱产物与 __pycache__ 编译缓存
2026-09-17 固件(P2-1 复核修正 + 批次1 审查修复落地)
    P2-1 USART1 写互斥改用 osMutex(复核更正 2026-09-17)
    - 原 taskENTER_CRITICAL 包阻塞式 HAL_UART_Transmit 会屏蔽 SysTick/I2S/USART3/SPI3
    中断:tick 冻结 + I2S DMA 溢出丢帧 + 临界区内 HAL_GetTick 被屏蔽致超时永不成立
    →_write 死循环。改为互斥信号量,只做任务级串行化、不屏蔽任何中断(审查官建议首选)。
    - NULL=boot 期单线程直接发送(不拿锁,避免调度器未启动时的自旋);非 NULL=运行期
    osMutexAcquire/Release 串行化所有走 printf 的 USART1 写。
    - main.c 新增 g_uart1_mutex 声明,创建点在 osKernelInitialize() 后、osKernelStart() 前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
2026-09-17 文档/脚本/规则(RS485 排查 + 复核处置章程 + 批次1 交付文档更新)
    - 新增:docs/SoundDog-复核处置章程-2026-09-17.md(处置基线,P0-P3 + 5 决策门)
    - 新增:docs/bugs/BUG-20260914-001-freemodbus-register-addressing-off-by-one.md(R34)
    - 新增:docs/hardware/硬件配置-2026-09-16.md(R44 硬件台账)
    - 新增:scripts/pc_baseline.py / loopback_test.py / rs485_flood.py / sniff_usart1.py
    gen_param_frames.py 更新
    - 新增:SoundDog-RS485链路排查测试-2026-09-17.md(断点指向 MAX3485 RO 输出侧)
    - 新增:批次1 交付汇总 / 审查核验与修复计划 / 目前进度 三份 2026-09-16 文档
    - 更新:.claude/rules.md / CLAUDE.md / HANDOFF.md / README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
2026-09-19 fix(scripts/ci_local.sh): 修复S1编译失败分支路径错位
    原 set -eu 下, \make -j6 all\ 为 && 列表末命令, 失败即整脚本退出,
    导致 :26-33 故障库检索分支对「编译真正失败」路径不可达(仅 cd/make clean
    失败才触发, 与设计意图相反)。
    审核报告2026-09-19复核更正: 定性为「分支路径错位」非死代码。
    改 if 包裹, make all 失败不再触发 set -e 退出, 继续走检索分支。
    验证: 构造 make 失败 → 打印 REACHED_FAULT_RETRIEVAL: BUILD_OK=1 (R21)
    依据: 审核覆盖台账处置章程-2026-09-19 §2
2026-10-16 feat(A7-02 独立看门狗) + 文档/规则收口(RS485 丝印命名更正)
    固件:
    - 新增 FEAT-A7-02 独立看门狗: BSP/iwdg_drv.c/h + freertos.c 新增 WDTPollTask
    (8 优先级栈 1KB, 惰性启动, 200ms 喂狗 vs IWDG 1s 超时, >30% 余量);
    Makefile 增编译项, HAL_IWDG_MODULE_ENABLED 开启
    - Makefile C_DEFS 增 -DMB_PROBE_ENABLE=1 (临时重开探针用于链路诊断)
    规则 (.claude/rules.md):
    - 补 §7 登记表 R33~R43 (原 R38/R39 全仓无定义被引用)
    - R42 丝印语义按实物照片二次更正: TXD=RO(模块输出)->MCU RX(PD9),
    RXD=DI(模块输入)->MCU TX(PD8); 纠正旧口径双重错误 (无 D 后缀的 TX/RX 拼写 +
    按主控视角命名把 TXD 标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
2026-10-16 docs(README): 状态刷新 — A5 链路已打通 / A6-A7 补录 / 死代码与遗留项更正
    - A5: 联调中 -> 链路已打通(2026-09-21), 写明根因(模块 TTL 侧 TXD/RXD 接反)、
    成功帧与 CRC 复核结论, 并保留 -6.35V / 1.67V 两项未结定性
    - 新增 A6(报警输出, 🔴未开始)/A7(辅助功能, 🟡A7-02 IWDG 代码落地未实测) 两行
    - 技术路线描述改为实际链路: FFT->Mel->MFCC->距离比对->防抖判决
    - 软件环境: 任务数 4 -> 5(新增 wdt)
    - 目录结构: 补 iwdg_drv.c; rs485_drv.c 标注为死代码, 指明在役路径为 portserial.c
    - 已知遗留: 负峰溢出/RS485 回环 st=3 两项转为已修/已解释; 新增 RS485 两项电气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
2026-10-16 docs(README): 按核查更正 4 处 + 修正 A5 状态过强（PC 侧已通 / ESP32 主站侧未通过）
    对 ESP 侧审查官《SoundDog-README核查-2026-10-16》逐条回源复核，4 条全部属实，另自
    查追加第 5 条（性质最重）：
    1. 三行契约第 3 行应为 `I2S DMA started`（非 `[31] max`）—— 据 main.c:224 / freertos.c:449-451
    （该字串为约 11 份 FEAT 的验收判据，勿改）；示例日志同步补该行，并注明 `[31] max` 是数据观察行
    2. `rs485_drv.c` 不是死代码 —— RS485_Init() 在 main.c:275（#if 0 从 :277 才开始）在役，
    RS485_Send() 在 portserial.c:253 探针在役，仅 RS485_Receive() 存于 #if 0 段
    3. A6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
2026-10-16 docs(README): A5 状态按 ESP 侧 10-12 实测收口（断点在网关侧，非 SoundDog 侧）
    SoundDog 侧存档止于 09-29，A5 是否达成须看网关侧；据 ESP 侧检测记录
    检测记录-2026-10-12.md（实读 §四/§六/§七）：
    - 测的是 uart_echo_rs485 官方例程（固件变量已排除）
    - ESP32 发送链正常：CH0(GPIO17) 三次互证有完整 '.' 帧
    - A/B 全程零跳变、发送期 A 高 B 低 ⇒ 反推 DI 恒高
    - ⇒ 断点 = 「模组 RXD 排针 → 芯片 4 脚 DI」（约 2mm 板内/焊点），最可能为反复
    插拔致虚焊；分层中模组板内该段从未验过
    - 该批采集时 RS1 的 A/B 已拔 ⇒ 不构成对从站的指控
    故 README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
2026-10-19 docs(README): 按 10-16 网关侧实测改写 A5，补从站空片事故 INC-20261016-001
    上一版（10-16 13:05）依据网关侧 10-12 数据，判定"断点在网关模组
    RXD 焊盘 -> 芯片 DI 段"。该结论已被同日 16:48 的单变量实测推翻：
    未换件、未焊接、未改固件，只改 TTL 接线即收到 0x2E x 151 / 15.057 s。
    改动：
    - A5 行整体改写：作废旧断点结论；按方向分述
    A->B（主站发->从站收）已通 / B->A（从站发->主站收）未稳定
    （5 轮观测仅 1 轮全对，机理为 RTU 响应无事务号 issue #16
    + 网关侧迟到帧被下一事务吃下）
    - 新增 INC-20261016-001：主 Flash 1MB 被整体擦空（全 0x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
2026-10-19 docs(README): 补"配套仓库"章节，与网关仓库互链并写清耦合点
    上一版只写了本仓库自身状态，没有指向主站侧仓库 —— 而从站脱离主站无法组网，
    读者无从知道"谁能轮询它"。此节补齐，并与 esp32-modbus-gateway 的
    README 保持对称（那边已有指向本仓库的"配套仓库"表）。
    内容：
    - 配套仓库表：esp32-modbus-gateway（ESP32-S3 主站，UART2 16/17/10，
    115200-8N1 半双工，轮询本节点 5 个保持寄存器并发布 MQTT），
    并如实标注其当前状态（A→B 已通 / B→A 未稳定 / 修复版未烧录）
    - 两侧分工边界：本仓库负责声学链路与寄存器暴露；主站负责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
2026-10-28 build: 手写源码/头文件路径/编译宏迁入 sources.mk，Makefile 仅保留 include
    原因：Makefile 由 CubeMX 生成，重新 GENERATE CODE 会整体重写 C_SOURCES / C_INCLUDES / C_DEFS，且无 USER CODE 保护区。
    本次把约 40 个手写 .c（BSP/、App/modbus_app.c、FreeModbus 全套、oled/i2c 等）与 -DARM_MATH_CM4F 从 Makefile 移到 sources.mk，Makefile:165 只留 include sources.mk。新增手写文件今后只改 sources.mk。
2026-10-28 feat(modbus): 保持寄存器 5 扩到 9（SHT30 温湿度 + 振动只读项），采集任务暂禁用
    modbus_app.h: MODBUS_REG_HOLDING_NUM 5u -> 9u。modbus_app.c: 0x0005..0x0008 四个只读遥测量（温度 x10+500 偏移、湿度 x10、振动 RMS、振动峰值）。这四个偏移在 reg_off_to_pid() 落 default 返回 0xFF，写操作由 MB_ENOREG 天然拒绝，无需额外只读代码。
    BSP/sht30.c/.h: I2C3(PA8/PC9) SHT30 驱动。freertos.c: 新增 sht30 任务（2KB 栈，BelowNormal）。
    注意：sht30Task 的 osThreadNew 仍被注释禁用 —— 2026-10-25 实测启用后从站进入复位循环（OLED 反复播开机动画、红灯不亮），根因未定（疑 HAL_I2C_In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
2026-10-28 docs: 两侧统一 RS485 模块后更正丝印接法（R42 / 硬件配置 / README）
    2026-10-25 起从站 RS1 换成与网关 RS2 同款模块，两侧 TTL 接线由"从站交叉 + 网关直连"统一为"两侧直连"（TX->TXD、RX->RXD）。
    R42 语义升级：丝印 TXD/RXD 只说明"这是模块的哪个脚"，不说明该接 MCU 哪根线——接法取决于模块厂家约定，已实证两种相反约定。禁止凭丝印推断方向，换模块后必须重新逐脚实测。
2026-10-28 fix(modbus): 物理删除 RX 回环/打印/翻灯三处探针与 MB_PROBE_ENABLE 开关
    【R19 豁免登记】本提交跨 Middlewares/ 保护区，经用户明确授权使用 --no-verify，理由与影响面如下：
    1) 性质：文件位于 FreeModbus/port/cmsis_rtos2/，属 port 适配层，不是协议栈核心——modbus/mb.c、rtu/mbrtu.c、rtu/mbcrc.c、functions/* 本次均未改动。
    2) 方向：本次是【删除】此前临时加入的探针，向厂商原版收敛，不引入新的分歧（+36 / -60，净减 24 行）。
    3) 必要性：探针把收到的合法请求原样 RS485_Send 回总线，主站先把这份回显当应答吃下 -> ESP_ERR_INVALID_RESPONSE(0x108)，随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
2026-10-29 fix(rtos): 启用 sht30 任务并扩容堆 15360->24576，解决启动复位循环
    根因（2026-10-29 实测，非原注释推测的 I2C/栈深问题）：启用 sht30 后每次启动都打印 [FATAL] FreeRTOS heap allocation FAILED（rtos_hooks.c:38 vApplicationMallocFailedHook 关中断死循环 -> IWDG 约 1 s 复位），25 秒内抓到 8 次启动横幅，周期约 3 s。
    账目：6 个任务栈请求 = default 512 + spec 2048 + display 4096 + mbSlave 1024 + wdt 1024 + sht30 2048 = 10752 B，再加 6 组 TCB/heap_4 块头约 600 B，以及 FreeModbus 的 osEventFlags/osTimer 与音频帧队列，15360 B 不够用。sht30 是最后一个创建的任务，因此它失败。
    处置：co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
2026-10-29 docs(rtos): 在 configTOTAL_HEAP_SIZE 处写清堆账、失败点与唯一扩容来源
    把 2026-10-29 的实测结论落在'以后调堆第一个会看的位置'，避免下一个人重犯同样的错：
    1) 触发条件澄清：vApplicationMallocFailedHook 只表示 pvPortMalloc 找不到够大的空闲块（池子用完），不代表堆被写坏。实测占用 15960 B / 原池 15360 B，缺口仅 600 B。
    2) 任务栈清单更正为 7 项，补上容易被漏算的 mbRxRecv 1024 B —— 它不在 MX_FREERTOS_Init 里，而是由 eMBInit → portserial.c:77 创建。其余 4184 B 为 TCB/音频队列/事件组/定时器/块头。
    3) 真实失败点：不是任务创建，是运行期 eM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
2026-10-29 docs(rtos): 更正 _Min_Heap_Size 语义——它是堆+栈的静态预算，不是 malloc 的 48 KB
    上一版（b27f49e）写「_Min_Heap_Size 是给 newlib malloc 的 49152 B，降到 0x400 可回收约 47 KB 并入堆池」，这个说法是错的，两处都不准：
    ① 该段（STM32F407XX_FLASH.ld:203-213）只做 `. = . + _Min_Heap_Size`，无 CONTENTS ⇒ 不占任何字节，objdump 显示其文件偏移与 .bss 相同；不是'划给 malloc 的内存'。
    ② 它也不是 malloc 的天花板：Sysmem.c:56 的 _sbrk 用 _estack - _Min_Stack_Size = 0x2001F000 作上界，malloc 实际可用约 71 KB（0x2001F000-0x2000D430）。
    ③ 真实作用：给'堆+栈'设静态预算，链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
2026-10-29 docs(rtos): 更正'零 malloc'——stdio 实际用过一次 1032 B，_Min_Heap_Size 不可降到 1024
    上一版（80e8bb5）断言本工程'从未动用 newlib 堆'，依据是代码零调用 + _isatty 返回 1 ⇒ stdout 行缓冲走 _nbuf。SWD 实测推翻了这个结论：
    ① __sbrk_heap_end(0x20008164) = 0x2000D838，而 _end = 0x2000D430 ⇒ 堆已长 0x408 = 1032 B，正好是 malloc(1024)+8 B 管理头；
    ② 间隔 25 s 连续 printf 复测，该值不变 ⇒ 一次性分配，稳态不再增长（'不会持续增长'这个结论仍成立，'一次都没用'不成立）；
    ③ 调用者未逐行定位：makebuf 引用 _malloc_r、nano-svfprintf 引用 _realloc_r，两者都在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
2026-10-29 fix(rtos): 堆池 24576->32768 为 MPU6050 预留；补 BUG-20261029-001 与索引
    扩容：configTOTAL_HEAP_SIZE 24576 -> 32768（+8192）。.bss 54060->62252，_ebss 0x2000D430->0x2000F430，到 _estack 余 15312 B，链接通过且不动 .ld。
    动因：当前占用 15960 B（65%），上 MPU6050 需再加约 2 KB 栈 + TCB，余量会掉到 26%（低于 30% 警戒线）。扩后余 16808 B（51%）。
    实测：SWD 读 xFreeBytesRemaining = xMinimumEverFreeBytesRemaining = 0x41A8 = 16808 B，与 32768-15960 完全吻合；烧录后 12 s 抓取 8419 B、0 次启动横幅、0 次 FATAL。
    文档：新增 docs/bugs/BUG-20261029-001-freertos-heap-exhausted-reset-loop.md（现象/复现/证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
2026-10-29 docs(rtos): 同步堆扩容后的地址与实测值（_end 0x2000F430、__sbrk_heap_end 0x2000F838）
    4cb22f0 改了宏与多数数字，但注释里两处绝对地址仍是 24576 时代的旧值，本轮补齐：
    ① _end 由 0x2000D430 上移到 0x2000F430（.bss 54060->62252）；
    ② __sbrk_heap_end 由 0x2000D838 变为 0x2000F838（SWD 实测，地址 0x2000A164）。
    ⭐ 关键旁证：差值仍是 0x408 = 1032 B，与扩容前完全一致 ⇒ stdio 那次缓冲分配是固定大小，与堆容量无关，'一次性'结论进一步坐实。
    仅改注释：重编 EXIT=0，hex 哈希 b536164c 与烧录版一致，无需重烧。
2026-11-01 docs(feat): 出 FEAT-A7-04 MPU6050 振动监测计划书（三源已核，含 5 处旧规格冲突裁决）
    三源：①芯路城资料页 id=222 → 「串口6轴加速度计陀螺MPU6050模块文档卡尔曼.zip」，本地解压于 桌面\stm32F407ZGT6\MPU6050模块资料\MPU6050资料V5\（说明书V5 11页 + Datasheet + 示例核心代码 + PCB库）；②旧规格 + 从站代码现状；③MPU6050 芯片 datasheet（仅旁证）。
    发现旧规格 5 处与现状不符，逐条裁决：D-1 寄存器应为 7/8（5/6 已被 SHT30 占），协议层零改动；D-2 走 USART2(PD6/PD5) 而非代码注释里的 I2C2；D-3 串口版固定 ±16g（旧规格 §4.2 的 ±2g/16384 只适用 I2C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
2026-11-01 docs(feat): FEAT-A7-04 方案变更——实物为 GY-521(8脚)，串口方案作废改 I2C1 共用+互斥锁
    变更原因：用户核对实物为 8 脚 VCC/GND/SCL/SDA/XDA/XCL/AD0/INT = GY-521（纯 I2C）。v1 依据芯路城资料包名「串口6轴…zip」判定为串口模块，属误判——资料包名只能证明厂商卖过该款，不能证明用户手里是哪款。
    新方案（A 方案修订）：I2C1 共用（PB6/PB7，与 OLED 同总线，地址 0x68 / AD0→GND），VCC 统一 3.3V。
    ⭐ 关键依据：实测 oled_drv.c:49-59 的 oled_update_screen() 是「每页一次独立 HAL_I2C_Mem_Write」（3 条命令 + 128B 数据 ≈ 2.9 ms，8 页共 ≈24 ms / 200 ms 周期）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
2026-11-01 docs(feat): FEAT-A7-04 再变更——PF0/PF1 已引出，改用 I2C2 独立总线，取消互斥锁与 oled_drv 改动
    用户确认 PF0/PF1 已引到排针；GPIO_AF4_I2C2 存在（stm32f4xx_hal_gpio_ex.h:84）；gpio.c:96 显示这两脚原为 ANALOG 未被占用；FMC 业务代码未使用。
    改法：MPU6050 接 PF1=SCL / PF0=SDA（AF4 开漏），自建 I2C2 初始化（照 sht30.c 自建 I2C3 的样板）。
    收益：①不需要互斥锁（hi2c2 唯一使用者是 vib_task）②BSP/oled_drv.c 一行不改 ③OLED 刷新与 MPU 采样硬件并行，总线竞争从'要测的验收项'变成'结构上不存在' ④采样率可自由提高。
    回退预案保留：若 PF0/PF1 实测不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
2026-11-01 docs(feat): 出 FEAT-A7-05 多源判据同构化与融合计划书（三源核对，纠正温度判据设计错误）
    背景：毕设要求三个功能模块，但现状三通道不同构——声学有完整判据（th/alarm_cnt/release_cnt/win_anom 四个参数）、振动未实现、温度只有数据无判据（实测 g_temp_x10 仅被 sht30.c:195 写入、modbus_app.c:108 读出上报，无任何阈值判断）。
    三源核对 7 项，逐条给依据：V-1/V-2 加速度须频域积分(FFT→÷2πf→IFFT)成速度 RMS、高通 10Hz、频带 10~1000Hz（ISO 20816 及多源一致）；V-3 速度谱测不到轴承故障（500Hz~10kHz 被 1/ω 压低，须加速度包络）；V-4 温度判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
2026-11-05 feat(eval): EVAL 旁挂输出（含残差比字段）与离线评测/门控/残差脚本
2026-11-05 docs(feat): 出 FEAT-A7-06（静/动基线、残差级联、三源核对）并同步索引与漂移修复
2026-11-05 chore(data): 评测日志只保留两份 1 h 证据段，其余过程日志移出跟踪
2026-11-05 docs(readme): 同步 2026-11-05 评测基线并修正漂移行号
2026-11-05 docs(readme): 总线侧状态回填 10-27/10-29 实测；纠正'灯闪判死活'已失效的验收法
    从站 README 的音频侧（11-05 评测基线）是最新的，但总线侧与三条遗留仍停在 10-16，其中一处会直接误导排查。
    ① A5 行与遗留条：原写「B→A 未稳定（5 轮仅 1 轮全对）」——10-27 已闭环（232 轮全对：80.2s/74 + 19.3s/20 + 86.3s/79），10-29 扩 9 寄存器后再跑 4,842 轮 / 83.4 min 零错误。状态改 🟢，原 10-16 叙事降为历史记录保留。
    ② 「从站运行状态自 10-16 后未复核」→ 已复核：10-27 连续 232 轮应答正常；10-29 SWD 读到 s_present=1、吹气温湿度变化（24.1→29.9℃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
2026-11-05 docs(readme): 目录结构补齐——RS485_Send/Receive 已无在用调用者，portserial 无探针开关
    探针 10-27 物理删除后，目录结构里两处描述仍按'探针存在'写：
    ① rs485_drv.c：原写「RS485_Send() 被 portserial.c:253 回环探针调用（随探针一并移除）」——表述含糊，实际 RS485_Send/Receive 全仓仅剩 main.c:277-295 的 #if 0 段，无在用调用者。
    ② portserial.c：原写「RX 帧缓冲/回环探针，受 MB_PROBE_ENABLE 开关」——该宏已不存在（全仓 grep PROBE 为 0），改为「RX 帧缓冲 + 收发状态机；回环探针已于 2026-10-27 物理删除」。
    核实：grep RS485_Send 仅 main.c:285-288（#if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
2026-11-06 chore(probe): 删除 USART3 RXNE 中断里被注释掉的 PB1 翻转探针（只禁用未删除，违反 R-探针铁律）
    位置：firmware/soundDog/Src/stm32f4xx_it.c:236-238（原）。
    原状：三行说明注释 + 一行被 // 注释掉的 HAL_GPIO_TogglePin(GPIOB, GPIO_PIN_1)，尾注写着「验证后注释，保留历史痕迹」。
    为什么必须删：用户既定铁律——「测试遗留必须物理删除，⛔ 不是宏改 0；交付物中不允许『只禁用、未删除』的探针」，且「LED 翻转」属明确列举的探针类别。注释掉 = 只禁用。
    改法：删掉那行死码，注释压成一行，保留『此处为什么没有代码』的信息（2026-09-14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
2026-11-06 chore(probe): 删除 main.c 的 #if 0 回环自测死代码；机理已在 BUG-20260902-001 内
    位置：firmware/soundDog/App/main.c:277-295（原）。该 19 行块是 RS485 自发自收测试，用 #if 0 封存——属「只禁用未删除」，与刚删的 PB1 探针同一类问题。
    删前先核实知识不丢：BUG-20260902-001 已完整记录双根因（① 预调度器期 BASEPRI=0x50 → SysTick 被屏蔽 → HAL_GetTick 冻结 → HAL_UART_Receive 超时失效而死锁，与 BUG-20260829-006 同根；② 单 EN 半双工不可自发自收，含 GDB 证据链）。
    改法：删死代码，保留 6 行警告注释（⛔ 不要搬回这里 + 机理一句话 + 指向 bug 文档）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
